pascallanger/DIY-Multiprotocol-TX-Module/BootLoaders/README.md

## Page Moved
Moved to [/docs/Arduino_IDE_Boards.md](/docs/Arduino_IDE_Boards.md).
