pascallanger/DIY-Multiprotocol-TX-Module/BootLoaders/StmMultiUSB/README.md

[Source for the StmMultiUSB=STM32duino-bootloader](https://github.com/rogerclarkmelbourne/STM32duino-bootloader)
If you want the latest version, you should look for the file generic_boot20_pa1.bin.
