pascallanger/DIY-Multiprotocol-TX-Module/docs/Module_BG_4-in-1.md

# 4-in-1 module
Currently the form factor of this module is designed for the JR-style module bay. Many of the popular RC transmitters use the JR-style module bay: FrSky Taranis, FlySky Th9x, Turnigy 9X/R/Pro
## What you need
A fully assembled module + case available from Banggood.com [here](http://www.banggood.com/CC2500-NRF24L01-A7105-CYRF693-4-In-1-RF-Module-With-Case-For-Futaba-JR-Frsky-Transmitter-p-1116892.html)

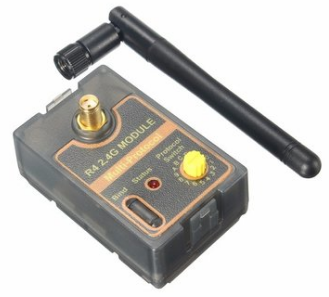
[picture p76: docs/images/4-in-1_Module_Case_BG.jpeg]
 

Or

The ready-made module available [here](http://www.banggood.com/2_4G-CC2500-A7105-Flysky-Frsky-Devo-DSM2-Multiprotocol-TX-Module-With-Antenna-p-1048377.html) or [here](http://www.gearbest.com/multi-rotor-parts/pp_554427.html)


 
Plus a module case that fits your module like the one [here](https://www.xtremepowersystems.net/proddetail.php?prod=XPS-J1CASE)  
   
  or you can 3D print your own from a selection on Thingiverse ([Example 1](http://www.thingiverse.com/thing:1852868) [Example 2](http://www.thingiverse.com/thing:1661833)).  
 [ ](http://www.thingiverse.com/thing:1852868)

For 9XR/9XR Pro, a new 3D printed module is available which makes use of the built in antenna in the handle. This means nothing is getting out of the radio back! You can find all details of this module case on [Thingiverse](http://www.thingiverse.com/thing:2050717).

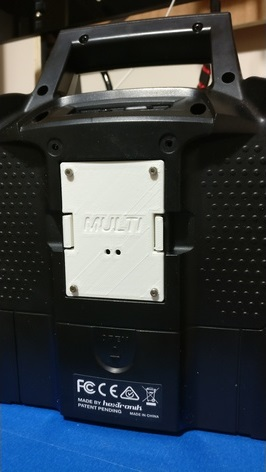
[picture p77: docs/images/9XR_module.jpg]
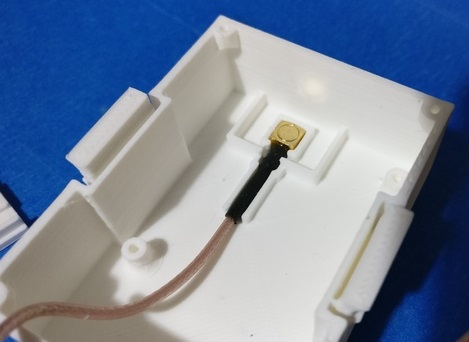
[picture p78: docs/images/9XR_module_connector.jpg]
  

## Different working modes

### PPM mode
If you are only planning on using the PPM interface with your transmitter, you need to connect it as described:



Some radios have an open collector output (Futaba, Graupner...), in this case you should add a 4.7K resistor between PPM and BATT.

The same plug is available on all versions of the module with the same signal locations.

If you wish to add an external device reading the telemetry, you need to enable serial mode as explained in the next topics otherwise you are now ready to go over to [Compiling and Programming](Compiling.md).

### Serial mode
If you have a transmitter that can support serial communication with the board then you need to wire up the board appropriately. There are three versions of the module and the steps are slightly different.

Check which module you have and based on the pictures below.  If you purchased the module after June 2016 then it is likely that you have a V1.1 type module. If you have purchased the version with case it is likely that you have a V1.2 type module.

#### **Version 1.2 (V1.2) type modules** 

Serial is already enabled and ready to be used.
 
Written on PCB back JRFM_V1.2

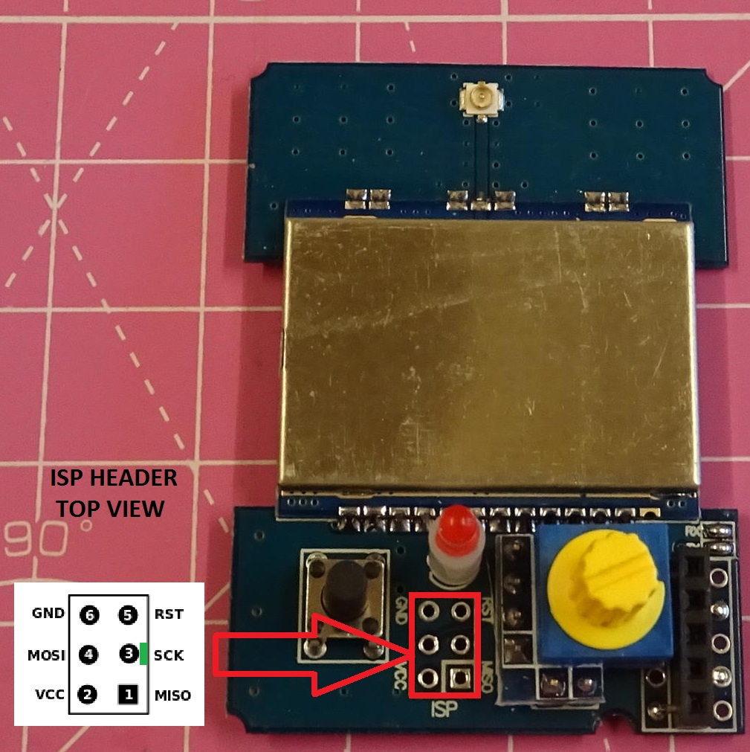
[picture p79: docs/images/v1.2_ISP.jpg]
 

You are now ready to go over to [Compiling and Programming](Compiling.md).

#### **Version 1.1 (V1.1) type modules** 

Solder two bridges over the pads shown in the pictures below. 
 
V1.1a

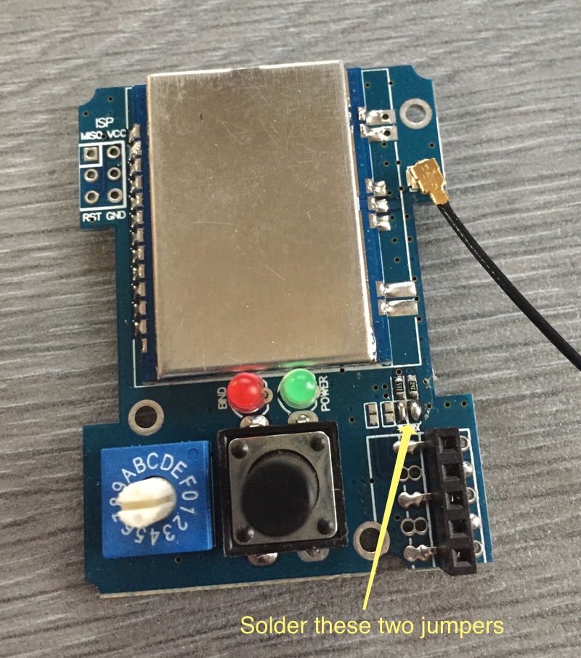
[picture p80: docs/images/V2a_Serial_Enable.jpeg]
 
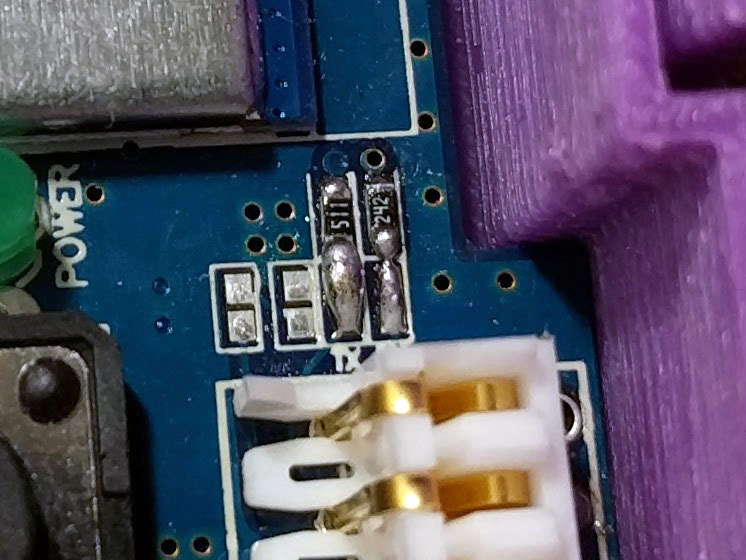
[picture p81: docs/images/V2a_zoom_Serial_Enable.jpeg]
 

V1.1b

Written on PCB back 1.2

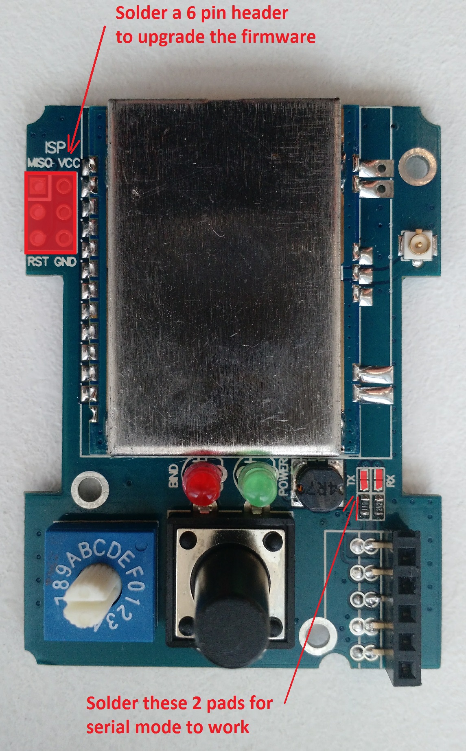
[picture p82: docs/images/V2b_Serial_Enable.jpeg]
 

V1.1c

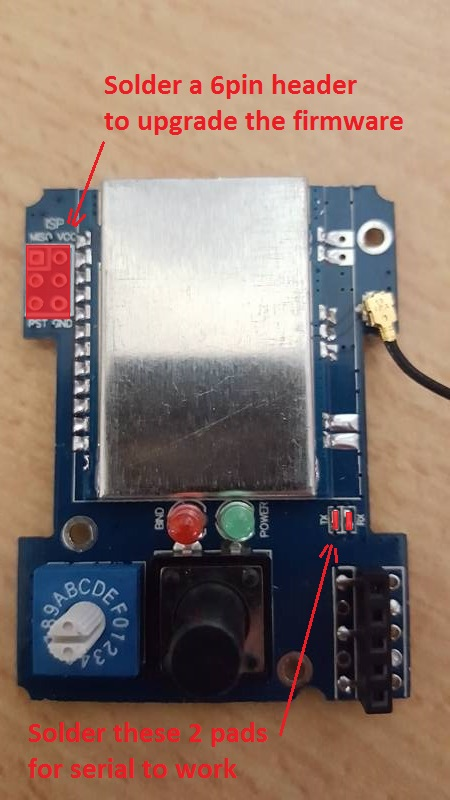
[picture p83: docs/images/V2c_Serial_Enable.jpeg]
 

You are now ready to go over to [Compiling and Programming](Compiling.md).

#### **Version 1.0 (V1.0) module**

Solder bridges and resistors as illustrated in the picture below.

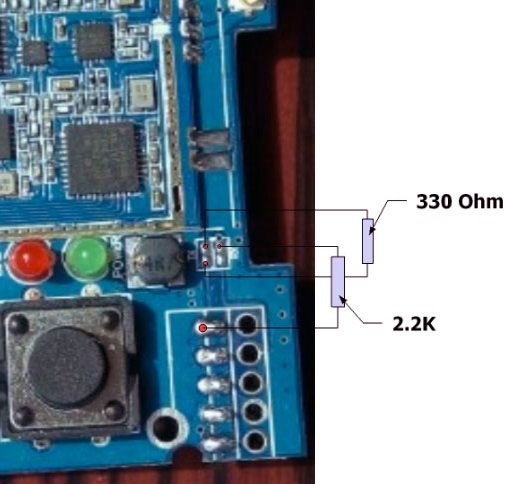
[picture p84: docs/images/V1_Serial_Enable.jpeg]
 

If your module is always/sometime binding at power up without pressing the button replace the BIND led resistor (on the board back) of 1.2K by a 4.7K. Just to be safe it is recommended to do the modification anyway.

It's known that the A7105 of this version is not able to receive telemetry. The only protocol affected so far is AFHDS2A.

You are now ready to go over to [Compiling and Programming](Compiling.md).
