pascallanger/DIY-Multiprotocol-TX-Module/Lua_scripts/README.md

# Multiprotocol TX Module OpenTX LUA scripts


If you like this project and want to support further development please consider making a [donation](../docs/Donations.md).  

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

## MultiConfig

Enables to modify on a Multi module the Global ID, Cyrf ID or format the EEPROM.

Matching the ID of 2 Multi modules enable them to control the same receivers without rebinding. Be carefull the 2 modules should not be used at the same time unless you know what you are doing.

Notes:
- Supported from Multi v1.3.2.85 or above and OpenTX 2.3.12 or above
- The Multi module to be configured must be active, if there is a second Multi module in the radio it must be off
- Located on the radio SD card under \SCRIPTS\TOOLS

MultiCconfig (https://www.youtube.com/watch?v=lGyCV2kpqHU)

## MultiChannelsUpdater

Automatically name the channels based on the loaded Multi protocol and sub protocol including the module channel order convention.

Need OpenTX 2.3.9 or above. Located on the radio SD card under \SCRIPTS\TOOLS. This script needs MultiChan.txt to be present in the same folder.

MultiChannelsUpdater (https://www.youtube.com/watch?v=L58ayXuewyA)

## MultiLOLI

Script to set the channels function (switch, servo, pwm, ppm, sbus) on a [LOLI RX](https://github.com/pascallanger/DIY-Multiprotocol-TX-Module/blob/master/Protocols_Details.md#loli---82)

MultiLOLIconfig (https://www.youtube.com/watch?v=e698pQxfv-A)

## Graupner HoTT

Enable text configuration of the HoTT RX and sensors: Vario, GPS, ESC, GAM and EAM.

Need OpenTX 2.3.9 or above. Located on the radio SD card under \SCRIPTS\TOOLS.

Notes:
- Menu/MDL/Model is used to cycle through the detected sensors.
- It's normal to lose the telemetry feed while using the text mode configuration. Telemetry will resume properly if the script is exited by doing a short press on the exit button.

Text mode video (https://www.youtube.com/watch?v=81wd8NlF3Qw)

## Graupner HoTT Model Locator

This is the Graupner HoTT adapted version of the Model Locator script using RSSI.

The OpenTX sensor "RSSI" is populated by the individual OpenTX telemetry protocol implementations and returns a value from 0..100 (percent) originating from the early FrSky implementation. It turns out that FrSky did not really provide a genuine signal strength indicator in units of dbm but a link quality indicator in 0..100%. With Graupner HoTT the link quality indicator is not a good basis for the model locator as it is very non-linear and doesn't change much with distance. Using the Graupner HoTT telemetry sensor "Rssi" which is a true signal strength indicator serves the purpose of locating a model much better as it varies much more with distance.

## DSM Tools for EdgeTX and OpenTx

Collection of EdgeTx/OpenTX Tools to use with Spektrum Receivers including forward programming. Extract the color or black&white zip version at the root of your SD card.

Frank is maintaining these awesome tools, check out his [repository](https://github.com/frankiearzu/DSMTools). Feel free to ask questions or open issues there.

## DSM PID Flight log gain parameters for Blade micros

Lua telemetry script from [feathering on RCGroups](https://www.rcgroups.com/forums/showpost.php?p=46033341&postcount=20728) to facilitate setting the Gain Parameters on the Blade 150S FBL. It doesn't use Forward Programming but instead it just reads telemetry data from the Multi-module and displays it on a telemetry display.

It is very similar to the Telemetry Based Text Generator functionality on Spektrum transmitters where one doesn't need to rely on the angle of the swashplate to determine selection/value.
