pascallanger/DIY-Multiprotocol-TX-Module/docs/Donations.md

# Donations


The Multiprotocol firmware is provided for free under the [GNU General Public License v3.0](https://github.com/pascallanger/DIY-Multiprotocol-TX-Module/blob/master/LICENSE).  The developers do not receive any payment from any of the manufacturers of Mulitprotocol Modules which use this firmware.

If you like this project and enjoy using it, please consider making a donation.  Donations are used to fund test hardware to develop and integrate more models.

Donations to the Multiprotocol project can be made via PayPal.  Just click on a value, or click 'Other' to set your own amount.

Every donation helps and is greatly appreciated, no matter the amount!

<div align=center>
<table cellspacing=0>
  <tr>
    <td align=center width=200><a href="https://www.paypal.com/cgi-bin/webscr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">Donate €5 PayPal - Donate €5</a><br><b>€5</b></td>
    <td align=center width=200><a href="https://www.paypal.com/cgi-bin/webscr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">Donate €10 PayPal - Donate €10</a><br><b>€10</b></td>
    <td align=center width=200><a href="https://www.paypal.com/cgi-bin/webscr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">Donate €10 PayPal - Donate €15</a><br><b>€15</b></td>
    <td align=center width=200><a href="https://www.paypal.com/cgi-bin/webscr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">Donate €25 PayPal - Donate €25</a><br><b>€25</b></td>
    <td align=center width=200><a href="https://www.paypal.com/cgi-bin/webscr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">Donate PayPal - Donate</a><br><b>Other</b></td>
  </tr>
</table>
</div>

### Donate in other currencies
<details>
  <summary><b>US Dollars</b></summary>
<div align=center>
<br>
<table cellspacing=0 cellpadding=0>
  <tr>
    <td align=center width=200><a href="https://www.paypal.com/cgi-bin/webscr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">Donate $5 PayPal - Donate $5</a><br><b>$5</b></td>
    <td align=center width=200><a href="https://www.paypal.com/cgi-bin/webscr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">Donate $10 PayPal - Donate $10</a><br><b>$10</b></td>
    <td align=center width=200><a href="https://www.paypal.com/cgi-bin/webscr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">Donate $15 PayPal - Donate $15</a><br><b>$15</b></td>
    <td align=center width=200><a href="https://www.paypal.com/cgi-bin/webscr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">Donate $25 PayPal - Donate $25</a><br><b>$25</b></td>
    <td align=center width=200><a href="https://www.paypal.com/cgi-bin/webscr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">Donate PayPal - Donate</a><br><b>Other</b></td>
  </tr>
</table>
</div>
</details>
<details>
  <summary><b>GB Pounds</b></summary>
<div align=center>
  <br>
<table cellspacing=0>
  <tr>
    <td align=center width=200><a href="https://www.paypal.com/cgi-bin/webscr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">Donate £5 PayPal - Donate £5</a><br><b>£5</b></td>
    <td align=center width=200><a href="https://www.paypal.com/cgi-bin/webscr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">Donate £10 PayPal - Donate £10</a><br><b>£10</b></td>
    <td align=center width=200><a href="https://www.paypal.com/cgi-bin/webscr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">Donate £10 PayPal - Donate £15</a><br><b>£15</b></td>
    <td align=center width=200><a href="https://www.paypal.com/cgi-bin/webscr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">Donate £25 PayPal - Donate £25</a><br><b>£25</b></td>
    <td align=center width=200><a href="https://www.paypal.com/cgi-bin/webscr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">Donate PayPal - Donate</a><br><b>Other</b></td>
  </tr>
</table>
</div>
</details>
<br>
Thank you for your support!
