pascallanger/DIY-Multiprotocol-TX-Module/docs/DIY Multiprotocol Module Overview.png

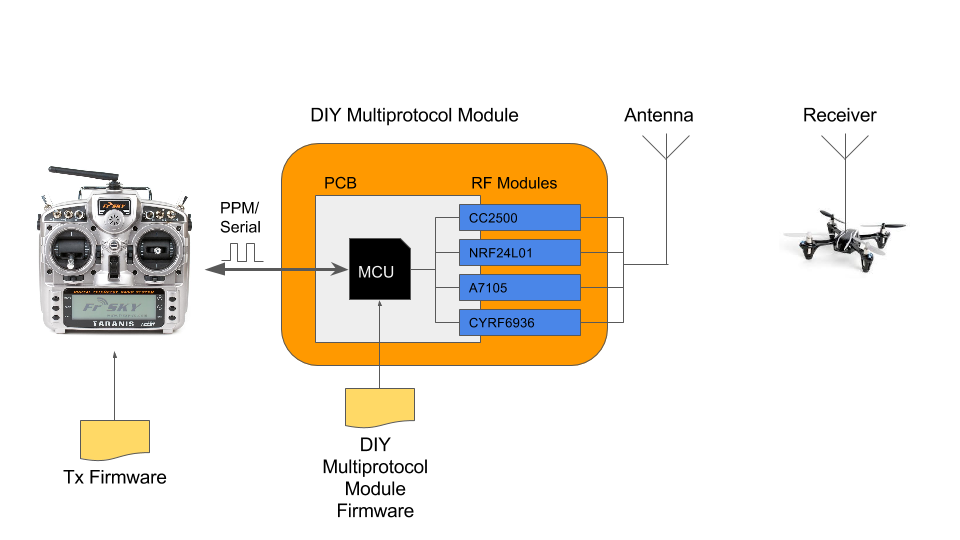
docs/DIY Multiprotocol Module Overview.png
