pascallanger/DIY-Multiprotocol-TX-Module/docs/images/4-in-1_Module_BG.png

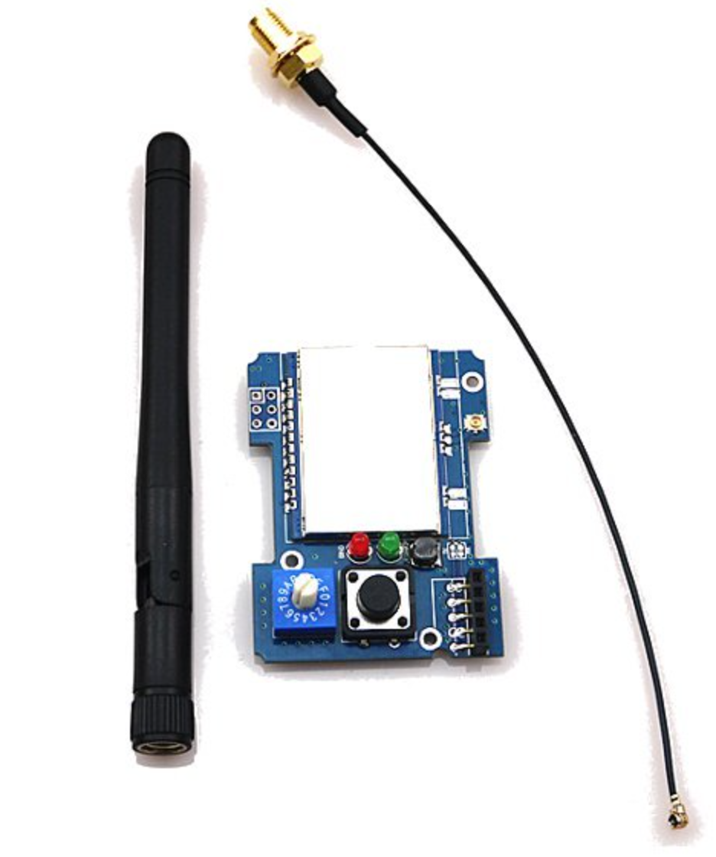
docs/images/4-in-1_Module_BG.png
