pascallanger/DIY-Multiprotocol-TX-Module/docs/images/4-in-1_Module_PPM_Controls.jpg

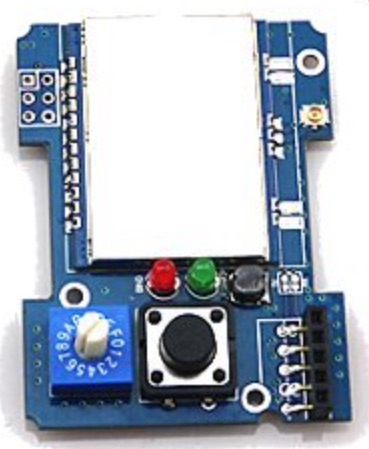
docs/images/4-in-1_Module_PPM_Controls.jpg
