pascallanger/DIY-Multiprotocol-TX-Module/docs/images/FTDI_Adapter.jpeg

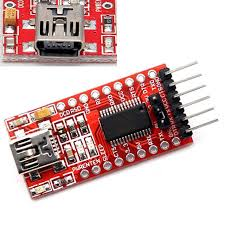
docs/images/FTDI_Adapter.jpeg
