pascallanger/DIY-Multiprotocol-TX-Module/docs/images/FTDI_Cable.jpeg

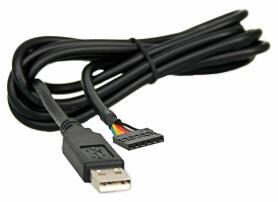
docs/images/FTDI_Cable.jpeg
