pascallanger/DIY-Multiprotocol-TX-Module/docs/images/ISP_header.png

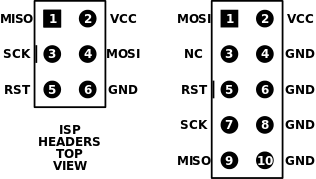
docs/images/ISP_header.png
