pascallanger/DIY-Multiprotocol-TX-Module/docs/images/maple-dfu.jpg

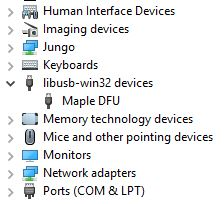
docs/images/maple-dfu.jpg
