pascallanger/DIY-Multiprotocol-TX-Module/docs/images/maple-serial-port-select.jpg

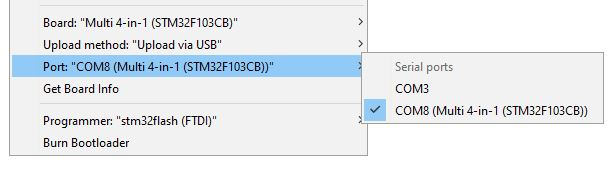
docs/images/maple-serial-port-select.jpg
