pascallanger/DIY-Multiprotocol-TX-Module/docs/images/maple-serial.jpg

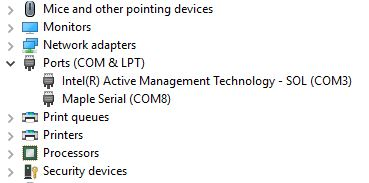
docs/images/maple-serial.jpg
