pascallanger/DIY-Multiprotocol-TX-Module/docs/images/Module_perfboard1.jpeg

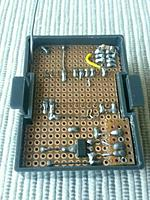
docs/images/Module_perfboard1.jpeg
