pascallanger/DIY-Multiprotocol-TX-Module/docs/images/Multi_STM32 module.JPG

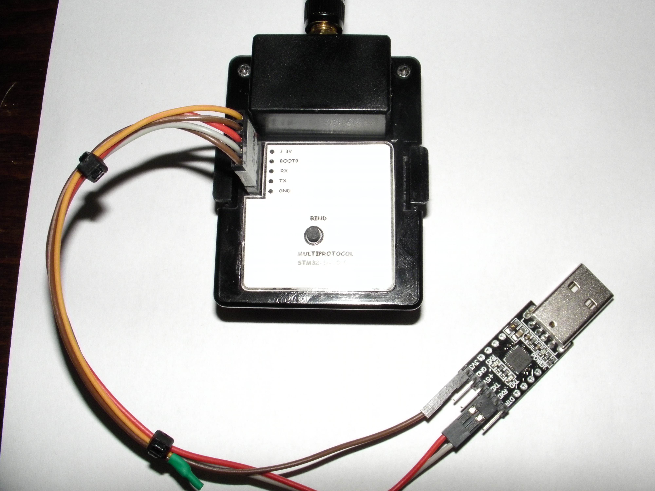
docs/images/Multi_STM32 module.JPG
