pascallanger/DIY-Multiprotocol-TX-Module/docs/images/Multi_STM32_ flashing.jpg

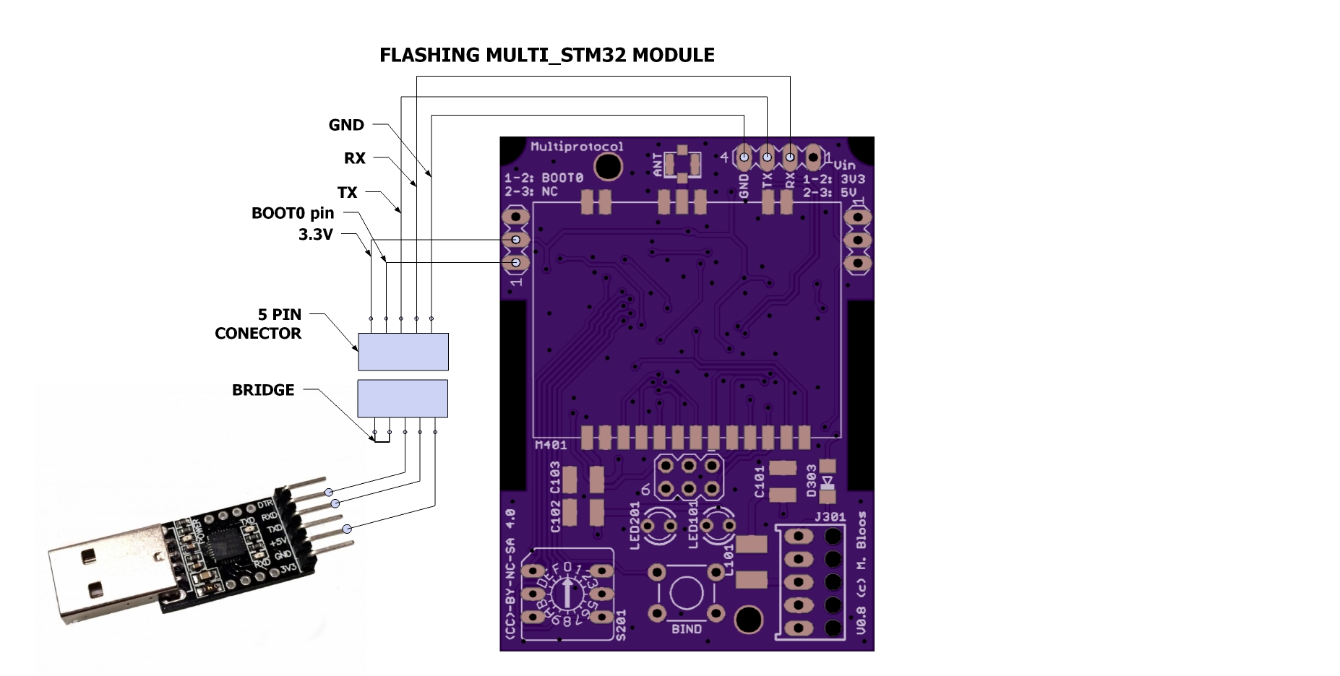
docs/images/Multi_STM32_ flashing.jpg
