pascallanger/DIY-Multiprotocol-TX-Module/docs/images/Multiprotocol_3.2.jpeg

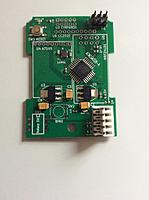
docs/images/Multiprotocol_3.2.jpeg
