pascallanger/DIY-Multiprotocol-TX-Module/docs/images/OrangeRx_Module.jpg

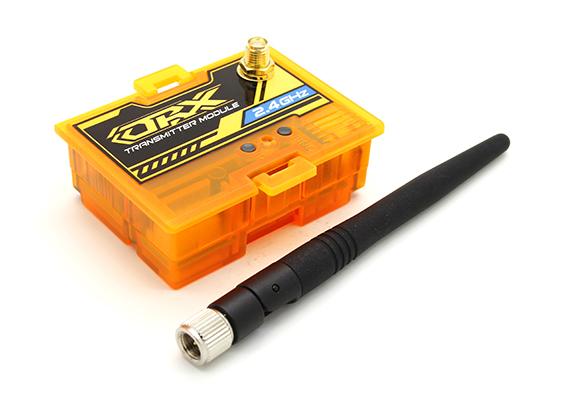
docs/images/OrangeRx_Module.jpg
