pascallanger/DIY-Multiprotocol-TX-Module/docs/images/STM32_Board_V1.0_Jumper.png

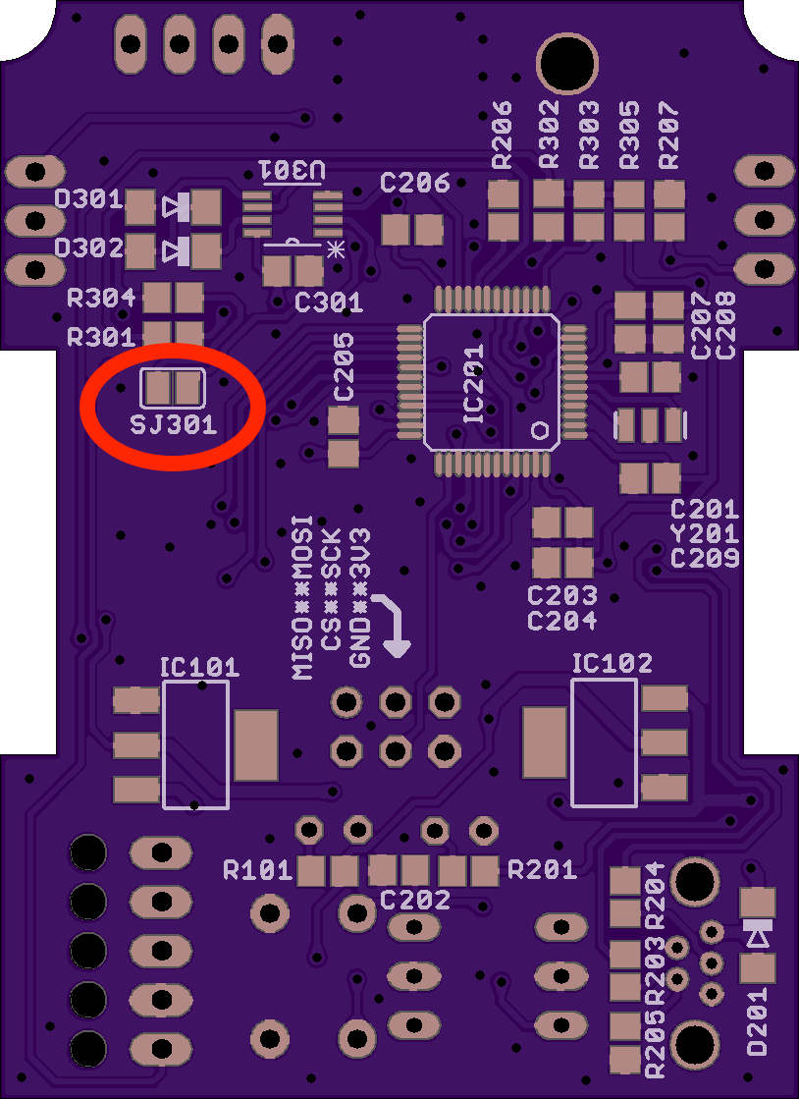
docs/images/STM32_Board_V1.0_Jumper.png
