pascallanger/DIY-Multiprotocol-TX-Module/docs/images/v1.2.jpg

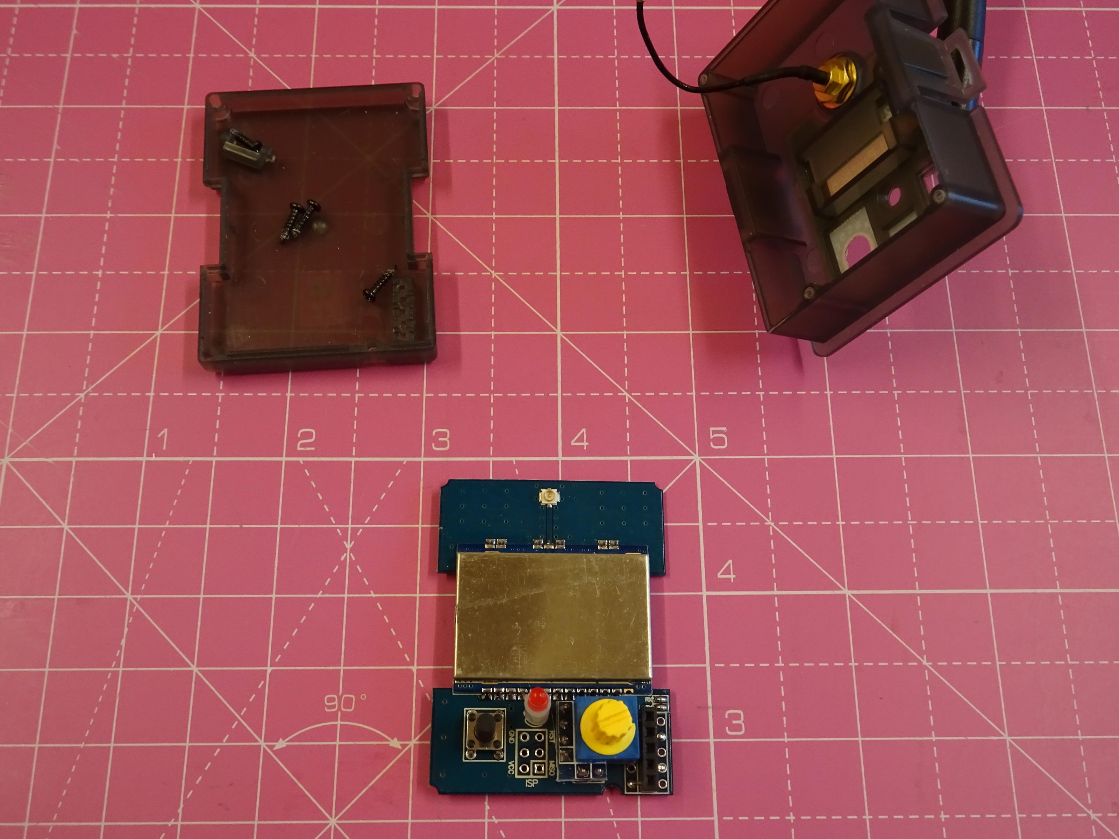
docs/images/v1.2.jpg
