pascallanger/DIY-Multiprotocol-TX-Module/docs/images/warning.png

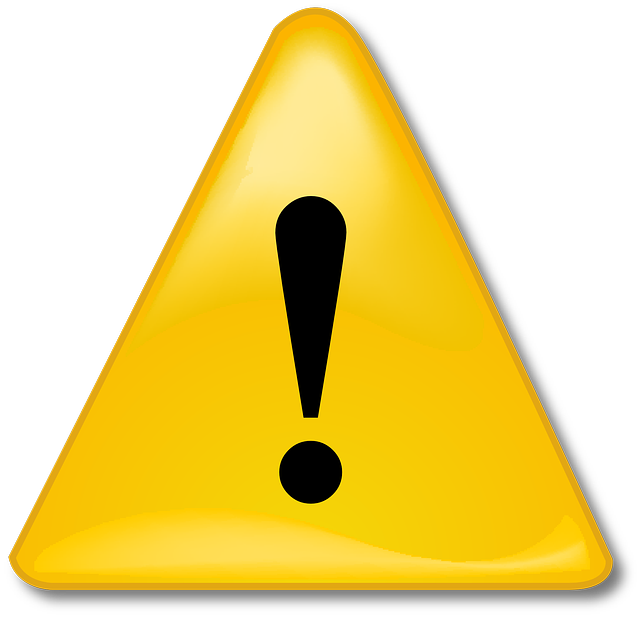
docs/images/warning.png
