pascallanger/DIY-Multiprotocol-TX-Module/docs/images/WordPad_Admin.jpg

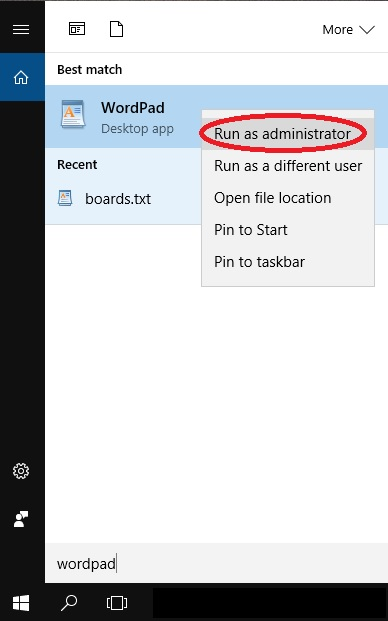
docs/images/WordPad_Admin.jpg
