pascallanger/DIY-Multiprotocol-TX-Module/PCB v2.3d/PCB_v2.3d.jpg

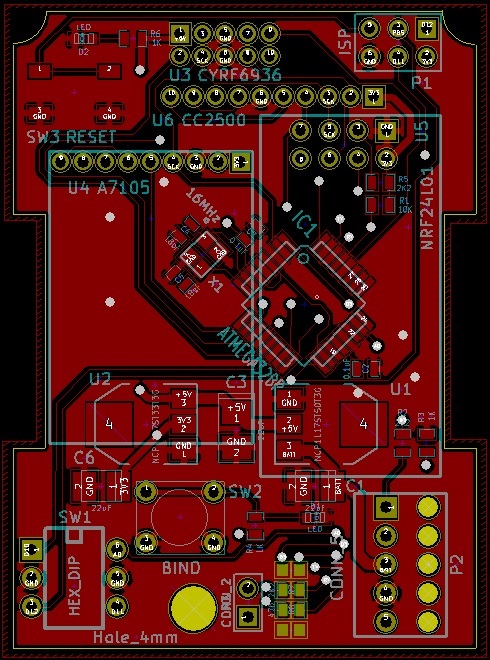
PCB v2.3d/PCB_v2.3d.jpg
