pascallanger/DIY-Multiprotocol-TX-Module/STM32 PCB/Flysky PL18/Casing/MPM-TF.stl

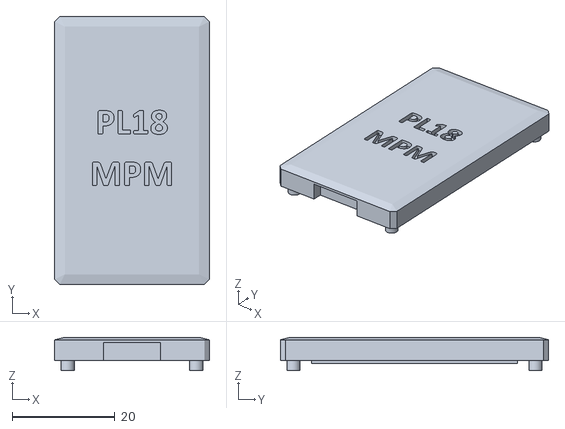
[picture p113: CAD file, 2022-11-17]
STM32 PCB/Flysky PL18/Casing/MPM-TF.stl
30.1 x 52.1 x 6.50
