pascallanger/DIY-Multiprotocol-TX-Module/STM32 PCB/Flysky PL18/Casing/MPM-BF.stl

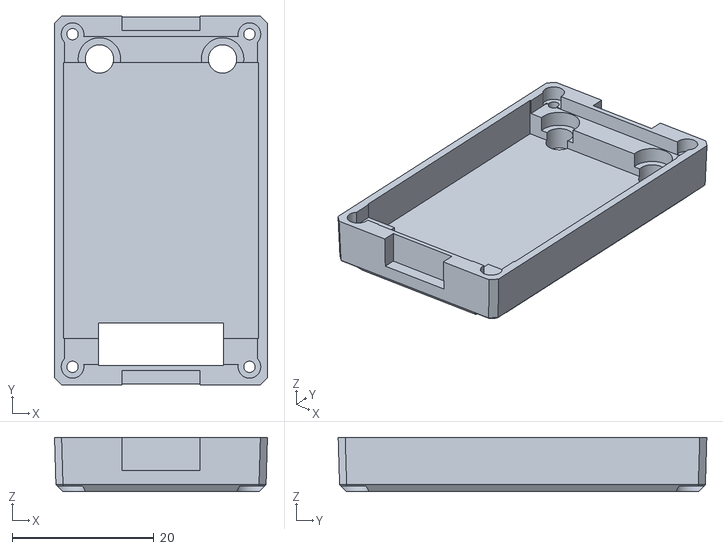
[picture p114: CAD file, 2022-11-17]
STM32 PCB/Flysky PL18/Casing/MPM-BF.stl
30.1 x 52.1 x 7.70
