pascallanger/DIY-Multiprotocol-TX-Module/(list of files, cad)

Other CAD files:
STM32 PCB/Flysky PL18/Casing/MPM.blend
