pascallanger/DIY-Multiprotocol-TX-Module/(threads)

Thread 13 (2016-08-17):

Unable to bind to Inductrix (DSM2/X) on recent versions (ppm or serial)

Gaurhoth, 2016-08-17:
Multiprotocol Version: 1.1.2 (also tried 1.1.1)
TX: Taranis + Multiprotocol Board from Banggood (frsky version). It's the newer version with resistors on board.
Tried both PPM and Serial
Taranis OpenTX Version: 2.1.8 from http://plaisthos.de/opentx/ (07/23 and 08/16 versions)

When I originally received the board, I was able to successfully bind using PPM with the original Banggood firmware. Wanting to use Serial, I soldered the rx/tx pads as directed (resistors are already on the board) and upgraded to 1.1.2. Unsuccessful in binding despite trying NUMEROUS combinations of channel ranges/PPM timing. Inductrix never bound to the transmitter. Green and RED LED solid after bootup. Attempted binding with button and in the UI. No success.

Downgraded back to the orignal banggood firmware (fortunately took a backup) and unit now binds in PPM mode again.

Willing to work with someone to help troubleshoot.

pascallanger, 2016-08-17:
Hi Gaurhoth,
Couple of things:
 - Don't loose your time trying every possible options. The only thing that should matter in serial mode is the number of channels/frame rate.
 - In serial when you press the bind button on the GUI, you should see the module blinking for a few seconds and then return to solid, do you confirm?
 - Binding order should be:
    1. power tx and select the correct model with MULTI/DSM2 and the number of channels (6@11ms is usually a good spot)
    2. power inductrix in bind mode
    3. Press bind from the gui
    4. if it does not work, what's the LED status on the quad? any blinking change?
 - Can you build, test (changing number of channels/frame) with the latest github sources and report result (including LED pattern(s))?
 - Can you build, test (changing number of channels/frame) with the latest github sources with TELEMETRY disabled (commented) in _Config.h and report result (including LED pattern(s))?
Thanks, Pascal

Gaurhoth, 2016-08-22:
I resoldered the tx/rx pads and its working now. Apparently I had a bad solder connection.

Closed 2016-08-22.

Thread 28 (2016-12-05):

Module_BG_4-in-1.md , my module is different?

buzztiaan, 2016-12-05:
http://i.imgur.com/y83AfJm.jpg from a review in banggood suggests the 'V1.2' model thats currently sold by banggood will only need shorting ..

i'm gonna try this, but thought you might like this image to be included in documentation

will report back if it works ;)

buzztiaan, 2016-12-05:
yep, this works :) you might want to add it to the documentation

Dutchy-79, 2016-12-05:
Did you read the guide? It's already in there. Also on rcgroups.com it's in the YouTube video.

buzztiaan, 2016-12-05:
the specific hardware isn't represented by a picture in Module_BG_4-in-1.md ;)

this was why i opened the issue :)

Dutchy-79, 2016-12-05:
https://github.com/pascallanger/DIY-Multiprotocol-TX-Module/blob/master/docs/Hardware.md

First option, it's the exact same thing :)

buzztiaan, 2016-12-05:
its, not, look closely ;) details matter

buzztiaan, 2016-12-05:
most specifically , the -exact- place where you need to add solderbridges (or in some versions, resistors) is quite different

JurikRistjouw, 2016-12-05:
I have also the version 1.2 and just shorted the bridges which looked similar. I did need an USBASP flash programmer as an "Arduino as ISP" did not work. I did not flash a bootloader but just compiled the firmware with the modules i wanted (not commented the hardware protocols as that is also ambigious in the howto's. After that an OpenTX version on the Taranis which supported the serial protocol. Only thing is, the settings of the module are not remembered when saving settings on CompanionX. Otherwise it works like a charm.

buzztiaan, 2016-12-05:
my steps to get the 1.2 working was ;

1) add a 6pin header on the ISP part
2) set protocol rotation knob to 0 (zero)
3) set fuses with : sudo avrdude -B 20 -c usbtiny -e -u -p m328p -v -U lock:w:0x3f:m -U efuse:w:0x05:m -U hfuse:w:0xD3:m -U lfuse:w:0xFF:m
4) flash firmware with : sudo avrdude -b 19200 -c usbtiny -p m328p -v -Uflash:w:Multiprotocol_V1.1.5_CC2500-NRF24L01.hex:i
5) bridge the TX and RX solderpads with a blob of solder
6) done :D

Dutchy-79, 2016-12-05:
https://www.rcgroups.com/forums/showthread.php?2709034-Banggood-Multiprotocol-module-(Flysky-Frsky-Devo-DSM2)

Check the video on post 3

And I have the same 1.2 board and also didn't doubt if I soldered the right pads.

buzztiaan, 2016-12-05:
are you suggesting the video should be embedded with the documentation? my issue was about the documentation -here-

also, that video is -not- the 1.2 version, note the different text on silkscreen

JurikRistjouw, 2016-12-05:
Can somebody tell me why I should burn the fuses? I did not do that and it worked... I did burn the bootloader (same thing?)

buzztiaan, 2016-12-05:
the fuses determine the options and working speed and -if- a bootloader is used to the atmega chip

its quite possible they were already right for how you use it now

(also the name fuses is weird , they are not fuses, just flashable memory)

JurikRistjouw, 2016-12-05:
Thanx! So in order to install a bootloader (for instance, to update through serial) you need to flash the proper "fuse" in order to make that possible? otherwise, you're stuck with the options on the "fuse" that was shipped?

buzztiaan, 2016-12-05:
yeah and possibly your module already had fuses set to use a bootloader, you wont get stuck (UNLESS you set fuses to disable the ISP (called SPI for fuses) flashing, which would be bad)

pascallanger, 2016-12-05:
Can I have a better picture with no arrows, good light and outdise of the box?
Pascal

buzztiaan, 2016-12-05:
sadly i dont have my camera here :( i'll make you one asap

buzztiaan, 2016-12-05:
some are here;

http://img.banggood.com/customers_images/large/2016112704320712-1048377.jpg
http://img.banggood.com/customers_images/large/2016112306162814-1048377.jpg
http://img.banggood.com/customers_images/large/2016111204035898-1048377.jpg
http://img.banggood.com/customers_images/large/2016102107035467-1048377.jpg
http://img.banggood.com/customers_images/large/2016102107035984-1048377.jpg
http://img.banggood.com/customers_images/large/2016102703094227-1048377.jpg
http://img.banggood.com/customers_images/large/2016102703093771-1048377.jpg

pascallanger, 2016-12-05:
Ok thanks. I'm closing this subjet and add the image.
Please use the forum to talk/exchange/chat...
Pascal

buzztiaan, 2016-12-05:
thanks <3

buzztiaan, 2016-12-05:
i didnt use the forum because 438 pages of information is not in any way usable as reference ;)

JurikRistjouw, 2016-12-05:
thanx

gerrievanzyl, 2016-12-05:
Hi all. I am traveling and my data access is sketchy. I will add the image
in the next few days.
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

buzztiaan, 2016-12-05:
its already added ;)

Closed 2016-12-05.

Thread 31 (2016-12-10):

Serial Packet Timeout

soligen2010, 2016-12-10:
I have been struggling with the serial link to the module.  I finally tracked down the issue - even with the correct baud rate, it is  taking longer than the 3250 uS timer for the packet to arrive.  I am pretty sure it is because I am using software serial in my TX (I need the one UART to talk to the computer).

My request is to increase this to 3750.  The snippet below shows the changes. Change the 6500 to 7500

					#if defined STM32_BOARD
						uint16_t OCR1B;
						//OCR1B =TCNT1+(6500L);
						OCR1B =TCNT1+(7500L);
						timer.setCompare(TIMER_CH2,OCR1B);
						timer.attachCompare2Interrupt(ISR_COMPB);
					#else
            //OCR1B = TCNT1+(6500L) ; // Full message should be received within timer of 3250us
            OCR1B = TCNT1+(7500L) ; // Full message should be received within timer of 3750us
						TIFR1 = OCF1B_bm ;		// clear OCR1B match flag
						SET_TIMSK1_OCIE1B ;		// enable interrupt on compare B match
					#endif

Another question I have is the power settings for NRF24L02.  The high power setting doesn't select the highest setting.   I would prefer the highest setting for best range.  Is there a reason to not do this? If not, then I request the high level be changed to:

     #define NRF_HIGH_POWER		NRF_POWER_3

I also I have a question about the bind and autobind flags in the serial protocol.  These are 2 seperate bits, but appear to not be differentiated anyplace in the code as they both turn on autobind.  I was going to use these for different bind behaviors.  Any plans to separate these flags apart?

Thanks

Dennis

pascallanger, 2016-12-10:
1. Serial timing
Short answer: no
Long answer: the current TX (Taranis, 9XR Pro, 9XR...) are using software serial to send the data over the ppm pin in a little less than 3000µs. So 3250µs is already providing a good margin... They are transmitting a packet every 7000µs. To prevent the tail to catch the head I therefore need a timing which is less than half of it. So the maximum value is 3499. I could increase to 3400 but I won't go further...
2. NRF24L01 power setting
Short answer: no
Long answer: have you done some field tests like we did? What I can tell you from my experience is that none of the cheap NRF modules sold out there are working properly at a rf power of 3. They send garbage more than anything else at this power level. From the field tests, it appears that there is no range gain between 2 and 3 but going further there is far more packet loss with power 3 than power 2. This is obvious on some models that just do not run at rf power 3 due to the heavy packet loss.
3. Bind flags
They have different behaviors even if you haven't seen them.
If autobind is set in the serial stream, the module will always start the protocol in bind mode. If autobind is not present but there is a bind request then the protocol will be restarted in bind mode for this time only.
Pascal

soligen2010, 2016-12-10:
Thanks for including the long answers :)

1) I will go through my code and see if something is slowing it down.  Could be my timer interrupt, but the interval is long enough I would have thought I would get a few fast packets through.  8N1 works, it is adding the parity bit that pushes it over the limit.  Also as an not a big deal but FYI, the code comment says 8E2, but the flags configuring the serial look like 8E1 to me.

		//Set frame format to 8 data bits, even parity, 2 stop bits
		UCSR0C = _BV(UPM01)|_BV(USBS0)|_BV(UCSZ01)|_BV(UCSZ00);

Found this bit if doco:
         bit 3	USBS0	USART Stop Bit Select. Set to select 1 stop bit. Unset to select 2 stop bits.

Just FYI.  I am not asking for a change - configuring to 2 stop bits would likely make my timing issue harder to overcome.

2) No I haven't tested this but I will.  I started with max setting and have been very pleased with the performance to date - I have yet to have a brownout flying. Thanks for the info.

3) Ahh - I see it now.  The bind bit re-starts the protocol.  If bind bit stays set the protocol will re-start continuously, restarting the autobind sequence, hence it will stay in bind mode until the bit is turned off and the autobind countdown ends.

soligen2010, 2016-12-10:
I might be wrong on the stop bit thing.  I have found examples both ways :( and the term set/unset is ambiguous.  I would assume set = 1 and unset  = 0, but maybe not.

My understanding is that sending 2 stop bits to a listener for 1 stop bit doesn't really make a difference other than speed.

soligen2010, 2016-12-10:
I optimized the Serial code path and made sure my interrupts don't fire during the send, and I have the serial communication timing looking good.  3040 uS for 8E1 but 3300 for 8E2.  8E2 still works, but I cant tell if it is dropping some packets.  8E2 timing is marginal at best.  but since 8E1 seems to work, i'll stick with that.

pascallanger, 2016-12-10:
Question 1:
UCSR0C = _BV(UPM01)|_BV(USBS0)|_BV(UCSZ01)|_BV(UCSZ00);
This is correct, I don't know where you are looking but the atmega328 datasheet does not leave any place for confusion:
Bit 3 – USBSn: Stop Bit Select . This bit selects the number of stop bits to be inserted by the Transmitter. 0->1 Stop, 1->2 Stop
Question 2:
Multi does care to see 2 stop bits during the transmission as well as the parity being even. If this is found to be wrong anywhere the full frame is discarded.
Question 3:
A stop bit is in fact a pause in the transmission. So if you have a pause between the bytes being sent (computation of the next one for example) this will "emulate" a stop bit.
Like I've said a TX like 9XR Pro is sending a full packet with a true 8e2 format @100K in a little less than 3ms with no packet loss.
Pascal

soligen2010, 2016-12-10:
Thanks Pascal

I just don't have as much processor as the 9XR pro.  They have an ARM and I have a ATMEGA328.  I cant see how I can make it any faster, but my code that captures the timing may add a little, so I'll test some more by playing  with the multi timing and seeing how close it really is.

I have not noticed any issues with 8E1, but I would rather be in spec.  For 8E2 3400 uS is what I would need based on the timing captured from the TX.  The reason I think it actually works may be because there is a little time passes to execute code to start the timer, and capturing the time may increase it slightly.

I know I can always change the code just for myself to get a bit more headroom, it just that when I am done I would rather not have my own one-off changes because it makes getting new versions running more difficult.

pascallanger, 2016-12-11:
Hummm, Multi is also using an atmega 328 and the software serial is working perfectly fine in 8E2 @100K for the telemetry back to the TX. May be you should take it...
Pascal

soligen2010, 2016-12-12:
The issue isn't with the individual bytes, it is the total packet time.  More time between bytes doesn't hurt anything other than total time.  I think if the packet is shorter, or the TX has a more generous timeout, then there would be no issue.  What I did to get the time down was pre-calculate the parity bits for the entire packet before starting to send.  The fact that 8E1 works I figure means that my stop bit timing is likely still a little long as it cycles to the next byte, even though I made this as fast as a could with reasonably structured code.  There is still a function call for each byte - oddly making the function inline slowed things down.  I would have expected it to be faster.  Perhaps due to register optimization.

I would be interesting for you to try 8E1 back to the TX, but perhaps not worth your time to play with it - just a curiosity.

pascallanger, 2016-12-13:
Closing this none issue ;-)

Closed 2016-12-13.

Thread 61 (2017-03-25):

Sanwa SD-10G and FRSky xsr 2016 binding issue

stefanofalconetti, 2017-03-25:
Hi Multiprotocol Team,

I'have been trying to bind my Sanwa SD-10G with an FRSKY XSR 2016 receiver with NON EU firmware for several days now, with luck. I have a multiprotocol board from Bangood ([http://www.banggood.com/2_4G-CC2500-A7105-Flysky-Frsky-Devo-DSM2-Multiprotocol-TX-Module-With-Antenna-p-1048377.html]) that I have updated with the latest firmware via the Arduino IDE, few days ago. This RX supports the D16 protocol and the multiprotocol board is connected to my tx via PPM trainer port (slave mode, so internal RF module is turned off). This tx port is declared to be PPM8 capable. I'm getting that it has 8 channels on that PPM signal. I have set the dial to #2 on the board, as 2 is FRSKYX protocol and tried all possible bind procedure. I'm attaching my _Config.h file. Changes I made are commented with "//Sanwa SD-10G"
I have also changed channels order to EATR (#define EATR). I have also reduced max channels to 8 max (My TX has 10). What I see when I try to bind is this:

1. I power the Tx on
2. I power on the multiprotocol module while pressing the bind button (I added a switch to power it off). Green led is solid on
3. I keep the rx bind button pressed while powering the rx
4. I release the bind button on the multiprotocol board
5. Multiprotocol board red led blinks fast
7. After some seconds red led on multiprotocol board turns solid red
8. Green led on rx goes green, red one turns off

As I spent some time sorting this out I wanted just to share with you.

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

Changes I made in _Config.h to make the bind part are below:

```
const PPM_Parameters PPM_prot[15]=	{
//	Dial	Protocol 		Sub protocol	RX_Num	Power		Auto Bind		Option
**/*	1	*/	{MODE_SFHSS,	0		,	0	,	P_HIGH	,	NO_AUTOBIND	,	0		},
/*	2	*/	{MODE_FRSKYX,	CH_8		,	0	,	P_HIGH	,	NO_AUTOBIND	,	-40		},**
/*	3	*/	{MODE_FRSKYD,	0			,	0	,	P_HIGH	,	NO_AUTOBIND	,	40		},	// option=fine freq tuning
/*	4	*/	{MODE_HISKY	,	Hisky		,	0	,	P_HIGH	,	NO_AUTOBIND	,	0		},
/*	5	*/	{MODE_V2X2	,	0			,	0	,	P_HIGH	,	NO_AUTOBIND	,	0		},
/*	6	*/	{MODE_DSM	,	DSM2_22		,	0	,	P_HIGH	,	NO_AUTOBIND	,	6		},	// option=number of channels
/*	7	*/	{MODE_DEVO	,	0			,	0	,	P_HIGH	,	NO_AUTOBIND	,	0		},
/*	8	*/	{MODE_YD717	,	YD717		,	0	,	P_HIGH	,	NO_AUTOBIND	,	0		},
/*	9	*/	{MODE_KN	,	WLTOYS		,	0	,	P_HIGH	,	NO_AUTOBIND	,	0		},
/*	10	*/	{MODE_SYMAX	,	SYMAX		,	0	,	P_HIGH	,	NO_AUTOBIND	,	0		},
/*	11	*/	{MODE_SLT	,	0			,	0	,	P_HIGH	,	NO_AUTOBIND	,	0		},
/*	12	*/	{MODE_CX10	,	CX10_BLUE	,	0	,	P_HIGH	,	NO_AUTOBIND	,	0		},
/*	13	*/	{MODE_CG023	,	CG023		,	0	,	P_HIGH	,	NO_AUTOBIND	,	0		},
/*	14	*/	{MODE_BAYANG,	BAYANG		,	0	,	P_HIGH	,	NO_AUTOBIND	,	0		},
/*	15	*/	{MODE_SYMAX	,	SYMAX5C		,	0	,	P_HIGH	,	NO_AUTOBIND	,	0		}
};
```

According to what is mentioned here (search for D16 non EU):

[Protocol details page](https://github.com/pascallanger/DIY-Multiprotocol-TX-Module/blob/master/Protocols_Details.md)

See first two lines (I'm actually looking for using Futaba and RFSky)

I'd like to know how to share this so that others will not spend the same time in getting here. Is an issue the right place to do this ?

Thanks,

Stefano Falconetti

[_Config.h.txt](https://github.com/pascallanger/DIY-Multiprotocol-TX-Module/files/870453/_Config.h.txt)

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

pascallanger, 2017-03-28:
Hi, It looks like it's working for you right? (so it's not an issue)
I think the best place if you want to keep this knowledge somwhere is to submit a pull request in the section "[How to for popular models](https://github.com/pascallanger/DIY-Multiprotocol-TX-Module/blob/master/docs/Models.md)".
Pascal

stefanofalconetti, 2017-03-29:
That's correct,

if you can explain to me how I cab properly document it, I can copy-paste
in a more suitable place.

Thanks,

Stefano Falconetti.

2017-03-28 9:30 GMT+02:00 pascallanger <notifications@github.com>:

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

Closed 2017-03-28.

Thread 87 (2017-05-30):

Not Binding to AFHDS2A

krocebow, 2017-05-30:
Multiprotocol code version : Can you please tell me where to find it?
TX type : Taranis Q X7
Using serial
Module is blinking when entering binding mode, RX stays in binding mode with a blinking led.

I have a FS-IA6B receiver that don't bind to my transmitter I did the following procedures and none of them  worked :

1. Turn on transmitter, Set RF mode Multi FS 2A, submode PPM/IBUS, AutoBind checked. I activate the bind mode, and then I turn on the RX.
2. I do all the above steps, but this time I turn off the TX, turn on the RX then I turn on the TX so maybe the autobind will work, but it doesn't.

I tried to enter the bind mode first and it didn't work, I also tried to turn on the RX first and it didn't work either.

I already binded two different receivers with my transmitter and they did work : Redcon CM703 7CH PPM using the DMX protocol and the FS-R9B 8CH using ther FlySky STD protocol.

Any help will be appreciated. Thanks!

schwabe, 2017-05-30:
Don't turn on autobind for that protocol

krocebow, 2017-05-30:
I unchecked autobind, I entered the bind mode on my TX and still same result both Leds are blinking and it didn't bind.

krocebow, 2017-06-01:
I managed to get it to work, but I have another issue, the RX & TX are binded, but the RF signal keeps giving the rf signal critical alarm, whether they are close or not the same result, when I go to the sensors page I see this :
TRSS: ~250
A1 : 5.01V
RQLY : 1
RSSI : -60 dB
RNse : -101 dB
RSNR : 41 dB

Is it something related to the RX or the multiprotocol module?

carlosveloso, 2017-08-31:
@krocebow did you manage to fix that signal issue? I have the same problem with the FS-IA6B

TheTomCutler, 2017-09-08:
Same issue with FS-X6B and lemon satellite

krocebow, 2017-09-09:
@carlosveloso No I still didn't manage to fix it sorry :)

juliogdiana, 2017-10-02:
@krocebow any update on low signal alarm?
I have same problem here.

KnuckleUpFPV, 2017-10-27:
Same issue

KnuckleUpFPV, 2017-10-28:
Fixed. Switch it from pwm/ibus to ppm/ibus. No more issues.

juliogdiana, 2017-10-29:
But I need pwm.
I do use it on planes with servos

KnuckleUpFPV, 2017-10-29:
Should still be able to talk to your receiver and it should still do pwm. I tried it on my 3d printed fixed wing and its still doing pwm just fine. And no annoying lost recovered alarm.

CNCSeb, 2018-03-05:
Hej,
I am sorry to open up that issue again, but the switch to ppm/ibus did not solve that problem for me. Is there something else I can try to get rid of the warnings?
Kind regards,
Sebastian

TheTomCutler, 2018-03-05:
I'll second this, I still have a wailing radio. I've worked round it by making one of my rotary switches the volume control but this isn't ideal. There's no loss in transmission range so I can only assume it's the telemetry signal coming back that's causing the issue.

pascallanger, 2018-03-05:
This is a known issue with OpenTX, nothing to do with Multi.
Here is the link to it: https://github.com/opentx/opentx/issues/5748

pascallanger, 2018-03-05:
As a workaround until this is resolved you can:
 - set the threshold for RSSI like someone is mentionning in the link above but don't ask me how
 - disable specifically the AFHDS2A telemetry

TheTomCutler, 2018-03-05:
I'll look into disabling the telemetry, I wasn't sure where to start. Many thanks for that.

KnuckleUpFPV, 2018-03-05:
This telemetry warning wasnt an issue until they released a version with failsafe. Once I updated the warnings started.

pascallanger, 2018-03-05:
Commenting this line in_config.h should be enough: #define AFHDS2A_FW_TELEMETRY
But you can always comment this one as well: #define AFHDS2A_HUB_TELEMETRY

TheTomCutler, 2018-03-05:
Top work pascallanger, thanks again!

pascallanger, 2018-03-05:
"until they released a version with failsafe. Once I updated the warnings started"
The failsafe coffee that I've released is completly unrelated to the warning you are seeing...

KnuckleUpFPV, 2018-03-05:
I dont think it was your version Im running Pascal. Someone had the code up on rcgroups. I just added it in. Unless you used that sane code. I'm using the firmware from github with the edited code from the rcgroup post. Telemetry was fine no warnings prior. But had no failsafe. Added the failsafe code and now telemetry warnings. Not all the time though. Depends on receiver I'm using. Pwm ibus in tx setting still has no warnings on two of my ia6b. Yet my others alarm like crazy and didn't before hand. Maybe I screwed up adding the code. Not sure. If i find some time I will try the newest version from github. I'm on the version that I cannot use multi telemetry

pascallanger, 2018-03-06:
It means that you are using a quite old code... You should upgrade.
Also failsafe can be disabled from the config file. So it would be good to do a test. I'm still thinking they are unrelated but it does not harm to test it.

pascallanger, 2019-05-08:
This is expected, you need to change the detection threshold on your radio. Ask on rcgroups, people will tell you what they use depending on your TX.
Pascal

michalelektryk, 2019-05-08:
Well i’m using multiprotocol tx

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

pascallanger, 2019-05-08:
Well I don't know what a multiprotocol TX is. I'm taking about your radio and firmware running on it ersky9x,opentx,...

michalelektryk, 2019-05-08:
DIY Multiprotocol TX and taranix x9d+ with 2.2.3 firmware

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

pascallanger, 2019-05-08:
As said earlier please post on rcgroups to get the correct settings for warning and critical: https://www.rcgroups.com/forums/showthread.php?2165676-DIY-Multiprotocol-TX-Module/page925 .

AndreBL, 2019-05-09:
Suggested RSSI alarm threshold settings for AFHDS 2A in OpenTx (Telemetry tab):
Low: 15
Critical: 12

If you find trouble setting these values as Companion does not allow them, try setting them to 20 which is the lowest value allowed by Companion.

Heri201, 2019-07-06:
Hi..

Can ppm flysky AFHDS 2A use multiprotocol this? thank you..

pascallanger, 2019-07-06:
yes

Heri201, 2019-07-10:
Now I'm happy. I can bind to flysky, frsky and other protocols. thank you @pascallanger for this amazing technique.

Closed 2017-12-07.

Thread 96 (2017-08-07):

Make place on PCB for 9XR internal antenna connector

steelman, 2017-08-07:
Redesign PCBs so it is possible to connect module to 9XR's internal antenna. I can see two possible options.

* Leave a hole for a connector on U.FL pigtail
* Reroute RF and mount the connector on a PCB

Might be the latter prepared so, that on one side there is U.FL for SMA connector and SMB(?) for the internal antenna?

KC5CQW, 2017-08-19:
Replace the U.FL with an MCX (or MMCX not sure which) to match the internal antenna jack. Jumpers are relatively easy to find online and offer much better tolerance to abuse over the U.FL's. The internal jack is outside of the PCB footprint and wouldn't necessarily fit other TX's. Pigtails offer the most flexibility (pun intended).

pascallanger, 2017-11-20:
You should use the 3D model designed for it. It works without an issue.

steelman, 2017-11-20:
What 3D model? Of a cover? This requires an external antenna. 9XR has a built in one in the handle with a connector available in the module bay.

pascallanger, 2017-11-20:
I'm using the 9XR Pro antena in the handle with both the STM32 and Atmega versions.
I'm reffereing to this 3D model/print (scroll a little on the page):https://github.com/pascallanger/DIY-Multiprotocol-TX-Module/blob/master/docs/Module_BG_4-in-1.md#what-you-need which is available on thingiverse: http://www.thingiverse.com/thing:2050717 . It works very well.
- Pascal

steelman, 2017-11-20:
I wouldn't have bothered you, if these links were include included above :-) Thank you very much.

pascallanger, 2017-11-20:
Sorry but this in the documentation...

Closed 2017-11-20.

Thread 109 (2017-11-11):

Going to autobind when receiver isn't switched on

DonKracho, 2017-11-11:
Hi,

I'm using the banggood STM32 4-IN-1 module (flashed to 1.1.6.21 INV) in a Traranis X9D+ (OpenTX 2.2) I have got a lot of ASSAN receivers, so I'm quite happy that the protocol is supported. I can bind receivers and the link is stable.

No the issue: Usualy you have to spwitch on the radio first an then the model. The Autobind radio button in the model page ist switched off, but the Taranis does not care and goes to bind mode. An already bound receiver will not establish the link then. I have to go to the model settings, select another protocol and going back to ASSAN again to stop the bind procedure and the the receiver immediately goes green, saying the link is fine.

How do I prevent the autobind procedure? I have the same issue with DSMX and Devo. When set to a fixed ID the transmitter should not go to bind mode again.

B.T.W is there any way to get rid of this really loud bind beeping?

schwabe, 2017-11-12:
The loud beeping is OpenTX "I am binding" sound. Please open a seperate issue on that. For some protocols (especially toy protocols) the protocols need to bind at start to work, so on these protocols autobind is unconditionally enabled. However for DSMX, Devo and Assan this is not the case. Are you using serial?

DonKracho, 2017-11-12:
Yes, I'm using serial. I compiled the source with Arduino/ST32 toolchain because I wanted TAER channel order. I also tried to use autobind in conjunction with auto bind channel 16 feature but even with no low-high transition on chanel 16 the bind procedure starts. It happens not all the time but in about 80% of the power cyples of the Tarranis radio. So it looks like a timing issue or race condition. May be it is ralated to the Taranis firmware.

Settings of _config.h
#define TAER
#define ENABLE_BIND_CH
#define BIND_CH	16
#define WAIT_FOR_BIND

pascallanger, 2017-11-20:
What's the Autobind setting for this protocol for the specific model?
What's the LED status of the module when you startup the TX?

DonKracho, 2017-11-28:
Looking for the module LEDs has been a great idea! The problem is solved! It has been a mechanical issue. Removing the cover of the module tray did stop the unwanted 'auto bind' feature  immediately.  The cover did press the bind button slightly. Sometimes it did make a contact, sometimes not. My fault. This issue can be closed. Thank you. This module is a fun and really great work analyzing and implementing all the protocols!

pascallanger, 2017-11-28:
Feel free to donate if you are enjoying the multi module to support it's future development.

Closed 2017-11-28.

Thread 135 (2017-12-29):

Additional protocols in PPM mode?

pinkywafer, 2017-12-29:
The iRange IRX4 PLUS firmware as supplied includes the functionality for 30 protocols and serial to be selected using the protocol knob.
The protocols are split into 2 sets - Set 1 (green light off) which has serial mode in position 0, and set 2 (green light on)
The protocol set is switched by long pressing the bind button at module power on.
Is it possible to add this functionality?  or if it is already included, how do I configure the second set of protocols? - only 15 are definable in _Config.h

Thanks

pascallanger, 2018-01-02:
As iRange have added it on their own, it would have been great that they at least share their improvements... This is unacceptable in my eyes... They are making money of our work, do not contact us to propose anything not even a sample, modify the source files and do not share them back which is breaking the open source licence!!!

This feature does not currently exist and I'm not really keen at this moment to add it...

Pascal

pinkywafer, 2018-01-02:
I understand entirely your feelings,  and agree with you.

pascallanger, 2018-01-02:
Where is this green LED connected on the STM32? It's not on the original design...

pinkywafer, 2018-01-02:
I am not sure as I am waiting for delivery of the module. I expect that I will have to reflash anyway in order to be able to have the configuration I want, so I'll have a look when I've got it open for soldering header pins

mlmflip, 2018-01-05:
On the iRange IRX4 PLUS module, can you at least reconfigure protocol assignments for the first 15 switch positions in _Config.h and then compile/upload updated firmware?  Or does a firmware re-compilation wipe out or corrupt the useability of the the second set of protocols when the green light is on (equivalent to switch positions 16-31)?

Bottom line issue for me:  I have the iRange IRX4 PLUS module and am using PPM.  I need to use the H20 protocol, but it isn't available by default on one of the 30 dial positions out of the box.  I want to reconfigure the dial assignments to allow use of H20.  Is this possible?

pascallanger, 2018-01-05:
You have to ask iRange to make the modification for you...
If you update the firmware then you will loose 16-31.

schwabe, 2018-01-05:
@mlmflip You should demand the modified Firmware from IrangeX, the GPL states they MUST provide it to you.

mlmflip, 2018-01-05:
Understood.  Thank you for your comments, gentlemen.

pinkywafer, 2018-01-05:
I have twice asked for both the compiled firmware and the source code by sending a message using the form on iRangeX's website. I have received no reply to either message

mlmflip, 2018-01-05:
Thanks, Pascal.  As use of this module becomes more widespread, hopefully iRangeX will eventually provide the compiled firmware to allow modification will full use of positions 1-31.  I actually thought this module version with the additional dial options would be an upgrade from the Banggood 4-in-1, but at this point it's actually a downgrade in terms of flexibility for the end user.

pascallanger, 2018-01-05:
@mlmflip : do you have one of these iRangeX modules?
If yes, on which STM32 pin is connected the green LED?

mlmflip, 2018-01-05:
Yes, I recently received the iRangeX module.  I have successfully installed it in my Jeti transmitter and it is working well (see attached pics).  I am at work now, but will check the pin assignment for the green LED later today and advise.

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

tipouic, 2018-01-11:
Hi Pascal,
I just received an STM32 module with USB and selector.
The green LED is an addition on the circuit (pin n°12, PA-2), it is marked STAUS.

They use the following procedure to switch from 0-15 to 16-31 (witch the green led is off).
Turn off your transmitter, point the protocol switch to "0", hold and press the bind of RF module then turn on your transmitter, after 3 seconds, relase the button.

pinkywafer, 2018-01-11:
From looking at the board, I am unable to tell where the LED is connected. Tracing from the LED goes to a smt resistor, then the trace goes towards the STM32, then it goes through to the other side of the board. The circuit hole is right in the corner of the STM32 by pin 1.  I cannot follow on the other side as it is hidden beneath the RF and I have not got test equipment available to trace.
For reference, don't know if it's any help, the board is printed with the code YRFM_ARM_V1.2

pascallanger, 2018-01-27:
The LED2 has been added to the latest build (on at startup so nothing fancy).
I'm looking at implementing a bank switch but not the way they've done it as I want it be compatible with all modules (which do not have a second LED anyway).

pascallanger, 2018-01-29:
I've implemented the bank switch system when using PPM. Up to 4 banks of 14 protocols can be configured in _config.h which gives a total of 56 entries (more than enough I think). The number of banks can be set from 1 to 4 in _config.h.

Does someone have an idea of which protocols I should set by default in the banks?

Is someone willing to test the firmware on Atmega? I don't have a module around...
I'll test tomorrow the STM32 version but if someone is willing to test as well...

It works like this:
1. turn the dial to 15
2. power up the module
3. the module displays the current bank by flashing the LED x number of times, x being between 1 and up to 4
4. a short press on the bind button turns the LED on for 1 sec indicating that the system has changed the bank
5. repeat operation 3 and 4 until you have reached the bank you want
6. power off
7. change the dial to the desired position
8. power on
9. enjoy

Pascal

pascallanger, 2018-01-30:
No one is willing to test so closing this issue.

pinkywafer, 2018-01-30:
Only just seen the update to this. I'll be happy to test on stm32, but do not have an atmega.

Closed 2018-01-30.

Thread 136 (2017-12-31):

Betaflight commands not working

thjubeck, 2017-12-31:
Hey, is there anything besides the SPORT_POLLING and invert telemetry that needs to be enabled to get betaflight lua scripts to work?

schwabe, 2017-12-31:
Depends on your remote. For OpenTX you currently need a nightly. For INVERTED telemetry you might run into the problem that the code currently does not switch off the inverter when sending leading to suboptimal voltage level.

(rest is copy & pasted from my [post on rcgroups](https://www.rcgroups.com/forums/showthread.php?2165676-DIY-Multiprotocol-TX-Module/page717#post38816707) to have the information here in Github)

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
I tested with a Banggood with USB Board and SPORT Polling enabled:

There is another much bigger problem at the moment on my Taranis. The telemetry output of the Taranis does not drive the sport line high enough. The 0,75V peak for the output is not really much. Even the input voltage from the multi module with 2V is not really great but good enough for the inverter on the Taranis to register. I attached a screenshot from my Salae.

Update: The IrangeX Board (which uses a normal 2port inverter) has the same problem just with 1,9V and 0,95V.

With the internal XJT module both input and output are 3,25V. Something on the multi board is pulling the voltage levels down but only if the multi module is also powered.

Inverter circuits inside the X9D+ have a total of 10k pull down that is always active. The multi module has only a 4k7 pull that also needs to go through a diode. Ignoring the diode we get 2,2V, the diode could be another 0,2V. So that fits the voltage levels I see.

When the Taranis drives the sport line, uart output of multi module is high level so, with TX_INV enabled the inverter pulls down sport and that inverter is capable of at least 24mA current. Without the diode's forward voltage drop the Sport line would probably just stay at 0V.

Just toggeling TX_INV in rx_pause/rx_resume does not work. USART is still sending when the inverter is toggled. Probably need to toggle on USART TX finish interrupt

kimman1, 2018-07-21:
Does it work ? . I try STM32 module with 2-transistor inverter but it isn't work

schwabe, 2018-07-21:
@kimman1 the 2 transistor inverter is also not bidrectional, so it cannot work.

kimman1, 2018-07-22:
@schwabe so what i need to get it work ?.
I think i need a new inverter diagram ? Or we force to use inverter chip in atm diagram.

schwabe, 2018-07-22:
@kimman1 the broken inversion I am talking about in my post is already with the STM32 board and the inverter chip. But I have no working bidrectional inverter diagram at hand.

kimman1, 2018-07-23:
Yep, i have oder inverter chip at TI. Hope it working.
I don't know why because midelic told me that he use STM32 DIY module with 2 transistor invert with his 9xpro TX and betaflight command from his TX work perfect

pascallanger, 2018-08-06:
Please test v1.2.0.26 which should fix sport polling and report.

kimman1, 2018-08-07:
I've tested it with my X9D+ with OpenTX. It's not work

pascallanger, 2018-08-07:
Are you running the latest ersky9x version R222b6 available here http://openrcforums.com/forum/viewtopic.php?f=7&t=4676 ?

pascallanger, 2018-08-07:
@schwabe Will you implement on OpenTX the same fix that Mike applied on ersky9x to get sport working with multi?

schwabe, 2018-08-07:
@pascallanger To my understanding that would be implementing software serial do overcome the signal level problem that is present with the inverter being active.

It might be worth looking into if it is possible to disable TX_INV while the multimodule is listening for S.Port input. That should fix the problem with the low signal level. As you can see from my image in https://github.com/pascallanger/DIY-Multiprotocol-TX-Module/issues/136#issuecomment-354606718 OpenTX already answers with Multi telemetry enabled but the signal is pulled down by the inverter and the diode to the forward voltage of the diode (~0.7V).

MikeBland, 2018-08-07:
@schwabe "if it is possible to disable TX_INV" This is what is now done in the module, for 3mS after starting to send the SPort poll. ersky9x is working on the Taranis using the hardware serial with this in.
The downside is you might get a line break detected you need to make sure you ignore.
In ersky9x, I use the same code as for the XJT module. It detects the SPort poll (very likely after half of the first stop bit) and immediately enables the Tx output (line marking so a low voltage with the inverted signal).
To make sure any line break is cleared and the serial data is sent correctly, I turn the TE bit off, then on in the USART control register. This causes the USART to send a whole character (12 bits) of line marking before the start of the first byte, so clearly terminating any line break.

@kimman1 What script are you using with ersky9x?
I don't have any Betaflight hardware, but I tested configuring a S8R receiver using both a MPM module and the internal XJT.

kimman1, 2018-08-07:
@pascallanger Yep. I use ErskyR222b6 for testing

schwabe, 2018-08-07:
@MikeBland I did not see the fix to Multi code. Yes that is exactly what I had in mind. I need to double check what now happens with OpenTX and why it is not working. But that might take a while (life gets in the way)

pascallanger, 2018-08-07:
@kimman1 What receiver are you using, and, with ersky9x, are you seeing a RSSI value?

filippov-shurik, 2019-03-11:
Good day, I started with the same problem on the jumper t12 equipment with a 4 in 1 multimodule telemetry works without problems, but the scripts do not work, how much do I understand the problem in the module and its levels ??? and is there a solution to the problems.

multimodule version 1.2.1.28
I use the r-xsr transmitter connected in fport and sbus/sport
fc omnibus F4.
betafligh or inav.

pascallanger, 2019-03-11:
It should work using ersky9x. The OpenTX fix has never been implemented.
Personnaly I don't have the hardware to troubleshoot...

delta575, 2019-09-16:
I'm experiencing a similar issue, lua script for betaflight wont work "script syntax error telemetry protocol not supported"

My setup:
Taranis x9d+ (opentx-x9d+-multimodule-noheli-lua-luac-en-2.2.4)
Jumper jp4in1 (multi-stm-opentx-inv-v1.2.1.76)
FuriousFPV LR1000 Diversity Mini Receiver for Frsky
BETAFLIGHTF3 board

pascallanger, 2019-10-03:
Multi and OpenTX dev versions in action: https://youtu.be/eCnxs3d4VKg
It's not released yet (couple of weeks).

MikeBland, 2019-10-09:
Hi
Pascal,

I've received a communication suggesting the PPM bank selection may not
be working on the current Github sources.
I'll try to test this later today, I'll need to check I have the latest
sources and build/flash the firmware to test, but you may have a module
ready to test.

Also see: https://www.modelflying.co.uk/forums/postings.asp?th=145276&p=1#PostTop

Mike

pascallanger, 2019-10-09:
Hi Mike,
This is strange. I wanted to post on the site but you need to create an account.
I'm wondering if the guy has ut more than one bank in the _config.h file since the default is #define NBR_BANKS 1
Pascal

pascallanger, 2019-10-16:
Fixed in Multi v1.3.0.xx and OpenTX 2.3.2 .

Closed 2019-10-16.

Thread 147 (2018-02-11):

PPM documentation is currently misleading at different links

xtremet1, 2018-02-11:
Pascal, you had changed considerably, the "nominal" originally bought module behavior
with "Position" 15, counting the blips of the red led, changing the behavior of the green led

At different pages of documentation, one can understand different things & this is missleading
e.g. https://github.com/pascallanger/DIY-Multiprotocol-TX-Module/blob/master/docs/PPM_Setup.md

vs https://github.com/pascallanger/DIY-Multiprotocol-TX-Module/blob/master/Protocols_Details.md

or your description at the forums of :
It works like this:
1. turn the dial to 15
2. power up the module
3. the module displays the current bank by flashing the LED x number of times, x being between 1 and up to 4
4. a short press on the bind button turns the LED on for 1 sec indicating that the system has changed the bank
5. repeat operation 3 and 4 until you have reached the bank you want
6. power off
7. change the dial to the desired position
8. power on
9. enjoy

Pascal  - https://www.rcgroups.com/forums/showthread.php?2165676-DIY-Multiprotocol-TX-Module/page756#post39094169

Further, one must have the ability & understanding to read the "Config" file, and understand that OLD directions of for example BANGGOOD product  description should be totally ignored.

It's not just turning the dial anymore, and "No Zero" Position for "Greed LED" to go off, whole logic had changed some what like described in : https://github.com/pascallanger/DIY-Multiprotocol-TX-Module/blob/master/Protocols_Details.md

However - I think that correction need to be done in all pages as currently it's missleading
IF I can help you with that please tell me

pascallanger, 2018-02-11:
Could you rewrite the doc as you think will be easier?
Same for _Config.h if you think it's not simple enough...

> Further, one must have the ability & understanding to read the "Config" file, and understand that OLD directions of for example BANGGOOD product description should be totally ignored. It's not just turning the dial anymore, and "No Zero" Position for "Green LED" to go off, whole logic had changed some what like described in : https://github.com/pascallanger/DIY-Multiprotocol-TX-Module/blob/master/Protocols_Details.md
Only the iRange RX4**+** has this bank switch feature with the green led. All others do not have a second LED and no bank switch...

> Further, Binding behaves differently (Much shorter times... e.g. sync of FrSky ..v911 heli
The code has not changed this behavior at all. I think you are mistaken here...

Pascal

pascallanger, 2018-02-11:
I've updated the different documentations and _config.h .
Let me know if that's enough or propose your changes otherwise.

Pascal

xtremet1, 2018-02-11:
Pascal, I think I have at least 3 comments, however I would not like to
comment when I'm tired as I was debugging
what had happened to the Multi-Module till 2AM last night

My 4 Comments in general are :
1) Indicate about the "Green Led Behavior" (as you had changed that vs
Stock)
2) At Protocols page top - I think a link should be made explaining the a
5x14 Table is created at the Confing File - which this one controls
actually all the detailed below protocols  (later below I would also detail
about DSM2/DSMX 1024/2048 etc... as where those relate to... & give example
like AR6100... or other common receivers as to where they belong to & how
that's connected to the Config)  - I may not explain my self well here (as
I'm very tired :-) )) if I cut from your site put in WORD & make changes in
Track Changes - would that be O.K ?
3) I would note (on many pages) - e.g. HW page and others that when you
"Burn In" your firmware - that's it's !   you need to use "new tables" all
OLD tables are gone & never return  (of if I didn't get it right... maybe
you can indicate the "Base" BANGGOOD is programmed with
4) BINDING - I have small correction + If you can indicate the "Time" you
have when the "BIND Button" is presses & later when it's released (from the
TX / Modules - Prespective

What I had seen ... the v911 was "Easy" "Very Fast" to bind on the Banggood
Original FW, while I had about 15 tries with the New FW "doing just about
the same" & failed so many times ... I though it's Game Over... So I tied
it with "DSM" where I think I have a problem with "Channels" but I saw it
was alive and continued to try on the v911

I'll try it when I'm fresh & maybe try to film it

I'm sorry - but I was not in the Hobby for 5-6years now & so much had
changed :-)

You & your other Guys did a GREAT work here - I really admire (& I had
built a few "nice things" my self in my life )

I hope I'll get better new equipment so I'll be able to enjoy it further :-)

Tal.

<https://www.avast.com/sig-email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>
Virus-free.
www.avast.com
<https://www.avast.com/sig-email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>
<#DAB4FAD8-2DD7-40BB-A1B8-4E2AA1F9FDF2>

On Sun, Feb 11, 2018 at 4:00 PM, pascallanger <notifications@github.com>
wrote:

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

Thread 148 (2018-02-12):

Note for installation of Arduino Due board

kreidler, 2018-02-12:
The new documentation is nearly perfect. Thanks.

I have had a fresh install for the STM32 and need flashing via serial.
Flashing was not possible until I added the Arduino SAM Boards to the Boards Manager.
Please add small note to Arduino_IDE_Boards.md

benlye, 2018-02-12:
The STM32 board package _should_ install the tools and dependencies it needs, not requiring the Due board package to be installed.  It has done this correctly many times for me.

What was the error you got?  Was it a fresh install of the Arduino IDE?  Which version of the IDE?  Could you try again to see if the same thing happens?

kreidler, 2018-02-12:
Windows 10 Pro / Arduino 1.8.5 / Arduino 1.0.6 was running before with some libs installed
Followed instruction given Arduino_IDE_Boards.md. Restarted machine also.

Error message "Failed to init device." like nothing connected
Tried several times with changed wires, with different serial settings until I installed Due board package.

The 4in1 boards downloaded app. 85MB on first instance. The Due board afterwards were additional app. 16MB (as far as I remember).

benlye, 2018-02-12:
'Failed to init device' is an error from stm32flash, so I take it you're trying to flash the module using an FTDI adapter?

'Failed to init device' generally does mean that the upload tool couldn't open the serial port, or couldn't detect the device on the port. I can't imagine why installing the Due board would affect that - the Due board doesn't install anything to do with flashing an STM32F1 using stmflash.exe.

Are you sure you had the board set up correctly, with the serial flashing BOOT0 jumper installed, for your initial attempts?

kreidler, 2018-02-12:
Sorry, forgot to mention that I partly followed: https://www.youtube.com/watch?v=Cygc9trueSc as the guy was flashing an older version on the same board I have and he had to install following the older instruction the Due Board.
I have had no further idea, so I installed the Due Board and only the IDE restarted it worked. BOOT0 was always jumpered. I also changed the Tx and Rx wires.

I will test tomorrow on a second machine and try to confirm.

benlye, 2018-02-13:
That video is out of date.  The current documentation is valid for all known versions of the STM32 board.

Before we created the Arduino IDE board definition specifically for the Multi-module boards it was necessary to install several components separately.  The Due board was needed because it installed the GNU Arm Toolchain - the gcc compiler for the board.  The Multi-module STM32 board package now installs that itself.

The Due board adds nothing that would influence flashing the STM32 Multi-module via an FTDI adapter, and I can only think that you must have changed something else at the same time.

kreidler, 2018-02-19:
Sorry was ill during last days.
Rechecked with another machine. Restart after installation of the 4in1 STM32-Board performed.
Flashing worked on frist attempt. I will try to figure out what what happened on the origin machine.

issue also closed from my side. Thanks

Closed 2018-02-19.

Thread 161 (2018-05-02):

Hitec Red AFHSS Support

z3r0c00l2005, 2018-05-02:
Hi Guys, it woudl be great to see support for the Hitec Red protocol as used for the Ares range of indoor/park flyers (I believe this is the same as the Minima protocol)

pascallanger, 2018-05-04:
I need a Hitec transmitter and a RX to reverse the protocol...

z3r0c00l2005, 2018-05-04:
Only kit I've got is embedded in RTF Ares models.  Can hook up a logic analyser to the tx if that'll help

pascallanger, 2018-05-04:
You can always see if you have access to the spi bus between the controller and the RF component if not all integrated in one chip.
Let me know.

z3r0c00l2005, 2018-05-06:
[pwr on to bound.zip](https://github.com/pascallanger/DIY-Multiprotocol-TX-Module/files/1977499/pwr.on.to.bound.zip)

I've attached a LA to the 3 non-power pins between the main controller board (Processor seems to be a ATMEGA48V-10U) and the RF module (FLDSTX1) and captured the power-on trace.

The Reciever was powered up, and the TX turned on and left to negotiate the link.

D0 is connected to FLDSTX1 pin 8
D1 to pin 6
D2 to pin 7

Other than the power pins, none of the others are soldered up so i've assumed they're unused

Attached trace is from Pulseview.

z3r0c00l2005, 2018-05-08:
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

Had the chance to dig further - the RF module is based upon the CC2510.

pascallanger, 2018-05-09:
The CC2510 is an all in one micro controller + RF. I'll have a look at what's going in between the main board and the rf module but little hope to find anything usefull...
We need a TX with a separated RF component. Or attack over the air which requires a lot more work...

z3r0c00l2005, 2018-05-09:
I was wandering that, especially since I didn't spot a clock signal for SPI. I was trying to assess from some of the FCC photos of there was a "budget" Hitec system that would be easier to sniff... Not sure I could see anything helpful on there. What would we need for OTA analysis?

z3r0c00l2005, 2018-05-15:
OK, I've taken the plunge and started looking Over The Air at this using a Hack RF One.

Does anyone have a GNU Radio Flow Graph for capturing FHSS systems?

looking at https://apps.fcc.gov/eas/GetApplicationAttachment.html?id=2808483 the frequency hopping tables are known (and confirmed with a spectrum sweep) using GFSK modulation should be plausible to decode the signals.

pascallanger, 2018-05-15:
I can't access the web page link since it's asking for a username/password.
You could try to capture only one channel for now to see if some of the serial data can be located in the frame.

z3r0c00l2005, 2018-05-15:
Odd, although the link points to the "Test Report" for FCC ID 2AEIGFLDSTX1, pages 5 & 6 seem to be the most interesting ones.  I'll try to capture a bind packet from a couple of channels later.

brandond, 2018-05-16:
FWIW, I think you have to go through the application search to get at the documents:
https://apps.fcc.gov/oetcf/eas/reports/ViewExhibitReport.cfm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

FXDUTRUCROSSET, 2018-07-07:
Pascal i live in the south of paris and can lend you a telemetry 9 ch receiver and tx module or full radio gear for a few if needed

pascallanger, 2018-07-07:
That would be cool. I work in Meudon so we should be able to meet somewhere. Please contact by PM.
FYI, Franck contacted me a while back to get the Assan protocol on multi. He didn't sent me the hardware but one of his friend did.

FXDUTRUCROSSET, 2018-07-07:
i'm on paris on friday sat sun i don't see the link for PM on git, pls contact me on modelisme.com fxdr MP

z3r0c00l2005, 2018-07-13:
I've now got access to a Spectra module, which seems to have qty 2 6-pin connectors between the main and RF boards - when i get chance i'll hook up the LA and post some traces.

pascallanger, 2018-07-20:
Any news?

FXDUTRUCROSSET, 2018-07-21:
i need to wait till u come back from hollidays in normandy?

Le ven. 20 juil. 2018 à 14:54, pascallanger <notifications@github.com> a
écrit :

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

pascallanger, 2018-07-31:
FYI, FX sent me an Hitec TX and RX (optima). I'm planning to work on this protocol in the next few days.
The TX has 2 modes to work with optima RXs or minima/micro RXs.
I don't have a minima/micro RX. If you have one available and don't mind to send it my way that would be appreciated. Otherwise if at least someone could participate in the debug seesion.

pascallanger, 2018-07-31:
I've already connected the wires on the spi bus and done my first dump. Everything looks good since I can see the cc2500 init and packets. Now the fun part starts.

z3r0c00l2005, 2018-07-31:
I've got an irange+ module and 3 models that bind with a minima protocol (although they're not genuine HiTec recievers). More than happy to help out :)

pascallanger, 2018-08-01:
Optima and Minima protocols and bind are pretty much reversed at this stage.
The telemetry for Optima is somewhat not fully there yet. I think it's because I'm missing either a sensor on the RX side so it has more data to send or on the TX side nothing is polling on the i2c bus the data.
But telemetry is for later, I need now to put it in Multi and get what is on paper working ;-)

pascallanger, 2018-08-03:
I've got Minima "potentially" working. I was planning to push it on github today for you to test. I can share the dumps, maybe temporarely on this github for ease of access.
Optima does not work yet since I'm missing a small part of the bind negociation which I won't be able to work on until monday...

z3r0c00l2005, 2018-08-03:
Sounds good to me, I'll have the environment ready this afternoon to be able to recompile and check minima over the weekend - also well timed as i'll be able to test in a flying environment on monday as well :)

pascallanger, 2018-08-03:
I hope it will work for Minima, there is a number of unknown bytes and no RX to try out so... But since there is no negociation/talk between the TX and RX it should be ok.
I've put 2 dumps here: https://we.tl/UQFwCungJv

z3r0c00l2005, 2018-08-03:
Cool, thanks :) look forward to testing it out :)

I assume it's not going to be selectable via the OpenTX menu just yet and will use the usual AETR order on the model config

pascallanger, 2018-08-03:
On OpenTX, it will be custom protocol=39, sub-protocol=1 (for minima) and option=freq adjustment (like all frsky, corona,...)

schwabe, 2018-08-03:
@z3r0c00l2005 you can always use custom on OpenTX and use the protocol numbers.

schwabe, 2018-08-03:
@pascallanger I am adding Hitec (39) with Optima (0) and Minima (1) and cc2500 freq adj to OpenTX, right?

pascallanger, 2018-08-03:
@schwabe Yes please ;-)

pascallanger, 2018-08-03:
Ok, I can get an Optima receiver to move a servo.
Issues that I still observe:
 - if I use a random hopping table the link is not good, I'm seeing delays on the servo. This means to me that some channels are not usable, now I need to figure out which ones... The channels do not seem to be linked the ID, but there is still 3 unknown bytes which are exchanged during bind which I have no idea what to do with so still some investigations are needed.
 - telemetry packets are not received after some time. Relaunching the protocol restarts the telemetry stream but it will faill again. On the telemetry, I can get the RX voltage, TX LSSI and TX LQI. RX RSSI is not available...
Slowly but surely...

pascallanger, 2018-08-03:
@schwabe I'll do the same than AFHDS2A for the telemetry: FrSky Hub and forward to TX.
For now I'm using FrSky Hub but anyway I haven't figured out to get all the telemetry since the receiver is only sending the 1st frame on 4 (same on the original radio). It could be bacause there is no sensor attached, or the TX not having a device pulling telemetry.
So this is more a head's up that this is coming. Telemetry has GPS, temp sensors, voltage, rpm,...

pascallanger, 2018-08-03:
Ok, Optima RX is working:
 - Random ID and hopping frequency table
 - Telemetry is looks stable now, I have the RX voltage, TX RSSI and TX LQI through the FrSky Hub telemetry protocol.

TODO:
 - test on Minima -> there is a big chance that it works out of the box if I haven't done a mistake
 - Optima telemetry: how to request the next telemetry frame? Is it the RX deciding to send the frames or the TX? no idea for now...

z3r0c00l2005, 2018-08-03:
Awesome. I can take a look at the minima if you like. Is there a dev branch available?

pascallanger, 2018-08-03:
I've just made a push on the main repo.
Please test and report!

z3r0c00l2005, 2018-08-04:
Minima -
Bound straight away

Seems to be a delay or a step on the channels, if i move the sticks to full deflection the servos respond in steps rather than a smooth motion

pascallanger, 2018-08-04:
Could you edit the hitec_cc2500.ino file and uncomment the line #define HITEC_FORCE_ID ?
It will use the ID and freq hopping of the TX I've dumped. Let me know if it improves or not.

z3r0c00l2005, 2018-08-04:
That seems to make it much worse

pascallanger, 2018-08-04:
Ok I'll see what I can do later this evening.

pascallanger, 2018-08-04:
I've been thinking about on the road... Have you tuned the frequency using option? What you describe could also be due by a bad freq tuning...

z3r0c00l2005, 2018-08-04:
Now I will admit I've not tried that since it all bound easily! What sort of values would you suggest trying?

pascallanger, 2018-08-04:
Follow the frsky/corona/sfhss freq tuning page: https://github.com/pascallanger/DIY-Multiprotocol-TX-Module/blob/master/docs/Frequency_Tuning.md

pascallanger, 2018-08-04:
The freq tuning is module dependant so I can't give you numbers...

z3r0c00l2005, 2018-08-05:
Even tuned it doesn't appear to be smooth, although it's certainly closer to being flyable :)

pascallanger, 2018-08-05:
Have you retried once tuned  with force ID?

z3r0c00l2005, 2018-08-05:
with the forced ID ther's around a 2second delay between stick input and control deflection

z3r0c00l2005, 2018-08-05:
I can do, would I just upload a new build over serial and leave the TX connected to the PC to see that? (Usually I use a USB upload)

pascallanger, 2018-08-05:
Upload using USB, leave the module connected to USB and open the serial monitor from Arduino. You should see the module starting and giving you some information like protocol selected...

pascallanger, 2018-08-05:
You can do the same using serial just to be able to move forward... Exact same process but ftdi instead of USB.

z3r0c00l2005, 2018-08-05:
The only message dumped is for the selected protocol, nothing else in either bind or normal mode

pascallanger, 2018-08-05:
I've just published v1.2.0.25 adding the F5s in the packets.
Could you test Minima again with this version?

pascallanger, 2018-08-05:
Are you able to do a range test? Like do a sweep test on a servo and walk away with the receiver?
I really have no idea what the 2 bytes do. I've reproduced the real TX but since they vary... On my side I've used a fix value.

pascallanger, 2018-08-05:
I'll do some tests tomorrow and see if I can get a correlation with something.

pascallanger, 2018-08-05:
Yes the range option limits the module power output of any loaded protocol.
I need to check more carefully on the dumps if I can find out a correlation.

pascallanger, 2018-08-06:
Please check the latest version 1.2.0.26 which has some improvements:
 - 3 bytes TX ID
 - F5 frames same as the original TX
Still missing:
 - full telemetry

z3r0c00l2005, 2018-08-06:
Ok, on 1.2.0.25.....

Fokker binds and works well with Rx id 21....very juddery on id 01 or 11

Sopwith and spas jerky on any id, slightly better after tuning but not flyable

pascallanger, 2018-08-06:
I thought you said it was working?
What do you mean by rx id?

z3r0c00l2005, 2018-08-06:
On the bench the Fokker was ok, I'd just not tried the others yet

The Reciever number parameter in open TX

z3r0c00l2005, 2018-08-06:
I've a couple of flights in on the Fokker bound with ID 21 and it's great. I can only guess that the 3 recievers are slightly different in resilience, although they all work ok with the HiTec module.

For testing I've been using the same model setup on the transmitter, just rebinding with the different models

pascallanger, 2018-08-06:
RX_num is between 0 and 15. That's why it sounded strange.
Have you tired 1.2.0.26 yet?

z3r0c00l2005, 2018-08-06:
I'll reflash hopefully in the next couple of days. Didn't have chance before coming flying :)

pascallanger, 2018-08-07:
Please use v1.2.027 for further testings of Minima/Micro receivers. I think I've nailed down the bug which was an overlook during implementation...

z3r0c00l2005, 2018-08-07:
Will do, just flashed 1.2.0.27 although need to head back to work now (why is there never enough free time!))  will hopefully get to try binding the models tonight and feedback when i get chance.

z3r0c00l2005, 2018-08-07:
I think we (well I say "we" but I really mean you!) are just about there :)

Flashed 1.2.0.27 and bound all 3 separate models using rx nums 1, 2 and 3, no Optional offset needed and all 3 receivers are responding smoothly on throttle, aileron and rudder channels.

Great work Pascal, much appreciated :)

pascallanger, 2018-08-07:
Cool! Minima/micro are OK.
Full telemetry is done as well. I still need to document and push the new code to GitHub but basically it's done.

pascallanger, 2018-08-09:
Closing the thread since both Optima + telemetry and Minima are working.

Pascal

Closed 2018-08-09.

Thread 162 (2018-05-07):

AFHDS 2A not binding V1.20

derdoktor667, 2018-05-07:
....due to some changes to the AFHDS 2A protocol using the A7105 / A7106 chipset I´m not able to bind to my receiver as IBUS-PPM or IBUS-PWM. Didn´t try the SBUS option or direct PPM. The Receiver is a IA6B clone ...just a quick note ...now I will see what´s different with it since last version

.....by the way, I´m making some progress in binding my Hubsan H122D using the Hubsan H107 Option ...by "default" the quad will start "beeping" for a bind to a TX ....with some adaptions it will not start beeping but it never completes a bind

....best regards

derdoktor667

snaewe, 2018-05-30:
Any more news on the AFHDS 2A problem? I'm trying to bind to a Turnigy ia10 receiver with no luck.

pascallanger, 2018-06-01:
Is it only an issue with the latest version? Have you tested to roll back a couple of commits to see if it works?

snaewe, 2018-06-01:
I did a quick test by checking out version 1.2.0 (git tag). That used once...but then again it didn't.
I'll try that again and will try other/newer versions.

FWIW: I use the IRangeX IRX4+ in a Taranis X9d+ (latest OpenTX)

pascallanger, 2018-06-01:
A lot of people have been using this protocol succesfully. So if you can't get it to work with any version then you have an issue on your side.
The only thing I'm wondering is if I've broken it during the last merge (or 2), I can't remember really when but afhsd2a has been touched in the last few updates.

thjubeck, 2018-06-02:
Having the same issue with the new version. I reverted to an older known working version and everything bound correctly so there is something up in the new version.

snaewe, 2018-06-02:
News!
After checking some commits between v1.2.0 (f3838ae ("Prepare for release of a stable version", 2017-12-20)) and master (07adeaf ("Adding CFlie protocol (#159)", 2018-05-04)) I would say that commit 8906c85 ("Few modifications", 2018-05-04) is the culprit.
If I checkout master and do 'git revert 8906c85' (+ compile and upload) I can bind to my Turnigy ia10 receiver.
Unfortunately I'm not capable of fixing (or even understanding...) the problem that the mentioned commit introduces. Maybe someone else can.

komar007, 2018-06-05:
I am experiencing a similar issue.
I was trying to bind my Taranis Q X7 with OpenTX 2.21 (cca71808) to the Eachine AIOF3_BRUSHED FC (FlySky version) using iRangeX IRX4 Plus (from Banggood) with firmware version v1.2.0-82-g07adeaf.

The receiver stopped blinking fast and started blinking slowly when I entered bind mode on the Taranis, as expected. But then after radio restart, it continued blinking instead of going into continuous which would signify signal reception. The settings on the TX were:
Mode: MULT FS 2A
Subtype: PPM,IBUS.

I confirm that reverting 8906c85 fixes the issue for me. After reflashing, the RX LED is continuously on and the model works correctly.

thjubeck, 2018-07-05:
Any updates on this issue? I would like to go the new version but currently it is not possible because of the issue.

jchris001, 2018-07-07:
Hi, I confirm too, revert  8906c85 fixes the issue.

But i dont know why...

pascallanger, 2018-07-07:
I'll work on it next week

hayataro, 2018-07-08:
I have similar issue. I have 1.2.0.18 on HORUS X12S and works great, but 1.2.0.20 on MPM Lite and XLite cannot bind to FS-iA6B AFHDS 2A.
Aant to try patched version but how to compile?

fabioeh, 2018-07-20:
I got a similar issue. Have 1.2.0.20 on MPM Lite and XLite cannot bind to FS-iA6B AFHDS 2A.
Bind mode continuously beeps. Have to turn off the transmitter to recover.

pascallanger, 2018-07-20:
Fixed in last commit.

jchris001, 2018-07-20:
Thanks a lot

derdoktor667, 2018-07-21:
...sorry, but for me it is still not fixed in 1.22 ....I have to say, I´m using a DIY module with some harvested TX chips, an Arduino Nano (Clone CH340) on a redisigned PCB ...and I can´t figure out why the AFHDS 2A not binding by inspecting the code

....and since the "Nano" changed the bootloader (328P/OldBootloader) I can´t be sure there are no issues caused by my redesign or foo

...and thank you for your hard work ...I never understood, why there´s no "one to rule them all" ;)

...best regards

derdoktor667

pascallanger, 2018-07-21:
What I can tell you is that I'be tested the latest version and it works fine.
So I would assume this is your module.

derdoktor667, 2018-07-21:
...so, one or two questions left: ...what AVR based module are you using for development at the moment??? ...and what module to buy if I want to use a "supported" version?

Closed 2018-07-20.

Thread 165 (2018-05-27):

Atmea328p - USBAsp upload not working

peppekerstens, 2018-05-27:
**Devices/software tested**
4-in-1-multiprotocol module ATMea328p based
OS: Windows 10 version 1803 / build 17134.48 (physical)
Programmer: [USBAsp](https://nl.aliexpress.com/item/Free-Shipping-USBasp-USB-ISP-3-3V-5V-AVR-Programmer-USB-ATMEGA8-ATMEGA128-New-10PIN-Wire/32711085670.html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)
Arduino version: 1.8.5 (clean install)

Followed instructions: https://github.com/pascallanger/DIY-Multiprotocol-TX-Module/blob/master/docs/Compiling.md

**Problem**
[Step 4](https://github.com/pascallanger/DIY-Multiprotocol-TX-Module/blob/master/docs/Compiling.md): avrdude throws following when uploading:

Arduino: 1.8.5 (Windows 10), Board: Multi 4-in-1 (Atmega328p, 3.3V, 16MHz), No bootloader

Sketch uses 24616 bytes (75%) of program storage space. Maximum is 32768 bytes.
Global variables use 811 bytes (39%) of dynamic memory, leaving 1237 bytes for local variables. Maximum is 2048 bytes.

C:\Users\peppe\AppData\Local\Arduino15\packages\arduino\tools\avrdude\6.3.0-arduino9/bin/avrdude -CC:\Users\peppe\AppData\Local\Arduino15\packages\arduino\tools\avrdude\6.3.0-arduino9/etc/avrdude.conf -v -patmega328p -carduino -PCOM1 -b57600 -D -Uflash:w:C:\Users\peppe\AppData\Local\Temp\arduino_build_291840/Multiprotocol.ino.hex:i

avrdude: Version 6.3, compiled on Jan 17 2017 at 12:00:53
         Copyright (c) 2000-2005 Brian Dean, http://www.bdmicro.com/
         Copyright (c) 2007-2014 Joerg Wunsch

         System wide configuration file is "C:\Users\peppe\AppData\Local\Arduino15\packages\arduino\tools\avrdude\6.3.0-arduino9/etc/avrdude.conf"

         Using Port                    : COM1
         Using Programmer              : Arduino
         Overriding Baud Rate          : 57600
avrdude: ser_open(): can't open device "\\.\COM1": The system cannot find the file specified.

peppekerstens, 2018-05-27:
**Workaround**
Based on [this](http://www.elecrom.com/avrdude-tutorial-burning-hex-files-using-usbasp-and-avrdude/):

1. Start a command prompt
2. Pick the above code-line and replace "-carduino -PCOM1 -b57600" with "-cusbasp"
3. Run...

result:
C:\Users\peppe>C:\Users\peppe\AppData\Local\Arduino15\packages\arduino\tools\avrdude\6.3.0-arduino9/bin/avrdude -CC:\Users\peppe\AppData\Local\Arduino15\packages\arduino\tools\avrdude\6.3.0-arduino9/etc/avrdude.conf -v -patmega328p -cusbasp -D -Uflash:w:C:\Users\peppe\AppData\Local\Temp\arduino_build_291840/Multiprotocol.ino.hex:i

avrdude: Version 6.3, compiled on Jan 17 2017 at 12:00:53
         Copyright (c) 2000-2005 Brian Dean, http://www.bdmicro.com/
         Copyright (c) 2007-2014 Joerg Wunsch

         System wide configuration file is "C:\Users\peppe\AppData\Local\Arduino15\packages\arduino\tools\avrdude\6.3.0-arduino9/etc/avrdude.conf"

         Using Port                    : usb
         Using Programmer              : usbasp
         AVR Part                      : ATmega328P
         Chip Erase delay              : 9000 us
         PAGEL                         : PD7
         BS2                           : PC2
         RESET disposition             : dedicated
         RETRY pulse                   : SCK
         serial program mode           : yes
         parallel program mode         : yes
         Timeout                       : 200
         StabDelay                     : 100
         CmdexeDelay                   : 25
         SyncLoops                     : 32
         ByteDelay                     : 0
         PollIndex                     : 3
         PollValue                     : 0x53
         Memory Detail                 :

                                  Block Poll               Page                       Polled
           Memory Type Mode Delay Size  Indx Paged  Size   Size #Pages MinW  MaxW   ReadBack
           ----------- ---- ----- ----- ---- ------ ------ ---- ------ ----- ----- ---------
           eeprom        65    20     4    0 no       1024    4      0  3600  3600 0xff 0xff
           flash         65     6   128    0 yes     32768  128    256  4500  4500 0xff 0xff
           lfuse          0     0     0    0 no          1    0      0  4500  4500 0x00 0x00
           hfuse          0     0     0    0 no          1    0      0  4500  4500 0x00 0x00
           efuse          0     0     0    0 no          1    0      0  4500  4500 0x00 0x00
           lock           0     0     0    0 no          1    0      0  4500  4500 0x00 0x00
           calibration    0     0     0    0 no          1    0      0     0     0 0x00 0x00
           signature      0     0     0    0 no          3    0      0     0     0 0x00 0x00

         Programmer Type : usbasp
         Description     : USBasp, http://www.fischl.de/usbasp/

avrdude: auto set sck period (because given equals null)
avrdude: warning: cannot set sck period. please check for usbasp firmware update.
avrdude: AVR device initialized and ready to accept instructions

Reading | ################################################## | 100% 0.04s

avrdude: Device signature = 0x1e950f (probably m328p)
avrdude: safemode: hfuse reads as D7
avrdude: safemode: efuse reads as FD
avrdude: reading input file "C:\Users\peppe\AppData\Local\Temp\arduino_build_291840/Multiprotocol.ino.hex"
avrdude: writing flash (24616 bytes):

Writing | ################################################## | 100% 11.14s

avrdude: 24616 bytes of flash written
avrdude: verifying flash memory against C:\Users\peppe\AppData\Local\Temp\arduino_build_291840/Multiprotocol.ino.hex:
avrdude: load data flash data from input file C:\Users\peppe\AppData\Local\Temp\arduino_build_291840/Multiprotocol.ino.hex:
avrdude: input file C:\Users\peppe\AppData\Local\Temp\arduino_build_291840/Multiprotocol.ino.hex contains 24616 bytes
avrdude: reading on-chip flash data:

Reading | ################################################## | 100% 7.50s

avrdude: verifying ...
avrdude: 24616 bytes of flash verified

avrdude: safemode: hfuse reads as D7
avrdude: safemode: efuse reads as FD
avrdude: safemode: Fuses OK (E:FD, H:D7, L:FF)

avrdude done.  Thank you.

, pick the code-line above and adjust the

When choosing the 'Multi 4-in-1 (Atmega328p, 3.3V, 16MHz)' option, the 'port' option is greyed

peppekerstens, 2018-05-27:
Probable cause
USBAsp is a 'true' USB device. Either:
- Let avrdude pick the right target by changing the programmer type to 'usbasp'
- enable the 'port' option so the right port can be chosen.

I assume this is a problem in the 'Multi 4-in-1 (Atmega328p, 3.3V, 16MHz)' board definition. I tried to reproduce the problem with a 'Arduino Nano/USBAsp' board definition combination, and this 'seems' to work (I have no actual hardware for this combination, but I could choose the 'port; to which the USBAsp programmer was attached to and the error is different (finding the programmer/port, buit failing on further communication):

Arduino: 1.8.5 (Windows 10), Board: "Arduino Nano, ATmega328P"

avrdude: stk500_recv(): programmer is not responding
avrdude: stk500_getsync() attempt 3 of 10: not in sync: resp=0xf7
Sketch uses 24984 bytes (81%) of program storage space. Maximum is 30720 bytes.
Global variables use 811 bytes (39%) of dynamic memory, leaving 1237 bytes for local variables. Maximum is 2048 bytes.
C:\Users\peppe\AppData\Local\Arduino15\packages\arduino\tools\avrdude\6.3.0-arduino9/bin/avrdude -CC:\Users\peppe\AppData\Local\Arduino15\packages\arduino\tools\avrdude\6.3.0-arduino9/etc/avrdude.conf -v -patmega328p -carduino -PCOM3 -b115200 -D -Uflash:w:C:\Users\peppe\AppData\Local\Temp\arduino_build_291840/Multiprotocol.ino.hex:i
Problem uploading to board.  See http://www.arduino.cc/en/Guide/Troubleshooting#upload for suggestions.

avrdude: Version 6.3, compiled on Jan 17 2017 at 12:00:53
         Copyright (c) 2000-2005 Brian Dean, http://www.bdmicro.com/
         Copyright (c) 2007-2014 Joerg Wunsch

         System wide configuration file is "C:\Users\peppe\AppData\Local\Arduino15\packages\arduino\tools\avrdude\6.3.0-arduino9/etc/avrdude.conf"

         Using Port                    : COM3
         Using Programmer              : arduino
         Overriding Baud Rate          : 115200

benlye, 2018-05-27:
The Multi-4-in-1 board definition works fine.

Step 2.4 of the instructions has you select USBasp as the programmer.  In step 4 you should choose 'Upload using programmer' rather than 'upload'.

If you choose 'upload' the Arduino IDE will incorrectly attempt to use the COM port, if you choose 'upload using programmer' it will correctly use the USBasp device.  This is just the way the IDE works.

peppekerstens, 2018-05-28:
@benlye ....confirmed... guess i should have read it a little better :|

Closed 2018-05-28.

Thread 171 (2018-06-21):

Documentation on current Banggood modules

andrejpodzimek, 2018-06-21:
With my [Banggood 4-in-1](https://www.banggood.com/CC2500-NRF24L01-A7105-CYRF6936-4-In-1-RF-Module-For-Walkera-D7E-D10-Transmitter-p-1096707.html) module I’ve recently had a [telemetry issue](https://github.com/betaflight/betaflight/issues/6145) when using the latest FrSky RX firmware (for R-XSR on F.Port). I got a recommendation to update the TX module firmware. However, the howtos in this repository describe modules that look quite different. I assume, based on the pinout mentioned in the product description, that what I have might be the SPI variant with ATmega328p and it has 6 undocumented solder pads on it that look like a place to attach the 6-pin header. But is it actually compatible with this firmware? Or is it a completely different device? If it’s compatible, would it please be possible to list / document it somewhere?

tipouic, 2018-06-21:
Hi,
This is not a multiprotocol module but it is a module that groups the 4 transmitters in the same box, so for your code problem, it is necessary to refer to that of your radio.

andrejpodzimek, 2018-06-21:
I see. Thanks for the clarification. So in that case I’ll file a bug with Deviation, the radio firmware. At least now I understand why it has 4 chip select wires. There’s no MCU, so the TX uses chip select to make (only) one of the chips work at a time and talks to it directly.

andrejpodzimek, 2018-06-21:
[Filed.](https://github.com/DeviationTX/deviation/issues/415)

Closed 2018-06-21.

Thread 175 (2018-07-28):

Serial mode on Turnigy 9xr Pro

QUERB, 2018-07-28:
Greetings,

I have fitted my transmitter turnigy 9xr pro with a banggood module 4 in 1 Atmega328p.
I use PPM mode without any issue for many months.
However, I would like to use now the serial mode between the transmitter and the module.
So, I have upgraded the firmware of the transmitter with success (version 8r222 of june 2018).
In addition, I have solded the Tx and the Rx pads of the module.
Now, if I select the 0 position for serial mode on the module and select multiprotocole (type AFHDS2A for example) on protocole menu of the transmitter for the RC model, the red led of the module flash regurlarly with a frequency equal to the "Slow blink (on=0.5s, off=0.5s)". So the issue is that no valid signal is being seen on the Rx pin as described on the module troubleshooting manual.
At the present time, I don't know what I have to do to solve this issue.
May you help me to solve this issue ?
Thank you very much !

pascallanger, 2018-07-28:
I'm thinking you haven't soledered correctly the pads or done a shortcut between the two.
If you look carefully at the picture: https://github.com/pascallanger/DIY-Multiprotocol-TX-Module/blob/master/docs/images/V2b_ISP.jpeg you'll see that the 4 pads are not connected together but vertically (red line) they must not touch each others.

Pascal

QUERB, 2018-07-28:
Thank you for the picture.
I have effectively soldered the 2 pads of Tx and the two pads of Rx separately.
Then, I have checked the soldering : there is no contact between Tx and Rx (no electric continuity).
Perhaps, the quality of the soldering is not correct ?
Please, look at this picture
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
Is it correct ?

Bruno

pascallanger, 2018-07-29:
You might have a really old version of the avr module...
On the old ones you had to do this [modification](https://camo.githubusercontent.com/ba9d480a539e25ce895b3357c46eaf4ec3e4d9eb/687474703a2f2f7374617469632e726367726f7570732e6e65742f666f72756d732f6174746163686d656e747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).

pascallanger, 2018-07-29:
You should check the connectivity between the RX pin of the atmega and the PPM pin of the connector. This is all what is needed to get serial working.

Pascal

QUERB, 2018-07-29:
I have bought the module just one year ago.
Ok, thank you for the details of the improvement. As soon as I have done the modification, I contact you back.

Bruno

QUERB, 2018-08-02:
I have done the modification on the module as described. The connectivity between the RX pin and the PPM pin is correct. Unfortunately, it doesn't work : the red led flashes as Slow blink. Which other improvement is possible ?
Thank you.

pascallanger, 2018-08-02:
There is no othe improvements... Like I said before you need to test the continuity from the socket PPM pin to the atmega328p RX pin.

QUERB, 2018-08-02:
There is effectively a resistor value of 2.3 kOhms.

pascallanger, 2018-08-09:
Are you sure you are configuring correctly the radio?
Is it ersky9x right?
The 9XR Pro has the capability to have 2 modules one internal and one external, you have selected and configured the external right and internal off?
You said in your first post that on position 0 the LED blinks to indicate no serial signal, what if you switch to 1 (restart the radio), is the module LED flash indicating no PPM signal as well?

QUERB, 2018-08-09:
I'm actually on holidays ; I will test it the next week and contact you back. Thank you.

pascallanger, 2018-08-21:
No comment since 12 days, I'm condidering it's working.

Closed 2018-08-21.

Thread 182 (2018-08-12):

No binding to esky F150 v2

labomat, 2018-08-12:
Trying to bind a Esky 150 micro heli v2 ("Airwolf") without success to a Taranis with iRangeX module.

Module is in serial mode (both red and green leds are solid).

Model settings:
External RF: Multi - Esky150
Version: v1.2.0.17
Tried the bind option on the tx.

On heli there is a blue led binking and after a few seconds a green led flashing.

On the deviation forum there is a discussion thread about different versions of the protocoll. Is the latest version used here?
https://www.deviationtx.com/forum/6-general-discussions/6446-esky-150x-which-protocol?start=80

pascallanger, 2018-08-12:
The protocol worksand is up to date. It's just that this little heli is not so easy to bind.
You need to bind at the right time. I can't remember exactly when but try at different time.
Also you have to do a specific stick movement to start the heli. It's in the doc of the heli.

pascallanger, 2018-08-21:
No comment since 9 days, I'm condidering it's working.

labomat, 2018-08-29:
No, unfortunately it's not. I tried every possible moment with no luck.
I also wrote to rcgroups where a guy could reproduce the problem: https://www.rcgroups.com/forums/showthread.php?3050896-Esky-f150-v2-can-bind-to-taranis-transmitter

pete9999, 2020-04-13:
Hi,
I also have this issue and cannot get the esky 150 v2 to bind...
I have a t16 pro v2 with internal multi module. tx is running 1.3.0.52 RETA for multi module
setup a new model in opentx
inputs to
ch1 Rud
ch2 Ele
ch3 Thr
ch4 Ail

mixer to same

tried using 4 ch, or 7 ch in multi setup to no avail.
tried adding in ch5,6,7 normally and then setting to zero as some have suggested.

Nothing will allow me to bind, Just get the flashing blue and green lights on heli..

Once the green and blue lights are flashing you can bind with the original transmitter so that appear to be the right time to bind, but the multi module wont.

Is this a problem with this protocol? or Can anyone suggest any other things to try or share a opentx model that works?

Thanks in advance

pascallanger, 2020-04-13:
It's a long time ago (couple of years) but I remember that the esky150 airwolf is a pain to bind. The bind with the original TX works each time because the heli already knows it...
You need to do the bind at the right time. If I remember correctly you have to power it on, wait for the LED pattern to change then only bind but if you wait too long it gives up, so it's all about timing. You also need to do something with the sticks to activate it which is indicated in the documentation if I remember.
I have a friend which has one (the one I used to reverse the protocol) but with the confinment I don't know when I'll be able to borrow it.
Pascal

pascallanger, 2020-04-13:
Just realized, could it be another version? The one I've worked on was esky150x airwolf.
If yes I need someone to send me the TX and heli so I can see what has changed and reverse the protocol if possible.
Pascal

labomat, 2020-04-14:
I think they made a new version some time ago -> v2

There are two major upgrades from ESKY F150X and it seems they changed something at the rc part:

1. Transmitter Upgrade
- Redesign the Tx appearance
- More reliable 2.4GHz Tech, not easy to interrupt
- Transmitter support up to 18 channel for future use
(F150 V2 just used 5 channel)
2. Structure Upgrade
- Tail Vertical Fin LED Light design
- Rotor Head upgraded that let the flight be more smooth
- Pushrod upgraded that let the control be more accurate
- CC3D Flight control upgraded that let the helicopter be more stable

pascallanger, 2020-04-14:
Without the remote and heli there is nothing I can do... If someone is willing to ship it to me I will have a look.

labomat, 2020-04-14:
I have the heli - is there something I can do from here? Taking some measurements?

pascallanger, 2020-04-14:
Do you a logic analyzer that you can connect on the SPI bus?
Can you open the TX to see what RF chip is being used (picture of the rf board)?

labomat, 2020-04-14:
The main chip is labeled (as far as I can read it):
N5 1822
QFAAH1
16 (or "0") 21CX

And yes, I have one of theses cheap usb logic analyzers - but not used it yet ... So I would giv it a try this evening if you can tell me what to measure.

pascallanger, 2020-04-14:
Can you do some pictures? Is the RF going out direct from this main chip?

labomat, 2020-04-14:
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

pascallanger, 2020-04-14:
Oh that's an arm + 2.4GHz in a single chip... So nothing to connect to for analyzing.
SDR is the only chance at this stage...
Can you see the receiver side components?

labomat, 2020-04-14:
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

labomat, 2020-04-14:
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

schwabe, 2020-04-14:
That is just a STM32 and a [flash](https://www.micron.com/-/media/client/global/documents/products/data-sheet/nor-flash/serial-nor/m25p/m25p16.pdf)

The rf chip is not in the picture. I might be on another board or the backside of that board.

labomat, 2020-04-14:
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

labomat, 2020-04-14:
Looks like the same as on the tx ...

pascallanger, 2020-04-14:
SDR is the only way at this stage...

pascallanger, 2020-04-14:
> That is just a STM32 and a [flash](https://www.micron.com/-/media/client/global/documents/products/data-sheet/nor-flash/serial-nor/m25p/m25p16.pdf)
>
> The rf chip is not in the picture. I might be on another board or the backside of that board.

Welcome back! Long time not seeing you around.

labomat, 2020-04-14:
So I guess it is not possible to get some information by analyzing the signaling between rf module and the rest of the system. I do not have any experience with sdr and do not have any equipment.
I ve seen some cheap sdr usb sticks on amazon - are they suitable for recording the communication between tx and rx?

schwabe, 2020-04-14:
@pascallanger I am still lurking and reading the mail from github but almost no time to really work on OpenTX/Multi :( The curiosity what RF would be on that board was strong enough to peek into this issue

labomat, 2020-04-14:
I asked the manufactorer about the protokoll - this is what he told me:

> Halo my friend, thank you for your support our product, for the old version protocol, we are using the fixed 2.4 frequency, so we heard many user can use their own receiver, but our F150V2 are using non-fixed frequency to avoid the lose control problem, the frequency will change every seconds, we are sorry to let you know we cannot provide you.
Does this mean it is generally impossible to use the 4in1 module for this heli?

pascallanger, 2020-04-15:
All protocols do frequency hopping... Their old protocol was using only 2 channels. FrSky is using 47 channels. So what they are saying is more that they don't want to give you the protocol they are using. I've never seen a company doing so anyway.
I'm using this SDR: https://www.analog.com/en/design-center/evaluation-hardware-and-software/evaluation-boards-kits/adalm-pluto.html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

labomat, 2020-04-15:
is it possible to send private messages here - in order to exchange adress data?

pascallanger, 2020-04-15:
Contact me by MP on RCGroups (hpnuts): https://www.rcgroups.com/forums/showthread.php?t=2165676&goto=newpost

pascallanger, 2020-04-16:
If you can't contact me on RCG, look at my GitHub's profile, my email is there. Or press the donate button, my email address is there as well.

labomat, 2020-04-28:
Another one unsuccessfully trying to bind the 150 v2 (different model but the same internal parts): https://www.youtube.com/watch?v=XmUIdMsBnZI&feature=youtu.be

pascallanger, 2020-04-28:
I'm not sure what you are looking me to do...
I've proposed you to ship me the heli+TX or I purchase the heli with a participation from your side. I haven't received an answer since a week or two.
There is nothing I can do on this protocol remotely which we know will be hard to reverse anyway.
Pascal

labomat, 2020-04-28:
Just stumbled upon this video - messaged you on rc groups.

pascallanger, 2020-05-05:
I've just received the heli. I haven't tried it yet but instead powered on the TX. I can see using SDR that the TX is transmitting on a large number of channels which we don't care at this stage. But the trouble I have is that I can't find any GFSK information in the signal. The 51822 MCU on the picture supports the 3 NRF24L modes (RF chip which the multi module has) and 2 bluetooth low energy modes. The bad news is that the signal I'm seeing does not match at all what a NRF sends where basically the phase is linear instead of jumping based on bit values.
I'm quite puzzled at this stage... I need to power on the heli to see if the TX is behaving differently but I'm not putting a lot of hope in it...

pascallanger, 2020-05-06:
Good news!!! I've finally figuerd it out!!!
They are running in NRF24L01 compatibility mode at 250Kb/s.
Here is just a preliminary analysis:
 - TX address: FA 87 5B 2C 5D
 - 3 unknown bytes: 41 08 00
 - 5 channels coded on 2 bytes: THR, RUD, ?, ?, ?. Range from 200=0x0C8 to 1000=0x3E8 and centered on 600=0x258
 - 26 bytes set at 0x00 -> could be 13 additional channels (18 in total)
 - CRC 2 bytes: I haven't checked but I assume it's the standard CRC
There does not seem to have any extra checks in the payload.

Left to do:
 - channel assignment: trivial
 - hopping frequencies: not so easy since it hops a lot but doable
 - catch a bind packet and analyse the bind sequence -> the TX does not stay long in bind mode which is going to make the task a bit difficult
Pascal

pascallanger, 2020-05-06:
The bind is out of norm... It is sent on channel 0 at 250Kbps but with 142 bytes payload... This is something a NRF can't do.
The bind contains:
 - Bind address: 73 73 74 63
 - 142 bytes payload!
    - repeat of bind address: 73 73 74 63
    - TX address: 87 5B 2C 5D
    - 3 unknown bytes: 41 88 41
    - 4 * 0xAA
    - 110 unknown values -> hop table??
    - 25 * 0x00
  - CRC 2 bytes

The CC2500 should be able to send all this data... But wow that's a lot of data in a single packet to decrypt...

Pascal

pascallanger, 2020-05-07:
Ok I can fly the heli using the multi module configured to use the original TX ID and hopping frequencies which the heli is already bound to.
Now the problem is to send the bind frame...

pascallanger, 2020-05-08:
Protocol fully reversed. It is available if you compile from master. I will do a release a bit later.

pascallanger, 2020-05-08:
Release: https://github.com/pascallanger/DIY-Multiprotocol-TX-Module/releases/tag/v1.3.0.95
Please test and report.
Pascal

labomat, 2020-05-09:
@pascallanger Binding and flying seem to work flawless! Superb work!

yakacm, 2024-08-11:
I've got this heli, but mine is the V3 version, I have tried the Esky V2 protocol on my TX16S MkII, Max, with built in 4-in-1, but it doesn't map the functions correctly, I can't get the throttle  to work whatever I try. Any ideas I could try?

pitts-mo, 2024-08-11:
I am not sure about your specific instance. However, throttle is often
restrained by channel position, calibration, or an Arming switch position.

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

yakacm, 2024-08-11:
Hey thanks for getting back to me, I thought about the arming switch, and I don't see anything, and moving all the switches has no effect. "throttle is oftenrestrained by channel position, calibration" could you elaborate on that, not too sure what you mean by, channel position or calibration.Thanks Andy.On 11 Aug 2024, at 17:24, pitts-mo ***@***.***> wrote:
I am not sure about your specific instance. However, throttle is often

restrained by channel position, calibration, or an Arming switch position.

On Sun, Aug 11, 2024, 10:45 yakacm ***@***.***> wrote:

> I've got this heli, but mine is the V3 version, I have tried the Esky V2

> protocol on my TX16S MkII, Max, with built in 4-in-1, but it doesn't map

> the functions correctly, I can't get the throttle to work whatever I try.

> Any ideas I could try?

>

> —

> Reply to this email directly, view it on GitHub

> <https://github.com/pascallanger/DIY-Multiprotocol-TX-Module/issues/182#issuecomment-2282784620>,

> or unsubscribe

> <https://github.com/notifications/unsubscribe-auth/AFNT6YB3NPNTCKCVAIM2D5TZQ52HNAVCNFSM6AAAAABMK2AUCCVHI2DSMVQWIX3LMV43OSLTON2WKQ3PNVWWK3TUHMZDEOBSG44DINRSGA>

> .

> You are receiving this because you are subscribed to this thread.Message

> ID: ***@***.***

> .com>

>

—Reply to this email directly, view it on GitHub, or unsubscribe.You are receiving this because you commented.Message ID: ***@***.***>

pitts-mo, 2024-08-11:
https://www.esky-rc.com/Uploads/202108/ESKY150V3_Manual.pdf

Suggest investigate throttle cut and the troubleshooting sections of the
manual.

Maybe see if you can find a youtube video that covers configuration of the
F150 (even older versions) in opentx/edgetx.

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

pascallanger, 2024-08-12:
150v3 flies perfectly fine. A friend as one and i've been able to configure it. The channels are not as described in my GitHub since for whatever reason they changed the order. I recommend removing the blades while playing with the config since his heli took off unexpectedly while I was figuring out the details.
I think I still have the model on my radio. If that's the case I'll post the quick config I did at the time.

yakacm, 2024-08-13:
Right oh guys, my E150 is now flying. I started again and created a new model, looking at protocol details up here on Github, where it mentions that Ch5 is rate, so I set a switch for channel 5, and then just took a guess at Ch6 being throttle cut, and that did it. I was only able to fly for about 20 seconds, before the batter needed charging, just because I'd spent so long trying to trouble shoot. Just charging the battery now, I'll need to buys some more. Anyway thanks Pascal and pitts-mo for your help, I didn't think I'd ever get this thing flying.

Closed 2020-05-08.

Thread 196 (2018-10-06):

Problems with s-fhss

michalelektryk, 2018-10-06:
I bought cheap Chinese airplane xk a700. It comes with its own controller, but not the great quality one.
So I thought I could use multiprotocol tx plugged into my turingy 9x to control it.
On the transmitter it says that it's s-fhss, so I rotated switch into 6's position, but I could not bind to aircraft, however I certain that my module works because I'm capable of steering my original tgy recovers without problem (they use flysky)

pascallanger, 2018-10-07:
The XK models perfectly work with Multi SFHSS. I have a XK600 and XK110.
Are you sure that you are really selecting the correct protocol?
Have you followed the right binding procedure on the plane (usually just press the bind button on the main board)?
Have you done the frequency tuning?

pascallanger, 2018-10-07:
"Plane going to autobind after powerup": this is most likely not the case with sfhss due to how the protocol is made... I would like to see close pictures from the main board.
Freq tuning: https://github.com/pascallanger/DIY-Multiprotocol-TX-Module/blob/master/docs/Frequency_Tuning.md

pascallanger, 2018-10-07:
Do you have this board: https://www.motionrc.com/products/xk-a700-receiver
If yes then it's not using a SFHSS protocol since what I see on the picture is an A7105. SFHSS is based on the CC2500. Both have a different pinout and even if I don't see the ref on the RF chip it matches the A7105 pinout and not the CC2500.

michalelektryk, 2018-10-07:
Yes, this one.
I took apart transmitter and it uses a7105, but on the box it says s-fhss so I thought I is emulated somehow

pascallanger, 2018-10-07:
Nope...
This board looks so similar to the F9x9 wltoys boards which are using flysky.
Have you tried to bind it using flysky?
Power up the board then power on multi in bind mode (dial should be set to flysky before booting...).

pascallanger, 2018-10-07:
All I can say is that it's not the FUTABA SFHSS protocol. Someone needs to dump the TX SPI bus to reverse the protocol.

michalelektryk, 2018-10-07:
Thanks for your help. Just last question. Could you give me any hints what's the fastest way to reverse enginner the protocol?

pascallanger, 2018-10-08:
You can check this link which shows you how to dump the SPI bus: https://www.deviationtx.com/forum/protocol-development/4595-spi-capture-guide
Once you have some dumps I can look at it.

michalelektryk, 2018-10-09:
For every one else with this problem. It's obviously an flysky, but after pairing use have to send special sequence on ch1-4, not sure what's exactly the sequence looks like, but for me putting all stricks in 1 extreme, a after that into the other worked

Closed 2018-10-07.

Thread 224 (2019-05-05):

Found correct protocol for DHD D4

marcfon, 2019-05-05:
I found that the [DHD D4](https://www.banggood.com/DHD-D4-Mini-Pocket-Drone-WIFI-FPV-With-720P-Camera-Altitude-Mode-RC-Drone-Quadcopter-p-1210848.html?ID=22342482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) binds with the Bayang STD protocol.

There's just a weird issue with the throttle. When you throttle up or down there is a lag of a few seconds. This doesn't seem to be the case with the other input controls.

pascallanger, 2019-05-06:
Humm a new version of the bayang protocol? We should be able to figure out what's going on if you still have the original TX but this will take me a couple of days before coming back to you...

marcfon, 2019-05-07:
I do have the original TX. And there's no rush from my side.

Would be glad to help out in any way I can so just let me know what you need from me.

By the way it's actually a really fun quad to fly! :)

pascallanger, 2019-05-08:
With the new Multi version v1.2.1.40, we can now look at your DHD D4 payload and see what's going on.

How to do it:
- create a new model on your radio with a custom protocol number 63, sub_protocol 1 (for 1Mb), RX_num=0 (scrambled) and option=-1 (scan RF channels)
- download the latest code, edit the file multiprotocol.ino and uncomment the line (remove the //) at the begining of the file: #define DEBUG_SERIAL
- connect the USB cable to your module and upload as usual the firmware but don't disconnect the USB cable
- open in the arduino ide the serial monitor: Tools -> Serial Monitor
- you will see a new window with a lot of information displayed and the module will start scanning (option=-1)
- power on your original TX and quad, wait for the bind to finish
- now look at the new window, you should find some valid frames being displayed for some channels
- choose one of the channel and set the value of option with the value
- you'll now start to see on the serial monitor window a lot of packets being displayed on this specific channel only
- play with throttle for a couple of seconds
- send me a copy and paste of the content of the full window (ctrl+a to select everything and then ctrl+c to copy)

To use you module normally, you must edit the file multiprotocol.ino and comment the line at the begining of the file (add //): #define DEBUG_SERIAL .

Waiting for you to try it out, Pascal

marcfon, 2019-05-09:
I've managed to get the debug output! It's quite a lot so I uploaded them here.

Method 1 (one key take off / landing)
https://pastebin.com/mpV3WZrZ

Method 2 (throttle to arm (props start spinning / throttle up to take off)
https://pastebin.com/5K7FiaLP

Not sure if it's relevant but I seems that there were 4 channels active during the scan.
Channel=72,0x48
Channel=74,0x4A
Channel=75,0x4B
Channel=80,0x50

pascallanger, 2019-05-09:
The Bayang protocol is using 4 channels so yes the 4 that you've found are the ones being used by your original TX.

I can see in your dumps:
 - packet period seems to be around 7770µs on channel 74, can you confirm that this is the same on other channels (it should be the same but just checking)? => Bayang has a period of 8000µs to come back on the same channel, that could explain the lag if the RX is strict but I doubt but why not...
 - packet[1] = 0xF4 -> Multi is sending 0xFA but your original TX must have different rates (low/medium/high or easy/expert or...) Can you switch to the highest rate to see which value you are getting on this byte?
 - packet[3] switches between 0x00 and 0x20 when you press the one key take off/landing which is accessible through a switch on CH12. Have you tested it?
 - packet[12] and [13] have a fixed value of 0x37 and 0xED which is not what Multi is currently sending (0xxx and 0x0A)

Can you dump the bind phase at the original TX power up on channel 0? It would be good to get this info as well.

The next phase when you'll have completed the couple of actions would be to add a new subprotocol to implement the differences and test if it does improve.
Pascal

marcfon, 2019-05-09:
Okay here's some additional info!

Let me add to this again that the lag only occurs with the throttle. The other controls respond as expected. I can make a video to show what happens if that helps.

Channel scan results.
https://pastebin.com/Tp2UxUtu

Bind phase. (Channel 0  = RXNum 0??)
https://pastebin.com/TBp5G7nC

There is rate setting on this drone (as far as I know). There are buttons fo video recording, photo taking, an emergency stop, headless mode and flips.

pascallanger, 2019-05-09:
Channel 0 is option=0. Your dump of bind phase has been done on channel 74 so it has only normal packets... Can you redo it?

> There is rate setting on this drone (as far as I know).

Can you press the button (multiple times if needed) on the TX to make it go to highest rate and then dump a normal packet (option=74)?

marcfon, 2019-05-09:
> Channel 0 is option=0. Your dump of bind phase has been done on channel 74 so it has only normal packets... Can you redo it?

Got ya! Here it is.
https://pastebin.com/g95pkhcF

> Can you press the button (multiple times if needed) on the TX to make it go to highest rate and then dump a normal packet (option=74)?

I meant to write there isn't a rate option.
Here is a [photo of the TX](http://www.hobbywow.com/desc/HR/rc3358/HR3358_24.jpg) with all the options.

pascallanger, 2019-05-09:
What does the accelerate and decelerate buttons do? isn't it rates? I see on BG this in the description: "It has 3-level flight speed to switch that can make more fun with the flying." which looks like a description of rates...

pascallanger, 2019-05-09:
Please try v1.2.1.41 using a custom protocol=14, sub_protocol=4, option=0.
Let's see if it fixes your throttle issue...

marcfon, 2019-05-09:
> Please try v1.2.1.41 using a custom protocol=14, sub_protocol=4, option=0.
> Let's see if it fixes your throttle issue...

Yes it does! The strange thing though is the STD Bayang subprotocol now also seems to do what it's supposed to do.

I've tested both 14/0 and 14/4 and there's no any noticeable difference. Was this a user error on my side?

You're totally right about the rates! I didn't know that. Do you still want me to have the dump for that?

And a question related to this... would it be possible to use a 3 position switch to simulate the +/- buttons on the original TX? I know that this is rather an OpenTX question but maybe you have some experience with this.

marcfon, 2019-05-09:
And to add to this I think it's good to share how that regular take off procedure works for this drone (so not the one key take off).

You have to throttle all the way up to arm. Then move the throttle back to the **middle**, now the props will start spinning. From here you throttle back up again to take off.

pascallanger, 2019-05-09:
> Yes it does! The strange thing though is the STD Bayang subprotocol now also seems to do what it's supposed to do.
> I've tested both 14/0 and 14/4 and there's no any noticeable difference. Was this a user error on my side?

This doesn't make any sense. Everything I've implemented for your D4 is conditionned on choosing 14/4. 14/0 is basically the same as before...

> You're totally right about the rates! I didn't know that. Do you still want me to have the dump for that?
Yes like this we know the values.

> And a question related to this... would it be possible to use a 3 position switch to simulate the +/- buttons on the original TX? I know that this is rather an OpenTX question but maybe you have some experience with this.

We usually always set high rates since on the radio you can apply some expo and dual/rate if you think it's too fast.

marcfon, 2019-05-09:
> This doesn't make any sense. Everything I've implemented for your D4 is conditionned on choosing 14/4. 14/0 is basically the same as before...

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

pascallanger, 2019-05-09:
???

marcfon, 2019-05-09:
> ???

Accidentally closed it. And now reopend again :-/

marcfon, 2019-05-10:
> Can you press the button (multiple times if needed) on the TX to make it go to highest rate and then dump a normal packet (option=74)?

Here is the dump file for the different rates. I switched from low to high during flight.
https://pastebin.com/ibjyJ1Sf

Is this the info you were looking for?

pascallanger, 2019-05-10:
Can you try Multi v1.2.1.46?
The quad should be in high rate.

marcfon, 2019-05-11:
> Low rate is 0xF4, Mid is 0xF7, High is 0xFA.
> Can you try Multi v1.2.1.46?
> The quad should be in high rate. If it works I won't touch it anymore.

I can confirm that the quad is in fast mode on v1.2.1.46.

Now I'll google how to set different rates using OpenTX :)

Thanks a lot for the help Pascal! Much appreciated.

Closed 2019-05-11.

Thread 226 (2019-05-23):

Missing Support/Documentation for "iRangeX IRX4 Lite"

boennhoff, 2019-05-23:
Aloha,
I bought an _iRangeX IRX4 Lite_ (from BG for the FrSky X-Lite Transmitter) and would love to flash it to the latest _Multiprotocol_ version, but I don't get it to work. It is working as of now, and I need it for my Whoops so I am very careful to not brick the thing.  :-)

My actual questions are:

### Flashing from TX?
Where do I find the Bootloader that needs to be installed on the X-Lite transmitter to eventually be able to do the famous _Flash from TX_? I found the *.app that needs to be run, but I can't load it with the default OpenTX Bootloader.

### Flashing over USB?
Connected over USB the board is recognized as a Maple Device (Dev Id similar to `1eaf:1003`) without flashing anything yet. So i assume there is a USB Bootloader (wrong?). But the method _Flash over USB_ is not working.
The Arduino IDE finds a Maple Device during _Upload_, utilizes the `dfu-util` that eventually fails (after a timeout)... The IDE strangely still acknowledges a successful flashing. The process was tested on Linux and Windows (USB pass-through to VM)).

### Flashing over Serial?
When trying to do the _Flash over Serial (FTDI) with Bootloader_, I also have no success. The LEDs flash differently than when trying the USB connection (only red LED blinking, instead of constant green and red blinking with USB). I also made sure that I really, really, really only use 3.3V when using this method. But the board actually asks vor 5V (see picture)... So should i try it out with 5V even if the Wiki is against that? Actually that is the only thing that I can think of, that I haven't tried yet...

What could I do? Any ideas? Is more information needed?
Sorry to bothering you guys and thank you for such an awesome product!

### Pictures of the HW
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

pascallanger, 2019-05-23:
> Flashing from TX?
> Where do I find the Bootloader that needs to be installed on the X-Lite transmitter to eventually be able to do the famous Flash from TX? I found the *.app that needs to be run, but I can't load it with the default OpenTX Bootloader.

Please check this part of the documentation: https://github.com/pascallanger/DIY-Multiprotocol-TX-Module/blob/master/docs/Flash_from_Tx.md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

> Flashing over USB?
> Connected over USB the board is recognized as a Maple Device (Dev Id similar to 1eaf:1003) without flashing anything yet. So i assume there is a USB Bootloader (wrong?). But the method Flash over USB is not working.

Can you elaborate on Dev ID similar? What's the exact Dev ID of your module?
It looks like the module has a bootloader but the firmware has not been compiled with USB serial...

> Flashing over Serial?
> When trying to do the Flash over Serial (FTDI) with Bootloader, I also have no success.

Unless Boot0 is grounded, you won't be able to update the firmware that way. When I look at your pictures, I don't see a trace going out from the boot0 pin but it could go under the stm32 so it's hard to say where boot0 is accessible (if accessible)...

Pascal

benlye, 2019-05-23:
Pascal beat me to it!

What he said, plus it would also be good to see the verbose output from the IDE when you attempt to upload.

boennhoff, 2019-05-23:
Thanks for the fast feedback. Somehow I have overseen that part of the [HOWTO](https://github.com/pascallanger/DIY-Multiprotocol-TX-Module/blob/master/docs/Flash_from_Tx.md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), thanks for pointing me to it. The alternative Xlite Bootloader works (V3.0) now, and I can run the `FlashMulti_xlite.app`.

But if I try to flash `Multi-STM_TXFLASH_INV_OPENTX-v1.2.1.39.bin` (I shortened the name to be able), it returns with the following result:

    Flashing Complete
    FAILED
    0000 0000

The version of the module stays at 1.2.0.22.

A kernel log excerpt after connecting over USB:

    kernel: usb 1-3.4.3: New USB device found, idVendor=1eaf, idProduct=0004, bcdDevice= 2.00
    kernel: usb 1-3.4.3: New USB device strings: Mfr=1, Product=2, SerialNumber=0
    kernel: usb 1-3.4.3: Product: Maple
    kernel: usb 1-3.4.3: Manufacturer: LeafLabs
    kernel: cdc_acm 1-3.4.3:1.0: ttyACM0: USB ACM device

Of course I also tried the Flash over USB method again, here the log output of the Arduino IDE (i used a screenshot to make clear how much the IDE let it look like a successful upload)
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

The kernel log suggest that the Device ID is `1eaf:0004`, but in the Arduino IDE it refers to `1eaf:0003`... I checked that twice, I selected the right port. I am pretty confused now, well at least I made some progress and the thing did not yet release any magic smoke :-) Heads up!

Is this piece of HW new to you guys?

boennhoff, 2019-05-23:
Tested again in the IDE, and with the Transmitter turned off, the Serial Device was different and the result also:
```
Maple device found. Attempting USB upload.
/home/chris/.arduino15/packages/multi4in1/hardware/STM32F1/1.1.1/tools/linux/maple_upload ttyS0 2 1eaf:0003 /tmp/arduino_build_347318/Multiprotocol.ino.bin
dfu-util 0.8

dfu-util: Invalid DFU suffix signature
Copyright 2005-2009 Weston Schmidt, Harald Welte and OpenMoko Inc.
dfu-util: A valid DFU suffix will be required in a future dfu-util release!!!
Copyright 2010-2014 Tormod Volden and Stefan Schmidt
This program is Free Software and has ABSOLUTELY NO WARRANTY
Please report bugs to dfu-util@lists.gnumonks.org

Opening DFU capable USB device...
dfu-util: Cannot set alternate interface
ID 1eaf:0003
Run-time device DFU version 0110
Claiming USB DFU Interface...
Setting Alternate Setting #2 ...
Waiting for /dev/ttyS0 serial...Done
```

Doesn't solve my confusion... Any idea on what's going on?

benlye, 2019-05-24:
Current thinking is that your module is running firmware without the USB code. To get it upgraded you may have to do some soldering so that you can connect an FTDI adapter, and somehow put the BOOT0 pin to ground (that will be the hard part).

I'll play around and see if I can reproduce your experience on a test board so we can be sure of what's going on.

The manufacturers don't give us hardware to work on so we haven't seen this one before.

Also, no one has asked about flashing this kind of module before, which makes me wonder if there's something strange going on with yours.

boennhoff, 2019-05-24:
> Current thinking is that your module is running firmware without the USB code. To get it upgraded you may have to do some soldering so that you can connect an FTDI adapter, and somehow put the BOOT0 pin to ground (that will be the hard part).

Where do you see the BOOT0 pin? I was looking for something like that, but couldn't determine it. I am open to tinkering and soldering, motivated but not a pro, so the complexity of the mod should not be overwhelming :smile:

> I'll play around and see if I can reproduce your experience on a test board so we can be sure of what's going on.

Awesome, thanks! If you need more input just tell me.

> Also, no one has asked about flashing this kind of module before, which makes me wonder if there's something strange going on with yours.

That's interesting since I found comparisons between this one and the Vantac MPM module, which is more expensive but not shielded. I would have assumed it's a better hacking target.

pascallanger, 2019-05-24:
Ben, there are some talks around 1eaf:0004 and resolutions if you look on Google. But may be you already checked?

benlye, 2019-05-24:
The different USB IDs mean different things `1eaf:0003` means that the board is in DFU mode, `1eaf:1004` means that it is in USB / tty mode.  The flash routine is trying to get the device into DFU mode before flashing it.

benlye, 2019-05-24:
Essentially what happens is the script looks for any Maple device, `1eaf:0003` or `1eaf:0004`.  If either is present it runs the `maple_upload` script which first tries to reset the device to DFU mode by sending a magic sequence to the serial port (`upload_reset` is called).  I think this is where it's gong wrong and for some reason the board isn't resetting to DFU mode.

So, we expect to see `1eaf:1004` when the board is plugged in, and `1eaf:1003` momentarily when it's being flashed or if there is no firmware on it.

When I get a chance (may be tonight / tomorrow)  I'll write out a full set of command line steps that we can use to try to see exactly what's going on.

@boennhoff you could always try running `upload-reset` to see what happens.  Do `lsusb` before and after to see if you get different USB device IDs.  You can get the binary [here](https://github.com/pascallanger/DIY-Multiprotocol-TX-Module-Boards/raw/master/source/stm32/tools/linux/upload-reset).  The syntax is like `./upload-reset /dev/ttyACM0 750`

boennhoff, 2019-05-24:
Okay, that enlightens the situation a little bit. I will definitely try that and report back.

I am also interested in the way the components play together, I can't get my head around it alone. How is the STM connected to the Radiochips? Where is the Bootloader located, are there different ones? Which component is taking over which part, booting, flashing, running applications. Why is there a Micro-USB port if the designer did not support any USB connection? What's the role of BOOT0?
Are there some explaining/teaching resources on that matter?

boennhoff, 2019-05-24:
Okay, the following happens (module is always in transmitter):

**Transmitter turned off, USB connected**
- Green LED steady, red LED blinking
- `lsusb` reports `1eaf:0003`
- `upload-reset` does not work because of missing /dev/tty*

**Transmitter turned on, USB connected**
- Green LED steady, red LED steady
- `lsusb` reports `1eaf:0004`
- `upload-reset /dev/ttyACM0 750` turns off green LED, red LED flashes, ~2s later the module seems to reboot, `lsusb` still reports `1eaf:0004`, a second try leads to an error because of missing serial device. reconnecting USB allows to repeat that step.

Hmmm, that result doesn't look like the expected one, does it?

benlye, 2019-05-24:
> How is the STM connected to the Radiochips?

Pascal needs to answer that one :)

> Where is the Bootloader located, are there different ones?

The bootloader is stored in the first section of flash memory in the STM32 chip.  We only use one, which is customized to support the USB connection and also flashing from the TX.

> Which component is taking over which part, booting, flashing, running applications.

The bootloader does most of that - it boots then hands over to the application.  When the bootloader is running the chip is in DFU mode, which is the state it has to be in to flash it.  The LED blinks rapidly when the bootloader is running.

> Why is there a Micro-USB port if the designer did not support any USB connection?

To make the USB port work two things are required - the USB-enabled bootloader, and application code which includes support for USB.  That your board is reporting as a `1eaf:0004` when plugged in actually suggests that you have both.  If you did not have the USB code the board would stay as `1eaf:0003`.  Most of the Multi board manufacturers do not ship their modules with the bootloader installed.

> What's the role of BOOT0?

Connecting BOOT0 to ground puts the board in a state where firmware can be written to it over the serial connection.  If BOOT0 is not grounded it is simply not possible to flash over the serial port.  Think of it as a failsafe - if we completely trash the bootloader and firmware we can use BOOT0 mode to recover the device via an embedded flashing method.

> Are there some explaining/teaching resources on that matter?

Probably the [STM32 datasheet](https://www.st.com/resource/en/datasheet/stm32f103c8.pdf).

benlye, 2019-05-24:
OK, those results are interesting.  It seems that powering the module from the TX is doing something interesting to it, and when we try to reset it to DFU mode it just switches back to application mode.  Powering it only via USB seems like the way to go.

Can you try:
* Power the module from USB only
* Run dfu-util to list the DFU devices: `dfu-util -l`

You'll find dfu-util in `/home/chris/.arduino15/packages/multi4in1/hardware/STM32F1/1.1.1/tools/linux/`

If you get output like `dfu-util: Cannot open DFU device 1eaf:0003` try prefixing the command with `sudo`.

benlye, 2019-05-24:
I think I may know what the problem is - permissions on the device.  If the list command works with `sudo` and fails without, it's a simple fix.

benlye, 2019-05-24:
Assuming my theory about permissions is right, run this command:
`sudo cp /home/chris/.arduino15/packages/multi4in1/hardware/STM32F1/1.1.1/tools/linux/45-maple.rules /etc/udev/rules.d/`

Then unplug / plug the module (keeping the TX off).

That udev rules file tells the system to set more permissive permissions on the Maple device when it is connected, both in DFU and USB mode.

On my system, where dfu-util wouldn't work without `sudo` the rules fixed the problem and I was able to flash using the `maple_upload` script.

boennhoff, 2019-05-24:
Doing the commands by hand is a good idea, I already stumbled about permissions in the first place, so maaaaaybe running them as sudo resolves my issue. But the `45-maple.rules` file won't help, it resides in the right place after my first attempts already -- the suggestion is somewhere in the wiki already :smiley:

Your suggestion without TX power puzzled me, because then I don't have a serial device (/dev/tty*), isn't that needed to upload at all? Isn't that needed by `dfu-util`?

benlye, 2019-05-24:
I still think it might be permissions related, the sudo test will tell us for sure.

dfu-util doesn't use the tty device, it finds the DFU device by USB ID.  does `sudo dfu-util -l` give you any output when powering the module just with the USB cable?

benlye, 2019-05-24:
A quick way to see if the udev rules are actually working is `ls -al /dev/maple` with the device plugged in.  The rules create a symlink at that path which will only be present if things are working correctly.

boennhoff, 2019-05-24:
**Wohooooo, success!** I stumbled over several more strange behaviours (contradicting my last tests somehow), but now it (more or less) reliably let itself flash. Only method that worked so far was: module sticking on TX, TX off, USB powered, if the Dev ID is `1eaf:0004` and there actually is a device like `/dev/ttyACM0` after connecting.
What did i change/test:
- I rebooted (USB errors when doing more tests, suspended inbetween, suspect some USB problems here)
- I tested the module without being in the TX at all
- I used the failing command from the Arduino IDE prefixed with `sudo` whcih finally showed me the upload progress bar!

Just a second ago, it also worked throught Arduino IDE w/o special permissions, the first time. I am happy and sad at the same time, I just don't understand what went/is wrong. The permission problem was a reason for me to test it within Windows... I am really stuck right now.

I also tested _Flash from TX_, but it still fails. I guess that stays like that until I am able to flash the module bootloader, right?

What version do you guys normally flash? The latest tip of master?

How do you want to continue? I am actually happy now, but I am willing to help to analyze more and eventually update the Wiki for others to not have the same problems.

boennhoff, 2019-05-24:
> A quick way to see if the udev rules are actually working is `ls -al /dev/maple` with the device plugged in. The rules create a symlink at that path which will only be present if things are working correctly.

That is true, `/dev/maple` exists.

Another test without the module being in the TX succeeded also this time. Does the actual application influence the flashing mechanism? I don't get why it is so easy now...

boennhoff, 2019-05-24:
> dfu-util doesn't use the tty device, it finds the DFU device by USB ID. does `sudo dfu-util -l` give you any output when powering the module just with the USB cable?

Nope. It does return no output. Just recognized i have dfu-util v0.8 with the IDE and dfu-util v0.9 within my Arch system. Both give same result.

benlye, 2019-05-24:
> I also tested Flash from TX, but it still fails. I guess that stays like that until I am able to flash the module bootloader, right?

I'm not sure why that's not working.  The module has a bootloader (otherwise you wouldn't see the Maple USB devices), and the installed firmware has the right code for sure now that you've flashed it.  It might be something you can ask about on the ersky forums.

> What version do you guys normally flash? The latest tip of master?

Yes.

> How do you want to continue? I am actually happy now, but I am willing to help to analyze more and eventually update the Wiki for others to not have the same problems.

If you have a method that works then it's worth adding it to the documentation.  It might be worth just mentioning that you had more success with the module outside the TX.

> Another test without the module being in the TX succeeded also this time. Does the actual application influence the flashing mechanism? I don't get why it is so easy now...

It's possible that now that you've flashed it with the main branch firmware the behavior has changed because the old firmware was doing something weird (who knows what iRangeX may have done to it!).

> Nope. It does return no output. Just recognized i have dfu-util v0.8 with the IDE and dfu-util v0.9 within my Arch system. Both give same result.

I'm guess that it's running in USB mode now (`lsusb` shows the `1eaf:1004` device) so I'd expect that.  You'd need to get it into DFU mode with `upload-reset` to see it as a DFU device again.

I suspect that there was a permissions problem accessing the device under Linux, and also that with it's original firmware your module behaved unusually when powered from the TX.  If you had tried to flash from Windows with the module only connected to USB (TX powered off) it might have worked right away - it's not clear if that's a test you tried?  The Linux reboot may have kicked udev into processing the rules file properly.

Anyway, glad you got there in the end!  Feel free to close the issue.

lad1337, 2020-08-06:
i know this is old but if someone ever finds this and want to flash the irangex irx4 lite with a UART / TTY
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

The STM32 BOOT0 is exposed, i soldered the orange breadboard cable to it.
And connected to to VDD (3,3v)

i then flashed it with https://github.com/benlye/flash-multi (on mac via cli)

pascallanger, 2020-08-06:
It's already in the doc: https://github.com/pascallanger/DIY-Multiprotocol-TX-Module/blob/master/docs/Compiling_STM32.md

pascallanger, 2020-08-06:
And I'm not sure why you would want to flash it using serial anymore since we have a bootloader update tool using USB using Flash Multi.

lad1337, 2020-08-06:
> And I'm not sure why you would want to flash it using serial anymore since we have a bootloader update tool using USB using Flash Multi.

I had version 1.2.0.22 and did not appear as any device on my computer.

Now I see it in the docs https://github.com/pascallanger/DIY-Multiprotocol-TX-Module/blob/master/docs/Compiling_STM32.md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
Additionally that my method might have fried the RF if I had used 5,5v.

Thanks for all the work you do!

Thread 235 (2019-06-07):

FS-IA6B (AFHDS 2A) unknown telemetry

AndreBL, 2019-06-07:
Hello.

I got a brand new FS-IA6B receiver from banggood.com and it is showing some unknown sensors in the telemetry screen of OpenTX 2.2.3. The new unrecognized sensor IDs and data as show in OpenTX screen are below:
00FD 70
00DE 65535

I noticed that this value "70" is the PWM frequency setting (I changed mine from default). Changing the PWM frequency to 65Hz made the value for ID 00FD change to 65 accordingly. As for the second ID, I have no clue about. Since 65535=0xffff, it might mean something that is empty.

Other facts:
1) The above IDs are not updated as often as known sensors. The asterisks near those values flash only once every few seconds.
2) When the asterisks for these unknown sensors flash, the value for the RX voltage sensor gets corrupted with a negative number. It is hard to notice on the screen because it happens very briefly, but if you have a logical switch taking care of alarming low RX voltage, it catches the glitch.

pascallanger, 2019-06-07:
OpenTX code is not ready to receive extended afhds2a telemetry. I'll see if I can make the extended telemetry frames becoming invalid if not I will turn it off...

schwabe, 2019-06-07:
I did not know about them at the time when I implemented the code. Is there a documentation how the extended frames look like?

pascallanger, 2019-06-07:
Hey Arne, that's been a long time!
I've sent you an email some time ago (May 12th) about the extended telemetry and also posted on the OpenTX issue but I haven't heard back on any so I was planning to work on it this WE (been really busy lately).
I think the way I've currently hacked it won't work since it's not future proof. But I don't know how to best implement it since I don't know how OpenTX exactly works in the backend to handle telemetry so why I sent you the email earlier and why I was going to look myself which is probably good anyway ;-)

There are 2 type of sensors. The one that currently OpenTX knows about are structured always the same way 4 bytes : sensor ID, sensor number, 2 bytes value. But there are other type of sensors which are sending sensor ID, sensor number, length and payload.

From a communication standpoint with the RX I know which format is currently being sent so I can pass it to OpenTX, what I don't know from an implementation perspective is if I should:
 - add a new telemetry type 0x07 (current telemetry is 0x06)?
 - add an extra signaling byte at the end of the current telementry 0x06 frame I'm sending only if it's extended telemetry.
What I'm looking for is a way to integrate without breaking current install base. Option 1 and 2 should not do anything bad since both should be ignored right?
Option1: I'm not sure what the implivations are to receive telemetry type 6, 7, 6, 7, 6, 7....

One sensor is for example the altimeter sensor:
T= 41 01 04 08 86 49 13 FF FF FF FF FF FF FF FF FF FF FF FF FF FF FF FF FF FF FF FF FF
41 01 04 08 49 13 => Sensor ID: 41 -> presure sensor, Sensor #: 01, length in bytes 04, data: 08 86 49 13
Temperature= ( ((0x13498608)>>19) -400)/10 = 21.7°C

schwabe, 2019-06-07:
Hm, I did not get your email, did you send it to my normal email address? And I completely missed also the issue. Sorry about that. Don't have so much time for RC in last year unfortunately.

For the current stuff, I think using a different telemetry type is the best option.

I wonder if we should for future protocols switch to let Multi do the parsing which avoid having duplicating the code/waiting on new OpenTX releases. Kind of like we did in the past with mapping to Frsky S.port telemetry but without needing to match an existing Frsky sensor and all the uglyness that comes with that. That would also have the benefit of avoiding Frsky patent claim they currently make on the S.port protocol.

Instead we could be adding a new telemetry type like MultiTelemetry or OpenTX telemetry that allows Multi basically to directly push its values to OpenTX.

So OpenTX internally treats all sensor as having some id, some unit and some value. It matches very closely the Frsky protocol. So all the sensor parsing code maps from the raw telemetry to this tuple.

Function is

setTelemetryValue(TelemetryProtocol protocol, uint16_t id, uint8_t subId, uint8_t instance, int32_t value, uint32_t unit, uint32_t prec)

And there is another function to set the name which is 4 byte

So basically
- 32 bit id (split into id, subId, instance)
- 32 bit value
- What unit the telemetry value has (e.g. volt/mah/etc...)
- precision (like * 1/100, or 1/10), basically the number of precision digits
- 4 String name.

What do you think of that approach?

AndreBL, 2019-06-07:
I already had a bunch of crude workarounds for sensor values because I didn't want to start messing with OpenTX and Companion codes. Just added another one and my telemetry screen is now clean with the new receiver.

```
#ifdef AFHDS2A_FW_TELEMETRY
if (option & 0x80) {
    //Workarounds start here

    // 0xAA Normal telemetry, 0xAC Extended telemetry not decoded here too
    if (packet[0] != 0xAA)
        return; //This line doesn't appear to stop the unknown sensors from the new ia6b

    for (uint8_t sensor = 0; sensor < 7; sensor++) {
        uint8_t index = 9 + (4 * sensor);
        switch (packet[index]) {
        //RSNR: offset workaround for Companion allowed RSSI range
        case AFHDS2A_SENSOR_RX_SNR:
            if (packet[index + 2] > 0)
                packet[index + 2] += 20;
            break;

        //RQly: quality instead of error rate workaround
        case AFHDS2A_SENSOR_RX_ERR_RATE:
            packet[index + 2] = 100 - packet[index + 2];
            break;

        //Unknown packet from new ia6b workaround
        case 0xFD:
            return; //discard
            break;
        }
    }
    //Workarounds end here

    // forward 0xAA and 0xAC telemetry to TX, skip rx and tx id to save space
    pkt[0] = TX_RSSI;
    debug("T=");
...............
```

pascallanger, 2019-06-07:
I'm cautious of the flash size. I'm afraid that it will eat up a lot of space to decode the sensors for every protocols... It's becoming really tight on the STM32 especially when I enable debug.
Just too many protocols and I have 3 others in progress.
On the other hand, people won't have to upgrade their radios. I'm not certain what's the right thing to do here.

AndreBL, 2019-06-07:
I may be biased giving my opinion, but I'm happier with a module which has near full support for a few mainstream RC protocols with a variety of compatible receivers rather than a module with one thousand model-specific protocols for toy-grade drones, each one with special buttons and other obstacles taking the space. :)

pascallanger, 2019-06-07:
That doesn't really count here unless I'm mistaken.
If the module decodes the telemetry or the radio in the end you don't really care...
What you care is to have the information displayed on the radio. Therefore the only factor might be for you: will it be faster to get it implemented by the OpenTX team or me?

"near full support for a few mainstream RC protocols": most of the time I don't have the hardware to work and therefore wasting tons of time. For afhds2a I only have a receiver to work with and no sensors. I can't just buy every stuff to reverse it which makes it hard to add full support...

geileraupe, 2019-06-10:
HI Pascal
Here i have a voltage sensor.. If this helps i can send it to you.. I must look after a vario sensor ... if i can get some ..

pascallanger, 2019-09-19:
Issue is fixed in Multi 1.2.1.78
Full Flysky AFHDS2A telemetry will be soon in OpenTX 2.3 (hopefully 2.3.1).
Pascal

Closed 2019-09-19.

Thread 237 (2019-06-11):

Xlite Pro and Vantac MPM lite

Talha909, 2019-06-11:
I have purchased the Xlite pro and Vantac MPM. I update the both devices.  I am facing one issue. My multi module did not come online when I turn on the TX. I have to switch between the models. I do this three of four time after that I saw green lite on my MPM. I need to switch an other model then I also have to switch between the models to come online.

fabioeh, 2019-06-11:
Having same Issue.

MPM Vantech module Fails to go online. Status light turns Red. Will not Bind.

Setting External RF to off and reselecting MULTI brings the MPM module online and the Status light turns green. Turning radio off and on will not bring MPM online.

Using DSM x22 protocol.

MPM ver 1.2.1.51, Opentx N21, FRSKY PMU Firmware 190605

schwabe, 2019-06-11:
Yes, basically Frsky managed to break their own module: https://github.com/opentx/opentx/issues/6481

pascallanger, 2019-06-11:
From what I understand, the module is powered but does not boot each time, correct?
If it's true then I think the issue is the bootloader of the Vantc MPM. Do you know which version it is running?
Are you able to flash the module using serial while strapping boot0? By doing so, you could try to remove the bootloader using the upload method "Upload via Serial (FTDI)" or upgrade the bootloader to the latest version using "Upload via Serial incl Bootloader (FTDI)".

Talha909, 2019-06-11:
I have yesterday flash the new version of Multi Module Multiprotocol v1.2.1.59. I flash the Module through the Usb method. The bootloader is already installed.  Please suggest me what should i do now.

Talha909, 2019-06-11:
And how i check the bootloader version.

pascallanger, 2019-06-11:
You need to use a ftdi like I've said before. Try to flash the firmware without the bootloader to see if it solves your issue.

Talha909, 2019-06-11:
Thanks .  One thing more.  I have FTDI of 3.3 volt.  can i gave power to my MPM with the ftdi. I dont wana use xliter pro. Because when I opened the MPM then its difficult to put back in xpro lite.

fabioeh, 2019-06-11:
The MPM boot loader that is part of the .59 release?

Has it been modified for the x light pro?

Is it used to power on the module.?

If so who is going to fix the boot loader ?

OpenTX said it was the MPU in the pro.

fabioeh, 2019-06-11:
With 3 companies pointing fingers how are we going to get this working.

OpenTX has no production X-light-pro to try this on. They only have prototypes that work and do not have the MPU.

fabioeh, 2019-06-11:
Looks like only customers have the production pro but not the software developers.

pascallanger, 2019-06-12:
> Thanks . One thing more. I have FTDI of 3.3 volt. can i gave power to my MPM with the ftdi. I dont wana use xliter pro. Because when I opened the MPM then its difficult to put back in xpro lite.
If you are sure that your FTDI is outputing 3.3V (check it with a voltmeter) then yes go ahead. Also make sure that you only power it while the boot0 jumper is in place otherwise I fear that your FTDI won't be able to support the current request of the module.
Use the method "Upload via Serial (FTDI)" which will get rid of the bootloader. If it works then we will move to the next step.

Talha909, 2019-06-12:
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

One stupid question. How can i check that its work or not.  I will flash it with v1.2.1.59.

pascallanger, 2019-06-12:
Latest version is 1.2.1.61, try to upload this one with the method "Upload via Serial (FTDI)". If you see the new version then you know you flashed it correctly and if the correct method has been used the bootloader is gone which means that USB won't work anymore when you plug it to the PC which will appear as an unknown device.
Yes you'll be able to install the bootloader again, we are troubleshooting here.

Talha909, 2019-06-12:
I did not see the latest firmware. I only see the v1.2.1.59. How can i download the latest firmware.

pascallanger, 2019-06-12:
> The MPM boot loader that is part of the .59 release?

When you flash v1.2.1.xx you only flash the firmware not the bootloader. The bootloader is only flashable by using a FTDI.

> Has it been modified for the x light pro?

No, I'm trying to troubleshoot the issue. I've never seen a x-lite pro, no idea what they've done to the power on this remote, no idea what bootloader firmware they are shipping with the Vantac multimodule since I don't even have one and so on...

> Is it used to power on the module.?

The bootloader is the first thing executed, it could wrongly see commands at power up on the serial pin putting it in programmation mode instead of booting.

> If so who is going to fix the boot loader ?

Anyone who wants to particpate, the bootloader is open source: https://github.com/MikeBland/StmMultiBoot

> OpenTX said it was the MPU in the pro.

Yes and is that helping you?

> With 3 companies pointing fingers how are we going to get this working.

I'm not sure which companies you are talking about... There is only one company here FrSky producing and selling the transmitter and module hardware. For the multimodule, I'm the really the main dev doing this on spare time and not sponsored in any form. This is why you can see on my github page a donnation button: https://github.com/pascallanger/DIY-Multiprotocol-TX-Module/blob/master/docs/Donations.md . FrSky, iRangeX and Jumper are all selling the hardware with our software on it without giving in return.

> OpenTX has no production X-light-pro to try this on. They only have prototypes that work and do not have the MPU.

I have no link with FrSky in any form so not receiving any product to test from them. And guess who needs to take care of their customers?

> Looks like only customers have the production pro but not the software developers.

We have to purchase the hardware like you and guess what I just can't afford it!!!
Same goes with all the models, a lot of people are asking for new protocols but how to add a protocol without having the hardware and when you ask for something you don't even get an answer...

Pascal

pascallanger, 2019-06-12:
> I did not see the latest firmware. I only see the v1.2.1.59. How can i download the latest firmware.

Follow the standard process:
https://github.com/pascallanger/DIY-Multiprotocol-TX-Module/blob/master/docs/Compiling_STM32.md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

Talha909, 2019-06-12:
XLITE PRO ON OPEN TX N20 FIRMWARE
MPM Lite on v1.2.1.60

Today I fond one interesting ting.  I have installed two models. One is D8 and other one is D16.  When switch on D16 mode then MPM comes online .  But when I switch to D8 mode. The green light and red light start continues. I switch between models 5 times from D16 to D8 . After 5th try its comes online on D8 Mode. But from D8 to D16 its comes online on first time. I repeat the same process 5 times and result was same. From D16 TO D8 its takes 5 or 6 time switching and from D8 to D16 Its comes on first try or in 2nd try.

pascallanger, 2019-06-12:
Have you tried without the bootloader?

Talha909, 2019-06-12:
Not yet. I will go to market in evening and solder the pins from the person.  then i will update it .  I am not good in soldering.

Talha909, 2019-06-12:
I have try the update the MPM withe ftdi and its works fine. Now please tell me how can i update the bootloader

Talha909, 2019-06-12:
thanks man. Its works now.

pascallanger, 2019-06-12:
To write back the bootloader and firmware just use the option serial including bootloader.

Talha909, 2019-06-12:
thanks man.

pascallanger, 2019-06-12:
You can always donate a little something if you are happy 😉

CDM040971, 2019-08-31:
Hi Folks,
The solution above is not clear to me. I have the issue described in this article.
Running MPM Lite Module
Tried with both firmware versions:
-> Multi-STM_TXFLASH_INV_OPENTX-v1.2.1.71.bin
-> Multi-STM_TXFLASH_INV-v1.2.1.71.bin
Still on radio boot up with module selected with Internal RF Disabled and External RF MPM Lite Enabled - Red Light - No Telemetry - startup always fails.

To activate MPM Lite RF I do this:
Select a Model with Internal RF Enabled - done - then go back and switch to a Model with External RF Enabled and the MPM Lite activates - green light!

I have Taranis x9-Lite Radio with OpenTX 2.3 Night ver N73

Please let me know how to fix the issue so that at boot up, the External RF - MPM Lite module activates.

pascallanger, 2019-08-31:
You need to update the bootloader to the standard one. I don't know which bootloader FrSky is shipping but it does not work correctly.
To do this you need to open the module and use a 3.3V FTDI to flash the module.

Talha909, 2019-08-31:
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

Its very easy. I have the same issue but issue was resolved with the help of pass. do you have facebook Id. I can help you for the flash of the new firmware.

CDM040971, 2019-08-31:
Hi Talha909, My FB ID is at https://www.facebook.com/chrisdmeyer or email via ChrisDMeyer@gmail.com.

Thank you kindly.
Chris

CDM040971, 2019-09-01:
Hi Talha,

I have found I need to switch models exactly 5 times before the green light shows. So frustrating. I also don’t have the 3.3v flash unit. So hopefully your solution works via direct USB connection. Cheers. Txs. Chris.

pascallanger, 2019-09-01:
USB connection can't flash the bootloader. You need a 3.3V FTDI. it's only a couple of $....
Pascal

CDM040971, 2019-09-01:
Hi Pascal.

Will this product work for what I need to do.
https://buzzfpv.com.au/ftdi-5v-micro-usb-turn-to-ttl-mwc-cp2104-debugger-programming-unit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

pascallanger, 2019-09-01:
No you need a FTDI which would work in 3.3V, this one $1.68 is what you are looking for: https://www.banggood.com/FT232RL-FTDI-USB-To-TTL-Serial-Converter-Adapter-Module-For-Arduino-p-917226.html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

Talha909, 2019-09-01:
i have added you in facebook. but you r not on line

CDM040971, 2019-09-01:
Thank you Pascal.

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
--
________________________
Chris Meyer LinkedIn <https://www.linkedin.com/in/christomeyer1/>
+61 44 888 7480

CDM040971, 2019-09-01:
Hi Talha. I live in Perth Australia. Your message came through at midnight 😀 I can be available at the time of this message tomorrow? Which is 6am here. As Pascal has mentioned I’ll be ordering the TDFI board from Banggood which takes 25 days for delivery.

pascallanger, 2019-09-02:
It was only an example, you can use other sources which might be faster but you need to make sure that it can do 3.3V

CDM040971, 2019-09-02:
Thanks Pascal. As soon as I get it I’ll reach out. 👍😎

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
--
________________________
Chris Meyer LinkedIn <https://www.linkedin.com/in/christomeyer1/>
+61 44 888 7480

CDM040971, 2019-09-09:
Hi Pascal,

I received this module.... can this work? Its a ST Link V2 STM8/STM32 programming unit.

https://core-electronics.com.au/st-link-stm8-stm32-v2-programmer-emulator.html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

Thank you
Chris

pascallanger, 2019-09-10:
No it won't work... You need a standard USB to serial adapter (FTDI).Pascal

CDM040971, 2019-09-10:
Hi Pascal, Talha,
Your guidance has helped me be successful and now my MPM Lite module works every time.
I have captured some working notes and shared them here to help anyone else.
With your approval Pascal, if not approved. Please delete my post.

Thank you kindly.
[Avantac MPM Lite Red LED Issue.docx](https://github.com/pascallanger/DIY-Multiprotocol-TX-Module/files/3594841/Avantac.MPM.Lite.Red.LED.Issue.docx)

Closed 2019-06-12.

Thread 244 (2019-07-22):

Bank ID not stored in EEPROM in STM32 PPM mode

OpenUAS, 2019-07-22:
Using module iRangex 4in1 Plus, setting the bank with bind button via module yellow knob on pos 15, one sees the LED blinking 1, twice till 5 if bind is pressed. After rebood always first bank.

Using Arduino IDE 1.8.5 and 1.8.9, code update of boar to 1.1.4 make all no difference. using GCC 4.8.x (2014) official under Ubuntu GNU/Linux 16.04 64bit

Having the Serial debug cable connected to module to investigate gives in terminal:

```
Multiprotocol version: 1.2.1.67
Protocol selection switch reads as 6
Using bank 0
Generated ID from STM32 UUID
...
```
etc.etc.

Added some extra debugging code, the read bank result was always 0xFF en the code then resets the bank to 0 again.

Not the only one with this issue looking at forums and some youtube comments read somewhere.

Still investigation to see where it goes wrong, running through full source. E.g. maybe EE_ADDR uint16 on STM32 and not uint8_t and then sdome bitshifting is messed up maybe...

Have all TX modules in existence to debug more, JTAG debug, logic analyzer, the work but rather not go that way ATM...sigh... just wanted to revive two MX22 TX with PPM and add some protocol. If debug needs, have dozens of various TX's to test on, old PPM till new Taranis X9D etc.
It just came bit as a nasty surprise, to use it and basic DSMX binding even not to work. Well... will see to find some time to debug more, in the mean time a hint welcomed.

For now the personal dirty workaround is to set the protocols needed on bank 1 via specific crafted `_MyConfig.h`

pascallanger, 2019-07-22:
Hummm, I'm on vacation right now so I can't test but the output above shows that even the ID is being regenerated where it should be done only once for all.
Have you tried to look at the "boot" output without reflashing the module? The goal is to see if it does generate a new ID again just when you powercycle it.
The thing I'm wondering is that if when you flash the module the full flash is erades then the eeprom content is lost.
Pascal

benlye, 2019-07-22:
I just checked the 64-bit Linux upload scripts.  For some reason they don't match the 32-bit scripts, and don't include changes I made some time ago to preserve the EEPROM during a flash. Either I never made the changes there, or they got overwritten at some point.  I'll get that fixed.

@OpenUAS, can you try copying `serial_upload` and `serial_upload_inc_bootloader` from `~/.arduino15/packages/multi4in1/hardware/STM32F1/1.1.4/tools/linux` to `~/.arduino15/packages/multi4in1/hardware/STM32F1/1.1.4/tools/linux64` ?

(The path may be different depending on your installation).

The scripts from the `linux` folder will preserve the last 2KB of flash space when flashing, thus preserving the EEPROM.  This may not solve the original problem, but will help to debug as your EEPROM won't get erased every time you flash the module.

OpenUAS, 2019-07-23:
@pascallanger enjoy the Holiday, mighty fast response though, thx. And yes at boot the ID get regenerated. So likely also no storage there.
@benlye thanks for the hint will try and add results here...

pascallanger, 2019-07-23:
I'm really puzzled... If that was the case I would have thousands of reports since some models must have some data stored in the eeprom or they won't work at all.
Can you dump your eeprom after flashing the module and after a power cycle? https://github.com/pascallanger/DIY-Multiprotocol-TX-Module/blob/master/docs/Advanced_Topics.md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
Pascal

OpenUAS, 2019-07-23:
No luck. copied upload scripts to linux64,..
Compiled, flashed via FTDI ....powerdown TX, switch set to 15 to set bank, for example set to bank 2..., Powerdown, Switch to 6, just a random protocol one... Restarted once more to see if ID get regenerated and is regenerated AFAIK since the output is like:

```
Multiprotocol version: 1.2.1.67
Protocol selection switch reads as 15
Using bank 0
Using bank 1
Using bank 2
Multiprotocol version: 1.2.1.67
Protocol selection switch reads as 6
Using bank 0
Generated ID from STM32 UUID
Module Id: 6862ee3f
Protocol selected: 28, sub proto 0, rxnum 2, option 0
Init complete
Multiprotocol version: 1.2.1.67
Protocol selection switch reads as 6
Using bank 0
Generated ID from STM32 UUID
Module Id: 6862ee3f
Protocol selected: 28, sub proto 0, rxnum 2, option 0
Init complete
```

Will debug more in a few days, but need testflying with the specific "dirtyfix", only the needed protocols in first bank. Also setup with a fixed TX ID since 2x the same for UAS EVLOS (Extended Visual Line of Sight) handover flightstest.

OpenUAS, 2019-07-23:
@pascallanger previous post was still being typed..., before I've read the post before 3 minute difference ;) Will see to dump the eeprom

benlye, 2019-07-23:
I double-checked in my 64-bit Linux VM and it looks like the scripts get called from the /linux/ folder, but the binaries get called in /linux64/, so the scripts being out of sync wasn't the problem - the EEPROM will be getting preserved through flash cycles.

I also checked my development board and I do **not** see the module ID getting regenerated every boot.  I did a full erase (including EEPROM) then flashed via serial with SERIAL_DEBUG.  I got the UID generated on the first boot, then it gets read from EEPROM after that.

@OpenUAS, I wonder if your EEPROM data may be corrupt.  You could try erasing the entire board with stm32flash (which is in the linux64 tools folder):
`stm32flash -o /dev/[your serial port]`

Then re-upload the firmware using the IDE.

OpenUAS, 2019-07-23:
@benlye Ran EEPROM test app, that worked, just to be on safe side erased with -o...
Bank select works now :tada: .
So somehow EEPROM got corrupted and would be the likely cause.

@pascallanger @benlye Thanks to your hints can now get onto some overdue pressing task now.. :fireworks:

pascallanger, 2019-07-23:
Too bad... It would have been great to see the content of the eeprom section which could have helped to understand what's going on and may be implemented a work around.
BTW what's the eeprom test app you are mentioning?
Pascal

Closed 2019-07-23.

Thread 246 (2019-07-26):

Frsky x-lite remote control uses AFHDS2A protocol, telemetry voltage problem

Rayenchen2353, 2019-07-26:
After I installed the MPM lite High frequency head on the frsky x-lite remote control（opentx2.2.3）, after using the AFHDS2A Binding receiver as shown in the attached figure, the sensor found three data, TRSS, A1 and RQly. I found that A1 is Indicates the receiver battery voltage. My receiver is a 1S battery directly connected to the receiver. It always shows the voltage of 5.11V, and it will not change. I originally thought that the voltage is the operating voltage after voltage regulation, but I am in the flysky i6X remote control. The return voltage received by the receiver on the frequency is the normal 1S battery voltage.

Attached pictures are stored in the google cloud disk：
https://drive.google.com/open?id=1lOqqR0hN8fGwfmONiSyGIthzgi5D3kml
https://drive.google.com/open?id=1OQikxO12sKafPlLzov5OMAO-Pu5b4dJX
https://drive.google.com/open?id=1sivGaDpjZ2oMzBMEvcvuI4HQ7XBO25I7

Why does the voltage of the telemetry return does not change?

pascallanger, 2019-07-26:
Your module version is quite old, could you update it to the latest version: https://github.com/pascallanger/DIY-Multiprotocol-TX-Module/blob/master/docs/Compiling_STM32.md
You are confirming that you are not just looking at the voltage value but you tried to charge the lipo to see if the value is decreasing? I'm saying this since the voltage value needs to be calibrated on OpenTX to display it correctly.

Rayenchen2353, 2019-07-26:
Because the voltage value has not changed
Even when pushing the throttle and the motor load is 100%, the voltage value has not changed. I think even if there is no calibration, the voltage will not change.
And using a voltmeter to check the battery voltage before and after using it for a period of time is definitely a change

I will try to upgrade the version and still exist when viewing the problem.

Rayenchen2353, 2019-07-27:
After upgrading to v1.2.1.67, the telemetry voltage value A1 still does not match the actual voltage.

pascallanger, 2019-09-20:
Can you flash Multi v1.2.1.79 in debug mode and paste here the telemetry packets the module is receiving? [How to debug](https://github.com/pascallanger/DIY-Multiprotocol-TX-Module/blob/master/docs/Advanced_Debug.md)
Pascal

qba667, 2019-09-24:
@Rayenchen2353 What receiver are you using? Just cross verified with latest multi-protocol module firmware and OpenTx 2.3 all good with combination with IA6B.

Rayenchen2353, 2019-09-25:
The receiver used is [this,](https://www.banggood.com/Mini-Flysky-AFHDA-Compatible-8CH-Receiver-PPM-Output-With-1mm-JST-Socket-For-DIY-Micro-Quadcopter-p-1097424.html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) flysky's second generation remote control protocol AFHDS 2A.
I will update the latest multi-protocol module firmware tonight, and then observe if the acquired sensor information is correct.

pascallanger, 2019-09-25:
@Rayenchen2353 You need to go in debug mode. We need to see what the telemetry frames are like I've requested previously following this procedure: [How to debug](https://github.com/pascallanger/DIY-Multiprotocol-TX-Module/blob/master/docs/Advanced_Debug.md) . It's really simple and we will see what the RX says.

Thanks for the link I was not aware this small receiver did exist ;-) It looks exactly the same as [this one](https://www.banggood.com/2_4G-4CH-Micro-Low-Voltage-DSM2-DSMX-Compatible-Receiver-Built-in-Brushed-ESC-p-1072251.html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) which is in DSM2. The problem of the DSM2 one is that the PWM is starting quite high so you cannot do really slow flyers with it or you can but you are laways at the limit between motor off and on... Have they corrected that on this RX?

Rayenchen2353, 2019-09-25:
I can't update the debug feature. Follow the image options and click Upload. The error message is displayed. [图片1](https://drive.google.com/open?id=1up-NcsOTc2VHh54_TMSWnq8pTCWa6YqZ)
  However, if the Debug Option selects Native USB Debugging, the upload is successful, the TX and RX are paired, and the Serial Monitor window is opened to refresh the same content, as shown in the figure.[图片2](https://drive.google.com/open?id=13XjF9bTJGXvReIzTXq3YAe5CVnV_QUyr)
Telemetry sensor status [图片3](https://drive.google.com/open?id=1dLNO13Hvdxq3M1S_eXD9j_caKDivxCgC)
Multi-protocol version 1.2.1.81
Opentx version 2.2.4

Rayenchen2353, 2019-09-25:
> Thanks for the link I was not aware this small receiver did exist ;-) It looks exactly the same as [this one](https://www.banggood.com/2_4G-4CH-Micro-Low-Voltage-DSM2-DSMX-Compatible-Receiver-Built-in-Brushed-ESC-p-1072251.html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) which is in DSM2. The problem of the DSM2 one is that the PWM is starting quite high so you cannot do really slow flyers with it or you can but you are laways at the limit between motor off and on... Have they corrected that on this RX?

No correction，this small receiver still exists

Rayenchen2353, 2019-09-25:
I tried to use another receiver with telemetry, DSMX protocol, and found that Serial Monitor has no other output. Of course, the telemetry voltage of this receiver is correct.
[AR3201G](https://drive.google.com/open?id=1zsH0Qvr9LXs2Z44P3_zH4h_dH63sQIu6)

qba667, 2019-09-25:
@Rayenchen2353 telemetry log clearly shows that you are getting value 0x01 0xff that is exactly 511 in decimal system for the sensor 0 (Internal voltage A1). I would say it is receiver bug.

pascallanger, 2019-09-25:
@Rayenchen2353
Your sensor display on OpenTX looks really weird. Can you delete all sensors and launch a new discovery?
The telemetry frames on the screenshot indicate that the RX is sending voltage and error rate. The voltage reported is 0x01FF => 5.11V so OpenTX is displaying the right value... Can you confirm that this 5.11V value is not moving at all even if you change the lipo or put it under load?
Instead of a screenshot of the debug output, can you leave the debug running for a long time and select the full text to past it in a file?
Do you see something else appearing time to time or always the same lines "00 00 FF 01 FE 00 00 00 FF FF ...."? You need to have "Autoscroll" at the bottom left checked to see it scrolling.
If you don't see anything else, we will need to remove the filters on the incoming telemetry frames to  see what's going on...
Pascal

pascallanger, 2019-09-25:
@qba667 The weird thing is that his Flysky i6X is showing the correct lipo battery voltage (see his first post).

qba667, 2019-09-25:
@pascallanger  this can not be because there is also temperature sensor there - this RX is not supporting external sensors so simply display on I6X is not with this RX.

Rayenchen2353, 2019-09-26:
> @Rayenchen2353
> Your sensor display on OpenTX looks really weird. Can you delete all sensors and launch a new discovery?

 Remove all sensors and start a new discovery, the sensor values are still the same as before

> The telemetry frames on the screenshot indicate that the RX is sending voltage and error rate. The voltage reported is 0x01FF => 5.11V so OpenTX is displaying the right value... Can you confirm that this 5.11V value is not moving at all even if you change the lipo or put it under load?

  Yes, the voltage value of 5.11 does not change even under load.

> Instead of a screenshot of the debug output, can you leave the debug running for a long time and select the full text to past it in a file?
> Do you see something else appearing time to time or always the same lines "00 00 FF 01 FE 00 00 00 FF FF ...."? You need to have "Autoscroll" at the bottom left checked to see it scrolling.

  I observed that all the output has not changed, it takes about 5 minutes.

> If you don't see anything else, we will need to remove the filters on the incoming telemetry frames to see what's going on...

Thanks Pascal and  qba667

  it seems that the problem with the receiver is relatively large, and I may have to return it to the factory for repair. The remote control in the first post is the test chart given by the store.

Closed 2019-09-26.

Thread 271 (2019-09-30):

Intermittent issue using the URUAV TMX5 Lite using FrSky protocol

CurryKitten, 2019-09-30:
I've got the (relatively new) URUAV TMX5 Lite module which runs all 4 of the supported chips using an STM32.  I didn't see it in the docs, so don't know if it's "officially" supported.

Support for this module was provided for the newer FrSky radios such as the X9-Lite pro in OpenTX 2.3, or which a stable version is now out, although it's supported on older 2.2 versions of OpenTX through radios like the X-lite.

The problem I'm seeing is that when sometimes attempting to use the FrSky protocol, regardless of subtype, more than half of the time, OpenTX receives what it deems to be an invalid status message and so lists the status as "No Telemetry" when it does initialise properly, this is replaced by the version of the modules firmware that's running.  The module shipped with V1.2.0.20.  I saw this was quite old and so flashed it with v1.2.1.84.  The same issues still occur though.

I tried using the debug option in the compilation to see if I could capture the issue and see where things were going adrift, using the serial USB connection, but in every case, the module behaves absolutely perfectly when plugged in via USB, and so we just see the regular debug info -

```
Multiprotocol version: 1.2.1.84
Protocol selection switch reads as 0
Using bank 0
Read ID from EEPROM
Module Id: 7d408c69
Init complete
Protocol selected: 3, sub proto 0, rxnum 1, option 0
```

The fact it works like this makes me think it's a timing/initialization issue.  When we are stuck in this "no telemetry state" I am able to go to the Hubsan protocol and get a status from the module there, albeit using a different RF chip.

When the problem is seen, both led's are solid, and attempting to bind does nothing.  When it works, I can just see a single green led, and red will flash correctly if you attempt to bind

pascallanger, 2019-09-30:
I've never seen this module before and I wasn't aware it existed... If you could do some good pictures of the internals I would be interested.
It's strange that when the USB is plugged it works correctly. Have you tried to not put the module in debug but just plug it to a USB charger for example? Plugging it to USB will provide power to the module all the time, which might give us some indications if it doesn't hang that way.
Also is it happening when you change the protocol or when you boot the radio with Frsky already selected?
Pascal

CurryKitten, 2019-09-30:
I'm attaching some images of the internals (open module case and the reverse side of the main board)  Hopefully they are of decent enough quality.

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

So if I recompile the code without debug active and then power the module just by a USB power bank, it appears to boot and then stop.  So rapid red flashing light, followed by a steady 1 second red led blink for approx 11 seconds after which point it shuts down.

Presumably, at this point it's waiting for comms from the host radio.  So I wouldn't necessarily call it a hang as such.  Certainly it seems to stop responding for the given protocol, but if I went from the non-responsive FrSky protocol, to Hubasn for example, it would react properly and flash the correct leds.

Whether I power up with FrSky chosen or move to a model using that after boot doesn't seem to make a difference.  Most of the time it shows "no telemetry" and sometimes it works and shows the version number.  I've noticed at if I'm willing to move back and forth between a the FrSky model and another model it will eventually seem initialize correctly and be usable.

It certainly seems curious that simply having serial debug running would cause the module to work everytime.  Obviously it's booting from USB power alone, but (if I'm reading the code correctly) it doesn't initialise the FrSky protocol until the protocol is selected - at which point the module would generally be in the same situation whether it was powered up from USB or the radio... unless there's some subtle timing change because of the serial writes ?

pascallanger, 2019-09-30:
I don't think the debug is what's making the module to work. This is why I was more thinking of a power issue. You 've tried to power it on from USB but it looks like you haven't powered on the radio?
What happens to the LEDs when you switch from one protocol to another?

CurryKitten, 2019-09-30:
I've been using the radio, but when running with debug, it did take the power from the USB.  Ok, so interesting about swapping protocols.  If I power up in FrSky and it doesn't work (status is "no telemetry" and both leds are on. If I cycle through the protocols within the model, there's no change the led's stay lit, and the status lines (when reported) carry on saying "no telemetry"  It's only when I swap to a different model on OpenTX that something will happen.  I don't know it OpenTX reboots the module?  Anyway, if I boot up on a working protocol, then changing the protocol within that model will also work everytime, FrSky included, and the leds seem to respond correctly, so you see a red flash with the autobinding protocols and just a solid green for others

pascallanger, 2019-09-30:
I wish I could reproduce it. Which version of OpenTX are you running?

pascallanger, 2019-09-30:
There is a known bug on this module which is the same as the Vantac module but I'm not it is linked. The problem is in the bootloader they are using. I don't know which version they are using but it's a bad one. Would you be able to upgrade it?
Someone made a doc: https://github.com/pascallanger/DIY-Multiprotocol-TX-Module/files/3594850/Vantac.MPM.Lite.Red.LED.Issue.docx

CurryKitten, 2019-09-30:
I'll find my FTDI interface, locate a windows machine and give it a go.  looks a bit involved, but yes I'll do that and report back.  The module certainly looks like a clone.  WIth any luck though, I might be able to feedback the issue to URUAV and tell them the fix  - they know they have a problem

kilrah, 2019-09-30:
What radio are you using?

CurryKitten, 2019-09-30:
@kilrah I'm mostly using a FrSky X9-Lite Pro which I've had for about 2 months, and an X-Lite (which is a year and a bit old)

kilrah, 2019-09-30:
OK, the X9 Lite could have the PMU "issue" which shuts the module off after a few seconds, but the x-lite should be ok.

CurryKitten, 2019-09-30:
The X-lite I have seemed ok, I had the module on for about 5 minutes and flew a couple of things around - but I'll retest all once I get the bootloader flashed

CurryKitten, 2019-10-01:
@pascallanger I flashed the firmware via ST-flash (happily there was a command line OSX version which saved me searching around for a windows machine) and yes, the new bootloader absolutely fixed the problem.  I've power cycled 20 times and the module always comes up perfectly.

Looking at the instruction from the Vantec module, the board is identical.  I'll feedback to URUAV that there's a problem here (they actually did know something was up as they suggested a workaround) but I'm guessing all these companies buy in the boards and slap there own cases on them, so I don't know if they'll fix it at source... I'd hope they would, else it's a bit useless

pascallanger, 2019-10-01:
Great that it's fixed.
Do you mind to share your email contact for URUAV?

CurryKitten, 2019-10-01:
I don't have one directly, I've having to go through Banggood as a weird sort or intermediary.  Let me see what I can do though - it seems crazy they don't include you in the loop when they are bringing out a module like this.

pascallanger, 2019-10-01:
Ok thanks. I'm closing this issue for now at it is solved but you still can reply to it if you obtain some informations.

gretel, 2019-11-09:
@pascallanger one more questions: the bootloader is contained in the `.bin` files i use to flash via `usb` so the difference is flashing via serial instead of usb? thanks a lot

pascallanger, 2019-11-09:
The firmware bin file does not contain the bootloader. The bootloader is automatically installed when a serial flash is detected.

gretel, 2019-11-09:
@pascallanger thank you!

gretel, 2019-11-10:
the guide was very helpful cause took me some time to connect usb, too ;)
did powercycle couple of times.. seems reliable now. thanks again!

Closed 2019-10-01.

Thread 293 (2019-11-20):

Short range issue with spektrum dsmx full telemetry receivers

faraz-hub, 2019-11-20:
Facing serious problem when using spektrum dsmx receiver with jumper t16 it binds smoothly but having a low RF signal issue and all signal lost under 15 meters.

pascallanger, 2019-11-20:
If you are sure your that your antenna is well connected (antenna screwed all the way and the tail securily attached on the module in the radio) and that you haven't checked the low power setting under the UI then you have a defective module, contact your reseller.

faraz-hub, 2019-11-25:
Yesterday I use my jumper t16 with dsmx 6ch receiver without telemetry and it worked fine with complete controls and good range check. What I guess it is having only a problem with telemetry receiver.

pascallanger, 2019-11-25:
Ah, I thought you were saying that you were losing connection but it's only telemetry!
Most DSM RX and all in one models have only fly by telemetry unless it's really written on the RX "long range telemetry". You should ignore any telemetry loss signal and even disable the alarms.

faraz-hub, 2019-11-25:
Thanks for your guidance, I have a full range telemetry receiver which
works absolutely fine with spektrum's original transmitter. But with jumper
t16 it disconnects the receiver(receiver switched off) as I walk away and
reconnect when come closer and says telemetry data loss and telemetry
recovered respectively.

On Mon, Nov 25, 2019 at 2:00 PM pascallanger <notifications@github.com>
wrote:

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

benlye, 2019-11-25:
There have been a few reports in RCGroups of people getting significantly reduced DSM range after updating their internal modules from the stock 1.2.1.51 FW to 1.2.1.85.

This, for example, describes the same issue - short range on telemetry-nebled receives only:
https://www.rcgroups.com/forums/showpost.php?p=43185319&postcount=1341

pascallanger, 2019-11-25:
Hummm...
@faraz-hub Would you be able to ship your RX with low range RX so I can troubleshoot?

ChipRey, 2019-11-25:
Ben, I'm totally confused. I installed the internal module and the only protocol choices are D8,D16 and LR12. Is this a module firmware issue? If so, do I need to do the bootloader install mod? Thanks

benlye, 2019-11-25:
> Ben, I'm totally confused. I installed the internal module and the only protocol choices are D8,D16 and LR12. Is this a module firmware issue? If so, do I need to do the bootloader install mod? Thanks

@ChipRey let's take that conversation back to FB and not get this issue (which is about DSM/Spektrum confused.

Rickster250, 2019-11-25:
I am having the same issue, bad RF range with spektrum/telemetry RX's,  all non telemetry dsmx works fine. RF siglnal low and rf signal lost at a fraction of normal range.

pascallanger, 2019-11-26:
Ok so it points out a change between 1.2.1.51 and 1.2.1.85. As far as I recall I've changed the timing for DSM due to the fact that some people were not getting telemetry on some RXs. Let me have a deeper look.
By the way have you tried the latest 1.3.0.44?

pascallanger, 2019-11-26:
This is the part that has changed in DSM_cyrf6936.ino :
```
	#ifdef STM32_BOARD
		#define DSM_WRITE_DELAY		1500		// Time after write to verify write complete
	#else
		#define DSM_WRITE_DELAY		1950		// Time after write to verify write complete
	#endif
```
https://github.com/pascallanger/DIY-Multiprotocol-TX-Module/blob/e70bdd4152187ae75c8d24ac0a433f639318d791/Multiprotocol/DSM_cyrf6936.ino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
Can you change the value 1500 and try different values up to 1950? steps of 100 should be fine.
The doc to compile yourself the code is here https://github.com/pascallanger/DIY-Multiprotocol-TX-Module/blob/master/docs/Compiling_STM32.md . Let me know if you need help.
Pascal

Rickster250, 2019-11-27:
YES
I had to to use the Opentx daylies.which i am using     On Tuesday, November 26, 2019, 05:42:43 PM EST, pascallanger <notifications@github.com> wrote:

Ok so it points out a change between 1.2.1.51 and 1.2.1.85. As far as I recall I've changed the timing for DSM due to the fact that some people were not getting telemetry on some RXs. Let me have a deeper look.
By the way have you tried the latest 1.3.0.44?

—
You are receiving this because you commented.
Reply to this email directly, view it on GitHub, or unsubscribe.

pascallanger, 2019-11-27:
And? Are you still having short range with that version?

pascallanger, 2019-11-27:
I've published a new version of Multi v1.3.0.45 with a different timing: https://github.com/pascallanger/DIY-Multiprotocol-TX-Module/releases/tag/1.3.0.45
Please test and report.
Pascal

pascallanger, 2019-11-28:
Anyone testing?

Rickster250, 2019-11-29:
@pascallanger  I should be able to get some flying in tomorrow. to try it,

faraz-hub, 2019-11-29:
I will be testing it on Sunday

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

Rickster250, 2019-12-01:
I flew today with good results, i had no range issues today with a spektrum telemetry sat.
I was going to try going back on the firmware to 44 as a test.
But i clipped a tree branch about 100yards away and it was too late by the time i found my quad. lol
I might be able to fly some more tomorrow.

pascallanger, 2019-12-04:
Not hearing complains anymore so I consider that this is fixed.

faraz-hub, 2019-12-07:
please guide me how to get my transmitter (Jumper t16) ready as I have not
run any kind of update yet so this will be the first one.

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

pascallanger, 2019-12-07:
@faraz-hub
check here, they've explained it more than 100 times and there are videos: https://www.rcgroups.com/forums/showthread.php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

joshuatreemcd, 2020-02-18:
The short range issue has not be resolved as of yet. I'm using the spektrum 4649T and max range is roughly 30 meters before failsafe occurs. Is there a fix coming?

pascallanger, 2020-02-19:
Do you have another DSM RX where you get full range with your module?
Anyway, unless someone sends me one of the RX with low range, there won't be any fix.

joshuatreemcd, 2020-02-19:
Physically mail you the receiver in question? I can do that.

Rickster250, 2020-02-25:
HI, I wanted to let you know that after the last radio firmware update and module update  V1.3.0.5
I'm getting RF SIGNAL LOW again at a short range, with Spektrum 4649T  Telemetry Satellites.They dont send the the RSSI level to the FC, so I don't have it in a log.I retested with my DX9 TX and i have no issues.
Rick D

    On Wednesday, November 27, 2019, 07:54:50 AM EST, pascallanger <notifications@github.com> wrote:

I've published a new version of Multi v1.3.0.45 with a different timing: https://github.com/pascallanger/DIY-Multiprotocol-TX-Module/releases/tag/1.3.0.45
Please test and report.
Pascal

—
You are receiving this because you commented.
Reply to this email directly, view it on GitHub, or unsubscribe.

Rickster250, 2020-02-25:
V1.3.0.53  i meant

pascallanger, 2020-02-25:
The RF low signal with DSM does not mean anything. The dx9 doesn't complain because it doesn't even display it use this info. Just do the same with OpenTX and disable rssi warnings.
The only thing which matters with DSM is if you get failsafe which is most likely not the case. Even at long distance.
I'm annoyed by people reporting or have just because they get a rssi warning. I'm going to remove it all together.

Rickster250, 2020-02-26:
Hi,  to be honest, im tired of smashing my drone into the ground., When it says RF signal low, i turn it it around and land it.
Disable Telemetry Alarms is TURNED ON
the Warning is not "RSSI LOST"  or low RSSI
Whatever it is, it was fixed until the last radio fw and module fw.
I still have my DX9, 
If i have to use it to fly certain quads, then I will live with it.
Thank you for your work.
    On Tuesday, February 25, 2020, 01:37:49 AM EST, pascallanger <notifications@github.com> wrote:

The RF low signal with DSM does not mean anything. The dx9 doesn't complain because it doesn't even display it use this info. Just do the same with OpenTX and disable rssi warnings.
The only thing which matters with DSM is if you get failsafe which is most likely not the case. Even at long distance.
I'm annoyed by people reporting or have just because they get a rssi warning. I'm going to remove it all together.

—
You are receiving this because you commented.
Reply to this email directly, view it on GitHub, or unsubscribe.

pascallanger, 2020-02-26:
Where is this RF signal low coming frrom then?
I have no way to reproduce the issue and therefore solve it.

joshuatreemcd, 2020-02-26:
Rickster250 - Which firmware (radio and module) did it work with?

pasallanger - Can I send you a 4946T receiver to test with?

pascallanger, 2020-02-26:
If you fully explain the reproduction steps of the issue and send the associated hardware that I can just plug and work on, I'm more than interested to get it.
Pascal

Rickster250, 2020-02-27:
I Believe it is coming from the TRSS signal level in the Telemetry screen on the T16.
the spm4649T sends alot of info back to the radio but RSSI is not in the list, for some reason,on the telemetry screen. only TRSS, It has a full scale of 30I do not have the cable to flash my 4649t's to see the RSSI on the FC OSD
RSSI from the 4649T does show on the spektrum DX9 radio, but not on the T16
The Frsky XM+ RX shows TRSS and RSSI
The Frsky R9 mini just has RSSI
If you need anything from me let me know.

    On Wednesday, February 26, 2020, 02:57:54 AM EST, pascallanger <notifications@github.com> wrote:

Where is this RF signal low coming frrom then?
I have no way to reproduce the issue and therefore solve it.

—
You are receiving this because you commented.
Reply to this email directly, view it on GitHub, or unsubscribe.

pascallanger, 2020-02-28:
So you are saying that you've disabled the RSSI alert but you are turning back when you get an alert. It doesn't make sense to me.
Also I need to make sure that you have tested another type of DSM receiver and you are getting good range with it. Unless you confirm that there is a real difference, I would say that your module is faulty.

Rickster250, 2020-02-29:
Yes That is what I'm saying.I have been flying Spektrum for a long time, most of my RX's and SAT's are spektrum.I have all dsmx receivers in about 15 airplanes, I havent even tried my airplanes with the T16 yet.
I have 8 Quads.2 x spm4649T dsmx telemetry3 x spm4648 dsmx  non-telemtry1 x lemonrx dsmx diversity1 x frsky R-SXM1 x frsky XM+
I fly them all when i go flying.the spm sats all work normal with my Spektrum DX9 radio
I think its pretty obvious what the issue might be.The T16 is not receiving or displaying the RSSI signal,from the spm4649T  all it is tracking is the telemetry signal.
    On Friday, February 28, 2020, 12:27:19 PM EST, pascallanger <notifications@github.com> wrote:

So you are saying that you've disabled the RSSI alert but you are turning back when you get an alert. It doesn't make sense to me.
Also I need to make sure that you have tested another type of DSM receiver and you are getting good range with it. Unless you confirm that there is a real difference, I would say that your module is faulty.

—
You are receiving this because you commented.
Reply to this email directly, view it on GitHub, or unsubscribe.

Rickster250, 2020-03-01:
OK so i picked up a cable and flashed my spm4649T RX's.And on the first test, i got no warnings at all, even to fail-safe.It was a ground test, with a gopro pointed at my quad so i could see the RX led later.Still only TRSS on the radio.I will try to do some real flight/range test tomorrow.
RickD
Rickster250

    On Saturday, February 29, 2020, 08:57:56 AM EST, RICHARD DOBERSTEIN <rdobers@bellsouth.net> wrote:

  Yes That is what I'm saying.I have been flying Spektrum for a long time, most of my RX's and SAT's are spektrum.I have all dsmx receivers in about 15 airplanes, I havent even tried my airplanes with the T16 yet.
I have 8 Quads.2 x spm4649T dsmx telemetry3 x spm4648 dsmx  non-telemtry1 x lemonrx dsmx diversity1 x frsky R-SXM1 x frsky XM+
I fly them all when i go flying.the spm sats all work normal with my Spektrum DX9 radio
I think its pretty obvious what the issue might be.The T16 is not receiving or displaying the RSSI signal,from the spm4649T  all it is tracking is the telemetry signal.
    On Friday, February 28, 2020, 12:27:19 PM EST, pascallanger <notifications@github.com> wrote:

So you are saying that you've disabled the RSSI alert but you are turning back when you get an alert. It doesn't make sense to me.
Also I need to make sure that you have tested another type of DSM receiver and you are getting good range with it. Unless you confirm that there is a real difference, I would say that your module is faulty.

—
You are receiving this because you commented.
Reply to this email directly, view it on GitHub, or unsubscribe.

pascallanger, 2020-03-02:
You know that you need to discover the sensors when the RX is connected? The fact that you have TRSS displayed shows that there is some telemetry frames being received therefore the radio should show something more than just TRSS... OpenTX only uses TRSS and no other sensors, this is why you need to disable RSSI warnings and set the warnings on whatever sensor you are interrested in.

You still haven't answered my initial question... Have you at least tried to do a range test on one of your receiver like the lemon rx and look at how far you can go without losing the servos? And I say the servos not any warning or anything else coming from the radio. Again the radio can't report any connectivity issue.

Rickster250, 2020-03-02:
All of my drones get flown a lot, and range tested quite often.I get pretty much the same range form the spm4648's and the lemon diversity Sat's
I flew yesterday with the new firmware updated on the SPM4649TAnd i think that the FIRMWARE was the problem. no audible warnings , and RSSI working in the OSD
Everything seems to be normal now, I feel like it should have better range, but i did fly it about 100 yards away.

RickD    On Monday, March 2, 2020, 05:14:28 AM EST, pascallanger <notifications@github.com> wrote:

You know that you need to discover the sensors when the RX is connected? The fact that you have TRSS displayed shows that there is some telemetry frames being received therefore the radio should show something more than just TRSS... OpenTX only uses TRSS and no other sensors, this is why you need to disable RSSI warnings and set the warnings on whatever sensor you are interrested in.

You still haven't answered my initial question... Have you at least tried to do a range test on one of your receiver like the lemon rx and look at how far you can go without losing the servos? And I say the servos not any warning or anything else coming from the radio. Again the radio can't report any connectivity issue.

—
You are receiving this because you commented.
Reply to this email directly, view it on GitHub, or unsubscribe.

pascallanger, 2020-03-21:
Closing this issue since it seems to be in fact due to a RX software upgrade.

Rickster250, 2020-04-15:
Hello Sir, I hope you are doing well in this time of Crisis. 
I am having trouble trying to bind  XM+ receivers with the new firmware on the frsky site, to my T16 and it isn't working.multi-stm-opentx-aetr-noinv-v1.3.0.76.bin

XM+_ACCST_2.1.0_RSSI16_FCC.frk         will not bind

XM+FCC170313-RSSI16.frk   will bind

Am i overlooking something or using the wrong firmware?
Appreciate your time.
Rick D

    On Wednesday, December 4, 2019, 09:19:53 AM EST, pascallanger <notifications@github.com> wrote:

Not hearing complains anymore so I consider that this is fixed.

—
You are receiving this because you commented.
Reply to this email directly, view it on GitHub, or unsubscribe.

pascallanger, 2020-04-15:
Why are you posting on this DSM issue for something related to Frsky?

Rickster250, 2020-04-16:
sorry,   i used the thread to email you, i thought it could be related to the TX module.But I forgot Frsky broke it with the ASCCT 2.X  firmware updates.
Have a good daystay safeI hope we can get back to normal soon
    On Wednesday, April 15, 2020, 12:23:43 PM EDT, pascallanger <notifications@github.com> wrote:

Why are you posting on this DSM issue for something related to Frsky?

—
You are receiving this because you commented.
Reply to this email directly, view it on GitHub, or unsubscribe.

Rickster250, 2020-05-05:
I wanted to let you know that im having problems again after upgrading to v1.3.0.91  from  v1.3.0.76
I just got back from flying, I had just started to trust the T16 with my 2 spektrum quads with the SPM4649T receivers,
 I bought a spektrum cable so i could upgrade the firmware, The upgrade solved the range problems I was having, until today.
With the latest jumper module firmware v1.3.0.91, im actually getting fail safes on one of them, and low rssi readings on the other one.
I'm flying in the same places I always fly when I'm trying new stuff. Pretty much open fields.
I re bound my SPM DX9 to my Skyliner with the SPM4649T and my RSSi levels are normal with no fail safe.I get low RSSI levels and fail safes with v1.3.0.91.bin and SPM4649T receiver.
I am also getting reduced RSSI levels with v1.3.0.91.bin used with Frsky XM+  _ACCST_2.1.0_RSSI16_FCC.frk
I just got back form flying with v1.3.0.76.bin and XM+FCC170313-RSSI16.frk, and the RSSI OSD levels are back to normal. I have DVR footage flying the same field with both setups.I also have 1, R-XSR in a quad, but i dont have RSSI in the OSD and ididnt think to turn  audio RSSI on . So I don't know if the R-SXR is affected, Ill have to fly it again.
I don't know what version the problem shows up in. between .76 and. 91.  I will try to see if i can figure it out.
Thanks for all you do.

    On Wednesday, April 15, 2020, 12:23:43 PM EDT, pascallanger <notifications@github.com> wrote:

Why are you posting on this DSM issue for something related to Frsky?

—
You are receiving this because you commented.
Reply to this email directly, view it on GitHub, or unsubscribe.

Closed 2020-03-21.

Thread 324 (2020-01-28):

Telemetry Support for Devo protocol

richardclli, 2020-01-28:
Did the current Devo protocol supports telemetry?  I tried to bind a MiniCP and seems there is no way to get the battery voltage.

pascallanger, 2020-01-28:
Devo telemetry is not supported.

richardclli, 2020-01-29:
I see, is it possible to support telemetry?  I can try to work this out. ^.^

richardclli, 2020-01-29:
I will check Deviation source code for reference to see how can I make this work.  It will be good if you can point out any details that can speed me up.  Thanks.

pascallanger, 2020-01-29:
Deviation has all the code for telemetry. I don't have sensors to connect on a Devo RX to develop and test so I've never done anything in this area.
I could have a look but I'm running after time currently...

richardclli, 2020-01-30:
No problem, I can see if I can work this out.  I have contributed Deviation in the past as well, I think I can make this work.

richardclli, 2020-02-01:
I have checked the source code of deviation and multi protocol module, seems the Telemetry framework are quite different.  Can you help to point out how the multi protocol module send back received data back to OpenTX?  Thanks.

richardclli, 2020-02-17:
I have work out some code and finally figured out that a single piece of code in deviation splitted into 2 parts: telemetry packet sent out by multi-module and decoded by OpenTX, which means to make it works, I need to modify both multi-module and OpenTX sources.

For a fall back test, I will first try to convert the DEVO telemetry data into DSM format and see if it works first.

richardclli, 2020-02-17:
Please give me some comments on this direction if possible, thanks.

pascallanger, 2020-02-17:
If you want to try to send data to OpenTX and get it displayed quickly using frsky hub. It's the easiest. Look at the bayang protocol as an example.

richardclli, 2020-03-11:
I tried to worked out some coding from Deviation Devo source code.  I can manage to port and compile the callback function for Devo telemetry, and I can manage to push out some output to Frsky Hub by setting the v_lipo1, v_lipo2, RX_RSSI, etc.  See if you may have some ideas on the following problems:

1.  RX_RSSI = CYRF_ReadRegister(CYRF_13_RSSI)&0x1F;  This line can never get non-zero RSSI, I got this from DSM coding, is there are initialization required?

2.  After reading using CYRF_ReadDataPacketLen(packet, CYRF_ReadRegister(CYRF_09_RX_COUNT)); and unscrambling, I can never found valid telemetry packets packet[0] & 0xf0 == 0x30.  It is quite strange.

I have attached my source for reference, see if you may found any hints.

[Devo_cyrf6936.txt](https://github.com/pascallanger/DIY-Multiprotocol-TX-Module/files/4316737/Devo_cyrf6936.txt)

richardclli, 2020-04-07:
I finally make it works, but the problem is related to some shared code with DSM, so could you give me some advice why you add RX abort operations when calling doing CYRF_FindBestChannels?  I check the code in deviation, in which the deviation version do not have these 2 lines:

//	CYRF_WriteRegister(CYRF_29_RX_ABORT, 0x20);		// Abort RX operation
	CYRF_SetTxRxMode(TX_EN);
//	CYRF_WriteRegister(CYRF_29_RX_ABORT, 0x20);		// Clear abort RX

The telemetry works after I remarked these 2 lines.

richardclli, 2020-04-07:
I realized what is the problem, this is obviously a bug that the Clear abort RX line is wrong, should put 0x00 instead of 0x20.

richardclli, 2020-04-07:
I have created a pull request, please review.  I have tested it with my Walkera MiniCP.

richardclli, 2020-04-27:
@pascallanger any comments on my pull request?

pascallanger, 2020-05-09:
I've done many comments but they haven't been addressed.
I'll see if I have time to merge the code and improve it this WE.

pascallanger, 2020-05-09:
Since none of review have been addressed, I've imported the change and done the recommended modifications from my branch.
Devo basic telemetry is available in 1.3.0.96.

Please test and report since none of the 2 Devo RX I have sends telemetry back...

Closed 2020-05-09.

Thread 328 (2020-02-08):

SLT Protocol problems with Jumper T16 Internal or External

MRC3742, 2020-02-08:
As others have discussed a problem exists when trying to bind a Genuine TR624 RX (one antenna) to the Jumper Modules using Protocol SLT and Sub Protocol V1_ch6.

The RX will bind but then the solid Red LED will intermittently flash causing loss of control to servo outputs when LED is out. Switching to Low power mode will turn the RX LED on Solid and servos work correctly now with limited range. The iRangeX External MPM seems to be less prone to this problem? It has been the theory that the Jumper Modules' RF hardware is less accurate and is possibly working on the edge of the frequency with no option to fine tune the NRF24L01+ chip via software.

Please review the attached captures of a Genuine Tactic TTX610 Transmitter (6 channel)
and compare them to the current code for any problems, additions or errors?
[Captures Tactic TTX610 Transmitter.zip](https://github.com/pascallanger/DIY-Multiprotocol-TX-Module/files/4232323/Captures.Tactic.TTX610.Transmitter.zip)

Thanks - Rich

pascallanger, 2020-02-08:
I've started to look at the dumps and noticed that the SLT protocol is running at 250Kbps (which I've totally forgotten). This is why it works on iRangeX and not on Jumper. 250Kbps need a more accurate crystal/caps and this is the problem with all the Jumper modules and explaining why some do work a little better than others.
I need to modify the protocol to use the CC2500 instead of the NRF24L01 for this type of bitrate, it should give better results.
I need to find out how the CRC is calculated on the NRF24L01 as this would be the 1st protocol.

MRC3742, 2020-02-08:
I knew that was a problem emulating other RF chips at 250Kbps but didn't realize it to be a problem with the same chips.......... but makes sense now.

I can also help with any testing needed - Rich

pascallanger, 2020-02-17:
@MRC3742 Please test the SLT protocol in v1.3.0.69
I would like to see if it's still working even if the LED is not solid just to see if I haven't broken anything.
If it does work then change the RF Freq tune value from 0=NRF24L01 to 1=CC2500. I'm not expecting it to work fist try since I haven't tested anything but with some luck ;-).
Pascal

pascallanger, 2020-02-17:
@MRC3742 Try v1.3.0.70. CC2500 emulation should work in this one...

gretel, 2020-02-17:
@pascallanger not sure if i miss something.. latest release is at `v1.3.0.53`?

pascallanger, 2020-02-17:
> @pascallanger not sure if i miss something.. latest release is at `v1.3.0.53`?

You need to build from the source if you want the latest version 1.3.0.71. I'm releasing only when people confirm it's working...

MRC3742, 2020-02-17:
@pascallanger I just downloaded and compiled 1.3.0.71 and testing on SLT Protocol does not work at all. RF Tune at "0" are any other value it does not attempt to bind.

I have tried using all subprotocols and tested with RF Tune set to -120, -80, -40, 0, 40, 80, and 120. Unfortunately will not bind to TR624 RX or any of the previously working Ominus models.
Rich

pascallanger, 2020-02-18:
@MRC3742 Can you test the version .72? It should work again for the NRF. I'm not sure why the CC2500 version was not working, I've tried a change so let's see as well.

MRC3742, 2020-02-18:
Using 1.3.0.72 now "0" works with NRF same as 1.3.0.69 with intermittent LED flashing.
Changing to any other value of RF Tune caused LED to go out completely.

Should I need to reset Bind on RX when switch to CC2500?
I have tried both, with and without bind but still no response.

pascallanger, 2020-02-18:
Ok it's already a good step. I'll check what the cc2500 is sending later.

pascallanger, 2020-02-20:
@MRC3742 Can you test .73?
Stupid mistake which made me lose a day, it should have worked since the begining with the CC2500...

MRC3742, 2020-02-20:
@pascallanger .73 is a success and works with RF tune offset values other than "0"
It works OK but seems to need more frequency offset for each change in step value.
I tested it on two MPM listed below.

Jumper T16 with Internal module (Jumper)
Value of  "0" causes bind LED to flash intermittently.
Values of +40 and -120 cause bind LED to flicker. (Set to -40 seems to be solid)

Jumper T16 with External IRX4 Plus
Value of  "0" causes bind LED to stay on steady (As noted this MPM seems more accurate)
Value of -128 causes slight flicker and +127 still solid LED

Both tested MPM Modules, using Genuine TR624 RX, bind LED never flashes or goes out at values of -128 or +127. Is there a way to increase the frequency offset per step? ( I think double the current amount would work ) Is there a simple way to change a value in the code i could test?

pascallanger, 2020-02-20:
This is a single byte register. You have already full access to it...
I'm confused since it seems to work fine from what you've written, isn't it?

MRC3742, 2020-02-20:
Yes it works but is difficult to find center as you need to change RF Tune by value of 10 and then watch for a slight flicker to try and get the proper offsets. I am familiar with RF Tune on the other CC2500 Protocols and you can turn the bind LED completely out at a much narrower band of + or -

If it can't be done then it works fine as is. I just thought there might be an easy way to increase the frequency offset per step.

Thanks for all your time on this - Rich

pascallanger, 2020-02-20:
Nothing I can do. This will stay as it is.

Closed 2020-02-20.

Thread 332 (2020-02-18):

SFHSS protocol binding/connection issue with Jumper 4in1 internal MPM

n2o2rox, 2020-02-18:
TX used: Jumper T16 with OpenTX version 2.3.5
Module used: Jumper 4in1 internal multiprotocol module with firmware version 1.3.0.53

I've recently updated to an internal module for my Jumper T16 transmitter. For some reason I cannot get  a solid bind or connection to my Futaba R2006GS receiver. When I try to bind it, it just blinks green. (It should be solid green light; with a solid green light I can make my servos move) It seems bound but could not get a solid green light. No servo response.  I tried the frequency tuning and that didn't work. I went down to 14 and below that the RX LED light blinks red indicating a lost connection. I also went up to 54 and beyond that it will also blink red. Nowhere in between it had a solid green light. Got the median of those values and had it fixed in the frequency tuning but still didn't work. Tried changing to low power mode but that dint help either. With the previous external module I had, it works flawlessly with v1.3.0.53.
I tested further the internal module by binding several receivers of different makes and protocols to see if the RF chip concerned is at fault. I tried several Hitec Optima' receivers and Frsky D8/X8R's. All of them worked flawlessly. Binding was instantaneous. So, the RF chip concerned works.
I also built/compiled from source (1.3.0.69) for the internal module but had the same problem.
I'm at a loss here.

pascallanger, 2020-02-19:
Strange, the fact that you can tune means that the receiver sees the packets. The sfhss protocol has not been touched for a while. Do you still have the external module and it works with 1.3.0.53?
The firmware is the same for internal and external, no difference....

n2o2rox, 2020-02-19:
It is really strange. Yes, I still have the external module that works for
shfss with 1.3.0.53. Planning on something?

I'll try to do some more testing with it. Probably try to use other models
of Futaba sfhss receivers and compatibles. Worst case is to get me another
internal module. But that route would take a couple of weeks to a month
since i'll be getting it from China. And some things are not working well
with China. Shipments of products are somewhat slow.

On Wed, Feb 19, 2020 at 3:47 PM pascallanger <notifications@github.com>
wrote:

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

pascallanger, 2020-02-19:
Since you can compile your own version, could you try to modify the file SFHSS_cc2500.ino line 236:
#define SFHSS_DATA2_TIMING	1625
You can change the value 1625 between 1600 or 1650, upload and try to see if you have some improvements.
Pascal

T16-Pilot, 2020-02-20:
I got the exact same problem on my Jumper T16 Pro Hall bought from TBS. It came with the internal module.
The internal module is flashed with V 1.3.0.53, it works just fine with DSM2, DSMX, ASSAN and Hitec. But with S-FHSS the green light is flashing and the servos are stuttering. I also got a brand new Jumper 4 in 1 external module in my Horus X10 that is running 1.3.0.53 and it works just fine with my S-FHSS receivers. I tried the external modul in the T16 and the S-FHSS receivers is working great on the external module in my T16. I tried to roll back to 1.3.0.47 on the internal module. Still same problem...

T16-Pilot, 2020-02-20:
PS I also got the same flashing green LED on a XM+ D16 receiver, and it is having problems arming my quad....

MRC3742, 2020-02-20:
@T16-Pilot have you tried to tune the RF frequency on either of those Protocols on the Internal MPM?

[https://github.com/pascallanger/DIY-Multiprotocol-TX-Module/blob/master/docs/Frequency_Tuning.md](url)

Rich

T16-Pilot, 2020-02-20:
@MRC3742 Yes, done that. Did not fix the problem... The funny thing is that the external module with the same version of the firmware is working just fine in my T16 and Horus X10.

n2o2rox, 2020-02-21:
So, I'm not alone here. Does not work for my Futaba R2006GS receiver. Now, an XM+ D16.

However, I got hold of a FrSky Delta 8 to test their sfhss protocol. With this receiver, it binds well and servos respond well. If I get some flying time this weekend, I will do some field range/flight test. I'll see if I can borrow some different makes of Futaba SFHSS receivers and other compatibles and see what works and what doesn't.

Also, I will do what Pascal had suggested about doing the compile mods. (That is if I still have time for this weekend :) )

pascallanger, 2020-02-21:
The test I've asked for is the most important one since this is the only thing that can be adjusted in this protocol. So try this first and see if you can have a solid bind.
I don't see what kind of information you will get by finding which RX works or not...

T16-Pilot, 2020-02-21:
@pascallanger I am not a programmer, so the code thing i do not know how to do. I am sorry.
What i did last night was re-flashing the internal module twice with 1.3.0.53 and then re-flashing OpenTX 2.3.5. After that i tried tuning (+20) the internal module and now my S-FHSS is working. My XM+ is also working now, but still flashing green light, not solid... i have not flight testet yet. Tuning the XM+ did nothing for me. The green LED was still flashing no matter what i did with the tuning.
First time i tried the S-FHSS was on OpenTX 2.3.3 and it work flawless out off the gate. Since then i upgraded OpenTX to 2.3.5 and the module from 1.3.0.47 to 1.3.0.53. The problems started after that upgrade. I am starting to think that it might be the way OpenTX is talking to the internal modul, because the external modul i running just fine with the same firmware version and OpenTX 2.3.5...?
@n2o2rox The FrSky Delta 8 is a multi protocol receiver. I got a lot of them. They bind to S-FHSS, FrSky D8 and Hitec Minima. Have you tried all off the protocols?

n2o2rox, 2020-02-25:
https://github.com/pascallanger I tried to modify the file SFHSS_cc2500.ino line 236:
#define SFHSS_DATA2_TIMING 1625 and changing the values between 1600  to 1650, (increments of 5) It didn't make any improvements.

https://github.com/T16-Pilot  Frsky  and Hitec protocols on  the Deltas worked.

pascallanger, 2020-02-28:
Frankly unless I have access to the RX which causes issue there is little luck that we will get to the bottom of the issue...
Pascal

richardclli, 2020-03-11:
I do not have any problems on S-FHSS receiver, however I just used some compatible receivers.  For S-FHSS protocol, you need to fine tune the frequency in the receiver.  You need to change the value until it can be binded and try to find the max and min of the tuning value that it will not lost connection and try to set something between min and max for best stability.

I am not sure if you have tried these steps.

n2o2rox, 2020-03-11:
@richardclli for now, my Futaba R2006GS receiver doesnt work with the sfhss protocol with my internal  module.  my other receiver,  the frsky delta 8, works fine. My problem is isolated on the Futaba R2006GS. Tuning and some program tweaks didnt help.

pascallanger, 2020-06-03:
@n2o2rox Unless I can get access to the this Futaba R2006GS receiver I'm not sure what I can do.

ceptimus, 2020-09-08:
I've seen exactly the same issue with a Futaba R2008SB receiver.  Tried 3 different transmitter modules, and the Futaba receiver won't successfully bind to any of them.  I did the fine tuning adjustment using flashing green / red LED, tried low power, etc...
The same transmitter modules will all bind to an X-BOSS AC900 V2 receiver in S-FHSS mode.

My guess is that the Futaba receivers will only bind to some limited range of transmitter IDs... and if we knew what that range was, we could modify the S-FHSS protocol to only use IDs in that range.

Or perhaps the protocol doesn't 100% emulate the output of a genuine Futaba transmitter...  The Futaba receivers are unhappy and won't bind, but the X-BOSS receivers are more tolerant?

I have to give back the Futaba receiver I borrowed today.  If I can borrow it again, I can do some experiments recompiling the source code with different fixed S-FHSS IDs, and see if my theory about only certain IDs being accepted is correct.

ceptimus, 2020-09-09:
My apologies. I now find I was using the wrong binding method for the Futaba R2008SB, and once I swapped to the correct method, the receiver linked properly and worked without any problems.  Please ignore my previous post, and sorry for bumping this old thread.
For anyone else who is as confused as I was, the way you bind a Futaba R2008SB to a multiprotocol module in S-FHSS mode is.
1. Have the transmitter switched on and transmitting normally - you never need to use the 'bind' function on the transmitter.
2. Switch on the receiver.
3. Press the little button in the slot **on the receiver** for two seconds within the first twenty seconds after powering up the receiver.
4.  Wait a few seconds during which time the receiver LEDs will flash different patterns.
5.  Bind process is now complete and the receiver should display a solid green LED, and from then on work normally with the MPM.
6.  There's no need to rebind at each switch on.

n2o2rox, 2020-09-10:
Finally, I got it to work for version 1.3.1.24. Been busy lately so testing was put to the side. Will test later for newer versions.

diego0815, 2020-12-17:
> Finally, I got it to work for version 1.3.1.24. Been busy lately so testing was put to the side. Will test later for newer versions.

Sorry for bumping this thread...

How was it solved? Finger troubles as well?

pascallanger, 2020-12-17:
2 comments above.

diego0815, 2020-12-17:
> 2 comments above.

Also for @n2o2rox in that case, so time to close this issue?

Closed 2020-12-17.

Thread 340 (2020-03-21):

PPM from SpektrumDX6i/DX5e not recognised

jonathanorsinger, 2020-03-21:
Hi,
I bought a jp4in1 module on AliExpress with a STM32. I want to use it with a Spektrum DX6i or DX5e, getting ppm signal from the training port. With both transmitters, I checked the output PPM signal and they look okay with the 6 channels and a frame length of 22ms.
However the signal seems not to be recognised by the module, as the blinking led at 0.5Hz says. I checked the connection on the PCB and everything is ok.
I tried with the precompiled binary for PPM and channel order TAER.
Is there a special jumper have to solder on the PCB? Or a config that must be changed in the code? My board is marked v1.2 (c) M. Blood.
Thanks for your help

pascallanger, 2020-03-21:
Hi,
Like mentionned in troubleshooting section: the https://github.com/pascallanger/DIY-Multiprotocol-TX-Module/blob/master/docs/Troubleshooting.md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 , you most likely need to insert a 4.7k resistor between the PPM pin and +5V (or +batt).
Pascal

jonathanorsinger, 2020-03-22:
Thanks for your answer,
That didn't solve the problem but I found the solution: on my board there was a diode in series on the ppm signal path pointing outwards (cathode directly connected to the ppm pin in the 5-pin socket) and short-circuiting it was the way to go. I may be wrong but it sounds like the board was designed for a transmitter with pulled-up ppm outpout, whereas Spektrum transmitters may have it pulled-down... or maybe the module was expected to be used in serial mode....
But well doesn't matter since it works now
Still thanks for your quick answer Pascal.
Cheers, Jonathan

Closed 2020-03-22.

Thread 350 (2020-05-07):

Support for the FeiYue Eagle FY-RX02 receiver (red board)

gbraad, 2020-05-07:
I got hold of a feiyue 4channel receiver (fy-rx02),  which is supposed to be used with the feiyue brushless eagle 3 kit. I do not have a transmitter ATM, but seems to work with the one for FY-06 and FY-07.

I am unable to use it with MPM, but it seems to use bk2451 rfu+mcu

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

gbraad, 2020-05-07:
It should should work with the FY-TX01 transmitter from the FY03 Eagle3

pascallanger, 2020-05-07:
Without a TX and RX in my hands there is nothing I can do...
Pascal

gbraad, 2020-05-08:
A TX is on it's way. What can I do to sniff the signals? I have access to a logic analyzer, but since this is a RF+MCU I think the 'magic' happens inside the 8051 core. Would it be possible to listen in on the signals using a nRF24L01 for instance?

pascallanger, 2020-05-08:
You can use try to follow this article: http://travisgoodspeed.blogspot.com/2011/02/promiscuity-is-nrf24l01s-duty.html

gbraad, 2020-05-13:
Transmitter arrived yesterday and works like a treat, and got some additional receivers just in case I fry one (at is seems some can't handle a BEC with 6V as Tamiya ESC do). Anyway, will try to see what i can find over the weekend. Any code that I can run from an Arduino or STM32 would be appreciate as I haven't used the nRF24's low-level that much yet (only did a makecode extension to support them and send some packets back-and-forth).

pascallanger, 2020-05-13:
You can always start from the XN297Dump protocol.

pascallanger, 2020-06-03:
Any progress? Should I keep this issue open?

gbraad, 2020-06-03:
haven't found the time to look into this yet. all the equipment and
tools I have, and assistance from Goebish, ... just some distractions
aren't easy to control.

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

--

   Gerard Braad | http://gbraad.nl

   STEM is the source, but BUILD is how you develop!
   [ Better Understanding Involves Learning and Doing ]

pascallanger, 2021-01-19:
No progress closing this issue...

knoopx, 2021-01-19:
Hey @pascallanger I'm actually revisiting this, I've got the v1 board and I'm trying to sniff packets using an nrf24. So far I'm struggling with the setup. Anyway if i make some progress I'll let you know.

gbraad, 2021-01-20:
@knoopx due to the situation I still got the radio here, so if you can share what you have tried it might be possible help can be offered.

knoopx, 2021-01-20:
@gbraad I've got a logitech unifying dongle and flashed https://github.com/marcnewlin/presentation-clickers firmware. So far I have not been able to identify the TX packets as I did not figure out the rate/channels yet.

benlye, 2021-01-20:
> @gbraad I've got a logitech unifying dongle and flashed https://github.com/marcnewlin/presentation-clickers firmware. So far I have not been able to identify the TX packets as I did not figure out the rate/channels yet.

Following.  I have a few Logitech unifying receivers laying around and never knew this was something that could be done with them.

pascallanger, 2021-01-20:
> @gbraad I've got a logitech unifying dongle and flashed https://github.com/marcnewlin/presentation-clickers firmware. So far I have not been able to identify the TX packets as I did not figure out the rate/channels yet.

To find at least one channel, use the multi scanner. You should see a couple of spikes. Take the value of one of them.

pascallanger, 2021-02-08:
Any progress? may be condiser sending me the hardware...

gbraad, 2021-02-09:
> Any progress? may be condiser sending me the hardware...

That was the idea. Wanted to give Goebish, but the pandemic prevented
me from traveling to Europe.

knoopx, 2021-03-19:
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

pascallanger, 2021-03-20:
Have you decoded one packet yet?

knoopx, 2021-03-20:
Not yet, im still learning how this whole thing works. So far I'm using universal radio hacker with a known protocol. I've been able to capture and demodulate but i have no idea how to make sense of the bitstream. I need to learn about how to decode the bit stream in order to match actual packet bytes. I guess each transceiver has its own way of encoding and modulating data and needs to be figured out? What are your tools of trade?

pascallanger, 2021-04-09:
> What are your tools of trade?

I'm using MATLAB to receive and decode the signal at a really low level by looking at the phase. Changes in the phase indicates the change from 1<->0, time between two changes gives the bitrate, then using these phase changes I decode the bit stream and rebuild in a table what could be the message. The table contains all variations MSB first, LSB first, inverted and not inverted as well as 7 bit shifts. From all these variations you need to find out which one contains most probably the message. Some stuff guide you through that and usually with 2/3 captures you have a pretty good idea.

If you do a capture on one of the RF freq using GNU radio I can easily look at it and give you the end table.

Closed 2021-09-25.

Thread 379 (2020-07-04):

Guide on how to add new protocol?

zendes, 2020-07-04:
Hi,

I've seen several people asking for new protocol support, and I'm no different. I'm looking to add support for a Mini-Z (1/27th scale race/drift car from Kyosho). I've also seen you reply with asking for an SPI dump of the transmitter, but I haven't seen a guide on exactly what and how to capture, so I can provide you all the necessary data at once (or if we get very lucky a code sample).

I do have the transmitter, it's A7106 based and the SPI pins are clearly visible (the RF chip is on a small daughter board) so capturing data shouldn't be too hard. I have a scope and a Salaea Logic 8 clone to do packet captures. What I don't have is the procedure on what & how to capture the data. I also have access to the car itself and a transmitter with a 4in1 module, so I can try any code to test it.

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

Do you have any reading material or a set of steps I can follow to get this started?

PS: this transmitter appears to be a GT2EB clone from FlySky, but [specifically made for Kyosho](https://fccid.io/WIZKT531P/Label/Label-3613497). For another FlySky transmitter (NB4) there is a firmware update that specifically adds Mini-Z as a 3rd protocol. This probably means it's based on a FlySky protocol, but slightly changed so you have to buy their brand transmitter: Kyosho does sell a programmable upgrade from the RTF one (Syncro touch KT-432PT), and [added support for this protocol to the firmware](http://kyosho.com/mini-z-info/support/settings-and-firmwaresoftware/).

pascallanger, 2020-07-04:
Hey,
Adding support for this protocol should be quite simple.
Here are the steps:
 - solder your logic analyzer to SCS, SCK, SDIO and GND
 - do a dump of the SPI bus while powering up (start recording when it is off, turn on, wait and stop recording)
 - do a separate dump where you move channels (1 dump where you move only steering, 1 dump where you move only throttle and so on for all extra channels or features)
 - do a dump of the TX in bind, you want to capture the full bind so depending how bind works you want to start recording before launching a bind
It is important to save the captures with specific names.
For adding the protocol, since you are saying it might be a derivate from flysky we will add a sub protocol instead. If it's different we will have to add a new protocol. These are 2 different things so let's first get the dumps.
Pascal

zendes, 2020-07-05:
Awesome. I'll get to work (probably in the next few days, cause 4th of July/USA) and I'll report back with the requested files.

stanislavdavid, 2020-07-07:
Is it possible to add new Frsky ACCESS protocol in future? in #239 was some documentation but nobody mentioned it from that issue.

pascallanger, 2020-07-07:
ACCESS is not on my to do list.

zendes, 2020-07-09:
Here are the requested captures. The logic analyzer channel map is:
* 0: SDIO
* 1: SCK
* 2: SCS

The transmitter doesn't have a ch3 knob, so I was only able to dump throttle, steering and ch4/lights: [spi captures kyosho kt-531p flysky mini-z.zip](https://github.com/pascallanger/DIY-Multiprotocol-TX-Module/files/4894545/spi.captures.kyosho.kt-531p.flysky.mini-z.zip)

The transmitter also doesn't have a bind button. The binding process for these cars is:
1. push & hold a button on the car, then turn it on
2. power on transmitter as normal
3. profit

I've attached a capture of the transmitter as I went through this process, but it might just be the same as the normal powerup.

pascallanger, 2020-07-09:
Something is wrong with your captures. The sample rate is too low and therefore not capturing all the bits. You need at least to quadruple it.

zendes, 2020-07-09:
Made some new captures at a much higher sampling rate. Let me know if you want me to capture at different settings or if there's anything else I can help with.

[spi captures kyosho kt-531p flysky mini-z 10MHz.zip](https://github.com/pascallanger/DIY-Multiprotocol-TX-Module/files/4899646/spi.captures.kyosho.kt-531p.flysky.mini-z.10MHz.zip)

pascallanger, 2020-07-09:
Looks much better!

pascallanger, 2020-07-09:
First quick look this is not a flysky protocol... They are sending 37 bytes where flysky sends 21 bytes.
There are 14 channels being sent! for a simple 4 channel radio...
During the first few seconds, the radio sends bind packets then normal packets.
Bind packets consist of ID followed by the RF channels table to be used in normal mode
Normal packets contains the ID and channels.
There are a number of unknown bytes but I don't think they are relevant. I've only checked the startup file so let's see with the others.

zendes, 2020-07-09:
Interesting. Maybe Kyosho commissioned it from FlySky, but wanted it to be different as to be the only source for upgraded transmitters from the RTR one? Or could there be a technical reason why they did this?

As far as I know there are no 14ch transmitters for this protocol. It's all surface/car based, and besides throttle, steering, leds & possibly gyro there isn't anything more to control on their cars. The KT-432PT (the upgrade transmitter from the RTR kit) is also listed as a 4ch transmitter.

What do you think? Should we add all 14 channels (I don't have a way to test those), or just add the first 4 and wait for someone to ask for the others? If that ever happens, the person asking should have a receiver to test the extra channels with.

pascallanger, 2020-07-10:
Please test the new protocol Kyosho in the latest version of Multi v1.3.1.39.

zendes, 2020-07-10:
Will do. I should have an answer for you in the next day or two. This went way faster than expected, so thanks!

I also found the donation button. Can't literally buy you a drink, so this will have to do... :-)

zendes, 2020-07-13:
First tests look promising. Car binds immediately and both steering and throttle work as expected. I've ordered a gyro and lights, and they should arrive in about a week. I'll report back once I confirm those work as expected too, but I don't expect any problems there. I'll keep testing (playing with the car), but I believe we can call this one done. Thanks!

pascallanger, 2020-07-13:
Can you do a 1 line description for this protocol so that I can update the protocol page?
TX models, RX models, surface protocol...

zendes, 2020-07-13:
Sure.

This is a surface protocol called FHSS. Kyosho has [4 protocols](http://kyosho.com/mini-z-info/support/radio-compatibility-information/):
* FHSS (this one), their current protocol, introduced in about 2017
* FHS: old, but still on the market in older stock (2014-2017)
* ASF/MHS: old/discontinued in about 2014

The list of available transmitters (that I know of): [KT-531P](https://rc.kyosho.com/en/82005.html) (this is the RTR one included in each box), [KT-431PT](https://rc.kyosho.com/en/82136.html) (this is the upgrade one Kyosho sells) and the Flysky [Noble NB4](https://www.flysky-cn.com/nb4) added support for this protocol in firmware 2.0.67.

Since these are 1/27th cars, they use an [integrated RX/Servo/ESC module](https://rc.kyosho.com/en/md211.html).

pascallanger, 2020-07-15:
Protocol completed, closing issue.

ekaszubski, 2021-01-13:
@pascallanger @zendes I found this page while looking to control a [1/27 "MINI-Z Buggy Sports" item code 32083KA](https://rc.kyosho.com/en/32083ka.html) which comes bundled with the [Perfex KT-19 transmitter](https://www.kyoshoamerica.com/DIS--KT-19-Transmitter-for-MINI-Z_p_23895.html).

Per [Kyosho's MINI-Z Info page](http://kyosho.com/mini-z-info/support/radio-compatibility-information), this car uses their FHS (not FHSS) protocol. I pulled apart the transmitter and found that it uses the A7106. I snooped the SPI to the RF board with a Digital Discovery and captured the binding process, startup/config process, and individual channels. [mini-z-fhs.zip](https://github.com/pascallanger/DIY-Multiprotocol-TX-Module/files/5806718/mini-z-fhs.zip)

I compared the initial config of the A7106 for FHS to other existing protocol configs in A7105_SPI and it looks identical to [FLYSKY_A7105_regs values](https://github.com/pascallanger/DIY-Multiprotocol-TX-Module/blob/master/Multiprotocol/A7105_SPI.ino#L290-L297). The binding and normal-op packets look exactly like the standard FlySky [protocol](https://github.com/pascallanger/DIY-Multiprotocol-TX-Module/blob/master/Multiprotocol/FlySky_a7105.ino#L132) with no extensions as far as I can tell. I tried binding my RadioMaster TX16S to the car in FlySky/Std mode and it worked right away, just like the KT-19.

The channel order in the packet appears to be:
1. steering
2. throttle
3. lights
4. steering travel
5. Others: not sure

The steering trim knob seems to just add an offset to the steering value while the steering travel is actually transmitted as a separate channel.

Would it be possible to add Kyosho/FHS as an alias for FlySky/Std or would it make more sense to just add a note in the documentation somewhere?

Thanks for the awesome work on this project!

Other info:

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

[a7106_datasheet_v0.1preliminary.pdf](https://github.com/pascallanger/DIY-Multiprotocol-TX-Module/files/5806721/a7106_datasheet_v0.1preliminary.pdf)

pascallanger, 2021-01-14:
@ekaszubski
I would just add it to the documentation... Plese check: https://github.com/pascallanger/DIY-Multiprotocol-TX-Module/blob/master/Protocols_Details.md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

AndreasAusD, 2021-12-28:
> MHS/ASF protocol is not discontinued. The new Mini-z Evo has a receiver of those protocols and many people, included me is using these protocols grin Would be nice to include those protocols too

I would love to see the ASF protocol. I do have some older Mini-Z and a [KT-18](https://rc.kyosho.com/en/82001ebk.html) and would like to switch to the multiprotocol module.
Took a look inside the KT-18 :
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
so it's a CYRF6936

jafc76, 2021-12-28:
Nice Pictures! Yes, the ASF and MHS protocol is using a CYRF6936.
Would be nice to integrate these two protocols 😁 I have Kyosho Dnanos that are ASF and all my Mini-z are MHS, included the new EVO cars

AndreasAusD, 2022-01-09:
i will try to figure out a way to get the small transmitter board to work when it is not mounted to the main board.
@pascallanger what signals would need to be captured on the CYRF6936 ?
MOSI / SCK / SS ?

pascallanger, 2022-01-10:
SS / SCK / MOSI / MISO and don't forget to connect the GNDs together.

AndreasAusD, 2022-01-10:
i think it is not just a transmitter board, the microcontroller is also on this board. CYRF6936 connects to the PIC16F690 on the right. Only chance on connectiong the logic analyzer will be with some probe pins on the solder pads of the PIC, everything else is way to small for soldering any wires to it.
and for that to work i need to connect the board with some adapter as the components are facing towards the main board.

steff-wink, 2022-01-28:
Hello there, I have a KT-17 controller with an ATMEGA88 chip running all the pins to an NRF24L01 transmitter chip, all pins nicely accessible. This controller is for a Kyosho Minium Edge 540 airplane. Is this running with ASF, MHS or FHS protocols? Any ideas? Does it make sense to provide some dumps?
I gotta build myself a logic analyzer, maybe I can get some dumps out in the next days. Can't remember what year I bought that plane. Should this (and the discussion about the KT-18) be a new issue?

pascallanger, 2022-01-29:
It should be a new issue since both radios are completly different. A 8 channels logic analyzer costs $5-10 on ebay...

steff-wink, 2022-01-29:
already ordered a logic anaylizer yesterday, new issue with dumps is coming on tuesday, thx for your efforts!! Maybe I can even put together a PR, but that will take some time.

Closed 2020-07-15.

Thread 380 (2020-07-05):

iRX4 Lite: Can't update via USB or via OpenTX

dgrat, 2020-07-05:
I ordered a new mutli module.
When I try to update the firmware via USB according to the docu, I get a no DFU capable device error.
When I try to update the firmware via OpenTX in the transmitter menu, I get a NoSync error.
What could be the issue?

kilrah, 2020-07-05:
Update the bootloader. https://github.com/benlye/MultiBootReloader

dgrat, 2020-07-05:
This does absolutely not work. I had partial success by using a FTDI programmer, soldering, bridging boot pins and flashing a recent version of the firmware. This enabled me to flash the firmware also via my transmitter too. However, using MULTI-BootReloader-0.1.0 does not work. Via USB I get the message below, via FTDI programmer it does not recognize the device.

	Checking for MULTI-Module ...

	MULTI-Module USB Serial device found.

	The MULTI-Module firmware will be replaced by an application which will upgrade the module's bootloader.
	Once begun, DO NOT interrupt the process, otherwise the bootloader will be corrupted and the module will not function.
	If this happens a USB-to-serial (FTDI) adapter can be used to re-program the module.

	The upgrade takes 4-5 seconds and will be complete once the LED goes off and remains off for at least 5 seconds.

	Drücken Sie eine beliebige Taste . . .

	Resetting MULTI-Module to DFU mode ...
	maple-reset 0.5
	This program is Free Sofware and has NO WARRANTY

	https://github.com/benlye/maple-reset

	Reset sequence sent to COM5
	Waiting for DFU device ............ got it.

	Device reset successful in 410ms.

	Writing MULTI-Module Bootloader upgrade app to flash ...

	dfu-util-multi 0.7

	Copyright 2005-2008 Weston Schmidt, Harald Welte and OpenMoko Inc.
	Copyright 2010-2012 Tormod Volden and Stefan Schmidt
	Copyright 2020 Ben Lye
	This program is Free Software and has ABSOLUTELY NO WARRANTY

	This version of dfu-util has been modified for flashing an STM32 MULTI-Module. It is intended for use with Flash Multi.
	Please report bugs to https://github.com/benlye/dfu-util-multi

	Filter on vendor = 0x1eaf product = 0x0003
	Opening DFU capable USB device... ID 1eaf:0003
	Run-time device DFU version 0110
	Found DFU: [1eaf:0003] devnum=0, cfg=1, intf=0, alt=2, name="UNDEFINED"
	Claiming USB DFU Interface...
	Cannot claim interface

dgrat, 2020-07-05:
I checked. Changing the bootloader via flash-multi does also not work. So I checked every combination: USB/FTDI with and without boot pins bridged. There is no way to reflash the bootloader. This means, the USB port is essentially useless.

pascallanger, 2020-07-05:
The message above shows that you have the wrong driver. You must upgrade your driver to libusk: https://github.com/benlye/flash-multi/blob/master/doc/Troubleshooting.md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
Pascal

Closed 2020-07-05.

Thread 384 (2020-07-07):

Graupner HOTT... Losing Telemetry

Andrea76it, 2020-07-07:
Hi, I have a problem with the LUA "Graupner Hott" script to configure telemetry ... the message "No Hott Telemetry" always appears
- I use an iRX4 Lite module on my FrSky XLite Pro radio
- I have updated the Module to version 1.3.1.36 (but the problem also occurs with 1.3.1.24)
- I have connected a GR-12 + 3xG Receiver
- I do corrrectly the "RF Tune"
- The Radio correctly display the telemetry sensors
- The connection is stable
- When I open the "Graupner Hott" LUA script to configure the telemetry, the message "No Hott Telemetry" always appears and the radio loses the connection with the receiver.
Why does it happen?

Andrew

pascallanger, 2020-07-07:
Which version of OpenTX?
Have you updated the firmware on your RXs?

Andrea76it, 2020-07-07:
the version of Open TX is 2.3.9
the version of GR-12 3xG is 2.02
I tried the LUA Script that came with openTx: it displays strange characters and then crashes.
I tried your LUA script and it says "No Hott Telemetry"

Thank you

pascallanger, 2020-07-07:
The LUA script with OpenTX is not different from the one posted on this github... So I'm not sure about the difference you are seeing...
I know the standard GR-12 is working since I've used to rverse the protocol and I know a few people using it. I'm not sure what's different with this 3xG... Can you try different versions on it?
After I would need a dump from the module to see the telemetry packets without this there is nothing I can do.

pascallanger, 2020-07-07:
Do you have other receivers or just this one?

Andrea76it, 2020-07-07:
#I have several receivers:
Gr-24 3xG + 3A + 3M + Vario (9DOF + Vario)
Gr-18 3xG + 3A + Vario (6DOF + Vario)
Gr-12 3xG (3DOF)
Gr-12L (Satellite Version, only SUMD and Telemetry connection)
But they are mounted on model aircraft. Tomorrow evening I try to take one off and test it with a different model.
All receivers are updated to the latest firmware version.
The abbreviation 3xG indicates the presence of a Gyro on board the receiver. They are the newest versions.

I'm not sure that the two LUA scripts are identical, because they have different sizes in kb.

How can I do a dump from the module?

Thanks Andrea

robustini, 2020-07-08:
@Andrea76it maybe you're doing something wrong.
I use a GR18 regularly without any problem, the firmware is not even the latest, I still have 2.00 and 2.04 is available.

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

Andrea76it, 2020-07-08:
Hi pascallanger,
Hello Marco,
I did some tests with different receivers and I got this result:

Gr-12 3xG: does not work, the message "No Hott Telemetry ..." appears even though the sensors are correctly recognized in the Telemetry menu of FrSky. (Photos 1 and 2)

Gr-18 3xG + 3A + Vario: the receiver is correctly recognized, I manage the RX menu correctly, but I don't see the "GAM-4S Lipo" sensor, I only see the Vario sensor on board the receiver. (Photos 3)

Gr-12L (Satellite Version): the receiver is recognized correctly, I manage the RX menu correctly, but I don't see the "GAM-4S Lipo" sensor

Some idea?
I am attaching the photos

Regards, Andrea
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

pascallanger, 2020-07-08:
Are you sure you can't see the gam? You need to cycle through the connected sensors. Have you done it?

Andrea76it, 2020-07-08:
Hi, I solved the problem with the GAM sensor on the GR-18 receiver. It depended on the fact that the receiver was powered at 7.4v. I tried to power the 5v receiver and now the sensor is recognized correctly. This particular sensor (Lipo Cells) is powered by the receiver. Very strange, because the receiver can be powered up to 8.4v.
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

Instead, I have not solved the "No Hott telemetry ..." problem on the GR-12 3xG. I also tried another receiver of the same model (Art. No. 33576) and it behaves in the same way. I also tried to overwrite the firmware in case it wasn't the latest version, but nothing has changed. I am using the latest firmware version 2.02. Damn!
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

I'm trying another solution, that of building a Hott to SmartPort telemetry converter (Using a Teensy 3.2 with 2 serial ports), in order to use Hott Sensors attached directly to the FrSky receiver ... but it is very complex.

pascallanger, 2020-07-08:
As said previously, you need to dump the telemetry stream so I can see what this RX is sending...

Andrea76it, 2020-07-08:
can you tell me how can i do it?

robustini, 2020-07-08:
>
>
> can you tell me how can i do it?

https://github.com/pascallanger/DIY-Multiprotocol-TX-Module/blob/master/docs/Advanced_Debug.md

Andrea76it, 2020-07-08:
Thanks ... now I try!

robustini, 2020-07-09:
>
>
> Thanks ... now I try!

Capture 100/200 lines and copy them here.

Andrea76it, 2020-07-10:
Multiprotocol version: 1.3.1.37
Protocol selection switch reads as 0
Using bank 0
Read ID from EEPROM
Module Id: 6552e140
Init complete
RXID:  00 00 02 82 A0
Protocol selected: 57, sub proto 0, rxnum 4, option 30
Proto=HoTT, nbr_sub=2, Sub=Sync  , Opt=2
T1= 00 00 62 31 3F 62 00 31 00 00 00 62
T0= 00 01 00 00 00 00 00 00 00 00 00 00
Sensor:0D
T1= 00 00 64 31 3E 64 00 31 00 00 00 64
T0= 00 01 00 00 00 00 00 00 00 00 00 00
Sensor:0E
T1= 00 00 69 31 3F 69 00 31 00 00 00 69
T0= 00 01 00 00 00 00 00 00 00 00 00 00
Sensor:09
T1= 00 00 63 31 3E 63 00 31 00 00 00 63
T0= 00 01 00 00 00 00 00 00 00 00 00 00
Sensor:0A
T1= 00 00 5B 31 3F 5B 00 31 00 00 00 5B
T0= 00 01 00 00 00 00 00 00 00 00 00 00
Sensor:0B
T1= 00 00 61 31 3E 61 00 31 00 00 00 61
T0= 00 01 00 00 00 00 00 00 00 00 00 00
Sensor:0C
T1= 00 00 64 30 3F 64 00 30 00 00 00 64
T0= 00 01 00 00 00 00 00 00 00 00 00 00
Sensor:0D
T1= 00 00 69 30 3F 69 00 30 00 00 00 69
T0= 00 01 00 00 00 00 00 00 00 00 00 00
Sensor:0E
T1= 00 00 63 31 3F 63 00 30 00 00 00 63
T0= 00 01 00 00 00 00 00 00 00 00 00 00
Sensor:09
T1= 00 00 5A 31 3F 5A 00 30 00 00 00 5A
T0= 00 01 00 00 00 00 00 00 00 00 00 00
Sensor:0A
T1= 00 00 62 31 3E 62 00 30 00 00 00 62
T0= 00 01 00 00 00 00 00 00 00 00 00 00
Sensor:0B
T1= 00 00 66 31 3F 66 00 30 00 00 00 66
T0= 00 01 00 00 00 00 00 00 00 00 00 00
Sensor:0C
T1= 00 00 6A 31 3F 6A 00 30 00 00 00 6A
T0= 00 01 00 00 00 00 00 00 00 00 00 00
Sensor:0D
T1= 00 00 64 31 3F 64 00 30 00 00 00 64
T0= 00 01 00 00 00 00 00 00 00 00 00 00
Sensor:0E
T1= 00 00 5C 31 3F 5C 00 30 00 00 00 5C
T0= 00 01 00 00 00 00 00 00 00 00 00 00
Sensor:09
T1= 00 00 64 31 3F 64 00 30 00 00 00 64
T0= 00 01 00 00 00 00 00 00 00 00 00 00
Sensor:0A
T1= 00 00 5C 31 3F 5C 00 30 00 00 00 5C
T0= 00 01 00 00 00 00 00 00 00 00 00 00
Sensor:0B
T1= 00 00 66 31 3F 66 00 30 00 00 00 66
T0= 00 01 00 00 00 00 00 00 00 00 00 00
Sensor:0C
T1= 00 00 5D 30 3E 5D 00 30 00 00 00 5D
T0= 00 01 00 00 00 00 00 00 00 00 00 00
Sensor:0D
T1= 00 00 67 31 3F 67 00 30 00 00 00 67
T0= 00 01 00 00 00 00 00 00 00 00 00 00
Sensor:0E
T1= 00 00 5E 31 3E 5E 00 30 00 00 00 5E
T0= 00 01 00 00 00 00 00 00 00 00 00 00
Sensor:09
T1= 00 00 67 30 3F 67 00 30 00 00 00 67
T0= 00 01 00 00 00 00 00 00 00 00 00 00
Sensor:0A
T1= 00 00 5E 31 3F 5E 00 30 00 00 00 5E
T0= 00 01 00 00 00 00 00 00 00 00 00 00
Sensor:0B
T1= 00 00 68 31 3F 68 47 30 00 00 00 68
T0= 00 01 00 00 00 00 00 00 00 00 00 00
Sensor:0C
T1= 00 00 67 31 3F 67 47 30 00 00 00 67
T0= 00 01 00 00 00 00 00 00 00 00 00 00
Sensor:0D
T1= 00 00 61 31 3E 61 47 30 00 00 00 61
T0= 00 01 00 00 00 00 00 00 00 00 00 00
Sensor:0E
T1= 00 00 68 31 3F 68 47 30 00 00 00 68
T0= 00 01 00 00 00 00 00 00 00 00 00 00
Sensor:09
T1= 00 00 60 31 3E 60 47 30 00 00 00 60
T0= 00 01 00 00 00 00 00 00 00 00 00 00
Sensor:0A
T1= 00 00 68 31 3E 68 47 30 00 00 00 68
T0= 00 01 00 00 00 00 00 00 00 00 00 00
Sensor:0B
T1= 00 00 69 31 3F 69 47 30 00 00 00 69
T0= 00 01 00 00 00 00 00 00 00 00 00 00
Sensor:0C
T1= 00 00 64 31 3F 64 64 30 00 00 00 64
T0= 00 01 00 00 00 00 00 00 00 00 00 00
Sensor:0D
T1= 00 00 5E 31 3F 5E 64 30 00 00 00 5E
T0= 00 01 00 00 00 00 00 00 00 00 00 00
Sensor:0E
T1= 00 00 62 31 3F 62 64 30 00 00 00 62
T0= 00 01 00 00 00 00 00 00 00 00 00 00
Sensor:09
T1= 00 00 64 31 3E 64 64 30 00 00 00 64
T0= 00 01 00 00 00 00 00 00 00 00 00 00
Sensor:0A
T1= 00 00 67 30 3E 67 64 30 00 00 00 67
T0= 00 01 00 00 00 00 00 00 00 00 00 00
Sensor:0B
T1= 00 00 64 31 3F 64 64 30 00 00 00 64
T0= 00 01 00 00 00 00 00 00 00 00 00 00
Sensor:0C
T1= 00 00 60 31 3F 60 64 30 00 00 00 60
T0= 00 01 00 00 00 00 00 00 00 00 00 00
Sensor:0D
T1= 00 00 64 31 3E 64 64 30 00 00 00 64
Busy 25
Busy 52
Failsafe received
Busy 33
Busy 52
Busy 21
Busy 26
Busy 28
Busy 26
Busy 68
Failsafe received
Busy 58
Busy 27
Busy 29
Busy 74
Failsafe received
Busy 18
Busy 25
Failsafe received
Busy 52
Busy 28
Busy 28
Busy 50
Busy 32
Busy 26
Failsafe received
Busy 50
Busy 22
Busy 27
Busy 22
Busy 29
Failsafe received
Busy 26
Busy 18
Busy 45
Busy 48
Busy 46
Busy 21
Failsafe received
Busy 25
Busy 52

Andrea76it, 2020-07-10:
At line 122 I pressed on "Graupner Hott" LUA script.

Andrea

pascallanger, 2020-07-11:
The RX is not replying to the config text mode request...
Have you tried to use this RX with the NO_SYNC subprotocol? what happens if in this mode you launch a text config?

Note that you have failsafe activated which is going to introduce jitter on your servos/channels: https://github.com/pascallanger/DIY-Multiprotocol-TX-Module/blob/master/Protocols_Details.md#HoTT---57

Andrea76it, 2020-07-11:
It works!!!!
I have activated the No_Sync option and now it works correctly.
What is the difference between Sync and No_Sync? the polling of the sensors?
Andrea

pascallanger, 2020-07-11:
Humm, strange behavior compared to all other RXs.
No_sync is for no telemetry sync transmission. I recommend flying in sync mode for best telemetry performance.
I need more details to get an idea of what's happening.
With the power turned on on the RX at all time, what happens if you use first use sync, then switch the sub protocol to no_sync? First does the telemetry still get to the TX after the switch? Second can you access text config mode?

pascallanger, 2020-07-14:
@Andrea76it Have you tested?

Andrea76it, 2020-07-16:
Hi Pascal, sorry if I didn't answer you before, but I was busy at work and I was unable to take the tests you asked for. During the weekend I will perform all the tests and send you a detailed feedback.
Greetings, Andrea

Andrea76it, 2020-07-21:
Hi Pascal, these days I have done several tests.
If I change from Sync Mode No_Sync Mode I lose the connection with the receiver and I have to restart both the RX and the TX.

This is my configuration.
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

I can only access Text Mode if I'm in No_Sync mode.

I did another test: if I send many commands at the same time, sometimes it loses the connection and the signal goes to zero.
I lose both telemetry and the main radio signal that controls the servos.
I am attaching two sample videos, both of the telemetry and of the main screen.

https://youtu.be/3WhiqBn_x18

https://youtu.be/a7KtWzqC5zA

I don't think it's appropriate to fly with this receiver.

HazzaHFPV, 2020-07-21:
Failsafe in the radio has to be set to "receiver", otherwise it will interfere with the link. If I translate correctly it is set to "hold" in your case.

To set Failsafe correctly with the Hott protocol you have to set your Failsafe configuration once. These settings are then send to the receiver and the receiver saves them. Once this has happened you have to set Failsafe to "receiver", otherwise the Failsafe settings are send to the receiver in a regular time interval and disrupts the reaction shortly as the receiver saves the settings each time. It then looks like regular small failsafes as in your video. I hope O could explain it well as I made the same mistake in the beginning. It is written in the documentation:

https://github.com/pascallanger/DIY-Multiprotocol-TX-Module/blob/master/Protocols_Details.md#hott---57

"Failsafe MUST be configured once with the desired channel values (hold or position) while the RX is up (wait 10+sec for the RX to learn the config) and then failsafe MUST be set to RX/Receiver otherwise the servos will jitter!!!"

Closed 2020-08-25.

Thread 385 (2020-07-12):

GRAUPNER HOTT RX Mode - & Binding Time More an Request then an issue

Xillius178, 2020-07-12:
Hello,
would it be possible to install a "GRAUPNER HOTT RX" mode like that of FRSKY RX, FLYSKY RX, or DSM RX?

My ulterior motive:
Could friends who have a Graupner radio control fly with me as student,
since I also have an external module for the transmission?

Second:
What I noticed
the binding time has been reduced considerably.
As soon as I pressed the bind button (to bind an FRSky receiver), it only lasts about 10 seconds,
it would be nice if it lasted a little longer, maybe 20 or 30 seconds.

Background, since I have arthritis, I can no longer react so quickly with my hands.
So that's a big obstacle for me and maybe for other too.

Would be Super Pascal if you could incorporate that ...
Thank you for the rapid development of the code.
A lot has developed in a year.

Greetings Xillius

kilrah, 2020-07-12:
Bind time doesn't affect anything since you can put the receiver in bind mode before initiating bind on the radio.

Xillius178, 2020-07-12:
Tell me colleague what problem do you have?
Do you have to add your mustard to every message I write?
And no helpful criticism, or even expected help.

You don't seem to get it?

With some receivers I have to hold the bind button when switching on.
So and then I should press the OK button on the transmitter with the third hand, and that with my illness.

Better you show me that first, and then we'll talk about it again.

Unbelievable how you can simply ignore another person's disability.

kilrah, 2020-07-12:
What protocol requries you to hold the bind button while starting bind on the radio? Don't know of one.

pascallanger, 2020-07-12:
1. A RX for the HoTT protocol is not possible since the hopping table also has not been reversed completely.
2. Which protocol do you need me time to bind? For almost all protocols you can put the RX in bind then launch a bind on the TX.

HazzaHFPV, 2020-07-12:
I think there might be a misunderstanding. As you mentioned FrSky earlier:
To put FrSky receivers into bind you have to hold the bind/Failsafe button on the receiver, then power up the receiver. Then you can release the button, you don't have to keep it pressed.

Then you have all the time in the world to press bind on your transmitter.

The trainer function with Graupner works fine with  simple trainer cable (3.5mm audio jack), assuming your friends have a DSC-port on their Graupner Radio. It is not wireless, but it works. I have tested it between Graupner MZ-24 and Jumper T16.

On a final word: I don't think @kilrah was being disrespectful, he just simply pointed out that most receivers don't need the button to be pressed for the whole binding process. Kilrah is a driving and helpful force in development in our hobby and was simply being objective in his reply, it was not personal. Your reaction, however, was personal and impolite.

So, thank you @pascallanger and @kilrah for doing what you do and being so patient and understanding along the way.

pascallanger, 2020-07-14:
@Xillius178 Is there something to do or should I close this issue?

pascallanger, 2020-07-15:
No answer, closing

Closed 2020-07-15.

Thread 387 (2020-07-13):

Devo telemetry not working with RX705

kristjanbjarni, 2020-07-13:
I have been testing the new Devo telemetry with my Walkera QR X350 Pro which is using the Devo RX705 receiver. The problem is that I get just fixed values. A1, A2 shows 0.0V and the RSSI shows 93, but this doesn't change at any time. When I turn off the quadcopter I get "Telemetry lost" on the remote so something is obviously being sent. On the original remote Devo F12E, I can get the battery voltage and the GPS coordinates which I am very interested in getting. Is there any way I can help in debugging this?

pascallanger, 2020-07-15:
I'll check what's happening with the voltage. Adding GPS will be a major change...

pascallanger, 2020-07-16:
@kristjanbjarni
Which radio do you have?
On your Devo F12E where do you see the battery voltage appearing? volt1, volt2 or volt3? only volt1 and volt2 are displayed so I'm wondering if your value is in volt3...
93 is the max rssi value, it goes from 93 down to 0 in steps of 3. Are you sure when you get the quad away from the remote (or a couple of walls apart) that this value doesn't change?

kristjanbjarni, 2020-07-16:
I have the Jumper T16 Pro V2

But sorry it seems I was mistaken. I was checking with a battery on storage voltage 3.8v and it showed as 0.0, but when I tested with a battery that was at 3.9v, then A2 showed as 0.4v. After I changed the ratio to 1470 then it matched the actual voltage under load. I also tested the RSSI and you are correct after I moved away and a couple of walls it went down to about 60 before loosing telemetry. However there seems to be a problem with the voltage, I tried running the quadcopter under load for a few minutes and after some minutes the voltage dropped to 0.0 but when stopping the motors it went back up to correct voltage. Not sure if it's just a problem with the voltage monitor on my end or how the telemetry is configured.

richardclli, 2020-07-27:
Current Devo telemetry only works with Micro helis like MiniCP, V120D02S.  Full telemetry is not supported yet.  The current implementation of OpenTX and Multi-protocol splits telemetry capturing (in multi-module source code) and telemetry decoding (in OpenTX code), adding Devo full telemetry need to change both multi-protocol code and OpenTX code.

And the key is that I do not have the Walkera telemetry hardware to test the telemetry implementation.  If you can help, I can see if I can work this out.

kristjanbjarni, 2020-08-03:
I didn't know that the V120D02S had telemetry (I own one myself) or is that some added hardware?

Anyway I actually have a spare RX705 receiver that I could gift and mail to you or possibly sponsor a RX705 receiver bought locally? if you want. Although not sure if having only the receiver is enough for testing. But I think it's possible to hook up any standard NMEA (or Ublox?) GPS to the telemetry input on the RX705 to get live GPS coordinates.

richardclli, 2020-08-04:
Yes, MiniCP has telemetry, V120D02S has telemetry but need to upgrade firmware to activate if your firmware is old, not sure if it is still available now.

Anyway, I will try to port and build the original Devo telemetry support from Deviation and see if this works for you.  Please help me to test it out once it is ready.  The full telemetry support is already there in Deviation source code, it includes temperatures, voltages, and GPS information.  But the porting need to modify both the multiprotocol source code and opentx source code, so it means more works and need to flash both the radio and the RF module to activate.

richardclli, 2021-03-01:
@pascallanger Hey, saw that you have committed DEVO telemetry changes.  I will test it out this weekend. ^.^

pascallanger, 2021-03-01:
@richardclli That would be perfect. Do you have sensors (temperature, RPM, voltage) and GPS?
I've done quite some modifications which I have no idea if they work (I hope so) and if I've broken something (I hope not)...

pascallanger, 2021-03-02:
I've tested like I could almost everything and I think I have something working, please report.

pascallanger, 2021-04-18:
Completed

khmewes, 2023-07-16:
I know this is closed, but can I get some insight from you on the telemetry port of the RX705 receiver. What sensor would work with it (Voltage, GPS etc.) I am using the RX705 as receiver with a Fly Wing H1 controller connected via the sbus data port (in a modded Walkera V450D01) and it works fine with the devo protocol on the RM TX16S.  I get RSSI but no voltages. What sensors/interface would be needed to get voltage and perhaps GPS to work?

pascallanger, 2023-07-17:
All the supported sensors are in the doc : https://github.com/pascallanger/DIY-Multiprotocol-TX-Module/blob/master/Protocols_Details.md#devo---7

khmewes, 2023-07-18:
Thanks Pascal.

I was more looking for info about the interface type of the RX705 telemetry port, i.e. sbus, ibus or general serial port. Whatever Walkera designed there. I wanted to connect a voltage sensor like the FlySky FS-CVT01 ibus based one, but it wasn’t recognized at first then I inverted the signal and the led stayed on. But no communication with the transmitter (TX16S). The CVT01 connected to the FS-i6AB receiver sensor port shows up as A3 in the telemetry list with the FlySky protocol. So is this even possible with the RX705 and Devo or does this only work in combination with the Walkera QRX350 flight controller. If so I will just give up on the whole thing and use the FS-i6A receiver instead. But that’s no fun for us tinkerers.

Cheers,

Klaus

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

pascallanger, 2023-07-19:
I have no idea. This is the wrong place to search for this information. You should try on some Devo forums.

Closed 2021-04-18.

Thread 405 (2020-07-29):

Radiomaster TS16X & FrSky G-RX6 receiver

JCOFlyer, 2020-07-29:
I am fairly new at this Open TX stuff but I can follow along and have used some youtube videos to help. I cant get the Radiomaster to bind with Frsky G-RX6. So i tried updating the receiver to the latest only to find that may have "broken" it. Frsky says to go under "downloads to get the old firmaware. So i did but it still doesnt work. Im running Open TX 2.3.9. Multiprotocol firmware was updated to 1.3.1.36 AETR no inv. stable and flashed to internal. Receiver was updated using external port (from botom up; signal, power, ground) ACCST D16 2.1.2 dated 07-14-2020 (NOT ACCESS) but later reverted (I think) to whatever 181025 is under their "history firmware download".

kilrah, 2020-07-29:
From the bottom the module slot pinout is signal, ground, power. Needs a cable with swapped leads. If you put a straight cable you reversed polarity to the receiver.

JCOFlyer, 2020-07-30:
I spoke from memory. But yes you are correct. I had to swap the pens around and it is signal ground and power. Also the lights start flashing the reciever. It seems to be writing firmware to it. It finishes up in about a minute and a half or so. Either way it doesn’t seem to work with either firmware.

Sent from my iPhone

On Jul 29, 2020, at 1:58 PM, Andre Bernet <notifications@github.com<mailto:notifications@github.com>> wrote:

From the bottom the module slot pinout is signal, ground, power. Needs a cable with swapped leads. If you put a straight cable you reversed polarity to the receiver.

—
You are receiving this because you authored the thread.
Reply to this email directly, view it on GitHub<https://github.com/pascallanger/DIY-Multiprotocol-TX-Module/issues/405#issuecomment-665923759>, or unsubscribe<https://github.com/notifications/unsubscribe-auth/AQN3NH26AIBN4TM5V2MSE73R6CEQFANCNFSM4PL6JRXA>.

zendes, 2020-07-30:
Can you post the exact file name you downloaded from FrSky (.zip) and the
file you're flashing (.frk)? That should help identify which version &
flavor of ACCST you have on the receiver.

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

JCOFlyer, 2020-07-30:
The first one is G-RX6_ACCST_2.1.2_FCC.frk. The one I tried reverting it to is G-RX6_FCC_181025.frk. I finally found a friend who has a QX7. We were able to bind to it. I will add that although we did bind it I did not have any movements in the servos.  I'll give the RadioMaster another chance when I get home if I can.

zendes, 2020-07-30:
ok, so these are both FCC flavors, but different versions of ACCST. For G-RX6_FCC_181025.frk you need to bind with FrskyX, sub CH_16 or CH_8 and for G-RX6_ACCST_2.1.2_FCC.frk you need FrskyX2, same sub protocols

JCOFlyer, 2020-08-01:
All right so I tried the 1.8X but I noticed that there was no FrSkyX only FrSky and FrskyX2. I tried them out either way. I updated the firmware to 2.1.2 for the FrSkyX2 D16 telemetry on 1-8 still was unable to bind. I was really hopeful that this was it. Please help. Not sure what else to do.

Sent from my iPhone

On Jul 30, 2020, at 1:00 PM, Dennis Marinus <notifications@github.com<mailto:notifications@github.com>> wrote:

ok, so these are both FCC flavors, but different versions of ACCST. For G-RX6_FCC_181025.frk you need to bind with FrskyX, sub CH_16 or CH_8 and for G-RX6_ACCST_2.1.2_FCC.frk you need FrskyX2, same sub protocols

—
You are receiving this because you authored the thread.
Reply to this email directly, view it on GitHub<https://github.com/pascallanger/DIY-Multiprotocol-TX-Module/issues/405#issuecomment-666649466>, or unsubscribe<https://github.com/notifications/unsubscribe-auth/AQN3NH6PVJPLGVD36DHQX33R6HGMZANCNFSM4PL6JRXA>.

pascallanger, 2020-08-01:
Binding a RX is really easy. I'm wondering what you are doing wrong...
Here are the steps:
1. Power on the RX while pushing the bind button, wait 1-2 sec then release the button -> the RX's LED should act differently while in bind mode
2. Power on the TX
3. Create a new model
4. Select Multi FrSkyX2 D16
5. Press the bind button on the same page
6. Wait for the RX LED pattern to change
7. Power off the RX
8. Power on the RX
9. Done

JCOFlyer, 2020-08-01:
YES!!!!!!! Thank you. So the telemetry light going off really threw me off. Feel stupid now. Spektrum to Frsky transition has been weird. Although I wouldn’t have guessed the protocols anyways. Very much appreciate all you guys and your help. I’ll be donating to the project for sure!!

Sent from my iPhone

On Aug 1, 2020, at 1:15 AM, pascallanger <notifications@github.com<mailto:notifications@github.com>> wrote:

Binding a RX is really easy. I'm wondering what you are doing wrong...
Here are the steps:

  1.  Power on the RX while pushing the bind button, wait 1-2 sec then release the button -> the RX's LED should act differently while in bind mode
  2.  Power on the TX
  3.  Create a new model
  4.  Select Multi FrSkyX2 D16
  5.  Press the bind button on the same page
  6.  Wait for the RX LED pattern to change
  7.  Power off the RX
  8.  Power on the RX
  9.  Done

—
You are receiving this because you authored the thread.
Reply to this email directly, view it on GitHub<https://github.com/pascallanger/DIY-Multiprotocol-TX-Module/issues/405#issuecomment-667493457>, or unsubscribe<https://github.com/notifications/unsubscribe-auth/AQN3NHYL4HLFZPO5F32JAQDR6PFJFANCNFSM4PL6JRXA>.

pascallanger, 2020-08-02:
With multi the bind process is the same whatever protocol you use.

Closed 2020-08-02.

Thread 415 (2020-08-15):

XK K110 servo stuttering

PKhair, 2020-08-15:
Using IRX4+ module on release 1.3.1.49. Radio is Graupner MX22 with module running in PPM mode.  I'm getting a periodic and quite important cyclic servos stuttering every second or so, which makes the flight impossible. Binding is very consistent and fast, range looks good.

I tried everything suggested on the forum and docs, I performed frequency tuning, and tried tweaking SFHSS_DATA2_TIMING with no luck. Also tried getting back to 1.3.1.24 release or using pre-compiled binaries from https://downloads.multi-module.org/ and getting the exact same behavior. In order to rule out possible transmitter issue I tried HOTT & DSMX receivers with servos and everything just works perfectly. Looks like a specific issue with K110 receiver or SFHSS protocol. Any suggestion or help would be much appreciated.

pascallanger, 2020-08-16:
Not sure what your issue is. The k110 works perfectly fine. This is my favorite heli and flying it a lot along with the k123 and e160. Loads of people are flying helis with this  protocol with no issues.
Do you have the original k110 radio to test?
I killed once a k110 main board in a bad crash. It was still working but time to time the servos will just stop responding or go to failsafe for a split second. But it became worse with time to a point where the main motor kept spinning even with the radio off... I was able to reproduce the behavior by slightly bending the board. Vibrations were able to do this in flight.

PKhair, 2020-08-16:
Hello Pascal, it works and flies perfectly fine with the original K110 radio. I made a few checks for cracks bending an gently tapping on the PCB, but everything works reliably. I captured two short videos enclosed demonstrating the issue. One with the original X6 radio delivered with K110 (X6_radio.mp4), and one with IRX4 module (IRX4_module.mp4). Note they are zipped as github does not like video attachment.
[X6_radio.zip](https://github.com/pascallanger/DIY-Multiprotocol-TX-Module/files/5080643/X6_radio.zip)
[IRX4_module.zip](https://github.com/pascallanger/DIY-Multiprotocol-TX-Module/files/5080649/IRX4_module.zip)

pascallanger, 2020-08-16:
Hummm it's worse than what I thought you were describing earlier... It's there all the time. I've never seen this!
I'm wondering what's causing it. It's really specific to your setup.
What's the supply voltage of the module?
How is the module connected to the graupner?
What's the LEDs at the back of the module do?

PKhair, 2020-08-16:
Yeah, it's pretty bad indeed :-(

Module is inserted in the slot behind the radio in place of the legacy FM transceiver. Old Graupner/JR radios were manufactured by JR and are equiped with a standard JR slot. Supply is thru the radio, powered with 8 cell Nimh battery, voltage measured is 11.4V. The 2 leds when module operates are solid green & solid red.

One thing which might matter,  the radio can output either PPM18 or PPM24 frames. I tried both, and behavior is the same with each configuration (looking at the PPM ISR routine it should not matter as input is clamped to 16 channels anyway).  I doubt the radio is faulty as it works fine with the same module using HOTT & DSMX receivers (smooth servo output, no stuttering).

pascallanger, 2020-08-17:
I don't have an idea of what's going on.
Things you can try:
- disable failsafe in _config.h by commenting this line: https://github.com/pascallanger/DIY-Multiprotocol-TX-Module/blob/e8037c857ff4191f232ca438baa6acf5c4beb614/Multiprotocol/_Config.h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
- increase the signal loss delay from 70 to 1000: https://github.com/pascallanger/DIY-Multiprotocol-TX-Module/blob/e8037c857ff4191f232ca438baa6acf5c4beb614/Multiprotocol/Multiprotocol.ino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

PKhair, 2020-08-18:
I did not have a chance to recompile the code with the various tweaks you suggested yet.  In the meantime, I had a chance to try the exact same module running in serial mode in a Horus X10 radio, and... everything worked perfectly with my K110 !

I also tried with the Horus to run the module in PPM mode, tyring 8 channels and 16 channels output. Again everything works as a charm, no stutteing, smooth servos responce. I guess there is something funky going on with my Graupner MX22 radio, might be worth probing PPM signal with a scope to see what's going on there. I believe we can close the issue.

Many thanks for your support and suggestions!

Closed 2020-08-18.

Thread 417 (2020-08-18):

Sketch too big (SMT32) & a hardware problem

Strat00s, 2020-08-18:
Hey guys. I wanted to update my (probably) jumper clone module (JMT jp4in1) using the arduino method, as using the flash multi tool shows me an error (either error reading or error erasing the module). So I went with the arduino method. Got Arduino IDE 1.8.9, downloaded the repo -> multiprotocol.ino -> verify (just to make sure, that everything works). And here comes the problem. It says, that the sketch is too big.
`Sketch uses 122840 bytes (101%) of program storage space. Maximum is 120808 bytes.
Global variables use 5128 bytes (25%) of dynamic memory, leaving 15352 bytes for local variables. Maximum is 20480 bytes.
Sketch too big; see http://www.arduino.cc/en/Guide/Troubleshooting#size for tips on reducing it.
Error compiling for board Multi 4-in-1 (STM32F103CB).`
So, what am I doing wrong? (also, any idea why the multi flash is giving me the errors?)
<details>
  <summary>Images</summary>

  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

</details>

kilrah, 2020-08-18:
Comment out some protocols you'll have no use for.

Strat00s, 2020-08-18:
> Comment out some protocols you'll have no use for.

Ok, no problem. But does that mean, that the SMT32's memory is no longer enough?

Strat00s, 2020-08-18:
Now it compiles, but it seems like the problem is with my module :(
The arduino says pretty much the same stuff as the multi flash. Except that it specifices, what the problem is (Module in BOOT0 mode not found on COM13).
Gotta search somewhere else then :/

pascallanger, 2020-08-18:
Open the module and do pictures of the internal to see what this new module looks like.
If it's like the other you must only plug the USB cable and not power it from the radio to be able to flash it. What are the LEDs doing when you do this?

Strat00s, 2020-08-18:
> Open the module and do pictures of the internal (close pictures of both sides) to see what this new module looks like.
> If it's like the others you must only plug the USB cable and not power it from the radio to be able to flash it. What are the LEDs doing when you do this?

Looks just like jumper 4in1, except it's a newer board revision (I guess). And I am powering it from the USB only. Only the green LED lights up that way.
<details>
  <summary>Spoiler!</summary>

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

</details>

pascallanger, 2020-08-18:
It should work with the LEDs as you describe...
One thing I've noticed is that the module is on port COM12 in the first picture, but the message is pointing to
"Module in BOOT0 mode not found on COM13"

Strat00s, 2020-08-18:
> It should work with the LEDs as you describe...
> One thing I've noticed is that the module is on port COM12 in the first picture, but the message is pointing to
> "Module in BOOT0 mode not found on COM13"

Yea that. Copied that when trying to use seperate serial to usb converter. It is always the same com port however

pascallanger, 2020-08-18:
I mean there is no mystery. Plugging the USB cable is setting boot0 which forces the STM32 to go in bootloader and the USB to serial adapter is interfacing with it.
The thing you can try is to connect on the PCB 3.3v and boot0 before plugging the USB cable.

Strat00s, 2020-08-18:
> I mean there is no mystery. Plugging the USB cable is setting boot0 which forces the STM32 to go in bootloader and the USB to serial adapter is interfacing with it.
> The thing you can try is to connect on the PCB 3.3v and boot0 before plugging the USB cable.

Tired that. Same outcome. :(

pascallanger, 2020-08-18:
You must be doing something wrong. Is it really the right com port? Do you have the right driver?

Strat00s, 2020-08-18:
> You must be doing something wrong. Is it really the right com port? Do you have the right driver?

I am pretty sure that it is the correct com port. When I connect the module via USB, device manager shows new device on COM12 with the CP210X adapter (which is the one on the board).
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

benlye, 2020-08-18:
Not sure I can think of much else to try.  Seems like there must be a hardware fault with the module.  Maybe try re-flowing the solder on the USB port pins?

If the green LED is on and the red LED is off when USB is plugged in it has power and seems to be in BOOT0 mode. If you've tried wiring the BOOT0 pin directly to 3.3V before plugging the USB cable in then it really must be in BOOT0 mode.

I'd look closely at the USB port D+ and D- pins, the CP2102, and the traces to the RX and TX pins on the STM32.

Strat00s, 2020-08-18:
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

I tried searching for the STM32's pins, but couldn't find anything useful. Do you know, which ones are RX and TX?

benlye, 2020-08-18:
This image is accurate.  You want USART1 (PA9 and PA10) when in BOOT0 mode.
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

https://i.stack.imgur.com/uEky4.jpg

Strat00s, 2020-08-18:
Then it should work. Checked the usb with CP2102 and CP2102 via multimeter with continuity and everything checks out :/

benlye, 2020-08-18:
Have you tried different USB cables?  Different USB ports?  Do you have a powered hub you could plug the module in via?

Strat00s, 2020-08-18:
> Have you tried different USB cables? Different USB ports? Do you have a powered hub you could plug the module in via?

Tried different cables and USB ports. I doubt that it's gonna be power. How much does it eat, that USB3.0 isn't enough? But I can surely try it.

benlye, 2020-08-18:
Yeah, I'm just running through the list of things I can think to try.  I think you have a faulty module because 99% of the time all that's needed is plugging in the USB cable.

Can you flash it from your radio?  No idea if it has the necessary bootloader installed, but it's worth trying.

Strat00s, 2020-08-18:
> Yeah, I'm just running through the list of things I can think to try. I think you have a faulty module because 99% of the time all that's needed is plugging in the USB cable.
>
> Can you flash it from your radio? No idea if it has the necessary bootloader installed, but it's worth trying.

External power didn't change anything. And I currently don't have a radio (waiting for a new one, which should arrive in a few days). So once I have it, I can try it, I might also try "tiny soldering" and wire external converter to test that, as there are no headers for rx and tx.

Strat00s, 2020-08-18:
Update (kinda not tho)
Tiny soldering did, once again, nothing. When I power it from the external adapter without the jumper, the red LED starts flashing rapidly and then blinks slowly. Powering it with the jumper on (boot0 - 3.3v), only green LED lights up (as it should), but arduino gives me still the exact same error.

Strat00s, 2020-08-18:
Wow, just wow. Tried it on a different PC (because why not at this point). And it works like a charm there. What the heck? What's wrong with my PC then? 😠 Everything else I have does work no problem (AVR, SAMD, ESP) but this just won't...
I guess I can close this issue now for sure (but still gonna wait for someone's response, just to make sure)

Tygrys-1, 2020-08-19:
Maybe the USB drivers for STM32?

pascallanger, 2020-08-19:
There is no USB driver for STM32. The only driver in question here is the CP2102 which must but in trouble on the laptop.

Strat00s, 2020-08-19:
> There is no USB driver for STM32. The only driver in question here is the CP2102 which must but in trouble on the laptop.

Device manager recognizes the CP2102 and I have an external programmer with the CP which does work (for arduino tho). It is quite strange.

pascallanger, 2020-08-19:
It doesn't cost anything to reinstall the latest driver as suggested already multiple times: https://www.silabs.com/products/development-tools/software/usb-to-uart-bridge-vcp-drivers

Strat00s, 2020-08-19:
> It doesn't cost anything to reinstall the latest driver as suggested already multiple times: https://www.silabs.com/products/development-tools/software/usb-to-uart-bridge-vcp-drivers

I did reinstall them multiple times. Still nothing.

Closed 2020-08-23.

Thread 419 (2020-08-24):

Hardware info on designing 4 in 1 RF Module

Rpi112, 2020-08-24:
Hi,

If I want to build the 4 in 1 RF module from scratch, is there any circuit diagram for it?

I can see that I can buy all four chips individually. Can the common inputs like SCLK, SI & SO be simply connected to each chip pins or do I need to divide them using some additional circuitry. Similarly can I simply merge the output RF signals of 4 chips or not? Do I need to have any additional components for this module (other than the 4 chips) like crystal oscillators?

I am unable to buy the 4 in 1 RF module in Banggood for some reason and want to build it by myself..

pascallanger, 2020-08-24:
Hi,
Your questions are answered on the different schematics of that page: https://github.com/pascallanger/DIY-Multiprotocol-TX-Module/blob/master/docs/Module_Build_yourself_PCB.md

Rpi112, 2020-08-24:
Hi,

In that file It says I need to buy the 4 in 1 module from Banggood... Even the STM32 board BOM says i need to buy the module from Banggood only..

I want to build this module by buying the 4 chips individually..

pascallanger, 2020-08-24:
Look at the Atmega schematic which is the same with the 4 RF modules.

Rpi112, 2020-08-24:
Got it.. Thanks..

Rpi112, 2020-08-24:
Does this mean the PE1 & PE2 outputs from STM32 board are equivalent to antenna switch control inputs (A1 & A2 on ATMEGA board) ?

pascallanger, 2020-08-24:
Yes, you can always also refer to the pins definition: https://github.com/pascallanger/DIY-Multiprotocol-TX-Module/blob/master/Multiprotocol/Pins.h

Rpi112, 2021-01-14:
Hi,

Just a follow on, in the image (https://github.com/pascallanger/DIY-Multiprotocol-TX-Module/blob/master/docs/images/DIY_Mulitprotocol_Module_Schematic.jpeg), for A7105 module - GIO1 & GIO2 pins are connected to TXEN and RXEN.. But in the application note of A7105 schematic (photo attached), there are no TXEN and RXEN pins. Can I leave GIO1 & GIO2 pins without connecting to anything?
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

Same is the case with GDO0 & GDO2 pins in CC2500...

pascallanger, 2021-01-14:
We use GIO1 & GOI2 and GDO0 & GDO2 pins of the RF components to drive the amp TX/RX pins.

Rpi112, 2021-01-14:
HI,

I am sorry but could you expand on "amp TX/RX pins" ? I am new to this and don't know what amp is...

pascallanger, 2021-01-14:
amp=RF power amplifier. The RF chips don't have a lot of power on their output. You need a power amplifier to increase the range.
Something like https://www.skyworksinc.com/Products/Front-end-Modules/RFX2401C which has a TX/RX pins to enable transmitting and receiving at long range.
The module you have purchased might have a RF power amp. You need to know how to drive it.

Rpi112, 2021-01-14:
Got it.. Thanks for the support..

Rpi112, 2021-01-16:
Hi, I am designing 3 in 1 RF module and using the following schematic to drive the external PA & LNA (placed after RF switch PE42641).

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

From the code I could gather that CC2500 and A7105 registers for GPIO pins are getting changed by SetTxRxMode function. And since NRF24L01 doesn't have any such pins, I am using CE and VDD_PA (with logic lever shifter from 1.8 V to 3.3 V) instead.

Do you see any problems with the above schematic ? My only worry is, if one RF chip is working and others are in sleep/shutdown mode, can I depend on GPIO pins of these chips to be active low?
Also, hope the combination of pins I am using for driving TXEN and RXEN are correct and not swapped...

Rpi112, 2021-01-26:
Hi,
Can you comment on the above design ?

Closed 2020-08-24.

Thread 420 (2020-08-25):

Multiplex FHSS M-LINK Protocol

Josep65, 2020-08-25:
Hi There,
Is it possible to add the Multiplex FHSS M-LINK Protocol or do they use different hardware? I have various receivers and would like to use them with my new Jumper. I have looked around the forum and I have not been able to see if it has already been asked before. Thank you.

pascallanger, 2020-08-25:
I've already looked at this protocol but failed to reverse engineer it in the given time and I needed to send back all the hardware (TX+RX). The issue was mainly around the use of a pseudo random generator for the hopping frequencies...
rwijnhov is supposed to send me a TX+RX so I can try again but I haven't received anything. Without the hardware there is no chance to get it done.

Josep65, 2020-08-25:
Thank you very much for your quick reply. I can send you a receiver, but
not a transmitter, because it's broken. That is the reason why I have
multiple receivers.
If you need a receiver, do not hesitate to ask me and I will send it to
you.
Thanks again.
Josep

Missatge de pascallanger <notifications@github.com> del dia dt., 25 d’ag.
2020 a les 18:39:

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

weixelgeist, 2020-10-04:
Hello Pascal
I can send you a radio and a transmitter

pascallanger, 2020-11-02:
I've made some progress on reversing this protocol. I think I should be able to replicate the TX I currently have on my desk but only this specific TX. More ground work is needed to understand how to create more IDs if possible but definitively getting there.

pascallanger, 2020-11-02:
Basically they've added a 8 bits CRC at the end of the payload with a poly of 0x31 reflected in and out with no xorout.
The problem is now to determine the CRC init value which is a combination of the hopping table index and something else depending on ???.
More to come when I'll have time.

pascallanger, 2021-02-01:
M-Link is kind of working:
 - Bind works most of the time but not 100%
 - On 2 RXs, one works fine including telemetry, the second works for a couple of seconds and stops...

Josep65, 2021-02-01:
Good job Pascal,
I think there will be a lot of users hopeful with your progress.
If you need any other receiver I can send it to you.
Thank you very much for the work you are doing.

pascallanger, 2021-02-05:
The M-Link protocol is part of the test build available here: https://downloads.multi-module.org/latest-test/
Details:
- 16 channels
- Extended limits supported
- No failsafe for now but working on it
- Telemetry is "strange". I have 2 RXs RX-5 and RX-9-DR both sends completly different telemetry packets so I'm not sure how to decode it. I also don't have a TX capable of displaying telemetry neither sensors or even an understanding on how telemetry works for M-Link...
- Full ID support
- Bind works. One of the RX binds within a meter but the other needs to be 10cm or less away so put your RX really close (even nearly touching the antennas if bind doesn't work).

Please report.

pascallanger, 2021-02-05:
This protocol took Ben and me a long time to figure out. The implementation has been a real pain which has been going on for several months because some RXs where working and not others... I hope all this has been addressed now and that we will get positive reports.

If you know how the telemetry works, have sensors, an original radio that display it and an external multi module contact me!

pascallanger, 2021-02-06:
Failsafe has now been added.
**Warning**: Failsafe MUST be configured once with the desired channel values (position) while the RX is up (wait 10+sec for the RX to learn the config) and then failsafe MUST be set to RX/Receiver otherwise the servos will jitter!!!

Josep65, 2021-02-06:
Thanks Pascal. I will tray and report.

hgo-be, 2021-02-07:
Hi Pascal,  great job, I like to test the protocol on my T18 but unfortunately MLINK is excluded for the T18. No problem I downloaded the sources and changed the configuration. Unfortunately I must change validate.h, which make it more complicated to adapt new versions. I'm not familiar with the project how to implement a elegant solution ( #define T18_EXCL_MLINK ? )
Coming week I will test MLINK for a friend.

Josep65, 2021-02-07:
Hi Pascal. I have tried several receivers with success. Two RX-7, one RX-7-DR and one RX-5 Light. All of them have easily bind to 30 cm. I have also configured Failsafe as you have explained without jitter.
In all of them I received a telemetry signal (except RX-5 light, don’t has this function).
I try to connect a Vario/altimeter sensor without results, I’m not sure if its due to no signal or my poor hability getting results.
I’m really satisfied with your job. Thanks.

pascallanger, 2021-02-07:
@Josep65 if you use the latest test version v1.3.2.31, you'll be able to plug some sensors. I haven't added the vario but I've added current, tempetature, voltage and rpm.

pascallanger, 2021-02-07:
> Hi Pascal, great job, I like to test the protocol on my T18 but unfortunately MLINK is excluded for the T18. No problem I downloaded the sources and changed the configuration. Unfortunately I must change validate.h, which make it more complicated to adapt new versions. I'm not familiar with the project how to implement a elegant solution ( #define T18_EXCL_MLINK ? )
> Coming week I will test MLINK for a friend.

I'm not sure how to deal with flash saturation. Since I've added M-Link, there is no more flash space for the normal and T18 build... So something has to give up, I'm just unsure what to do. If you have an idea...
I'll remove the validate.h back that I've just put there to enable me to do the release. I'll modify the automatic builds instead.

hgo-be, 2021-02-08:
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
I like the idea to modify the automatic builds

Srelliks, 2021-02-08:
Have you seen the MPX Sensor bus configuration [here](https://www.multiplex-rc.de/service/downloads/multiplex/schnittstellenbeschreibungen.html) or is this only useful for developing sensors.

pascallanger, 2021-02-08:
> Have you seen the MPX Sensor bus configuration [here](https://www.multiplex-rc.de/service/downloads/multiplex/schnittstellenbeschreibungen.html) or is this only useful for developing sensors.

This is exactly the document I'm using to decode the telemetry: beschreibung-sensor-bus-v2.pdf

Josep65, 2021-02-08:
> @Josep65 if you use the latest test version v1.3.2.31, you'll be able to plug some sensors. I haven't added the vario but I've added current, tempetature, voltage and rpm. Let me know if it works as I have no way to test since I don't have sensors. If it works I'll add more if them.

Unfortunately I only have vario sensor. I'm trying to get some of the ones you implemented to test, but I'm not sure I can get them. I'll keep you informed.

Srelliks, 2021-02-08:
Pascal, I am in the UK so probably not practical to send you any of my sensors. You note that the telemetry is strange, one thing that occurred to me is the ability to set up a priority telemetry address on the Multiplex receivers so that the sensor value on that address is transmitted to the transmitter on a more regular basis and it maybe that this affects the way the telemetry is sent. You can check this on the Multiplex receivers through the Multiplex launcher program.

pascallanger, 2021-02-09:
Just to be straight, all I need at this very moment is someone to confirm that if one or more of current, tempetature, voltage or rpm sensors are plugged then the values are displayed somewhat correctly.
I'm only asking for a test to confirm that what I've done works so I can add everything else.

Josep65, 2021-02-09:
Sorry Pascal, I don't have these kinds of sensors. I'm trying to get some but so far I have not succeeded ... let's see if in two days I can get one.

pascallanger, 2021-02-09:
I'll add your vario tomorrow so you can test.

hgo-be, 2021-02-09:
Next week I can test a roxxy speed controller which returns voltage, current, charge, temp and rpm values

Josep65, 2021-02-09:
> I'll add your vario tomorrow so you can test.

Perfect! I Will do.

pascallanger, 2021-02-10:
[v1.3.2.35](https://downloads.multi-module.org/latest-test/) should have vario telemetry.

Josep65, 2021-02-10:
Great Pascal.  It works!! Now i can see vario sensor. Thanks.

pascallanger, 2021-02-10:
Future versions of Multi will not work unless you compile your own version with MLINK_HUB_TELEMETRY enabled. Working with @3djc to add the telem directly in OpenTX.

Josep65, 2021-02-10:
Hi Pascal, it would have been wonderful if all the options worked, but I understand that it may not always be possible. From my point of view I am satisfied since my initial request has been fulfilled and now I will be able to use my receivers. I can only congratulate you and thank you, once again, for the work you are doing.

hgo-be, 2021-02-11:
Results speed controller
Sniffer
id:0 1 78 0 Voltage:6.00               ok with ratio 12.7 ( pitty to stick on frsky ratio )
id:1 1A C8 0 LQY:100                   ok
id:2 21 F4 0 Voltage:12.20            ok with ratio 12.7
id:3 32 8 0 Current:0.40                ok
id:5 55 1C FB Rpm:6260                wrong display value -1020600rmp : if value < 0 then value = abs(value) * 10 else value = value * 100
id:6 6B C4 FF Charge:-30               sensor mAh is not discovered

pascallanger, 2021-02-11:
@hgo-be
The telemetry implementation is currently being implemented directly in OpenTX. All sensors will be decoded there (with the right decimal place and right calculations). What I've done so far was just a test to see if the sensors sent over RF were working the way I thought before touching OpenTX.
Thanks for the tests but you might want to hold for the upcoming OpenTX pull request.

3djc, 2021-02-11:
@hgo-be on what radio can you test ?

pascallanger, 2021-02-11:
He is on a T18 if I'm not mistaken.
@hgo-be you need to run the latest dev firmware if you want to test the current dev on OTX. The T18 multi test firmware now includes M-Link: https://downloads.multi-module.org/latest-test/

hgo-be, 2021-02-11:
@3djc indeed T18
@pascallanger thank you very much, I was not aware about multi raw data. I will install latest test firmware.

3djc, 2021-02-11:
You can try with this
[firmware.zip](https://github.com/pascallanger/DIY-Multiprotocol-TX-Module/files/5965031/firmware.zip)

It also requires multi 1.3.2.36

hgo-be, 2021-02-11:
Great job,
Tmp1 OK
RPM   Wrong  rpm sensor value is negative , display value 3218100 , should be 5870 (see my first test )
Capa   Wrong  charge sensor value is negative for discharge, display 32675 should signed value -93
RxBt  OK
RSSI  OK
VFAS OK
Curr  0.4A

3djc, 2021-02-11:
The formula looks got in the code, but we have a conversion issue, could you try this ?
[firmware.zip](https://github.com/pascallanger/DIY-Multiprotocol-TX-Module/files/5966495/firmware.zip)

hgo-be, 2021-02-11:
Almost ready, 3 minors
RPM    OK
Capa    OK
I programmed a arduino for  the other sensor values
VSpd OK
Hdg   OK
Alt      OK
Fuel    OK
GRVI    OK      class 12 is Fluid, GRVI ?
Dist      BAD    class 13   factor 10 too high,  sensor value 1 should be displayed as 100 m  but shows 1000 m
0004    class 4  Speed has no name, precision should be 0.0

3djc, 2021-02-11:
What can we use for fluid using 4 letters ?

[firmware.zip](https://github.com/pascallanger/DIY-Multiprotocol-TX-Module/files/5967027/firmware.zip)

hgo-be, 2021-02-11:
Super, all values are correctly visualized.
Fluid : Cons (umption)  ? No idea

3djc, 2021-02-11:
Fuel :)

[firmware.zip](https://github.com/pascallanger/DIY-Multiprotocol-TX-Module/files/5967294/firmware.zip)

hgo-be, 2021-02-11:
There is already a value Fuel (level) ?
firmware file is the same as the previous ?

Srelliks, 2021-02-11:
Use Tank for fuel level and Fuel for fuel flow?

3djc, 2021-02-12:
I went for Flow

[firmware.zip](https://github.com/pascallanger/DIY-Multiprotocol-TX-Module/files/5969962/firmware.zip)

Can anyone confirm that when using GPS, you don't get GPS coordinates on the radio ?

Srelliks, 2021-02-14:
On Multiplex radios it's not possible to display the GPS co-ordinates. However the SM Modelbau GPS logger does send them as alternate values as described in the manual "In M-Link after 2 minutes without moving, Latitude and Longitude are displayed on the GPS-Logger 2 on addresses Vario and Speed every 5 seconds. The display changes between the decimal point value with the unit "mAh" and the decimal value with the unit "ml". More meaningful units – such as degrees and minutes – are unfortunately not allowed in M-Link." I don't have a Multiplex GPS sensorbut I am pretty sure the Multiplex GPS sensors do not send the GPS co-ordinates.

jmdfs, 2021-02-28:
bonjour

Je viens de parcourir les informations sur le module 4in1 de chez Banggood en STM32 et le Mlink Multiplex, c'est génial. J'ai le module et un ancienne radio multiplex que je souhaite passer en Mlink via le module avec une entrée en PPM.

Il y a un point que je ne comprends pas. Sur la liste des protocoles disponibles, Mlink est en numéro 78 et si j'ai bien compris il n'y a que 14x5 soit 70 protocole possible, comment avoir un protocole supérieur à 70 (78 pour moi) ?

D'avance merci et désolé si la question semble évidente mais je débute.
Bonne journée

pascallanger, 2021-02-28:
@jmdfs Ce n'est pas du tout comme ça que ça fonctionne... Pour le mode PPM il faut compiler soit même le code car il faut configurer le module par l'intermédiaire du fichier _config.h. Dans ce fichier config, on indique quel protocole on associe à quel position du dial: https://github.com/pascallanger/DIY-Multiprotocol-TX-Module/blob/f19bb05c7ab971d0677187abe93110b2a7855fb4/Multiprotocol/_Config.h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

jmdfs, 2021-02-28:
Bonsoir Pascal

Merci pour les informations, j'ai avancé un peu et je commence à comprendre le mécanisme => ide Arduino sur mon ordi + téléchargement du DIY-Multiprotocol-TX-Module-master + adaptation du Config.h (Là il faut bien comprendre et prendre son temps)  La suite un peu plus tard (Compilation et injection dans le module) pour ensuite essayer.

Deux autres questions:
1) Les fichiers Bin téléchargeables sur la page "downloads.multi-module" ne sont donc utilisables que pour le mode série ?
2) Le liens sur la rubrique "Download the Multiprotocol source and open the project"
vers le fichier source. zip est toujours à la bonne version, la dernière version stable ou autre ?

D'avance un grand merci pour les explications et surtout le travail fourni
Jean Michel

pascallanger, 2021-02-28:
1. Exact. Les versions PPM sont juste pour test.
2. Pour une version stable il faut télécharger le source depuis les releases.

Closed 2021-03-02.

Thread 429 (2020-09-21):

ATmega328p powering and frequency

DEMONmachine, 2020-09-21:
I'am building TX module from scratch using arduino.
And I'am a bit confused about selected parts and wiring diagram. There is used Arduino Pro Mini 16MHz. But it is powered by 3.3v regulator. If I understanding it right 328P is not guaranted to run 16MHz at 3.3v. Isn't it a mistake? And which one should I use? Pro Mini 3.3v/8MHz or 5v/16MHz?
If I don't have Pro Mini 5v...
- Can I use regular Pro Mini 3.3v/8MHz?
- Can I use Arduino Nano (328P/5v/16MHz) instead?
- Or I have to use Pro Mini 3.3v with replacing resonator from 8MHz to 16MHz?

Thank you in advance.

schwabe, 2020-09-21:
No, the chip is run out of spec. But it is recommended to build modules around the STM32 nowadays anyway. The AVR chip is a bit too small.

stanekTM, 2020-09-21:
Use 328P / 5V. The 3.3V is out of specification but works well. I built several Multimodules by the original author "Midelic". Due to the size of the flash, select only the protocols you need. Use the Arduino IDE to compile. There is a lot of information at the beginning of the Multiprotocol thread
[https://www.rcgroups.com/forums/showthread.php?2165676-DIY-Multiprotocol-TX-Module](url)

pascallanger, 2020-10-01:
I think questions have been answered, closing the thread.

Closed 2020-10-01.

Thread 431 (2020-09-23):

Sensor Lost with Crossover / Oversky XR602T-F2 (Frsky D16) receiver

TedAus, 2020-09-23:
I bought a Crossover (a.k.a. Oversky) XR602T-F2 receiver which uses Frsky D16 protocol to try. It promises the benefits of easier binding (no need to hold down the bind button when powering up), no failsafe when close to the transmitter, and uninverted FPort.

All the features above work, but I'm getting frequent sensor lost (multiple times per battery pack) and when the values return, the battery voltage, for example, sometimes goes to negative 15,000!

I'm using multi-protocol version v1.3.1.59 with OpenTX 2.3.9 on a Jumper T16 Pro.

Could this be due to bad receiver firmware? I've tried contacting the manufacturer, but didn't get a response (unsurprising).

Thanks for your ongoing work on this module. Much appreciated.

pascallanger, 2020-09-23:
The D16 protocol has been out for a very long time with no reported issues. I would therefore point to a problem with the RX firmware...

TedAus, 2020-09-23:
That's what I thought. Hopefully they'll come out with a new firmware soon.

Thanks Pascal!

Closed 2020-09-23.

Thread 460 (2020-10-28):

Would like to work on DF Models 9918 SkyTumbler

hexagon5un, 2020-10-28:
I've got a DF Models SkyTumbler and an iRangeX4 multi-module. Opening up the included transmitter, it's an XN297LBW-based module for the TX.  I tried running through the XN297 protocols on my iRx4, and couldn't get it to bind.

So far, I've soldered to the XN297's SPI lines: looks like CSN, CLK, and MOSI are active, and the CSN is splitting the datastream into 16-bits.  There's obvious packet structure delimited by FC 00 and FD 00, with what looks like a header and data section.  More than that, I can't tell.

What's the best way for me to contribute?  Is there a datasheet where I can start to parse the fields in the hope that I could submit a patch directly?  Or is this the kind of thing that's easiest to just post up data dumps from this thing?

Are there any particular parts of the datastream that are worth collecting?  And why does the MISO line look like it's always low?  (Did I mess up wiring?)

Coming here from https://www.rcgroups.com/forums/showpost.php?p=45739807&postcount=20265

pascallanger, 2020-10-28:
Share your dump so I can have a look.
The xn297 can work with only 3 wires mosi and miso sharing the same pin.
You'll need to do plenty of dumps to try to figure out the protocol: one file for bind, one file per axis (one file for aileron, one file for elevator...), one file per special function...

hexagon5un, 2020-10-28:
[Here is a preliminary couple dumps](https://littlehacks.org/df_drone_xn297_1.tgz) with Sigrok.  Is that an OK format? Other preferences?

pascallanger, 2020-10-28:
From a quick look at the first dump, this is the JJRC345 protocol: https://github.com/pascallanger/DIY-Multiprotocol-TX-Module/blob/master/Protocols_Details.md#JJRC345---71
Bind address is the same, bind packet structure is the same and more.
Let me know if this protocol doesn't work for you. If it's not then it might be a small variation...
Pascal

hexagon5un, 2020-10-28:
I just tried it, and it doesn't work.

pascallanger, 2020-10-28:
You are running the latest firmware version, correct?
Do you get any difference on the drone LEDs pattern when you do a bind?
I need more dumps as requested before. For the different channels, don't do separated dumps for up/down or left/right but instead in the same file for a same channel.

hexagon5un, 2020-10-28:
OpenTX 2.3.10 and Multiprotocol-1.3.1.69
It's not even binding.  (This is one of those drones that wants you to do an up-down on the throttle to bind the TX.  I wonder if it's doing that wrong?)
I'll work on the dumps for you.  It has AETR + speed, flip, LED, and headless.

hexagon5un, 2020-10-28:
https://littlehacks.org/df_drone_xn297_2.tgz

hexagon5un, 2020-10-28:
Speed toggles between three states.  I'm not sure I got one of each in the dump.
I'm also not sure whether the flip logic resides in TX or the drone.  If you need me to do that again, just let me know.

hexagon5un, 2020-10-28:
https://littlehacks.org/df_drone_binding.tgz

pascallanger, 2020-10-29:
This is really the same protocol as JJRC345, the only difference seems to be the bind channel.
On this line: https://github.com/pascallanger/DIY-Multiprotocol-TX-Module/blob/5ed61f30e12a9bf91055ad0ebfad38151538f42a/Multiprotocol/JJRC345_nrf24l01.ino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
Change 5 by 40, compile and test.

hexagon5un, 2020-10-29:
Fantastic.  Will do.

In the meantime, I've gotten my sigrok-cli-fu down, and viewing the SPI data live is fairly informative.  I definitely know which fields are whicn now.  Fun, fun.

hexagon5un, 2020-10-29:
Yup.  That did it-- it binds now.  I'll double-check all the functions I can figure out, and then it's a done deal!  Marvelous.

pascallanger, 2020-10-29:
One you've confirmed everything is ok, I'll create a sub protocol for your drone and do a release. How should I call it? SkyTumbl?

hexagon5un, 2020-10-29:
Sounds good to me!

DF Models has a number of quads -- my guess is that they're all rebadgings of common models, or at least custom variations.  So it's probably a good idea to use the model name like that.

SkyTmblr?

I'm charging one up now for testing.

hexagon5un, 2020-10-29:
I played around with the drones for a while.  The basic features seem all there, but there are still some differences with the stock JJRC code.

There is no RTH at all.  It's a cheap drone.

packet[10], which is aileron trim, has an enable/disable LED button on it, which sets/clears the 0x40 that is on by default in the current code.  This could map to channel 7, taking the place of RTH on the Module's TX?

packet[9] has two of these flags, on 0x40 and 0x80, that are set momentarily by pushbuttons on the remote. I can't tell what they do, if anything.  But the transmitter sends them.

The speed mode setting goes out as the values 0/1/2 over packet[12] as in the code, but it also limits the throws of the aileron/elevator controls as they're sent out.  I can't tell yet if this works like the "flip" button, which just changes the values that the TX sends out over normal channels, or if the 0/1/2 in packet[12] actually have some effect on the drone directly.  The current version hardcodes it as 2, which seems to work just fine.

If you think it's worth re-mapping RTH / channel 7 to the extra 0x40 in packet[10] for the LEDs, that might be fun.  The rest one can certainly live without.  I might keep playing around with it on my own, of course.  But for now, this should satisfy anyone who just wants to fly one of these drones.

Would you rather do it yourself, or should I type this up and submit a pull request?  I see that sub_protocol needs to be changed/defined/documented in a few places. Maybe it's safer if you did it.  :)

And if you'd like one, BTW, I bought a whole 10 of them on eBay for €9 plus shipping.  I'll send you one just for fun if you're not buried in el cheapo drones!  :)

pascallanger, 2020-10-30:
Can you test the latest version before I do a release?
I've added LED as a separated channel since it might also work on the JJRC345:
https://github.com/pascallanger/DIY-Multiprotocol-TX-Module/blob/master/Protocols_Details.md#JJRC345---71
You'll see that I've added your unknown flags as well just in case there is a new model outhere.

hexagon5un, 2020-10-30:
Great.  Will test tonight and let you know.

hexagon5un, 2020-10-30:
Looks great!  I can confirm that headless and LED work, and that the unknown buttons do the same thing that they do on the controller itself so far -- blink the LEDs once or twice, respectively.

Thanks a ton for your help with this!

(Oh, and BTW: I ended up writing up a bit about this experience on Hackaday.  Hope you don't mind.  It'll come out tomorrow / Saturday Oct 31.  https://hackaday.com/?p=444626)

pascallanger, 2020-10-31:
The hackaday link does not work. FYI the protocol was already reversed with checksum, hopping, emulation and all that was already available. This is why it might appear really easy to you but it's not the case when starting from a blank sheet.

hexagon5un, 2020-10-31:
Yeah, totally!  I _do_ appreciate that it was a piece of cake b/c it's just a minor variant of another protocol that was already done. Doubly so b/c you recognized exactly which protocol it was a variant of.

That was kinda the point of the writeup actually -- all that work that I didn't have to do b/c other folks have done the hard work.  https://hackaday.com/2020/10/31/scratching-that-itch should also work.

Closed 2020-11-01.

Thread 469 (2020-11-13):

Eachine E016H v2

little-Beppo, 2020-11-13:
Hello, I'm new here.
I've already dealt with the topic of multi-protocols a little and now my question.
I bought the current E016H, but I cannot bind it with the DIY-Multiprotocol V1.3.1.69. I found the chip "FC298TX GS50XFN411" in the transmitter.
Is this the wrong version or the wrong protocol?
Please help me .
Thank you

little-Beppo, 2020-11-13:
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
that is the picture from the transmitter chip.
let me know if you need more information's.

benlye, 2020-11-13:
Are you trying the correct protocol?  I have an E016H and it works fine with the E01X protocol, sub-protocol E016H.

little-Beppo, 2020-11-14:
Yes I think so.
before I wrote the treat here, I asked goebish. He mean:
"There's not much I can do.
Your best bet is asking on the multi protocol thread for some guidance on dumping xn297 packets, but this is a unknown chip, no idea if it's xn297 compatible or not."
That's what I'm trying to do here now

little-Beppo, 2020-11-14:
are there instructions for reading out the log?

pascallanger, 2020-11-14:
Load a debug firmware, get a serial connection to the module and run the XN297Dump protocol in auto mode: https://github.com/pascallanger/DIY-Multiprotocol-TX-Module/blob/master/docs/Advanced_XN297Ldump.md

benlye, 2020-11-14:
I opened mine up for comparison and, yep, it's a slightly different board with a different IC.

Here's the original, for reference...

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

little-Beppo, 2020-11-14:
Hello,

First of all I want to say thank you for your support.
The next thing is, my English is not as good as it should be, so the request again

I'm not sure if I got that right.
should I load another FW into the 4-in-1 module? In order to generate a dump file with it?
Is it possible to use the USB interface on the back of the module to load it into the module with the Arduino? I've already updated the boot loader. Or is it possible with the falsh-multitool, cause i get this DFU mode not working with the Arduino.
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

benlye, 2020-11-14:
Use Flash Multi to flash this firmware file to your module:
https://github.com/pascallanger/DIY-Multiprotocol-TX-Module/releases/download/v1.3.1.77/multi-stm-xn297dump-usbdebug-v1.3.1.77.bin

You then need to use the Serial Monitor in Flash Multi to see the debug output from the module.

After you flash the module:
# Flash the module using Flash Multi
# Unplug the module from the computer
# Turn the radio on and configure a model using the XN297 Dump protocol (protocol number 63)
# Plug the module into the computer
# Open the Serial Monitor window and look at the output

little-Beppo, 2020-11-14:
Thanks for your support, today I'm busy. I'll try it tomorrow.

little-Beppo, 2020-11-15:
Hello benlye,
i am sorry to say, i is not working correct, so i was flashing the dump FW but i can't get the tool in the Monitor Mode.
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
The red LED is flashing fast the whole time.
Whats my mistake?

pascallanger, 2020-11-15:
The module is in bootloader not in normal mode... Unplug the USB cable, power on the radio wait that the module is powered then plug the USB cable. At that stage a com port should appear and then open the monitor.

little-Beppo, 2020-11-15:
i think there is the USB-Driver missing.

pascallanger, 2020-11-15:
The fact that the module fast blinks indicate that it is in bootloader because it has been powered with USB plugged in first.

little-Beppo, 2020-11-15:
ok, now its working.
should I now turn on the drone and read out?

little-Beppo, 2020-11-15:
so here is the result.
I'm not sure what the log file should tell me?
[Dump_.log](https://github.com/pascallanger/DIY-Multiprotocol-TX-Module/files/5542159/Dump_.log)
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

pascallanger, 2020-11-15:
Power on the E016H TX, exit from bind (usually throttle up down), leave the TX untouch.
On the radio select the XN297Dump protocol, sub_proto Auto and watch the screen if there is any packets being received.

pascallanger, 2020-11-15:
> so here is the result.
> I'm not sure what the log file should tell me?

This does show that no packet has been received. Was the TX powered on out of bind mode?

little-Beppo, 2020-11-15:
no i'm so poor, i powered the copter.

little-Beppo, 2020-11-15:
now i switched on the remote control of the copter and activated it in normal mode.
Then the dump started, but it looks like no connection can be made here either.
[Dump_tx.log](https://github.com/pascallanger/DIY-Multiprotocol-TX-Module/files/5542187/Dump_tx.log)
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

little-Beppo, 2020-11-15:
is it possible that there is a problem with the 9XD that xjt is flashed as an EU version?

pascallanger, 2020-11-15:
> is it possible that there is a problem with the 9XD that xjt is flashed as an EU version?

This comment makes no sense

pascallanger, 2020-11-15:
> now i switched on the remote control of the copter and activated it in normal mode.
> Then the dump started, but it looks like no connection can be made here either.

Probably not XN297 compatible chip. Need a SDR to investigate further.
If you want you can send me the TX + quad for further investigation otherwise it's a dead end.

little-Beppo, 2020-11-15:
Send only the TX or also the copter? so i need your address.

little-Beppo, 2020-11-15:
is it possible that there is a problem with the 9XD that xjt is flashed as an EU version?

"This comment makes no sense"

    that's probably true, was just one thought

little-Beppo, 2020-11-15:
yes i can send you the TX + quad, let me know your address.

pascallanger, 2020-11-15:
> yes i can send you the TX + quad, let me know your address.

Contact me on the emain address used for the donate button or by MP on rcgroups.

pascallanger, 2020-12-15:
I've finally received an E016H.
Here is the phase of the RF signal captured using SDR for a bind packet:
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

This is not a XN297 core, neither a NRF from the packet layout.
The RF component is doing GFSK @250Kbps. The signal is not clean which is a bit of a worry or at least it's not fully what I'm used to see with GFSK...
The good news is that scramble is not enabled which gives some hope to reverse this protocol.
So, it sends a bunch of 55 or AA as a preamble followed by some data.
I've decoded the signal manually since my normal script has a hard time to figure out the bits (ref comment above):
E7 | E7 | E7 | E7 | 5C | A0 | 81 | C9 | B0 | 4C | 4C | 4C | 4C | 0 | 0 | 0 | 64 | 69
ID | ID | ID | ID | -- | -- | -- | -- | -- | -- | -- | -- | -- | -- | -- | -- | CRC | CRC
First, there is a catch since it's missing 1 bit at the end for the CRC but that could be my human mistake reading the 0s and 1s. It could also be that there is a control field which is usually the payload length, pid and ack/no ack flag which is making the payload usually shifted by a couple of bits.
Second I don't know what the convention is, so the bytes could be inverted (E7 becomes 18) and also swapped since I've used MSB first (A0 becomes 05).
The first 4 bytes are interesting since they could be the 4 bytes of the bind address E7 E7 E7 E7 (note E7 is the same if you read it with MSB or LSB).
Using these 4 bytes (or 18 18 18 18) I should be able to get the NRF to listen to the message and get live readings.
More to come...

pascallanger, 2020-12-16:
The NRF has also a hard time to receive the signal properly, there are loads of errors in the dump...
Here is one line which I think is accurate (I might be biaised by the fact that this is what I've deoded previously ;-) ):
5C A0 81 C9 B0 4C 4C 4C 4C 00 00 00 64 D2 <- the CRC is 64 D2 where I was reading 64 69 which is strange since I've verified and can't find the same result but anyway...
Like I was thinking there is a control field with a pid which counts on 2 bits 0,1,2,3,0,1... :
50,54,58,5C: xxxxyyzz where yy is the pid. Also the pid is not contained in the CRC since the CRC is constant...

Going from there I've tried to apply on the payload the standard CRC16_CCIT_ZERO which has a polynom of 0x1021 and bingo!!!
The CRC of 0xA0 0x81 0xC9 0xB0 0x4C 0x4C 0x4C 0x4C 0x00 0x00 0x00 gives 0x64D2 !!!!

More to come...

pascallanger, 2020-12-16:
A wild guess would be that the address used in normal mode is going to be: A0 81 C9 B0.
4C could be the RF channel if only one is used...
But this is a tomorrow thing as it is 1:30am currently so time to go to bed.

little-Beppo, 2020-12-16:
Thanks Pascal for the news.
Do you think that a solution with the DIY Multiprotocol is possible?

pascallanger, 2020-12-17:
Not sure yet, it will depend how well the quad is going to receive the data from the module. I'm going to use the cc2500 to emulate it so we can always try to tune the signal a little.

I also would like to see what your remote is sending. I'll post later a code on GitHub that you can launch the same way you've done the previous dump attempts.

pascallanger, 2020-12-17:
The bytes in the payload seem to have their bits reversed and shifted by 1 bit based on the stick values.
The address for bind and normal packets is the same E7 E7 E7 E7.

The bind packet is 11 bytes long sent on RF channel 5
0A | 02 | 27 | 1B | 64 | 64 | 64 | 64 | 00 | 00 | 00
--  | --  | -- |  -- |    -- | -- |   -- | -- |   -- | -- | --
ID?  | Bind?  | ID |  ID | T | R | E | A | flag1 | flag2 | flag3

The normal packet is 11 bytes long sent on RF channel 44
0A | 20 | 27 | 1B | 64 | 64 | 64 | 64 | 00 | 00 | 00
--  | --  | -- |  -- |    -- | -- |   -- | -- |   -- | -- | --
ID?  | Normal?  | ID |  ID | T | R | E | A | Flag1 | Flag2 | Flag3

T, R, E and A are 0x00..0x64..0xC8.
Flag1: 0x01=Flip, 0x02=Headless, 0x04=One Key Return
Flag2: Speed control 0x00:low, 0x01:medium, 0x02:high
Flag3: 0x01=TakeOff/Land (momentary switch), 0x04=Emergeny Stop (momentary switch)

pascallanger, 2020-12-17:
I've been able to fly the E016H with my TX16S ;-)

goebish, 2020-12-17:
Well played !

pascallanger, 2020-12-17:
Multi v1.3.1.87 has support for the E016H v2. You manually need to build from source to test it out.
It is **important** to tune the frequency since mine doesn't even bind at 0. On my module and this quad I need to set the RF freq to +80.
**Only 1 ID is available** so you can't have multiple quads flying at the same time (for now?).
The protocol details are located here: https://github.com/pascallanger/DIY-Multiprotocol-TX-Module/blob/master/Protocols_Details.md#E016H---80
Interestingly, this quad does not require a centered throttle. You can power it on with throttle at -100%. When you move throttle up the motor will arm. If you keep pushing it will lift off. To land simply lower throttle and it will auto shut off when touching the ground.

pascallanger, 2020-12-17:
@little-Beppo
Using the latest version on GitHub, can you do a dump of your remote?
Notes:
- the quad does not have to be on
- use the XN297Dump protocol as you've done some time ago but use the sub protocol NRF
- power on the radio, you should see one line appearing "P: XX XX..."
- put the radio in normal mode (throttle up/down) and use the Spectrum analyzer under System to find out which frequency the TX is using

little-Beppo, 2020-12-17:
Hello Pascal,
thank you for your great work, will test it today or tomorrow.

pascallanger, 2020-12-17:
@little-Beppo please consider the above. This is to add more than 1 ID...

little-Beppo, 2020-12-17:
Ok, i will do the dump now, is the version v 1.3.1.77 ok?

pascallanger, 2020-12-17:
> Ok, i will do the dump now, is the version v 1.3.1.77 ok?

No you need 1.3.1.87

little-Beppo, 2020-12-17:
where can i get this version?

pascallanger, 2020-12-17:
Here on Master but you need to compile it yourself...

little-Beppo, 2020-12-17:
ok i have no idea how to do that. Can you help me with that?

pascallanger, 2020-12-17:
https://github.com/pascallanger/DIY-Multiprotocol-TX-Module/blob/master/docs/Compiling_STM32.md

little-Beppo, 2020-12-17:
I want to try, but it will take a while.
I found the ino for the dump at master but can't download it, sorry haven't been around that long and don't understand the processes here so well.

little-Beppo, 2020-12-17:
an error appears when compiling, am I doing something wrong?
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

pascallanger, 2020-12-17:
@little-Beppo try again with the latest code

little-Beppo, 2020-12-17:
sorry I'm too stupid, now the file is too big and brings an error message again.
how can I reduce the size without deleting important things.
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

little-Beppo, 2020-12-17:
now i get the module flashed, but i cant make a serial dump, cause there is no XN297 Dump setting for the TX and also no COM-Port for the  serial monitor?
Do you have any idea whats my mistake?
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

pascallanger, 2020-12-17:
> now i get the module flashed, but i cant make a serial dump, cause there is no XN297 Dump setting for the TX and also no COM-Port for the serial monitor?
> Do you have any idea whats my mistake?

As you can see on your picture, you have a standard build not a debug one: "Serial Debug Enabled: False"
On Arduino, Tools-> Debug Option -> then you have to choose the debug type you need for your module. If you have a iRangeX+ then select "Native USB debugging" otherwise you most likely want to select "Serial/FTDI debugging".
Pascal

pascallanger, 2020-12-18:
@little-Beppo I think you can forget the dump since I've kind of found the rule for the ID vs Freq:
Freq=(ID1 + ID2)%32 + 42
But there are invalid values which still needs to be found. For example, freqs 72 and 73 are not allowed, ID1=0 is not allowed.
I'm going to poke around to see if I can spot other invalid values like ID2=0 or ID1=FF or ID2=FF or...

little-Beppo, 2020-12-18:
yes had tested the E016H2v protocol, did not work,
Later today I'll try another dump, maybe it will help you to identify the gaps in the ID

pascallanger, 2020-12-18:
> yes had tested the E016H2v protocol, did not work,

The protocol works. As I said you must tune the frequency to even get a bind. Try to set "RF Freq. fine tune" to +40 or -40. On my module nothing works unless I set it to +40, +80 being the middle value.

little-Beppo, 2020-12-18:
Yes, you are right. It works, i have done my first flight with the TX setting below.
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

pascallanger, 2020-12-18:
Great! You still need to tune it since 40 just gets the bind working. Mine ended to +80.

Please test the new version 1.3.1.91 which integrates support for full IDs. Please test and report.

little-Beppo, 2020-12-18:
got some problems during the compiling.

Arduino: 1.8.12 (Windows 10), Board: "Multi X-in-1 STM32F103CB (128KB), Enabled, Serial/FTDI Debugging"

c:/users/dumbo/appdata/local/arduino15/packages/arduino/tools/arm-none-eabi-gcc/4.8.3-2014q1/bin/../lib/gcc/arm-none-eabi/4.8.3/../../../../arm-none-eabi/bin/ld.exe: C:\Users\DUMBO\AppData\Local\Temp\arduino_build_798342/Multiprotocol.ino.elf section `.text' will not fit in region `rom'

c:/users/dumbo/appdata/local/arduino15/packages/arduino/tools/arm-none-eabi-gcc/4.8.3-2014q1/bin/../lib/gcc/arm-none-eabi/4.8.3/../../../../arm-none-eabi/bin/ld.exe: region `rom' overflowed by 16344 bytes

collect2.exe: error: ld returned 1 exit status

exit status 1
Fehler beim Kompilieren für das Board Multi X-in-1 STM32F103CB (128KB).

Dieser Bericht wäre detaillierter, wenn die Option
"Ausführliche Ausgabe während der Kompilierung"
in Datei -> Voreinstellungen aktiviert wäre.

do you have any idea?

kilrah, 2020-12-18:
You must not enable serial debugging for flying.

pascallanger, 2020-12-18:
Yes it means that the code does not fit... Disable debug which will free up some space.

little-Beppo, 2020-12-18:
Okay thanks

little-Beppo, 2020-12-18:
So I've now done some test work with the version 1.3.1.91:
RF Freq. fine tune:         /       Result:
       +80                          /    bind ok, bad trim in Ail and Ele, engine speed for flying ok
       +40                          /   bind ok, verybad trim in Ail and Ele, engine speed for flying ok
           0                          /    no bind possible
        -40                          /    bind ok,, engine speed to slow for flying
        -80                          /    bind ok,, engine speed to slow for flying

in my opinion version 1.3.1.89 was better at +40.
what did you change?

pascallanger, 2020-12-18:
Nothing... Are you really tuning the frequency or doing what here? You don't need to rebind, just find the middle value of the frequency range.
Trim on ail and ele or slow motors has nothing to do with bind and freq tune, it looks more like a flat lipo...

little-Beppo, 2020-12-18:
I changed the RF Freg. tuning in the TX, and between each step I unplug of the quad and switch of the TX.
I dont think its the Lipo, the test with the low speed motors was before the flight tests.
Also the the trim problem maybe the bandwidth is not big enough because of the incorrect frequency.
I'll do more tests if I find something new I'll let you know.
why do you think the frequency deviation is in steps of 40?
Thanks for your help, you did a very good job.
Happy Holidays and stay healthy!

pascallanger, 2020-12-18:
Where did I say that the steps are 40? There are no steps. There is just 2 end points with a middle which can be anything... Please read how to do properly RF tuning.
RF running can't add trim, it can add lag... These are different words.

little-Beppo, 2020-12-18:
sorry Pascal, i have one more question. Does the new protocol for the E016Hv2 support high/low speed for the Quad.
If so, on which channel?

pascallanger, 2020-12-18:
Like all the multi protocols, the rate is always set to max. If you need to lower the rate, add expo/dual rate on the OpenTX inputs.

little-Beppo, 2020-12-18:
OK, I did not know that.
According to the instructions, the problem with the trim can be solved by a defined stick position to calibrate the Quad before take-off.
Can it be that this function is not supported in the multi-protocol? This works with the currently only original remote control. However, the trim then does not match the Taranis. So that I always have a certain drift

pascallanger, 2020-12-18:
I'll look tomorrow at the calibration feature. Mine is flying straight out of the box so I haven't looked into that and truly i haven't looked at the manual at all apart from the TX buttons description.

pascallanger, 2020-12-19:
Calibration is now available on channel 8: https://github.com/pascallanger/DIY-Multiprotocol-TX-Module/blob/master/Protocols_Details.md#e016hv2---80
FYI, after calibrating my E016H was really moving sideways to me and to the left... I had to place different piles of paper under the rear and left motors during calibration to get it to fly straight in the air.

little-Beppo, 2020-12-19:
thanks for the info and the workaround. ;-))

Closed 2020-12-18.

Thread 574 (2021-05-01):

LSR-3000 Protocol(may be old DSM Protocol for car) request

doohans, 2021-05-01:
Honorable pascallanger.
I sent this article to you by direct mail via rcgroups.(to midelic)

I really love the multiprotocol you made. And I will capture and send my old dsm protocol files. This protocol is used to control the car. It is not a DSMR protocol. Please add this protocol. The spi capture file is attached as a Google link.

[TX Info]
my tx is spectrum LSR-3000.
https://www.spektrumrc.com/Products/Default.aspx?ProdID=LOSB0805

[SPI Capture Files]
1. bind
https://drive.google.com/file/d/18hL185AtT1tUiPuR4ODcMnO4StBgRhC-/view?usp=sharing, https://drive.google.com/file/d/1JI9ci6BP_kW7y4nHSvGkEtHnx7rCcb7i/view?usp=sharing, https://drive.google.com/file/d/1M_8x3YducXzKHRyCgdSQGQpF6FoypTYL/view?usp=sharing, https://drive.google.com/file/d/1yfocXUvSNCLpk9JFbRXj0gBQHmIHQUrd/view?usp=sharing
https://drive.google.com/file/d/1Z9MLCEH47gCxpm0DnnDAdyjLMJV_1l6A/view?usp=sharing
https://drive.google.com/file/d/1NMdzqxs2TqelCB8iEuqrYb_4ZtGvBwQA/view?usp=sharing

2. forward
https://drive.google.com/file/d/1z-5notauxQOsG5AIhgXCAyT12EiGZE9j/view?usp=sharing

3. backward
https://drive.google.com/file/d/19izheiR67u8bW7fxAWvJec9Wv1aWCFL1/view?usp=sharing

4. steer
https://drive.google.com/file/d/1zynDuLQC5j8KtdMgzo9EMduZxArcA4td/view?usp=sharing

Best regards,
doohans

pascallanger, 2021-05-01:
What's the RF component?
I don't have access to the files... I've made a request.

doohans, 2021-05-01:
i changed access files. please open them again.

pascallanger, 2021-05-01:
Something is not correct in the dumps. Please redo them at 12MHz or 16MHz instead of 8MHz which is too low.

pascallanger, 2021-05-01:
Also the dumps for throttle and steering are too small.
You need to move slowly and independently each input:
 - one file with steering mid to max right then max left then mid
 - one file with throttle mid to max forward then max backward then mid
Make sure there is no trim or dual rate set on the TX while doing this.

doohans, 2021-05-01:
ok. i re-dump spi capture files with 16Mhz option.

https://drive.google.com/drive/folders/16Kq-LmScoJGK6ErM9ImJxX5dkFxbmOmo?usp=sharing

i found something weird.

i tried a couple of times. and i got same error on same position.
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

and many errors occur during dumping. i think ENABLE signal is NOT stable.
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

I attached not only hex files but also .logicdata files. please check the files.

thank you.

doohans, 2021-05-02:
I didn't connect GROUND.
Finally, I've got clean ENABLE signal with GROUND connection.

Please refer to the following files.

https://drive.google.com/drive/folders/1-u6e7i3Jdhp6qhw1Ur9FAB4QOkQaEmGh?usp=sharing

Thanks.

pascallanger, 2021-05-02:
It looks far better now. They use a mode with the cyrf that I haven't seen so far so my decoder is struggling, I'll see if I modify it to fully decode what's being sent.
They always transmit on the same channel. At power up they scan starting at 0x13 every odd channel until they find one which probably has the lowest low RSSI, 0x27 in the dump. Then they try 8 different data codes to most likely see if another TX is transmitting but this is an assumption.
After that they set one last data code and transmit bind packets every 8.8ms.
Bind data code:
0xD7 | 0xA1 | 0x54 | 0xB1 | 0x5E | 0x89 | 0xAE | 0x86 | 0xC9 | 0x2C | 0x06 | 0x93 | 0x86 | 0xB9 | 0x9E | 0xD7
-- | -- | -- | -- | -- | -- | -- | -- | -- | -- | -- | -- | -- | -- | -- | --

Bind packets:
0x47 | 0x52 | 0xAE | 0xAA | 0x47 | 0x52 | 0xAE | 0xAA | 0x05 | 0x52
-- | -- | -- | -- | -- | -- | -- | -- | -- | --
ID[0]|ID[1]|ID[2]|ID[3]|ID[0]|ID[1]|ID[2]|ID[3]|??|??

In normal mode, they send 3 channels. The payload is somehow obsfucated. Most likely xored but not only since the bits seem to also not be in order.
The normal data code is:
0x5F | 0x30 | 0x3B | 0x56 | 0x96 | 0x45 | 0xF4 | 0xA1 | 0x03 | 0xBC | 0x6E | 0x8A | 0xEF | 0xBD | 0xFE | 0xF8
-- | -- | -- | -- | -- | -- | -- | -- | -- | -- | -- | -- | -- | -- | -- | --

And the data:
0x47 | 0x52 | 0xAE | 0xAA | 0x56 | 0x87 | 0x38 | 0x85 | 0x57 | 0xF6
-- | -- | -- | -- | -- | -- | -- | -- | -- | --
ID[0]|ID[1]|ID[2]|ID[3]|ST|ST|TH|TH|CH3|CH3

pascallanger, 2021-05-02:
Can you do a dump where you move extra slowly the steering wheel?
Turn the steering full left, start to record and move extremely slowly until you reach full right.

doohans, 2021-05-02:
ok. starting with Full left steering.

https://drive.google.com/file/d/1CfjmJ8VtNx1vGHFijGw69UUfWpEEdLz8/view?usp=sharing https://drive.google.com/file/d/1YLHtLzsR0qRbKNwYSUnB7yXDOGxKJpCT/view?usp=sharing

doohans, 2021-05-02:
i can't remove trim value both throttle and steering. because there is only analog knob to adjust trim without any LCD screen on my TX. so i it's very hard to make it center value. i adjust them to center position in case of only for my LOSI TRAIL TRREKER.

pascallanger, 2021-05-02:
In the example above for steering, the value sent is 0x56 0x87.
0x687 is the steering wheel position which goes from 0x000 to 0xD1E, 0x68C being the middle which is not too far from the expected middle (0xD1E-0x000)/2=0x68F.
The problem is the high nibble 5 in the example above. It seems to be a sort of check of the attached value.
Example of the check where we see that the high nibble is xored by F when the bit3 of the value is changing:
0x57 | 0xF4
-- | --
0x57 | 0xF5
0xA7 | 0xF3
0xA7 | 0xF2

I'll now check the new dump to see if it becomes more clear.

pascallanger, 2021-05-02:
So far I've reversed the check for the first 8 bits. Still 4 to go...

pascallanger, 2021-05-02:
I have the 12 bits:
b0 | b1 | b2 | b3 | b4 | b5 | b6 | b7 | b8 | b9 | b10 | b11
-- | -- | -- | -- | -- | -- | -- | -- | -- | -- | -- | --
0 | 0 | F | 1 | D | A | B | 6 | C | 8 | F | 1

If the bits are set then xor with the table value above and finish by a final xor of B.

pascallanger, 2021-05-02:
It could be written differently like b12=1^b2^b3^b4^b6^b10^b11, b13=1^b2^b5^b6^b7^b10, b14=..., b15=...
Not sure what's the most effective way to code it but I think I'll go with the table above.

doohans, 2021-05-02:
Wow you almost solved it. I am very excited and looking forward to it.

pascallanger, 2021-05-03:
Looking now at the cyrf config, they've disabled CRC. This is why they are adding these check/FEC like bits on the channel values.
Therefore I'm now wondering if the last 2 bytes of the bind packet could be a CRC. That would prevent us to change the ID if we have only your TX ID... So let's see.

pascallanger, 2021-05-03:
@doohans Please test v1.3.2.80 available here: https://downloads.multi-module.org/latest-test/
It uses your TX ID and settings for now so you don't have to bind the RX (but you can test it).
In the case it works 🤞, more tests will have to be conducted to check if we can change the ID and settings.

doohans, 2021-05-03:
GREAT!!. This works perfectly!!

pascallanger, 2021-05-03:
> GREAT!!. This works perfectly!!

Control works fine, correct?
Ok, have you tried to bind? Is the RX reacting correctly (blinking pattern)? With Multi you have to press the bind button on the UI (not at powerup like the original).
Are you able to compile the source code by yourself so I can guide you to do and test some modifications?

doohans, 2021-05-03:
It didn't work the first time I didn't bind.
However, after binding, it worked normally.
The binding appears to be working correctly.
I am using multi in PPM mode. So, I am using the source code. I can do simple coding.

pascallanger, 2021-05-03:
There are a few tests to be conducted.
First one is: in Losi_cyrf6936.ino, can you change this section: https://github.com/pascallanger/DIY-Multiprotocol-TX-Module/blob/96b8a500b4f9c1e20f3b68dd0d09ab13ce431624/Multiprotocol/Losi_cyrf6936.ino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
From:
```
	#ifdef LOSI_FORCE_ID
		rx_tx_addr[0] = 0x47;
		rx_tx_addr[1] = 0x52;
		rx_tx_addr[2] =	0xAE;
		rx_tx_addr[3] =	0xAA;
		num_ch = 8;												// It looks that you could choose what you want based on channel business
	#endif

```
To:
```
	num_ch=(random(0xfefefefe)&0x07)+1;
	#ifdef LOSI_FORCE_ID
		rx_tx_addr[0] = 0x47;
		rx_tx_addr[1] = 0x52;
		rx_tx_addr[2] =	0xAE;
		rx_tx_addr[3] =	0xAA;
		//num_ch = 8;												// It looks that you could choose what you want based on channel business
	#endif
```

doohans, 2021-05-03:
The binding seems to work fine.
However, neither steering nor throttle works. My car doesn't move at all.

pascallanger, 2021-05-03:
Ok...
Try this:
```
	#ifdef LOSI_FORCE_ID
		//rx_tx_addr[0] = 0x47;
		//rx_tx_addr[1] = 0x52;
		//rx_tx_addr[2] =	0xAE;
		//rx_tx_addr[3] =	0xAA;
		num_ch = 8;												// It looks that you could choose what you want based on channel business
	#endif
```

doohans, 2021-05-03:
can't binding.

pascallanger, 2021-05-03:
Ok so without another radio (and the RX at hand), I have no idea how to add another ID...

doohans, 2021-05-03:
I have only ONE Losi TX.. we have to wait another person who can capture this TX signal...

Thank you very much for your hard work.

pascallanger, 2021-05-03:
Can you confirm the latest push to github is still working ok?

doohans, 2021-05-03:
It's not working correctly.

Binding succeeds, but no control.
If i  try it several times, it rarely gets in control.

pascallanger, 2021-05-03:
Hummm, I'm not sure this is due to the last push...
If you do get control after powercycling a few times, my guess is that the top rf channel is too high.
Can you try to change this line:
https://github.com/pascallanger/DIY-Multiprotocol-TX-Module/blob/96b8a500b4f9c1e20f3b68dd0d09ab13ce431624/Multiprotocol/Losi_cyrf6936.ino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
to:
CYRF_FindBestChannels(hopping_frequency, 1, 0, 0x13, 0x27);

doohans, 2021-05-03:
same. binding is ok.
but i cant control both thottle and steer.
i can hear some servo noise when i turn steering wheel. but car doesnt move.

doohans, 2021-05-03:
i re-test with initial version you pushed. (i use latetest source replace only Losi_cyrf6936.ino file <96b8a500b4f9c1e20f3b68dd0d09ab13ce431624>)

same result. binding is ok. only few times i can control throttle and steering.
Even with success, if I turn the power off and on, I lose control again.

pascallanger, 2021-05-03:
Can you change CYRF_ConfigRFChannel(hopping_frequency[0] | 1); to CYRF_ConfigRFChannel(0x27);

doohans, 2021-05-03:
do i test with latetest version?  or initail version?

pascallanger, 2021-05-03:
They are basically the same in my eyes.

doohans, 2021-05-03:
it's working. binding is ok.
Even if the power is turned off, it works corretly. i can control both th and st.

~~~
void LOSI_init()
{
	LOSI_cyrf_init();
	CYRF_FindBestChannels(hopping_frequency, 1, 0, 0x13, 75);	// 75 is unknown since dump stops at 0x27, this routine resets the CRC Seed to 0
	CYRF_ConfigRFChannel(0x27);				// Only odd channels

	#ifdef LOSI_FORCE_ID
		rx_tx_addr[0] = 0x47;
		rx_tx_addr[1] = 0x52;
		rx_tx_addr[2] = 0xAE;
		rx_tx_addr[3] = 0xAA;
	#endif

	if(IS_BIND_IN_PROGRESS)
	{
		bind_counter = 300;
		CYRF_ConfigDataCode(LOSI_data_code[0], 16);				// Load bind data code
	}
	else
	{
		CYRF_ConfigDataCode(LOSI_data_code[1], 16);				// Load normal data code
		bind_counter = 0;
	}
}
~~~

doohans, 2021-05-03:
No binding with below code

~~~
	#ifdef LOSI_FORCE_ID
		//rx_tx_addr[0] = 0x47;
		//rx_tx_addr[1] = 0x52;
		//rx_tx_addr[2] = 0xAE;
		//rx_tx_addr[3] = 0xAA;
	#endif
~~~

pascallanger, 2021-05-03:
Leaving the module on and working, can you do a dump of power on of the original radio?

doohans, 2021-05-03:
is the module Multi module? so you mean that i turn on my multi module and original TX at same time?

pascallanger, 2021-05-03:
yes both on, first multi module then do a dump of the original TX boot

doohans, 2021-05-03:
ok i will test last success code.

doohans, 2021-05-03:
here dump.

[both_original_module.txt](https://github.com/pascallanger/DIY-Multiprotocol-TX-Module/files/6416090/both_original_module.txt)

pascallanger, 2021-05-03:
Can you do multiple dumps (at least 3) with multi on and the power on of the original TX?

Using the code from the first version, can you change this section: https://github.com/pascallanger/DIY-Multiprotocol-TX-Module/blob/96b8a500b4f9c1e20f3b68dd0d09ab13ce431624/Multiprotocol/Losi_cyrf6936.ino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
From:
```
	#ifdef LOSI_FORCE_ID
		rx_tx_addr[0] = 0x47;
		rx_tx_addr[1] = 0x52;
		rx_tx_addr[2] =	0xAE;
		rx_tx_addr[3] =	0xAA;
		num_ch = 8;												// It looks that you could choose what you want based on channel business
	#endif

```
To:
```
	num_ch = (random(0xfefefefe)&0x07)+1;
	#ifdef LOSI_FORCE_ID
		rx_tx_addr[0] = 0x47;
		rx_tx_addr[1] = 0x52;
		rx_tx_addr[2] =	0xAE;
		rx_tx_addr[3] =	0xAA;
		//num_ch = 8;												// It looks that you could choose what you want based on channel business
		CYRF_ConfigRFChannel(0x27);				// Only odd channels
	#endif
```
Try multiple power on/off to see if you keep control all the time.

doohans, 2021-05-03:
I did the test you requested.
basically I use source code you linked.
https://github.com/pascallanger/DIY-Multiprotocol-TX-Module/blob/96b8a500b4f9c1e20f3b68dd0d09ab13ce431624/Multiprotocol/Losi_cyrf6936.ino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

and i modified like below
~~~
void LOSI_init()
{
	LOSI_cyrf_init();
	CYRF_FindBestChannels(hopping_frequency, 1, 0, 0x13, 75);	// 75 is unknown since dump stops at 0x27, this routine resets the CRC Seed to 0
	CYRF_ConfigRFChannel(hopping_frequency[0] | 1);				// Only odd channels

	num_ch = (random(0xfefefefe)&0x07)+1;
	#ifdef LOSI_FORCE_ID
		rx_tx_addr[0] = 0x47;
		rx_tx_addr[1] = 0x52;
		rx_tx_addr[2] =	0xAE;
		rx_tx_addr[3] =	0xAA;
		//num_ch = 8;												// It looks that you could choose what you want based on channel business
		CYRF_ConfigRFChannel(0x27);
	#endif

	if(IS_BIND_IN_PROGRESS)
	{
		bind_counter = 300;
		CYRF_ConfigDataCode(LOSI_data_code[0], 16);				// Load bind data code
	}
	else
	{
		CYRF_ConfigDataCode(LOSI_data_code[num_ch], 16);		// Load normal data code
		bind_counter = 0;
	}
}
~~~

I did follow script.

1. I tried to bind with Multi Module until the binding was successful. I confirmed that I can control the car with the Multi.
2. I kept the Multi powered on.
3. I Started to record dump.
4. then. I Turned On original TX. -> failed to control the car with original TX.
5. I tested it by repeatedly toggling the power of the original TX.
6. I turned off power of original TX.
7. I stopped to record dump.

Closed 2021-09-25.

Thread 595 (2021-06-28):

Can't flash my board

Spolverino, 2021-06-28:
I have been trying to flash my board for days since it has no bootloader: no serial pins (tx/rx) and getting boot0 error using SPI interface although boot0 is tied to 3.3v

pascallanger, 2021-06-28:
?

Spolverino, 2021-06-28:
sorry this is my first time commenting on github

pascallanger, 2021-06-28:
Still, no idea what is your problem... Which module? which current version? which radio? which fw on the radio?...

Spolverino, 2021-06-28:
My module is the jp4in1. I don’t know what the firmware version is but there’s a v1.2 on the pcb.
![Uploading E91B9CDA-055B-4C2C-B6F5-B249B585C023.jpeg…]()

Spolverino, 2021-06-28:
I am using an fs i6x’s ppm output and feeding it to the module

pascallanger, 2021-06-28:
To update the module follow: https://www.multi-module.org/using-the-module/firmware-updates#update-process

Spolverino, 2021-06-28:
already tried all the methods avalable to me (all except the radio one since mine doesn't support it)
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

Spolverino, 2021-06-28:
And since my board doesn't have the rx and tx pins I can't update my bootloader as already said.

pascallanger, 2021-06-28:
Enable verbose output.
My guess (from the little the arduino window is telling) is that your antivirus as quarantined one file which is needed to flash...

pascallanger, 2021-06-28:
> And since my board doesn't have the rx and tx pins I can't update my bootloader as already said.

None sense comment on this module...

Spolverino, 2021-06-28:
Looking for Maple device ...

No MULTI-Module device found.

Probing serial port COM12 for STM32 in BOOT0 mode ...
Failed to init device.
stm32flash 0.4

http://stm32flash.googlecode.com/

Interface serial_w32: 115200 8E1

Module in BOOT0 mode not found on COM12

pascallanger, 2021-06-28:
That's not the verbose output of FlashMulti.
Also above screenshots show COM13 and this one is COM12...

Spolverino, 2021-06-28:
yes it's the verbose output from the arduino as you requested.
Enabled it on the FlashMulti now.
For the COM port: I tried using the usb connection to my module to program it. Had used different arduinos before and the result was still the same.

.\tools\stm32flash.exe -b 115200 -r "C:\Users\nicol\AppData\Local\Temp\tmp5891.tmp" COM13

stm32flash 0.4
Failed to init device.

http://stm32flash.googlecode.com/

Interface serial_w32: 115200 8E1

benlye, 2021-06-28:
Try different USB cables, different USB ports, and if you can, a different computer.

Spolverino, 2021-06-28:
Have already tried all of that sadly :/ Even went to a friend to test it on his computer

Spolverino, 2021-06-28:
is the cp2102 ic in charge of USB programming? Could it be possible to manually solder some wires to it's rx tx pins in order to flash the bootloader?

benlye, 2021-06-28:
Just looked closely at the image - you have 3V3 bridged to BOOT0.  You should remove that so that you can use the USB port.

benlye, 2021-06-28:
> is the cp2102 ic in charge of USB programming? Would it be possible to manually solder some wires to it's rx tx pins in order to flash the bootloader?

If you want to try something like that you could try to solder directly to the RX and TX pins on the STM32F1, bypassing the CP2102 entirely.

Spolverino, 2021-06-28:
Yes I removed it while programming from usb

> Just looked closely at the image - you have 3V3 bridged to BOOT0 with solder. You should remove that so that you can use the USB port.

Spolverino, 2021-06-28:
> > is the cp2102 ic in charge of USB programming? Would it be possible to manually solder some wires to it's rx tx pins in order to flash the bootloader?
>
> If you want to try something like that you could try to solder directly to the RX and TX pins on the STM32F1, bypassing the CP2102 entirely.

Yes I'll try this way. I have an stlink to flash the stm

benlye, 2021-06-28:
> Yes I'll try this way. I have an stlink to flash the stm

None of our programming tools (neither Arduino IDE or Flash Multi) support using an ST-Link, so you're on your own with that.

Spolverino, 2021-06-28:
Is there an alernative which works with Arduino or flashmulti?

benlye, 2021-06-28:
> Is there an alernative which works with Arduino or flashmulti?

Yes, an external USB-to-serial adapter connected directly to the RX and TX pins on the STM32.  I would usually recommend anything with a CP2102 on it.  Just make sure whatever you use operates at 3V3.

Closed 2021-06-28.

Thread 608 (2021-08-15):

DIY module FS2A_RX dropouts

sasodoma, 2021-08-15:
Hello,

I wanted to have wireless trainer using my TX18S as the main radioand a FlySky FS-i6X as the slave radio. My radio came with a MPM and both FlSky2A and FS2A_RX protocols work on it without a problem. To do wireless trainer I needed another MPM that would receive the signal. So I bought and Arduino Pro Mini and an A7105 module and put together a simple MPM on a perfboard. Flashed it with 1.3.2.86 selecting only the A7105. The module works and binds sucessfully in FS2A_RX protocol and I can setup the trainer settings. But when using it the radio randomly says "Trainer signal lost" and the settings report "No MULTI_TELEMETRY detected". Sometimes the MPM is detected again on its own or I can turn the slave radio off and on, reset the arduino or disconnect and reconnect the serial connection between the radio and the arduino. All of these will make the radio detect the MPM again. Also all of this is with the internal MPM turned off, so no interference.

Is there a way to debug the firmware on an Atmega?

MPM hardware: Arduino Pro Mini 5V 16 MHz + XL7105 (A7105 module)
Multiprotocol FW version: 1.3.2.86
Radio: Radioking TX18S (Fake Jumper T18) with JP4IN1 (same as JP5IN1 without SX1276)

Schematic:
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

pascallanger, 2021-08-16:
What's the power supply voltage on the J1.3 pin? The issue I could see is that your 3.3V regulator (missing the input/output capacitors by the way) is probably not able to power the arduino+module and causing the resets or hangs up you see. Which is why on the original design you can see a first stage of bringing the voltage down to 5V then a second stage to 3.3V.

sasodoma, 2021-08-16:
Thank you for the quick response. I also suspected power problem, which is why I had already added capacitors to the regulator, but it didn't help. As per your suggestion I also tried adding a 7805 regulator before the LM1117 and just for good measure I soldered capacitors across the arduino and a7105 power pins. Still got dropouts. To completely rule out the regulator I powered the whole module from the 3.3V rail of an ATX power supply and still got dropouts. I did try switching to the FlSky2A protocol and just flying my whoop around the house and that seemed to work fine. Maybe something about the RX protocol is causing problems on the Atmega but not on an STM32 (the internal module). What else could I test?

Closed 2021-09-25.

Thread 646 (2021-12-14):

ZHCHORC TOYS / ZC Z50 CESSNA (Tx: XNS1042CV, Rx: XNS1042CV)

PinkLolicorn, 2021-12-14:
This is the current data gathered on the ZHCHORC TOYS ZC-Z50 plane.

### Protocols
- Bayang Std/H8S3D/X16 AH/IRDrone/DHD D4/QX100: no bind
- BayanRX: no bind
- BugsMini Std/Bugs3H: no bind
- CG023 Std/YD829: no bind
- CX10 Green/Blue/DM007/JC3015a/JC3015b/MK33041: no bind
- DM002: no bind
- E016H: no bind
- E016H v2 (-80, -40, 0, 40, 80): no bind
- GD00x GD_V1 (-80, -40, 0, 40, 80): no bind
- GD00x GD_V2 (-80, -40, 0, 40, 80): no bind
- GW008: no bind
- H8 3D Std/H202H/H20Mini/H30Mini: no bind
- Hontai Std/JJRC X1/X5C1/FQ_951
- JJRC345 JJRC345/SkyTmblr: no bind
- JOYSWSAY: no bind
- KF606: no bind
- MJXq WLH08/X600/X800/H26D/E010/H26WH/Phoenix: no bind
- **MouldKg: not found in 1.3.3.0?**
- MT99XX MT99/H7/YZ/LS/FY805/DRAGON/F949G: no bind
- OMP: no bind
- Potensic A20: no bind
- Q303 Std/CX35/CX10D/CX10WD: no bind
- Q90C: no bind
- Redpine Fast/Slow: no bind, never tried freq tuning due to highly different spectrum
- Tiger: no bind
- V761 3ch/4ch: no bind
- V911S V911S/E119: no bind
- Xerall: no bind
- XK X450/X420: no bind
- ZSX 280JJRC: no bind

### Tx

**XNS1042CV**
2114CTa

Mentioned in the Eachine E016H issue: https://github.com/pascallanger/DIY-Multiprotocol-TX-Module/issues/469#issuecomment-727174903
Mentioned in the C17 issue: https://github.com/goebish/nrf24_multipro/issues/58

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

**Tx awaiting pairing**

- 2407 MHz

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

Note: it seems like the first spectrum analysis picked up faint reflected signal which was visible on the left, in the second picture, the signal is on the right.

**Tx paired**

- 2452 MHz
- 2455 MHz

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

### Rx

**XNS1042CV**
2114CTa

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

pascallanger, 2021-12-15:
The XNS is a XN297 compatible component. If you have an external multi module, it should be straight forward to reverse. On an internal module you need to soder 2 wires to a FTDI(USB to serial 3.3v).

pascallanger, 2021-12-15:
You want to make is something like this: https://github.com/pascallanger/DIY-Multiprotocol-TX-Module/issues/610#issuecomment-902468945
You cn read the full thread to learn but here is a summary. Connect GND and TX from the internal multi module to the GND and RX of your FTDI. Then load a debug firmware and find the XN297DUMP protocol, sub proto auto, on the PC open a terminal or flash multi serial monitor and share the output file.

PinkLolicorn, 2021-12-15:
I would also like to ask: which external module is best suited for this application?

pascallanger, 2021-12-15:
On any external multi module, you would just plug the usb cable, install the debug firmware and dump. No modification/soldering/... required.

PinkLolicorn, 2021-12-15:
Ok, so this would be a completely separate setup from my current radio that runs on the USB power as the external device - just like HackRF, is that correct?

pascallanger, 2021-12-15:
The external multi module would be plugged on the back of the radio, connected to the PC using USB and configured through the radio UI under the protocols.

PinkLolicorn, 2021-12-15:
Oh, ok. I have found "IRangeX IRX6" modules and similar version with the right connector for my radio:

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

Is this one suitable for the dumping of XN297-based devices? It lists Eachine E010, but I don't see any obvious indication where to solder the FTDI.

I noticed this one is mentioned in the https://github.com/pascallanger/DIY-Multiprotocol-TX-Module/issues/157 so my suspicion that this is NRF24L01 module is right.

It seems like using the full module for the sole purpose of dumping is a bit of a waste, so this one would be nice with permanently soldered FTDI, and is even fairly cheap.

pascallanger, 2021-12-15:
No it doesn't run my code, not upgradable, short range,...

PinkLolicorn, 2021-12-15:
Thanks for the clarification. Are there any single-chip modules worth considering?

pascallanger, 2021-12-15:
no...

PinkLolicorn, 2021-12-15:
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

Is this the correct TX and GND?

PinkLolicorn, 2021-12-15:
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

I'm not sure what is the cause of this. Standard firmware flashing works fine. Is there a chance the downloads page has an incorrect version of the firmware for the external module?

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

pascallanger, 2021-12-16:
> 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
>
> Is this the correct TX and GND?

Yes this is correct. (previous was off by one pin ;-) )

pascallanger, 2021-12-16:
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

The file is the right one... Which version of OpenTX are you running? Latest versions are supposed to not check inv noinv anymore since this is an autodetection in place instead.

PinkLolicorn, 2021-12-16:
> previous was off by one pin

Yes, I edited this post three times in one minute because the alignment of printing was so confusing that I accidentally marked the wrong ones in the screenshots two times in a row while first correctly telling their position physically (by order). 😆

> The file is the right one... Which version of OpenTX are you running? Latest versions are supposed to not check inv noinv anymore since this is an autodetection in place instead.

It would be 2.3.11-otx (4328055e). My radio had it preinstalled. I thought of upgrading when this issue came to light, but it seemed a lot more hassle than updating multi alone, and I didn't see anything related in the changelogs. I guess there is no escape from that now. Likewise, I'm going to upgrade it and try again with the ftdidump.

PinkLolicorn, 2021-12-16:
So, I got 2.3.14-otx (1e09791a) installed, and it still does not allow me to flash with ftdidebug version.

pascallanger, 2021-12-16:
Same error message?

pascallanger, 2021-12-16:
Can you try the bin from the latest version: https://downloads.multi-module.org/latest-test/

PinkLolicorn, 2021-12-16:
Yes, it looks the same, at least to me. Using 1.3.3.6 also yields the same message.

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

pascallanger, 2021-12-16:
Hummm ok, we can give it a no inv file. I'll compile you something this evening after work.

benlye, 2021-12-16:
I don't think that will help.  The reason the radio won't flash the file is that the FTDI debug files are built without support for the bootloader.  All internal modules have the bootloader installed so even if you were able to flash this FW to the module from the radio, it would not work (the FW simply won't run).

Our Arduino board definitions don't actually have a way to build an FTDI debug FW with bootloader support.  The only way to get a debug build on the internal module would be to connect an external FTDI adapter and flash it from the Arduino IDE or using Flash Multi.  This would remove the bootloader so afterwards you would need to use the IDE or Flash Multi to re-install non-debug FW and the bootloader.

PinkLolicorn, 2021-12-16:
I don't really feel like messing that much with my internal module. Seems like I will be getting iRangeX IRX4 for this job, which should arrive at the end of the year (and plus version would be an additional month, so I'm going to ignore that it exists).

benlye, 2021-12-16:
It's not as bad as it sounds - you can solder wires to the pins and have a 5-pin dupont connector on the other end ready to attach to your FTDI adapter.  When you're not using it you can tuck it under the antenna/USB port cover and only pull it out when you need it.  You do have to deal with BOOT0 as well, which requires putting a diode in the wiring harness so that you can leave it attached all the time.

But yeah, that is a lot of hassle compared to using an external module.  A JP4IN1 would work as well if you can get one of those more easily than the IRX4+.  The USB port is convenient to have on any external module.

PinkLolicorn, 2021-12-16:
I don't see JP4IN1 anywhere in stock. I'm ok with soldering the missing bits to the IRX4 later if needed. Not only that, but I don't really like the protruding rotary switch of the plus version anyway. Also, it was 40% less for the basic version, so there's that.

Lagarda, 2021-12-28:
Hi to Everyone!
what is XNS1042CV? Is there any analogue? Do you have a datasheet?

PinkLolicorn, 2022-01-12:
I got my iRangeX, but I was unable to connect it successfully with my PC. It works fine in the radio, pairs with the rx. I can flash different firmware from OpenTX etc.

I was, however, not able to do anything from the Flash Multi. It behaves the same as the module was never connected and for example displays "Failed to read the MULTI-Module".

I had no success with flashing debug firmware for ftdidebug from the OpenTX due to the same issue as before but opposite side (needs inv file) and seen no output with usbdebug. Also tried checking for output with PuTTY.

Connecting the USB yields a windows' notification with the contents of: `unknown usb device (device descriptor request failed)`. For a moment I thought this may be a bootloader issue but isn't it already available as I can flash the module from the OpenTX?

I tried installing the drivers as described here, made sure the module was connected with the PC: https://github.com/benlye/flash-multi/blob/master/doc/Troubleshooting.md#solution-1

Not sure how to proceed.

benlye, 2022-01-12:
When the module is plugged into the PC, what are the LEDs on it doing?

Also, does it have a physical bind button? If so, can you try plugging it in while holding the button down?

benlye, 2022-01-12:
Something else you can try...

It sounds like you're running recent firmware, which doesn't have support t for the USB port, but the old bootloader.

You can try flashing this FW to the module using the radio
https://github.com/pascallanger/DIY-Multiprotocol-TX-Module/releases/tag/v1.3.1.59

After that you may be able to use Flash Multi to install the newer bootloader, as described here
https://github.com/benlye/flash-multi/blob/master/doc/New_Bootloader.md

PinkLolicorn, 2022-01-12:
> When the module is plugged into the PC, what are the LEDs on it doing?

Should they light up when the module is connected to the USB, being outside the radio? Because they don't, only if in the radio. It wasn't entirely clear in the many places where the module should be and does it matter.

> Also, does it have a physical bind button? If so, can you try plugging it in while holding the button down?

Well, it does not, and I only have bigger buttons of that type, but I could probably add some jumper. Which pads need to be connected?

I added most of these connections myself and wonder if there may be something "broken" with the ftdi/usb in the nonplus version on the hardware level, but seems unlikely as LEDs work? I don't think I broke something, at least visibly, no bridges, no misplaced components, I even cleared the module with isopropyl alcohol at some point just to make sure there are no unexpected connections from residual flux etc.

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

> It sounds like you're running recent firmware, which doesn't have support t for the USB port, but the old bootloader.

Just flashed it and tried briefly with no changes. I'm still getting the same error notification and no COM port is registered. Should I try something more specific?

benlye, 2022-01-13:
When you plug the module in via USB it's important that it's not being powered by the radio - is your radio off?

When you first plug it in the red led should flash very quickly, then a little slower, then even slower.  If you watch the first 20s or so of this video you'll see what I mean - https://youtu.be/IvNgOQxHdD0

PinkLolicorn, 2022-01-20:
> If you watch the first 20s or so of this video you'll see what I mean

Well, my module does not light up when connecting just to the PC like in the video.

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

I really wonder if there is something going on with this nonplus version that I have that prevents both USB and FTDI from working. Everything seems to be there, but I'm not so familiar with the design.

I think I will try some other usb sockets or soldering directly to the breakout board to exclude something being funky about these I got currently. But FTDI is not working too, so it does not fill me with optimism. 😆

benlye, 2022-01-20:
Very odd. My module (the one in the video) is also the non plus with only the LEDs and USB port added.

I notice that you haven't put headers on the BOOT0 pins. You can connect to the FTDI pins with an external USB to serial adapter (like a CP2102), including 3V to power it, but you do need to bridge BOOT0 on order to flash firmware or the bootloader that way.

filipkotoucek, 2022-12-26:
Hello. I just received ZC-Z50 Cessna without the main motor in front (don't know if that matters). I had touble to binding to it using irangex x4plus module with FW 1.3.3.20. TX is Taranix qx7 with edgeTX 2.7.1. I tried both subprotocols for GD00X even with fine tuning over the full spectrum with 40 increments.

This led me to thought if the protocol is not somehow different. I tried to dump the communication. Here is the log:

Only TX is on:
```
Protocol selected: 63, sub proto 3, rxnum 0, option 0
XN297 dump, address length=5, bitrate=250K
Proto=XN297DP, nbr_sub=6, Sub=Auto  , Opt=8, FS=0, CHMap=0, rfSw=2
------------------------
Detecting XN297 packets.
XN297 dump, address length=5, bitrate=250K
Trying RF channel: 0,1,2,3,4,5,6,7

Packet detected: bitrate=Using NRF
250K C=7 S=Y A= E7 E7 E7 E7 E7 P(4)= AA 67 64 01
--------------------------------
Identifying all RF channels in use.
Trying RF channel: 0,1,2,3,4,5,6,7
RX on channel: 7, Time:     0us P: AA 67 64 01
RX on channel: 7, Time:  2994us P: AA 67 64 01
RX on channel: 7, Time:  2994us P: AA 67 64 01
RX on channel: 7, Time:  2997us P: AA 67 64 01
RX on channel: 7, Time:  2991us P: AA 67 64 01
RX on channel: 7, Time:  2992us P: AA 67 64 01
RX on channel: 7, Time:  3000us P: AA 67 64 01
RX on channel: 7, Time:  2986us P: AA 67 64 01
RX on channel: 7, Time:  2991us P: AA 67 64 01
RX on channel: 7, Time:  2997us P: AA 67 64 01
RX on channel: 7, Time:  2988us P: AA 67 64 01
RX on channel: 7, Time:  2997us P: AA 67 64 01
RX on channel: 7, Time:  2997us P: AA 67 64 01
RX on channel: 7, Time:  2986us P: AA 67 64 01
RX on channel: 7, Time:  2996us P: AA 67 64 01
RX on channel: 7, Time:  2993us P: AA 67 64 01
RX on channel: 7, Time:  2995us P: AA 67 64 01
RX on channel: 7, Time:  2993us P: AA 67 64 01
RX on channel: 7, Time:  2997us P: AA 67 64 01
RX on channel: 7, Time:  2987us P: AA 67 64 01
RX on channel: 7, Time:  2994us P: AA 67 64 01

1 RF channels identified: 7
--------------------------------
Identifying RF channels order.
Time between CH:7 and CH:51

Channel order:
7:     0us

--------------------------------
Identifying Sticks and features.
```

The com between model and TX happens on ch 48 and 51. On identifying sticks I moved:
1. rudder stick (first byte changed)
2. trims (second byte changed 10 -> 11 etc)
3. RATE? ( second byte chanched 10 -> D0). This is quite interesting because the change does not have any impact on plane behaviour. There are 2 buttons on the TX front side.
   a. Left button which changes the value in dump beeps once everytime I click it but does not have impact on planes behaviour.
   b. Right button does not change the values in dump. First click beep twice, second click beeps once, third click beeps twice. And there is audible plane behavior change between those two modes, so I assume this would be the RATE button.

```
Protocol selected: 63, sub proto 3, rxnum 0, option 0
XN297 dump, address length=5, bitrate=250K
Proto=XN297DP, nbr_sub=6, Sub=Auto  , Opt=8, FS=0, CHMap=0, rfSw=2
------------------------
Detecting XN297 packets.
XN297 dump, address length=5, bitrate=250K
Trying RF channel: 0,1,2,3,4,5,6,7,8,9,10,11,12,13,14,15,16,17,18,19,20,21,22,23,24,25,26,27,28,29,30,31,32,33,34,35,36,37,38,39,40,41,42,43,44,45,461

Packet detected: bitrate=Using NRF
250K C=51 S=Y A= 0a0 AA 67 64 01 P(2)= 80 10
--------------------------------
Identifying all RF channels in use.
Trying RF channel: 0,1,2,3,4,5,6,7,8,9,10,11,12,13,14,15,16,17,18,19,20,21,22,23,24,25,26,27,28,29,30,31,32,33,34,35,36,37,38,39,40,41,42,43,44,45,468
RX on channel: 48, Time:     0us P: 80 10
RX on channel: 48, Time:  5995us P: 80 10
RX on channel: 48, Time:  5983us P: 80 10
RX on channel: 48, Time:  5984us P: 80 10
RX on channel: 48, Time:  5991us P: 80 10
RX on channel: 48, Time:  5982us P: 80 10
RX on channel: 48, Time:  5983us P: 80 10
RX on channel: 48, Time:  5990us P: 80 10
RX on channel: 48, Time:  5983us P: 80 10
RX on channel: 48, Time:  5982us P: 80 10
RX on channel: 48, Time:  5986us P: 80 10
RX on channel: 48, Time:  5982us P: 80 10
RX on channel: 48, Time:  5985us P: 80 10
RX on channel: 48, Time:  5986us P: 80 10
RX on channel: 48, Time:  5989us P: 80 10
RX on channel: 48, Time:  5980us P: 80 10
RX on channel: 48, Time:  5990us P: 80 10
RX on channel: 48, Time:  5984us P: 80 10
RX on channel: 48, Time:  5984us P: 80 10
RX on channel: 48, Time:  5990us P: 80 10
RX on channel: 48, Time:  5983us P: 80 10
Trying RF channel: ,49,50,51
RX on channel: 51, Time:     0us P: 80 10
RX on channel: 51, Time:  5984us P: 80 10
RX on channel: 51, Time:  5992us P: 80 10
RX on channel: 51, Time:  5981us P: 80 10
RX on channel: 51, Time:  5993us P: 80 10
RX on channel: 51, Time:  5980us P: 80 10
RX on channel: 51, Time:  5988us P: 80 10
RX on channel: 51, Time:  5988us P: 80 10
RX on channel: 51, Time:  5981us P: 80 10
RX on channel: 51, Time:  5980us P: 80 10
RX on channel: 51, Time:  5998us P: 80 10
RX on channel: 51, Time:  5984us P: 80 10
RX on channel: 51, Time:  5980us P: 80 10
RX on channel: 51, Time:  5979us P: 80 10
RX on channel: 51, Time:  5993us P: 80 10
RX on channel: 51, Time:  5980us P: 80 10
RX on channel: 51, Time:  5983us P: 80 10
RX on channel: 51, Time:  5982us P: 80 10
RX on channel: 51, Time:  5989us P: 80 10
RX on channel: 51, Time:  5990us P: 80 10
RX on channel: 51, Time:  5986us P: 80 10
Trying RF channel: ,52,53,54,55,56,57,58,59,60,61,62,63,64,65,66,67,68,69,70,71,72,73,74,75,76,77,78,79,80,81,82,83,84,85,86,87,88,89,90,91,92,93,94,7

2 RF channels identified: 48 51
--------------------------------
Identifying RF channels order.
Time between CH:48 and CH:51
Time:  2996us
Time:  2996us
Time:  3001us
Time:  2996us
Time:  3008us
Time:  2984us
Time:  2993us
Time:  2994us
Time:  2988us
Time:  2991us
Time:  2996us
Time:  2996us

Channel order:
48:     0us
51:  2984us

--------------------------------
Identifying Sticks and features.
P: 80 10
P: 81 10
P: 86 10
P: 8B 10
P: 90 10
P: 95 10
P: 99 10
P: 9B 10
P: 9C 10
P: 9E 10
P: 9F 10
P: 9D 10
P: 97 10
P: 90 10
P: 87 10
P: 80 10
P: 7C 10
P: 77 10
P: 72 10
P: 6B 10
P: 67 10
P: 61 10
P: 5E 10
P: 5A 10
P: 57 10
P: 53 10
P: 52 10
P: 5C 10
P: 69 10
P: 76 10
P: 80 10
P: 83 10
P: 89 10
P: 90 10
P: 97 10
P: 9D 10
P: A2 10
P: A5 10
P: A7 10
P: AA 10
P: AB 10
P: AC 10
P: AD 10
P: AE 10
P: AF 10
P: AE 10
P: AD 10
P: AB 10
P: A7 10
P: 9F 10
P: 95 10
P: 89 10
P: 80 10
P: 7F 10
P: 7C 10
P: 7A 10
P: 77 10
P: 74 10
P: 73 10
P: 72 10
P: 70 10
P: 6E 10
P: 6C 10
P: 6B 10
P: 6A 10
P: 69 10
P: 6A 10
P: 6B 10
P: 6C 10
P: 71 10
P: 73 10
P: 77 10
P: 7B 10
P: 7C 10
P: 7F 10
P: 80 10
P: 7E 10
P: 7B 10
P: 77 10
P: 74 10
P: 72 10
P: 71 10
P: 70 10
P: 6F 10
P: 70 10
P: 75 10
P: 7F 10
P: 80 10
P: 81 10
P: 82 10
P: 83 10
P: 84 10
P: 85 10
P: 86 10
P: 85 10
P: 84 10
P: 83 10
P: 82 10
P: 81 10
P: 80 10
P: 80 11
P: 80 12
P: 80 13
P: 80 12
P: 80 11
P: 80 10
P: 80 0F
P: 80 0E
P: 80 0D
P: 80 0E
P: 80 0F
P: 80 10
P: 80 D0
P: 80 10
```

Sadly I don't know how to catch the bind in the logs.

Is there anybody who would know how to help me find where is the bug or what am I doing wrong?

Closed 2022-07-07.

Thread 673 (2022-03-25):

Add FX601

albatorsssx, 2022-03-25:
Hello,
Can you add the FX 601 model?
Here is a link to the product:
https://www.banggood.com/FX601-2_4Ghz-2CH-235mm-Wingspan-Delta-Wing-EPP-RC-Airplane-RTF-with-3-Axis-Gyro-System-p-1687052.html?ID=531270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
And attached is a picture of the radio.
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

I've try the FX816 protocol but it seems not to work. No binding.

Thank you in advance.

pascallanger, 2022-07-18:
You can try the new FX 620 subprotocol using the latest test version.
Please report if it works.

albatorsssx, 2022-07-19:
Hello,

Thank you very much for the implementation. I put the latest test version but I don't see the new protocol.

Is there a problem ?

Thanks,

Jean Louis

albatorsssx, 2022-07-19:
Yes I have access but it's not for my module, I have a iRangeX IRX4 (mm-stm-serial-aetr). Sorry.

pascallanger, 2022-07-21:
Test builds are now available. Please try and report.

albatorsssx, 2022-07-21:
Yes He is present. Thanks. Unfortunately no binding. Should I configure the channels in a certain way?

pascallanger, 2022-07-21:
Have you tried other protocols like kf606 and such since looking at the pictures the board seems to be similar.

albatorsssx, 2022-08-05:
Sorry for the late response. I was on vacation. I tested but it doesn't work. No bind. It doesn't matter if it doesn't work, the device is just a toy. Thank you anyway for the time spent on this.

pascallanger, 2022-08-05:
Yeah without the hardware there is nothing I can do. And frankly, FX "toys" airplanes are quite bad since they have no proportionality on ailerons just throttle.

Closed 2022-08-05.

Thread 676 (2022-04-04):

DSM Programming Spektrum Avian

chucky-whiskers, 2022-04-04:
Someone recently asked about DSM Forward Programming a Spektrum Avian ESC for "reverse throttle" functions etc... on a TX16S. This is a plausibly worthwhile update if it is not already working on the current version. I pointed this person to this lua script. It is worth looking into.

pascallanger, 2022-07-07:
Not sure what you are requesting... This someone should come here and explain the issue.

pitts-mo, 2022-08-06:
I recently stumbled onto this while attempting to add a head tracking pan/tilt system for a friend insists on the Avian feature of reversing via an additional AUX switch :-/.

An Avian ESC utilized with a Spektrum receiver allows for enhanced ESC configuration via a telemetry related extension from a Spektrum radio.

observations/understanding:
A Spektrum radio running "Avian Prog" appears to display a menu that can be navigated via stick commands. The result feels very similar to OSD control via MSP DisplayPort telemetry. It is my current belief that the Spektrum RX is generating this interface OR the Spektrum RX must be passing all the RX channels into the ESC pin in order for the AVIAN ESC to process the stick commands and generate the menu to send back over telemetry.

Spektrum Quick Hit Tech Tip - How to setup Thrust Reversing on Avian ESCs and BNF Aircraft
https://www.youtube.com/watch?v=_ZHWzBWe1e0

chucky-whiskers, 2022-08-06:
This problem is still not solved. I want a lua script capable of doing this programming on a RadioMaster TX16S (or any open-source, multi-protocol radio). Maybe this isn't the right place to suggest this, but I think it is within the realms of possible.

pitts-mo, 2022-08-07:
@pascallanger can this issue be re-opened, Should I attempt to enhance my understanding and start a new issue to build a LUA for this OR can you provide a better suggestion?
Thank you, -p

chucky-whiskers, 2022-08-07:
From what I have seen, the DSM protocol in both OpenTX and EdgeTX for the TX16S do not operate stick telemetry correctly. For instance when using stick inputs to access receiver programming functions the same way you would using a DSM transmitter, the receiver/onboard equipment does not respond. Spektrum stick "command functions" are somehow issuing a different signal than stick "inputs" used for controlling the craft, or the open-source software is sending different types of signals or something. The serial code sent to the receiver may have different priority levels per channel or something. Anyway, the TX16S will not do these setup functions on the Spektrum gear with the current programming. If that means updating the firmware for the 4-in-1 module, that could be a fix. A lua script is another possibility to address the issue. I know the problem and the function of the fixes, but I do not write code much. I'd feel more confident pushing this to someone with more experience.

chucky-whiskers, 2022-08-07:
Actually, it is a telemetry issue that probably requires a lua script either way.

pascallanger, 2022-08-08:
Without the hardware there is little I can do.
Can you ship a RX/model?

chucky-whiskers, 2022-08-08:
I cannot at this point in time.

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

pitts-mo, 2022-08-09:
I am checking with my friend and will try to talk him into sending gear.
-p

The cheapest Avian ESC and smart compatible receiver appears to be:
Avian 15 amp ESC: https://www.spektrumrc.com/Products/Default.aspx?ProdID=SPMXAE1015
AR410: https://spektrumrc.com/Products/Default.aspx?ProdId=SPMAR410#prod_section_support

pascallanger, 2022-08-09:
Ship or a donation to purchase the hardware. I think I have a receiver that should work but I'm in vacation and cannot check. I'll check how much such esc cost in France.

pitts-mo, 2022-09-04:
Hello @pascallanger,
Have you returned from your vacation? Do have time to evaluate the hardware you would need to attempt a build of lua replacement for Spektrum's "Avian Prog"?

The friend I am inquiring for has indicated he is willing to ship/pay for an ESC.

Although, I am just now realizing the Spektrum smart RX and a Spektrum TX may also be needed in order to see what their "Avian Prog" does to work through RX and configure the Avian ESC.

-p

frankiearzu, 2023-01-20:
Im starting to understand the internals of how the Telemetry based screens works (TextGen).
Have been able to do some experimentations with the Blade Heli AR636 to help on the configuration.

How TextGen works:
You enter the menu using a comvination of stick and switch movements.
Each menu line is respresented by a telemetry sensor. So if you have a menu with 5 lines, it will come from 5 sensors.
Another telemetry sensor has the # of the active menu option so that it can be highlighted.
The menu line sensor holds the the current value/option (a message ID/number). That ID/Number needs to be translated to English.

Once i get my hands on an Avian Receiver, i think i could get the code done fairly quickly.

Frankie

BuddhaSource, 2023-04-06:
@pascallanger hope you found the hardware needed to test it.
I would love to see ESC reversal capabilities.

frankiearzu, 2023-04-06:
@BuddhaSource   The AVIAN ESCs uses TextGen to configure via the TX.
The problem is that the current EdgeTx firmware was not processing this TextGen messages correctly, but i did the fix. it will be available in Edge 2.9.0.
For the ones who cannot wait, i created some firmware build who has the official EdgeTX 2.8.0 + some Spektrum telemetry fixes (TextGen, GPS sensor, ESC data) here:   https://github.com/frankiearzu/DSMTools
Has firmware for RadioMaster TX16, Zorro.   What Radio are you using.
After the firmware is installed. use the new Telemetry scripts to access TextGen. (DSM_Smart_Tel.lua)

frankiearzu, 2023-04-06:
Here is a video configuring the AVIAN ESC from a RadioMaster TX16
https://www.youtube.com/watch?v=yrAqV4b9Li4

BuddhaSource, 2023-04-06:
Excellent, thank you @frankiearzu
I have both Tx16s and Zorro both. I will try this on TX16.

frankiearzu, 2023-05-02:
UPDATE: TextGen Support included in EdgeTX 2.8.3.  No need for custom firmware any more.

BuddhaSource, 2023-06-02:
I confirmed it worked. Thank you for supporting it.

frankiearzu, 2023-10-30:
@pascallanger this can be closed.   the TextGen is part of the DSM_Smart_RX.lua

Closed 2023-10-30.

Thread 678 (2022-04-13):

Endpoints and channel order behave strange.

Kenaiwolf, 2022-04-13:
Hi,
iRangeX IRX4+ TX
Multiplex Cockpit SX
Using PPM mode
protocol Futaba/SFHSS
Fine tuning done

Bind with Eachine E180 heli. Problem is mainly throttle. TX is -100 +100 version. Moving throttle from -100 to -28 nothing moves. Once it hits -27 I get full throttle response. At least it looks like that by sound and looks. (no blades mounted, heli on the table situation)
Moving throttle from -27 up is no change at a glance.
I'm sure channels are mapped correctly (triple checked) Roll, Pitch axis, Collective pitch, Tail, Gyro, they all work properly Endpoints are probably not correct and center position may be wrong too.
I suspect endpoint seting of transmitter is to blame here. But I can't figure out what are endpoints of Cockpit SX in microseconds . Right now they are set as /Multiplex MC2020 (1250<->1950 microseconds)

24 hours later.
Did some more testing and find some strange things, at least for me.
Managed to test endpoints by experimentation and finish on strange
#if defined(TX_CUSTOM)
#define PPM_MAX_100 3000 // 100%
#define PPM_MIN_100 0 // 100%
#endif
In this setting aileron, elevator have correct range of movement and midstick is OK too. End of stick movement is in sync with end of servo movement. However throttle stopped working completely. Reversed throttle tested, no change noticed.
Even more strange is swapping channel order seems to not working.  I was treeing to set correct channel order to get throttle function, whole day. In some point i found out some channel orders hes same results as other.  Finally I swapped what was working CH1 Ai, CH2 El, CH3 rudder from 0x12345678 to 0x31245678 and i get:
EL on CH3
AI on CH2
CH1 seemed to not doing anything. (can't test rudder without throttle - tail motor heli)
So i get 0x23?45678
If I understated how it works, I should have gotten Ai on CH3, El on CH1 and rudder on CH2

I belie there must be some overlap in channels reading, because of wrong endpoints setting. 2 channels on outputs controls by 1 PMM CH on impute or something like that. The only second explanation will be channel order settings are buggy.
I'm starting to feel desperate.

pascallanger, 2022-04-13:
I don't know the E180 heli but you might have like on most helis of that size a channel for 6G/3D and may be other stuff. It looks to me that your throtle issue is linked to one of these additional channels are not set correctly.
Setting MAX to 3000 and MIN to 0 is decreasing a lot the end value which will be used. So that should explain why throttle doesn't work anymore since you can't get to -100% and init the ESC.

Do you have a Multiplex RX? If yes what you can do is to bind this RX with the Cockpit SX normally, connect servos on the outputs, make sure that the endpoints of the radio are set to normal, and draw the mid, max and min positions for Ail, Thr, Ele, Rud and also on which order they are on the RX.  Then bind the same RX, same servos to multi using the MLink protocol. Now, you need to change PPM_MAX and MIN to get the exact same ouputs (mid, max, min), also check the channel order. From there you should have the channel order of the radio, and the MIN, MAX endpoints pretty closed. Change to the SFHSS protocol, reassign the channels accordingly and give it a go.

Kenaiwolf, 2022-04-13:
Thank you for reply.
E180  expects channels:
1: Aileron
2: Elevator
3: Throttle
4: Rudder
5:  switching 3D and 6G modes
6:  Collective pitch
7: Aux 1 don't care
8: Aux 2 don't care

In mean time I manged to get throttle on stick CH4 on my TX. So i redefine endpoints using throttle and digital tachometer (RPM meter). now i am on
#if defined(TX_CUSTOM)
	#define PPM_MAX_100	2062	//	100%
	#define PPM_MIN_100	938	//	100%
#endif
 -94 start spinning rotor +100 is max RPM
As long as i know E180 should not have any throttle range internal configuration. So hopefully I'm, spot on with endpoints.

My TX is AERT so i set it like that. It have fix CH order in Heli mode. It is like this:
CH1 Aileron
CH2 Elevator
CH3 Rudder
CH4 Colective PITCH
CH5 Throttle
CH6 Gyro
CH7 AUX1
CH8 N/A it is 7 channel TX

channel order 0x**0000000** gives me CH1=Ai, CH2=El, CH3=Ru, **CH4=Throttle**  CH5=Gyro CH6=Pitch CH7=free CH8=N/A
I change channel order to 0x00054000 it worked i got CH1=Ai, CH2=El, CH3=Ru, **CH4=Gyro**  CH5=Throttle CH6=Pitch  CH7=free CH8=N/A
Finally i wanted to swap CH4 and CH6 so I set 0x00056400 and all hell break loose.
I got CH1=Ai, CH2=El, CH3=Ru, **CH4=Gyro**  **CH5=Pitch**  **CH6=Throttle**  CH7=free CH8=N/A
What am I doing wrong ?

Yes, I have Multiplex RX in my Extra 330 but it is 35Mhz RX as is my TX. It work perfectly for years now. But it can't be connected to computer or anything else  except 35Hz TX or by cable to PPM signal directly. :-( I know my equipment is little outdated, but so am I. And i hate to trow away what is not broken.

Kenaiwolf, 2022-04-13:
Ooh, I found my mistake it should be 00064500. Eureka it  is working all now.

Closed 2022-04-13.

Thread 704 (2022-07-08):

FEI XIONG FX620 Protocol

gke, 2022-07-08:
I managed to get the debug version running and these are three logs I managed to drop from my Fei Xiong SU35 FX620 . I am not having a lot of luck with matching things up with the FX816_nrf24l01.ino fields. I also get what seems to be a few different different hopping sequences. The packet payload trace shows the throttle and aileron data moving. Hints on how to proceed appreciated or even better someone with the skills to help out.

Thanks
Greg

[FX620 1.zip](https://github.com/pascallanger/DIY-Multiprotocol-TX-Module/files/9075211/FX620.1.zip)
[FX620 2.zip](https://github.com/pascallanger/DIY-Multiprotocol-TX-Module/files/9075212/FX620.2.zip)
[FX620 3.zip](https://github.com/pascallanger/DIY-Multiprotocol-TX-Module/files/9075213/FX620.3.zip)
.

pascallanger, 2022-07-08:
I need 3 more dumps before trying to understand something:
 - bind: leave the TX in bind mode and do an auto search
 - normal: move only throttle really slowly from low to high to low. Stop and save the log calling it THR.log
 - normal: move only aileron really slowly from center to left to center to right to center. Stop and save the log calling it AIL.log
Pascal

pascallanger, 2022-07-08:
**Bind**
Unknown until I have the bind dump requested above

**Normal**
Bitrate: 1M
Scrambled: Y
Address: FE F8 34 A9 32
Payload: 5 bytes
0|1|2|3|4
-|-|-|-|-
THR/AIL|00|00|AB|Check

THR/AIL: unknown until I have the 2 normal dumps requested above
Check= sum of payload[0..4]+0x9E

Different hopping sequences: relaunch the dump at different distances/orientations between the multi module and the FX620 TX. Right now you are catching ghost frequencies...
Channel 8 for example does not seem to be valid. So if you have dumps not showing it you might be at the right spot.

gke, 2022-07-09:
Thanks Pascal. I think I have stable hopping at 24,34,44,54 and binding at 18? The throttle is definitely on Ch0 and the Aileron is Ch4. Changes to Ch4 are not logged unless Ch0 is changing. The F35 is differential thrust so there is mixer coupling between Throttle and Aileron. Not sure what Ch3 is but it does not change so perhaps some sort of switching. Log files attached along with my first cut on the code.
[FX620.zip](https://github.com/pascallanger/DIY-Multiprotocol-TX-Module/files/9075809/FX620.zip)
[FX620_nrf24l01.zip](https://github.com/pascallanger/DIY-Multiprotocol-TX-Module/files/9075813/FX620_nrf24l01.zip)
?

gke, 2022-07-09:
Please ignore last mail. I will spend a little more time checking the log files to see what is happening to the Aileron values as I just re-read your post and saw that I am seeing the CRC on Ch4 changing not an Aileron value.

pascallanger, 2022-07-09:
Sorry but I don't understand what you say... What do you mean by CH0 and CH4? Are you talking about the payload bytes 0 and 4. If that's the case then B0 changes on your dumps when you move throttle and B4 is a check (calculation given above) to see if the content received is correct. What you call Ch3 is the byte 3 I suppose which I agree is constant on all your dumps = 0xAB.

What I think is that the address length is wrong. Try to redo the dumps with an address length of 4 and even 3. An address length of 3 would give a bind address of AA BB CC which looks not bad. I think then you'll see the aileron value appearing on the first or second byte.

pascallanger, 2022-07-09:
More I look at it more I think that the address length is 3.
Bind address: AA BB CC
I anticipate that the bind payload will be 34 A9 32 18 00 00 27 -> Check=B6=27 is the sum of bytes 0..5 which is usual
Normal address: 34 A9 32
I'm not going to guess the payload, but I'll say that B6=Check will be the sum of bytes 0..5 too.

pascallanger, 2022-07-09:
For the implementation, I'll add a subprotocol to the current FX(816) protocol => Protocol FX, subprotocol 0=816 and subprotocol 1=620.
I'll take care of this as soon as I have the correct dumps to work on.

pascallanger, 2022-07-09:
Please read all my posts from the beginning since I'm updating them as I go. Like this you have a full picture.

gke, 2022-07-09:
Thanks Pascal. I will get the dumps done today but some flying first.

pascallanger, 2022-07-10:
I've written the protocol with your ID for now.
Are you able to test quickly? If yes I can publish it, you do the test and report, I do some modifications and you test again. We will need like this a couple of iterations to understand if Aileron could be a proportional value or not and to hopefully have a couple of working IDs instead of just yours. As you understand we need to be online together to try and test without loosing too much time.

gke, 2022-07-10:
Good Morning Pascal.

I agree we should make B1 (Aileron) linear and B2 (Throttle) max at 63, With the Tx as delivered the bang/bang aileron control makes it strange to fly - very jerky.

It is interesting that there seems to be no protocol consistency even within one company for its different products, Just having a single protocol and only change an ID field only or just use the Tx module ID for binding the different aircraft - too logical ;). BTW John Julian JJ604 is a good friend.

gke, 2022-07-10:
Yes I can test - where do I grab the code from?

gke, 2022-07-10:
I think it is mid day for you now. Tell what time is best for you to do the testing.

gke, 2022-07-11:
I am back home.

pascallanger, 2022-07-11:
The code is available on Master.

gke, 2022-07-11:
Thanks Pascal

Binding not working yet so I used the original Tx to bind. Throttle not working initially but is now after a change. I am trying not to make changes that stop the 816 variant working  but I can borrow a P38 that uses 816 to check. I tried the ailerons with proportional bu the Rx is using bang/bang.  I will have more of a play tomorrow and get back to you. Good progress.

pascallanger, 2022-07-11:
For the bind, I don't really see what could be the issue. The only thing is the packet period of bind is 4500µs and the packet period of normal is 3250µs. But usually they don't check that, the RX receives one bind packet and it is good with it. May be it's not the case here, we can try to update the timing while binding.
What change have you made to the throttle to make it work? I'm surprised that you need something different...

gke, 2022-07-12:
Hi Pascal

I am recovering from COVID and have a little brain fog so I cannot see what the binding issue is either. The aircraft binds immediately with the original Tx. Once bound it responds fine with the MM code. It will be simple I am sure and probably is no processing of any ack from the aircraft just a simple binding packet count I saw the longer period for the binding and had extended that to 4500uS.

You will barely recognise the current code as I have a habit of rewriting to get an understanding of what is happening :(.
[FX_nrf24l01.zip](https://github.com/pascallanger/DIY-Multiprotocol-TX-Module/files/9089372/FX_nrf24l01.zip)

pascallanger, 2022-07-12:
Can you try the latest code on Master?

gke, 2022-07-12:
Still not binding. Everything else OK if I bind with original Tx. I am going to re-run the bind dump tomorrow.

pascallanger, 2022-07-12:
If it's like other small remotes when you turn it on it will send bind packets. But it can also send different bind packets when you move the throttle up and down to finish the bind process. So make sure to run a scan at each step of the process: turn on, throttle up, throttle down.

pascallanger, 2022-07-12:
"Setting it to 1mB results in no packets being logged." This is normal, when you force the bitrate you are exiting the "Auto search" feature. You therefore need to select manually the RF channel to find out what you are looking for.

Let's see what the bind dump will give. I can't find what's wrong with the bind since I'm doing exactly what is in your dumps...

gke, 2022-07-13:
I have two MP modules and have now set one up for dump monitoring and the other for testing the code. The dumps from MP look the same as those for the original Tx. It still does not bind but otherwise remains OK. I have tested a P38 which uses 816 and it binds fine. The rebinds in the MP menu trigger a rebind as well. I have not checked aileron and throttle fully yet for 816 bit it should remain OK.

I am going to take a break to get some other things done and recover fully from COVID but now I have the test it will be easier to check things out.

Cheers
Greg

pascallanger, 2022-07-13:
While the TX is in bind mode, have you scanned all the frequencies using a bitrate of 1Mb?

gke, 2022-07-13:
No I have not it seems we have just been capturing the final packets in the bind sequence.  Carefully timing when I start the bind shows a start frequency as low as 8 in one log with  x78 in the last byte of the packet but this could still be ghosting.  The other log also shows the x78 value being transmitted in the expected bind channel.

[20220714 Bind Ghosting.zip](https://github.com/pascallanger/DIY-Multiprotocol-TX-Module/files/9106558/20220714.Bind.Ghosting.zip)

gke, 2022-07-13:
OK this seems to bind happily. Still not sure how an ID is used  but is may be the LSBs of the last address byte.
[FX_nrf24l01.zip](https://github.com/pascallanger/DIY-Multiprotocol-TX-Module/files/9106608/FX_nrf24l01.zip)

gke, 2022-07-14:
I will get the full dump after flying this morning.  The bind_counter counts down so I am emitting 0x78 first then 0x00. One of the previous dumps suggests that multiple frequencies are being used but the other shows only 20. I suspect ghosting but the dump today at 1mB should show us.

gke, 2022-07-15:
OK I am using the NRF dump and forcing the address length to 3. The frequency channel is stuck on the default of 40. What do I need to do to get the dump? Does it involve me editing the dump code and if so what do I need to do to compile the debug version. Sorry for being a little slow ;).

Flying today was OK with 620 and 816.

gke, 2022-07-15:
Binds OK and controls working. I am happy for the issue to be closed.

pascallanger, 2022-07-15:
Before closing, can you try with different ex numbers to see if it works fine?

gke, 2022-07-16:
OK will do ASAP

pascallanger, 2022-07-16:
That's kind of strange. When changing the RX number the protocol is restarted with a different ID, starting with a bind then normal. The plane should loose connectivity and not recover unless you rebind it...
When you say up to 14, does it mean that after 14 it does not work anymore?

gke, 2022-07-16:
I am sure I commented the define out unless there are two defines.  I will recheck again tomorrow morning. The bind process when triggered is really quick . So if as you say "the protocol is restarted with a different ID, starting with a bind then normal" does that mean a rebind is being forced each time the RX number changes?

I ran RX number up from 0 to 14 and ran out of time at that point. Wedding Anniversary Dinner took precedence ;).

gke, 2022-07-16:
OK. Test again this morning. The define was commented out. Changing the channel number the bound light is still lit on the aircraft  (of course) but no longer acting on controls - duh. Power cycle aircraft and rebind and control is restored. I cycled up through 1..5 of the Rx numbers than tried higher numbers e.g. 32. Attached is the file as tested and this time with the define out completely.

[FX_nrf24l01.zip](https://github.com/pascallanger/DIY-Multiprotocol-TX-Module/files/9126539/FX_nrf24l01.zip)
.

pascallanger, 2022-07-17:
Ok so we are good. Closing this thread.

gke, 2022-07-17:
Thanks Pascal
Greg

Closed 2022-07-17.

Thread 718 (2022-07-30):

Hardware compatibility CC2500

atharvbadkas, 2022-07-30:
Hello
Please anyone let me know about the compatibility of this Rx with project...I couldnt find original CC2500 Module so this is my option.
Link https://www.dnatechindia.com/CC2500-RF-Transreceiver-Module.html

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

Thanks in advance

pascallanger, 2022-07-30:
Nothing to do with this project...

atharvbadkas, 2022-07-30:
Well I want to connect my Flysky Tx with Receiver: 8CH Frsky protocol SBUS output D8 Mode

I already built Multiprotocol module with NRF for Bayang protocol
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

I want to add CC2500 module for frsky protocol
I couldn't found "banggood CC2500 Module" which is recommanded but I was able to found this module.
 Please help

pascallanger, 2022-07-30:
What about this one: https://m.fr.aliexpress.com/item/32945151938.html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,scm-url:1007.40000.267768.0,pvid:a8e25a6c-f6d0-430c-b56f-84abbb9b2588,tpp_buckets:668%232846%238111%23498&pdp_npi=2%40dis%21EUR%21%217.8%21%21%21%21%21%40211b5e1e16591799742016296eadde%2166253260547%21rec

pascallanger, 2022-07-30:
It has a PA which is important for range. There are plenty on AliExpress.

atharvbadkas, 2022-07-30:
Banggood and aliexpress shipments are banned in India....so I cant order from it...
I only needed it for indoor use, so low range will not matter.
It has standard UART interface.
What do you think?

pascallanger, 2022-07-30:
Remove and use the small RF board. This is the only thing you need on your link.

atharvbadkas, 2022-07-30:
Okay..thanks
Can you share pin connection diagram with STM/Arduino ?

pascallanger, 2022-07-30:
Arduino: https://github.com/pascallanger/DIY-Multiprotocol-TX-Module/blob/master/PCB%20v2.3d/Schematic_v2.3d.jpg
STM: https://github.com/pascallanger/DIY-Multiprotocol-TX-Module/blob/master/STM32%20PCB/Schematic_Multiprotocol_STM32_MB_v1.0_t.jpg

atharvbadkas, 2022-07-31:
Thanks👍🏼

atharvbadkas, 2022-08-04:
Hi
I did remove the RF board. Replaced the NRF with CC2500 RF board...made proper connections of MISO MOSI SCK and CSN.

Previous NRF protocol circuit
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

Made changes in config.h file(selected only frskyD protocol) and pin.h file(I had to change PPM MISO MOSI CSN Pins so it can match previous circuit).Code compiled successfully so Uploaded the code in Arduino Nano.
But its not binding with the quad.(tried AUTOBIND and later Channelbind also)

FC :BEECORE FRSKY F3_EVO_Brushed ACRO Flight Control Board
RX:8CH Frsky protocol SBUS output D8 Mode

Is there anything I'm missing here?

atharvbadkas, 2022-08-04:
Pins I changed in pins.h
PPM D2
CSN A1
MISO A0
MOSI D3
SCK D4

pascallanger, 2022-08-04:
What voltage are you applying on the arduino board?
I'm asking since the NRF24L01 has its pins 5V compatible so you can plug it to a 3.3V or a 5V micro controller it will work just fine. But that's not the case of the cc2500, it only accepts 3.3V on its pins. If you have used it with 5V then I'm afraid that you've burnt it...

atharvbadkas, 2022-08-05:
Yeah I have placed 3.3v regulator for RF board.

atharvbadkas, 2022-08-05:
Is there anyway to know on serial monitor, whats going on? As troubleshooter

pascallanger, 2022-08-05:
> Yeah I have placed 3.3v regulator for RF board.

I tried to explain you that a 3.3v regulator for the RF board is not enough. All the signals reaching the CC2500 must be 3.3V

atharvbadkas, 2022-08-05:
Ohh snap...I didnt looked into datasheet and assumed it will work...will add level shifter and new RF board

schwabe, 2022-08-05:
Or run the Arduino at 3,3V

pascallanger, 2022-08-05:
As Arne said, this is what we do on the schematic I've shared with you.

atharvbadkas, 2022-08-07:
Hello,
I have ordered new RF board with logic level converter.
In the mean time can you check my Config.h if there's anything wrongly configured?

FC : BEECORE FRSKY F3_EVO_Brushed ACRO Flight Control Board
RX: 8CH Frsky protocol SBUS output D8 Mode

Which sub protocol to select from FRSKYD, DCLONE for this Rx ? or PPM_SBUS ?

config-
`
//#define USE_MY_CONFIG
//#define CHECK_FOR_BOOTLOADER
#define AETR
#define ENABLE_BIND_CH
//Set the channel number used for bind. Default is 16.
#define BIND_CH	5
#define WAIT_FOR_BIND
#define CC2500_INSTALLED
//#define CC2500_ENABLE_LOW_POWER
#define	FRSKYD_CC2500_INO
#define ENABLE_PPM
#define MIN_PPM_CHANNELS 4
#define MAX_PPM_CHANNELS 8
#define NBR_BANKS 1
const PPM_Parameters PPM_prot[14*NBR_BANKS]=	{
#if NBR_BANKS > 0
//******************************       BANK 1       ******************************
//	Switch	Protocol 		Sub protocol	RX_Num	Power		Auto Bind		Option	Chan Order
/*	1	*/	{PROTO_FLYSKY,	Flysky		,	0	,	P_HIGH	,	NO_AUTOBIND	,	0	,	0x00000000 },
/*	2	*/	{PROTO_AFHDS2A,	PWM_IBUS	,	0	,	P_HIGH	,	NO_AUTOBIND	,	0	,	0x00000000 },	// RX number 0
/*	3	*/	{PROTO_AFHDS2A,	PWM_IBUS	,	1	,	P_HIGH	,	NO_AUTOBIND	,	0	,	0x00000000 },	// RX number 1
/*	4	*/	{PROTO_AFHDS2A,	PWM_IBUS	,	2	,	P_HIGH	,	NO_AUTOBIND	,	0	,	0x00000000 },	// RX number 2
/*	5	*/	{PROTO_AFHDS2A,	PWM_IBUS	,	3	,	P_HIGH	,	NO_AUTOBIND	,	0	,	0x00000000 },	// RX number 3
/*	6	*/	{PROTO_AFHDS2A,	PWM_IBUS	,	2	,	P_HIGH	,	NO_AUTOBIND	,	0	,	0x00000000 },	// RX number 4
/*	7	*/	{PROTO_AFHDS2A,	PWM_IBUS	,	3	,	P_HIGH	,	NO_AUTOBIND	,	0	,	0x00000000 },	// RX number 5
/*	8	*/	{PROTO_FUTABA,	NONE		,	0	,	P_HIGH	,	NO_AUTOBIND	,	0	,	0x00000000 },	// option=fine freq tuning
/*	9	*/	{PROTO_FRSKYV,	NONE		,	0	,	P_HIGH	,	NO_AUTOBIND	,	40	,	0x00000000 },	// option=fine freq tuning
/*	10	*/	{PROTO_FRSKYD,	PPM_SBUS		,	0	,	P_HIGH	,	AUTOBIND	,	40	,	0x00000000 },	// option=fine freq tuning
/*	11	*/	{PROTO_FRSKYX,	CH_16		,	0	,	P_HIGH	,	NO_AUTOBIND	,	40	,	0x00000000 },	// option=fine freq tuning
/*	12	*/	{PROTO_FRSKYX,	EU_16		,	0	,	P_HIGH	,	NO_AUTOBIND	,	40	,	0x00000000 },	// option=fine freq tuning
/*	13	*/	{PROTO_DEVO	,	NONE		,	0	,	P_HIGH	,	NO_AUTOBIND	,	0	,	0x00000000 },
/*	14	*/	{PROTO_WK2x01,	WK2801		,	0	,	P_HIGH	,	NO_AUTOBIND	,	0	,	0x00000000 },
#endif
`
Thanks

Closed 2022-07-30.

Thread 761 (2022-11-20):

1.3.3.20 loss of connections with V2 frsky receivers?

Luznatural, 2022-11-20:
Since I have upgraded the internal 4 in 1 module of my Radiomaster Tx16S Mk1 to firmware 1.3.3.20 (EdgeTX 2.7.1 firmware in the radio) I have experienced two catastrophic mishaps in glow planes that were fully reliable before.
Both planes were flying stable and straight ahead when suddenly started uncommanded movement without me being able to perform any input until the crash. Once recovered the remainings, the receivers, batteries or servos didn't show any damage and behaved correctly.
Fine tuning had been performed in both planes, and no RCCS warning nor low voltage of the battery was announced by the radio at the moment of the issue.
I discarded interference, as we were flying only 3 people in the field, and our club is well separated from any interference source.
Initially, I guessed there might be a problem with Edgetx firmware, so I downgraded it to the previous firmware, but the issue repeated with another plane. This time I was lucky as the plane simply lost command but remained straight ahead in a shallow dive, touching the ground very softly (only the landing gear affected).
Since then, I have performed several tests in the ground with different receivers and servos, and from time to time the phenomenon repeats without performing any special or remarkable command. Simply, it happens. I mean, I do not perform any brusque movement nor move the servos extremely, the battery is not going down on voltage, etc. You just have to wait with the radio on, and suddenly one or various servo move by themselves.
It,s like the receivers loosing connection with the radio (red light in the receiver for 1 to 3 seconds, again without any RCCS low or critical warning, nor low battery warning).
All the receivers I use are with the latest Frsky V2 FCC firmware (X8R) since 2021.
I downgraded my 4 in 1 module to the previous firmware, and I was unable to repeat the problem, so at this moment and with many doubts in mind, I think it is better to report it to you, just in case.
I have seen some similar reports on EdgetX issues, but in my experience (and apparently) the problem is not related to it.
You are doing a great job. I HOPE I am wrong!

benlye, 2022-11-20:
I've got a TX16S running EdgeTX 2.71 and a MULTI-Module running the released v1.3.3.20 build, with the module bound to an X8R running EU firmware v2.1.  I've set a failsafe on the RX and am running a servo sweep test on the TX to constantly move the servo.  If/when there is a glitch I'd expect the servo to stop moving and/or jump to its failsafe position, both of which I should hear/see.

I've run the test continuously for over 20 minutes and have not observed any glitches - no loss of servo control and no loss of signal shown by the RX LED.  How long does it take for you to observe the loss of signal / loss of control on your RX?

Luznatural, 2022-11-20:
Good afternoon benlye,
Thank you so much for your response.
My apologies to answer so late.
In my tests, sometimes takes 5 minutes to have the problem, but some others you stay for one hour and you don't get any error. Mi failsafe is set to "hold". I do not know if that,s a factor for the problem.
Today, in my club the same happened to a friend also with TX16S Mk1 ETX 2.7.1, the firmware of the module 1.3.3.20 and X8R with firmware 2.1.0 v2, with a gas plane that was separated only 300 meters. But this time the radio voiced "telemetry lost" before loosing control.
I believe it's a random occurrence. But I am afraid it happens
Again, I hope I am wrong!!!

pascallanger, 2022-11-20:
Which fw version are you going back to ?

Luznatural, 2022-11-20:
Good afternoon Pascallanger. I go back to 1.3.3.9

Obtener Outlook para Android<https://aka.ms/AAb9ysg>
________________________________
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

pascallanger, 2022-11-20:
1.3.3.9 is not a release... Have you compiled it yourself ?

Luznatural, 2022-11-20:
My apologies, I went to the radio to check. It,s 1.3.3.7.
I didn't compile it.

Obtener Outlook para Android<https://aka.ms/AAb9ysg>
________________________________
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

Luznatural, 2022-11-20:
Yesterday, I read in the list of new issues for ETX someone telling something smililar but mentioning it was caused by ETX 2.7.1.
I do not know if it's related or not.
But now I cannot find there that issue...

benlye, 2022-11-20:
@pascallanger should we create a 1.3.3.20 test build using the old compiler?

I still haven't been able to reproduce the issue.

pascallanger, 2022-11-20:
@benlye Yes let's try to rule it out.
I'm not able to reproduce it as well using a S6R but I'm still on opentx.

benlye, 2022-11-20:
@Luznatural can you try to reproduce the issue with each of the firmware builds in this zip file, please?  They are both from the v1.3.3.20 release code but are created with different compilers.

In your radio they will both show up as v1.3.3.20 so you will need to keep track of which one you flash and test.

[multi-stm-1.3.3.20.zip](https://github.com/pascallanger/DIY-Multiprotocol-TX-Module/files/10050665/multi-stm-1.3.3.20.zip)

Luznatural, 2022-11-20:
I will do that tomorrow morning. I am out of home now. Do not worry. I will Keep track and report back

Obtener Outlook para Android<https://aka.ms/AAb9ysg>
________________________________
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

Luznatural, 2022-11-22:
Good morning to all,

I have been doing extensive tests with the three firmwares that you sent me, using the same receiver installed in one plne without wings to be able to see the receiver, reduced power on and taking the radio to a distance of 50 meters, making a fine tuning, and watching RCCS. Special care taken to make sure which version of firmware was installed. All firmware updates to the internal 4 in 1 module were made from the SD firmware folder, using the radiomaster TX16S Mk1.

Firmwares:

  *   1.3.3.20 Released, I will call it released
  *   1.3.3.20a, I will call it a
  *   1.3.3.20b, I will call it b

Results:

  *   Fine tuning in all three firmware verion resulted in: released +4; a +5; b +4.
  *   I have been able to reproduce the failure in released 3 times in 2 hours of checking. The symptoms were green light of the receiver going off, total loss of signal during 4 to 5 seconds, then green light again. RCCS went to cero without any warning and back to normal after green light reappeared.
  *   Unable to reproduce the failure in releases a and b in two hours testing each, but detected from time to time a blinking for less than a secondin of the green light of the receiver, without loss of control and no RCCS warning, just a fluctuation of the RCCS from 82 to 72 and back.
  *   RCCS results using low power or normal power: released 83 and 89; a 78 and 82; b 78 and 82
  *   I had to repeat firmware update to released version, as rthe first time it caused a warning of firmware not loaded. wrong operation. Second intent was correct.

My initial conclusions are:

  *   Released version has normally a higher RCCS number than versions a and b; this is theorically better. Could the problem be a possible saturation of signal to the receiver due to the higher RCCS?
  *   Versions a and b are theoretically more stable than released, according to the results.

If you want me to do any further tests, I will do them.

I hope it helps....

-------- Mensaje original --------
De: Ben Lye ***@***.***>
Fecha: 20/11/22 21:52 (GMT+01:00)
Para: pascallanger/DIY-Multiprotocol-TX-Module ***@***.***>
Cc: Luznatural ***@***.***>, Mention ***@***.***>
Asunto: Re: [pascallanger/DIY-Multiprotocol-TX-Module] 1.3.3.20 loss of connections with V2 frsky receivers? (Issue #761)

@Luznatural<https://github.com/Luznatural> can you try to reproduce the issue with each of the firmware builds in this zip file, please? They are both from the v1.3.3.20 release code but are created with different compilers.

In your radio they will both show up as v1.3.3.20 so you will need to keep track of which one you flash and test.

multi-stm-1.3.3.20.zip<https://github.com/pascallanger/DIY-Multiprotocol-TX-Module/files/10050665/multi-stm-1.3.3.20.zip>

—
Reply to this email directly, view it on GitHub<https://github.com/pascallanger/DIY-Multiprotocol-TX-Module/issues/761#issuecomment-1321240168>, or unsubscribe<https://github.com/notifications/unsubscribe-auth/AKMIXZGETMDJJ47RGSZ3YS3WJKFRJANCNFSM6AAAAAASFUWQBU>.
You are receiving this because you were mentioned.Message ID: ***@***.***>

benlye, 2022-11-22:
If both the 'a' and 'b' firmware performed the same, then it seems like we can tentatively rule out the compiler change - if the compiler was the problem then I would have expected one of those firmware build to show the same behavior as the 'released' build.

I have a slightly more scientific test running on my bench since last night - I'm using an Arduino to capture the PPM output of my X8R receiver.  I'm, outputting the PPM values on all 8 channels to serial and capturing that data to a log file.  The radio is outputting servo sweeps with various timing on four channels, constant +/- 50% values on two channels, and 0% on two more channels.  My failsafe is set (via the TX) to set all channels to -100%.

I ran it for four hours this morning (EdgeTX 2.7.1 on the TX16, released FW v1.3.3.20 on the MULTI-Module, EU v2.1 FW on the RX) and did not have any detectable outages on any channel.  I'm running it again now and will let it run until the TX batteries go flat.

I'm not sure what else I can change to test.  I'm wondering if we should try to duplicate the module ID and RX number?

pascallanger, 2022-11-22:
@benlye what is the difference between a, b and release?
I would have thought that either a or b was the same as release. But it looks like only release is impacted so I'm a bit confused.
What about your X8R, is it running the exact same code as @Luznatural?
How do you identify a glitch in your test? Would it be any channel reaching -100%? I don't know how long the RX needs to go to failsafe, you most likely need a few secs without packets to reach this state. You might not want to do it but I think a good input to have would be to solder a wire to the X8R LED so you see in your log when the green LED goes off or red goes on (gnd being common only 1 wire is needed before the resistor).

Having the same ID and RX number would remove one more element but I would be surprised if it has an impact because I assume the tests on the 3 fws have been done using the same RX, same ID and same RX number, @Luznatural can you confirm?

benlye, 2022-11-22:
a = 1.3.3.20 code compiled in my environment with the old board/compiler
b = 1.3.3.20 code compiled in my environment with the new board/compiler
release = 1.3.3.20 code built in Git by the CI/CD process

My build environment is Ubuntu using the Arduino CLI, so should be the same as the Git build environment.  My X8R is running the latest v2 EU firmware, which is what  @Luznatural said they are running.

I would identify a glitch as any channel deviating measurably from the expected output.  I'm sampling the channels around 60Hz, so I think I should be able to see a 1-3sec outage. I've been parsing the output using a script as well as plotting it to analyze visually.  If I force a disconnect (e.g. by changing the RX Num on my model) the RX drops to the F/S values immediately.

The X8R is _supposed_ to output the RSSI as PWM on the RSSI pins, but I couldn't get a signal there (this seems to be 'normal').  I can open it up and see if I can solder a wire to the red LED.

benlye, 2022-11-22:
I now have an input coming from the green LED and I'm logging its state along with the PWM data.

I had to connect to the side of the LED which is connected to the STM3 (not the resistor side), and even then it was tricky - the pin is constantly cycling, so I had to de-bounce it and detect the state over a few cycles.  If it changes state I'm detecting and logging it within ~0.05s, so I think that's OK.

(If you watch it very closely you can actually see the green LED flicker every now and then with the naked eye. I verified that this also happens with older MULTI firmware, so I don't think it's a symptom.)

benlye, 2022-11-23:
My RX is running v2.1.0 LBT firmware, dated 2020-03-24 on the FrSky website.  The MD5 hash of the file is `F7350366F76F2AC6E0EF4AC4EDF8AA2D`.  It's the one that can still be downloaded from [their website](https://www.frsky-rc.com/x8r/).

@Luznatural can you confirm that this is the exact same firmware you are using on your X8R RX?

I'm happy to try changing the TX ID and RX.  At this point running the tests is very easy and I can leave it running in the background for any length of time.

Luznatural, 2022-11-23:
Just to reminded you, I am using FCC firmware...

Obtener Outlook para Android<https://aka.ms/AAb9ysg>
________________________________
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

benlye, 2022-11-23:
> Just to reminded you, I am using FCC firmware...

Ugh, I don't know why I had it in my head that you were using EU/LBT.  Setting up to test with that now...

pascallanger, 2022-11-23:
Let's see... FCC or lbt are pretty much the same...
@Luznatural can you share your ID using the multi config lua script and your RX number?

benlye, 2022-11-23:
My test is running again. I flashed the RX using `X8R_ACCST_2.1.0_FCC.frk` with MD5 hash `174DC4E071917E93802C622A9C7ADB881`.

If you can let me know your TX ID and RX num I can test those on my radio.  You can get the TX ID using the MultiConfig script in the Tools menu.  It is the 'Global ID' value.

benlye, 2022-11-24:
I ran the test with FCC firmware on the X8R for 12hrs - no glitches.

pascallanger, 2022-11-24:
12 hours wow. I would have expected that result since like I said FCC and LBT are pretty much the same at least from a Multi perspective.

@Luznatural We can't reproduce the issue... Could it be your own setup?
-  X8R fw version, can you confirm that you are running the same as Ben
-  Could it be that you have a telemetry screen or a lua running in the background which could affect the radio behavior?
     - Try to create a blank model and just run your test
-  Your ID & RX num is affecting either multi or the RX (known issue on SxR, I haven't heard the issue on other models but who knows)
     - Give us your ID and RX num
-  Your plane setup:
     - onboard power issue?
     - one device like the ESC or servo creating interferences
     - ...
     - Try to do a setup on your bench using a trusted power source, receiver and a trusted servo

Luznatural, 2022-11-24:
Sorry for the delay. I was on workout trip out. My Tx ID is 65 57 FE 42
And the receiver Number is 17
Sorry again

Obtener Outlook para Android<https://aka.ms/AAb9ysg>
________________________________
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

Luznatural, 2022-11-24:
My X8R Firmware is FCC 2.1.0
The plane is a glow .46 Thunder Tiger engine. I do not have an ESC, and the servos are brand new futaba that run smoothly without extranjero noises.
I will do the tests again with brand new RX, servos and fresh battery, and report again.

Obtener Outlook para Android<https://aka.ms/AAb9ysg>
________________________________
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

Luznatural, 2022-11-24:
I have been doing a recap in the TX configuration, and I have the following:
Module firmware multimodule 1.3.3.20 AETR
External module OFF

VERSION
FW: 2.7.1 (a55aff02)
DATE:2022-05-30
TIME:23:15:22
CFGV: 221
OPTS: bluetooth, crossfire, ghost, afhds3, internalgps, internalmulti, internal access, multimodule, luac

Obtener Outlook para Android<https://aka.ms/AAb9ysg>
________________________________
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

benlye, 2022-11-25:
I ran the same test again today for several hours using the TX ID and RX number above - same result, no dropouts.

I can't easily get 50m between my TX and RX but I put ~10m and a few solid walls in the way and I had a steady 80db RSSI.  Every now and then my Arduino detects the RX LED going out but it's only for 1-2 frames, or about 15-30ms.  Not long enough to visually turn the green LED off, and certainly not long enough to turn the red LED on and trigger failsafe.

Every configuration I've tested behaves pretty much exactly the same and I can't find any evidence that anything is any different with v1.3.3.20.

Luznatural, 2022-11-25:
I have been repeating my humble tests yesterday, and this time I was unable to get a single failure.

Perhaps is a problemas of my área of flight rather than related to the software or firmware.

I think both of you have been very kind, patience with this issue, and invested a lot of time both three of us, to make sure that the system is safe.

On the other hand, I made a forensic inspection of my friend,s weekend crash, and he had several things to fix in his plane, like having a single lipo for both the gas engine and the receiver. So, the possibility of interference is exponential, especially with an X8R receiver. So I lectured him for raising the bells of alarm.

Then, we will have to let it go.

Thanks a lot for taking care of us and being so rigorous in your firmware deliveries.

If anything else arises I will let you know, and I hope you take me in account if you have to perform any future test, that I will gladly assume.

Thanks again

Best regards
Jaime

Obtener Outlook para Android<https://aka.ms/AAb9ysg>
________________________________
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

Closed 2023-10-30.

Thread 840 (2023-03-20):

Jumper 4in1-SE Module "Fail to init. device" in FlashMulti Verbose

CarryFlagMyth, 2023-03-20:
Hi,
Module inherited from a Jumper T12. Tried several things already to have it _at least_ read by Flash Multi: purchased a new micro USB cable, upgraded OpenTx radios' firmware (Taranis Q7 & Jumper T12). Green light when plugging USB & Device manager showing _Silabs CP210x USB to UART Bridge_ to port COM8. Major problem here is as described in title: _Read/Write_ buttons in Flash Multi software won't go past the first step. I have seen you reply once COM ports could be busied by programs running in the background; yet I don't see why, having not ran a configurator program for ages since I'm stuck with this one problem for now.
Am I missing something here? Thank you

benlye, 2023-03-21:
Can you post the output from FlashMulti?  Screenshots including the detailed log window.

CarryFlagMyth, 2023-03-21:
Yes, if you want
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

CarryFlagMyth, 2023-03-21:
Thanks for your reply. I've downloaded zip file afresh and ended with a FlashMulti 0.6.1 folder with 24 files, 4 folders. Is this what it's supposed to be? Also, I was prompted I was launching a program that couldn't be checked by Windows SmartScreen. Could program's subroutines have been hindered at a point?
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

benlye, 2023-03-21:
You just need to make sure you extract all the files that are in the archive, which should include a small folder structure. 24 files in 4 folders looks about right.  It should look like this:

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

Importantly, you should have stm32flash.exe in the tools folder. Depending on your system, you may have to right-click on stm32flash.exe and check 'Unblock' on the security tab.

CarryFlagMyth, 2023-03-21:
Mine folder is just the same, save for the config file, reading _flash-multi.exe.config_; and it hasn't a small gear icon.
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
Running FlashMulti once unblocked from Windows command line gives a likewise result, safe for the _stm32flash.exe does not exist_ argument:
_stm32flash 0.4

http://stm32flash.googlecode.com/

Interface serial_w32: 115200 8E1
Failed to init device._

benlye, 2023-03-21:
Can you try moving the flash-multi-0.6.1 folder somewhere that doesn't have accented characters in the path?  E.g., `C:\Temp\flash-multi-0.6.1`.

I think `téléchargements` might be causing the problem (as per https://github.com/benlye/flash-multi/issues/30)

CarryFlagMyth, 2023-03-21:
I've moved the Flash Multi folder to hard drive root C:\ but exact same things occur.

CarryFlagMyth, 2023-03-21:
Actually no my mistake; it now reads:

.\tools\stm32flash.exe -r "C:\Users\andre\AppData\Local\Temp\tmp7729.tmp" -S 0x8010000:32 -b 115200 COM8

stm32flash 0.4
Failed to init device.

http://stm32flash.googlecode.com/

Interface serial_w32: 115200 8E1

CarryFlagMyth, 2023-03-21:
And no longer stm32 doesn't exist - as windows popup error screen meant the same failure I wouldn't notice

benlye, 2023-03-22:
OK, now we're at least trying to talk to the module.  'Failed to init device' means that the flashing program couldn't find an STM32 to talk to on the given COM port.  This can be for many reasons, from a bad USB cable to a faulty MULTI-Module.  All I can suggest is trying different USB cables or ports, or even a different computer (if you can).

CarryFlagMyth, 2023-03-22:
I suppose USB cables I use cannot be blamed as one is brand new; and both are showing the Multi Protocol device as CPx210 etc. properly in Device Manager. As from another computer, I have just tried, stm32 file needs to be unlocked, and past this point, program did run but won't init. device.

CarryFlagMyth, 2023-03-22:
As for the module to be defective; at least not as far as its behavior once inserted inside the radio _turned on_ is concerned. Therefore, have we exhausted every known causes of update malfunctioning _via_ Flash Multi? Beside unreliable computer hardware, what could prevent this module from initializing, according to you?

benlye, 2023-03-22:
In order for the flashing tool to interact with the module, the module must be in 'BOOT0' mode.  This is achieved by connecting the BOOT0 pin on the MCU to VCC.  On the JP4in1 modules this should happen when the USB cable is plugged in.  We have seen at least one module failure where it did not.  There's a header available on the PCB where you can manually bridge VCC and BOOT0.

That said, the fact that your module has only the green LED lit when it's plugged in suggests that this is probably not the problem you have - if the module was in 'normal' mode the red LED would be active.

That leaves some other hardware issue - a bad CP2102 chip, a bent or broken data pin in the USB connector, a bad solder joint between the USB connector and the PCB, or a bad connection elsewhere.

The PCB in this module doesn't serial header pins so the options for flashing it via serial are limited.  I assume you've already tried flashing it from the radio, which is why you are trying to use the USB port?

One last thing to check - when using the USB port, the module should be removed from the radio, or if it's in the radio, the radio must be turned off.

CarryFlagMyth, 2023-03-22:
You're right, I first aimed at upgrading my module through the SD card. This is what puzzles me most since I've been trying out this Flash Multi software: the **[SYNC ERROR]** message when running *.bin file from SD card is reputed to be caused by no bootloader present, or more precisely, that Flash Multi was never used to flash the device at least once. In my case, "Flash Module Bootloader" in the _Advanced>Actions_ menu is never available. In Flash Multi Documentation Index:  _This menu item_ (as well as Reset Module to DFU Mode) _is only enabled when a MULTI-Module in USB Serial mode is attached, and the COM port corresponding to the module is selected_...
Is this not the case for my module? When are these menu items allowed? My guess is Jumper 4in1-SE modules are one of a kind, and that other modules with USB plugs are enabling to run these functions when connected. More to this, I have read there's a difference between 1st and last Gen. Jumper 4in1-SE modules. Isn't there an interplay between the series that could account for the malfunctioning we're struggling with?
As for the ultimate check you mention, a couple of days ago when I started working this out, I used a bad USB cable, and ever since, I have taken greater care to whether the module was radio off; otherwise device manager would rarely if ever recognize the device as a Virtual COM Port like it should. With the Jumper T12 cable and the one I bought last week-end, Flash Multi always gets a COM port no matter if the radio is lit. But now I know that's the way it ought to be, and am attempting to read and write considering this.

CarryFlagMyth, 2023-03-29:
I have tried other diverse methods, one being flashing firmware from SD, with a custom booloader allowing to run apps; it felt promising but didn't work either (See @LapinFou [Opent Tx Wiki](http://opentx-doc.fr/)). I didn't bridge Boot0 & VCC pins, for I gather it's the same than plugging USB on JP4in1 devices. I have read a post on Github of someone eventually having updated his module with success by running Flash Multi from other computers. I keep that in mind.
So one remaining method is using Arduino Ide, and I'm not too comfortable with the idea; although I did purchase a USB to serial adapter. It has an easy 3.3/5 volts switch, so here is not my concern. Am I to solder pin headers on the back of my module to proceed with this method? Could you hint me on how to set up the hardware?
I can do soldering if needed, and I do have tiny jumpers for bridging pin headers; as well as I also have male/female wire extenders matching pin headers. But I cannot figure out how much of soldering - _if any_ - is required. My guess is Boot0 & VCC pins might be needing it, as for the linking with the adapter, I was wondering if a wire extension with pin headers at its end could suffice instead of soldering some more.
Perhaps you'll dismiss most of this considering it is the likewise of what I have attempted so far; but I thought I'd ask ;)

benlye, 2023-03-30:
Unfortunately the JP4IN1 module does not expose headers or pads for the serial TX and RX connections on the PCB - you would need to solder TX and RX onto the (very small) pins of the STM32 or CP2102 chip directly, and use the BOOT0 and 3V3 header holes to bridge BOOT0.  TX and RX are PA9 and PA10 on the STM32.

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

CarryFlagMyth, 2023-03-31:
I won't solder on the processor's legs for sure - I know it's sometimes suggested for drones with missing UART. But I did solder pin headers onto the GND 3,3v Boot0 pins; yet I'm not sure I'm making an effective short between the two latter. Is the green light the only signal then? Shall I short when plugging USB then release? Lastly, I wonder if the five MPM's plugs that connect it with the transmitter cannot be used with USB/Serial adapter? I believe I have seen some of them labelled as Rx/Tx; and beside, since the module's presumably updatable _via_ the transmitter, that implies a serial link could work the same... This is profane speech, but it seems odd given MPMs haven't their Tx/Rx made available for connecting.

benlye, 2023-04-01:
Green LED only indicates that the module is in BOOT0 mode.  Unfortunately the RX/TX pins that connect to the radio are not the same ones that can be used to flash the module when it is in BOOT0 mode - they can only be used when the bootloader is running (and you don't have the bootloader on your module).

CarryFlagMyth, 2023-04-07:
I recently used a *.frk file, and when launching it from regular radio mode (not _bootloader_), it offers to either flash S.Port, Internal module or External module. Have you ever heard of a MP module that could be flashed in this fashion; or is this just the External RF files of the radio that are updated this way, regardless of whether an external module is involved in the process?

horjab, 2023-08-06:
Hi everyone.
I have the same problem.
Did someone find the solution please?
Thank you

pascallanger, 2023-08-06:
Which problem ? What are the LEDs showing up at boot ?

benlye, 2023-08-06:
@horjab no need to post twice. We can track your issue at https://github.com/benlye/flash-multi/issues/54.

horjab, 2023-08-06:
Here I found later the same issue I have, but no conclusion.

benlye, 2023-08-06:
We don't know if it's the same problem. You need to post the verbose logs. I don't care if we troubleshhot your problem here or on the Flash Multi repo, but we're only doing it in one place, so if you want to do it here then I'll close the other one.

horjab, 2023-08-06:
Thank you
We will continue here.
Please,  how I  post the verbose logs?

benlye, 2023-08-06:
Tick the 'Show verbose output' box, try to read or write the module again, and post the verbose logs.

horjab, 2023-08-06:
Is this box in the multiflash?

benlye, 2023-08-06:
> Is this box in the multiflash?

Yes

horjab, 2023-08-06:
bingo 👍 .\tools\stm32flash.exe -r "C:\Users\h.bucovanu\AppData\Local\Temp\tmp8177.tmp" -S 0x8010000:32 -b 115200 COM5

stm32flash 0.4
Failed to init device.

http://stm32flash.googlecode.com/

Interface serial_w32: 115200 8E1

benlye, 2023-08-06:
So now you need to try all the same things - different USB cables, different PC (if possible).  If none of that works then you probably also have a faulty module and unfortunately there's nothing further we can do.

horjab, 2023-08-06:
Waall ready done cables and 2 dells.
Will soldering to the processor with the FTDI witch  I all ready use for un internal module T16S work ?

benlye, 2023-08-06:
> Waall ready done cables and 2 dells. Will soldering to the processor with the FTDI witch I all ready use for un internal module T16S work ?

It's possible.  You need TX, RX, 3V3, and GND.  You can use the empty holes on the PCB to bridge BOOT0 to 3V3 to get the chip into flashing mode.

horjab, 2023-08-06:
OK ça marche. I will try it.
thank you for your support and readiness

pascallanger, 2023-08-06:
Have you tried to flash from the radio itself ?

horjab, 2023-08-06:
No because the version is 1.2.1.25 not even 1.2.1.51 my gues is that is  no bootloader inside
but I will try this also
Thank you

Closed 2023-10-30.

Thread 873 (2023-08-06):

No output on Flysky FS-A8S Receiver

bishko, 2023-08-06:
Hi Guys,

I'm having some trouble setting up the Flysky FS-A8S with my Radiomaster TX16S.

When selecting the FlySky2A protocol and the "PPM,SBUS" from the sub-menu, the receiver binds, but does not produce any SBUS output. As per the manual I have ensured that the receiver is in SBUS mode via the blinks. I have tired to output both 8 and 16 channels from the TX16S in all other sub-menu options, but it still does not seem to work. I have also tried to run the receiver in IBUS mode as well and to then bind to the TX16S and none of the option produce an output for some reason.

Could someone please let me know what I might be dowing wrong or just let me know what the correct way is to set this receiver up?

Thank you very much in advance! :)

geovinny1, 2023-08-22:
I have also observed a problem with Flysky and SBUS. My test as follows:
Radiomaster TX16S MkII, EdgeTx 2.7.1, Multimodule V1.3.3.20 AETR, Protocol FlSky2A PWM,SBUS
Flysky FS-iA6B receiver feeding into an Arduino for analysis.
The receiver outputs IBUS not SBUS in all cases (including other sub-protocols). I know that because I am decoding the output and it is IBUS. I removed all sensors (input telemetry) to ensure that wasn't confusing things. I rebound and cold booted.
In order to test MYSELF, I can decode a Frysky S8R receiver and it is SBUS. This originally cropped up because a commercial 16ch SBUS decoder as seen on aliexpress would not work with the FS-iA6B.

geovinny1, 2023-08-22:
I should also say it's not clear if the OP needs an inverter with FS-A8S and SBUS. I have inverters as necessary. (you don't get anything decipherable if the inversion is wrong)

pascallanger, 2023-08-22:
I don't have access to a genuine Flysky TX so it's going to be hard to troubleshoot... Do you know if this is supported by this receiver (at least on the manual)? Do a genuine Flysky TX supports the switch from IBUS to SBUS?
I think this was implemented for a 3rd party firmware.

geovinny1, 2023-08-22:
I have no documentation that the FS-iA6B (receiver) supports SBUS. With the OP's FS-A8S i-BUS/S.BUS is written on the case (I don't have an FS-A8S).
I know that the FS-iA6B itself works with sub-protocols marked "SBUS", but SBUS doesn't come out of it. I know that PWM/PPM options work OK on the CH1 connector.
I thought IBUS or SBUS was Tx-generated, I don't believe the receiver is doing some sort of conversion. But I have no means to check the protocol until it comes out of the receiver. For that matter, I can't check rx firmware version except that it's "new". It must be relatively easy to see if a TX16S MkII is transmitting SBUS protocol when SBUS is selected?

For my purposes I can live with iBUS. But the OP and others may surely have problems (e.g. my 16ch SBUS decoder is not useable with FS-iA6B, and I'd be nervous to buy an FS-A8S for SBUS)
Cheers

pascallanger, 2023-08-22:
"I thought IBUS or SBUS was Tx-generated," No, the RX is dealing with that. This is just a config flag sent to the RX to switch from one to the other same as PWM/PPM.

geovinny1, 2023-08-22:
Thank you for clearing that up. Both the OP and my receiver may be Rx firmware issues. Cheers

Closed 2023-10-30.

Thread 885 (2023-09-11):

can't bind pelikan scx24

bd4, 2023-09-11:
I am trying to bind Radiomaster Boxer with internal Multi module to an SCX-24 from Horizon Hobby, serial AXI00001T1. It has AE-6 ESC/Receiver combo. I have tried in low power mode and normal mode, close and far away, no luck. I start binding on the transmitter before turning on the scx24, which has a read light on the AE-6 that blinks three times than stays off, while the [Bnd] indicator in edgetx continues to bilnk.

Did something change with these models, so i.e. older scx-24 were using a different receiver with different protocol? Note that the transmitter that came with it does work, so the car and receiver are functioning normally. I did see that there is a V2 out now, I think from 2022, and what I have is a V1. The V2 has a blue ESC/receiver combo, HRZ0015.

bd4, 2023-09-11:
It's worth noting, that in the receiver manual, it says the Frequency is "2.4GHz FHSS". That is the only clue regarding protocol.

bd4, 2023-09-11:
Also the transmitter that came with it is an AX-4, which is listed as supported in the Protocol_details doc. So not sure what I am doing wrong here, or of something changed.

pascallanger, 2023-09-11:
Most if not all the time, bind works like this:
1. Power on the RX in bind mode. If there is a button then press it. If the RX has no button and do not need to be bound each time then you need to wait for the RX to go in bind mode after a timeout.  If the RX has no button and needs to be bound each time then you should send a bind not to long after power on.
2. Put the radio in bind mode

pascallanger, 2023-09-11:
Obviously you need to select the right protocol and subptotocol.

bd4, 2023-09-11:
Thanks for the reply! There is no bind button or jumper on the AE-6, the instructions say that it should immediately enter bind mode. I did try leaving it on for 5+ minutes, and it did not change to a different mode or succeed in binding. I did select Pelikan and SCX24 protocol, but I am not sure if this model of SCX24 uses the same protocol as what was used to create the original SCX24 support. It would be helpful to know what receiver was used for that. But the docs do say transmitter AX-4, which is the same as what I have, which would suggest it was the same protocol. So not sure what the problem is here.

pascallanger, 2023-09-11:
Can you try to increase the RX number by 1 and try again?

pascallanger, 2023-09-11:
Search the closed issues for scx24, may be you will find the RX type used at that time.
Do you have a logic analyzer to dump the a7105 SPI bus? Can you confirm the TX has an a7105 inside near the antenna?

bd4, 2023-09-11:
Tried several RX numbers, up to 06, no luck so far.

I don't have a logic analyzer currently, would one of the inexpensive usb ones from amazon work?

I'll see if I can open up the TX.

pascallanger, 2023-09-11:
Yes $10 saleale compatible 8 channels can do the trick. You'll have to solder small wires around the a7105.

bd4, 2023-09-11:
It does have an a7105. I am not good at soldering yet, but motivated and have an iron and practice board to use before trying the real thing. This is what it looks like: https://bda.space/images/ax-4-circuitboard.jpg. The antenna is on the right, the a7105 is on the left. There are some things that look like pads on the left, but not sure if/how are connected to a7105. Ordered an analyzer, should arrive in a day or two.

I want to use this with a flight type edgetx transmitter, to train pilots on the ground re basic controls and orientation before advancing to planes.

bd4, 2023-09-13:
Logic analyzer arrived. Any links to documentation on what pins to connect and how to dump SPI bus on the a7105?

bd4, 2023-09-14:
I found the rcgroups thread about adding SCX-24 support, in particular:
https://www.rcgroups.com/forums/showpost.php?p=46962099&postcount=21959

I have the C-10, so not sure why it is not working. I know that sometimes models have revisions and radios change, but often there is noise about that on the internet, e.g. the Smasher V2.

Here is the picture from rcgroups of the transmitter the user used to reverse, with your annotation: https://static.rcgroups.net/forums/attachments/1/1/5/4/3/7/a14854331-93-capture.png. Mine does look different. Mine does have 7 pads that would be easier to solder, but it is hard to see if/how they are connected to the ar7105. I think I will need a lot of practice before I am ready to solder directly to the tiny chip pins... I do have a microscope though :P.

pascallanger, 2023-09-14:
We are interested by 5 wires in total: GND (can be taken where you want Batt- if you want) and the 4 others noted on the picture below.
You don't have to solder on the A7105 pins which are too small. What I would do is to use the 4 tracks which goes between the A7105 and ESP as I highlighted on the picture, remove the green using a cutter to access the copper then solder your wire in place. There is no way to do shorts or break something if you use this method. Once your happy use a tape to secure all the wires so one won't get loose with time.

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

bd4, 2023-09-14:
Thanks that all sounds doable! I am going to go through an elenco solder practice board this weekend, then give the transmitter soldering a go.

pascallanger, 2023-09-14:
Also try to use the software Logic 1.2.14 for the captures. Latest versions have a bug with SPI decoding that they've never corrected...

pascallanger, 2023-10-30:
Any news ?

bd4, 2023-10-30:
Got distracted with other projects. I am putting a new ESC and RX in my SCX24, which makes the stakes for soldering the stock TX lower, still planning on attempting, hopefully this weekend.

pascallanger, 2023-10-30:
You can send me the TX and RX then, I will add the proto for others.

bd4, 2023-10-31:
> You can send me the TX and RX then, I will add the proto for others.

ok I actually have three surface tx/rx that I pulled out, this v1 scx24, vanquish vt/vr-1, and an hbx 16889a pro (esc/rx combo). I think the HBX may be wltoys proto and already supported, but didn't try, wanted to use with a radiolink surface tx so needed to swap anyway. Could send all at once.

pascallanger, 2023-10-31:
If you are willing to send me everything at once, contact me by email pascal _ langer @ yahoo . fr (remove the spaces).

bd4, 2023-11-04:
Related to #900 , closing this.

Closed 2023-11-04.

Thread 891 (2023-09-24):

V761 Protocol - Battery Telemetry / Low Voltage Alarm - Feature Request

Narb1cus, 2023-09-24:
Hi,

Was wondering if it is possible to add battery telemetry to the V761 protocol for use with Open TX ?

The stock TX features a low voltage alarm but this is not currently supported in the 4in1 firmware.

The Volantex / Eachine 400mm warbirds are quite popular so i'm sure this would be greatly appreciated - if its even possible!

Discussion here - https://www.rcgroups.com/forums/showthread.php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

Thanks

pascallanger, 2023-09-24:
Which planes have telemetry?  For sure not the old models when I've reversed the protocol....
Is there a way to identify them from outside?

Narb1cus, 2023-09-24:
Hi, Thnaks for the reply.

I'm really not sure tbh. Afaik they all support the low voltage alarm with the stock TX from the reviews i've watched.

I know that the Volantex Spitfire and BF109 definitely do as my friend has them both and bought them within the last year. He's just bought a Jumper tlite with 4in1 and they wrok great with the latest frimware but low voltage alarm is the one feature he's missing.

They both have this version of the flight board installed - https://uk.banggood.com/VolantexRC-Mini-Mustang-P-51D-or-Mini-F4U-or-Mini-P47-RC-Airplane-Fixed-Wing-Spare-Part-2_4GHz-4CH-Receiver-Board-With-On-Board-Servos-p-1997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

pascallanger, 2023-09-25:
I've posted on RCG. I know one of my friend purchased a "zero" not so long ago. May be it has this feature, I'll ask him to check the manual.

pascallanger, 2023-10-30:
Telemetry added in v1.3.3.33

Closed 2023-10-30.

Thread 903 (2023-11-05):

Kyosho Syncro KR-331 receiver not binding

RichW012, 2023-11-05:
Hi there, my Radiomaster TX16s will not bind to a Kyosho RC Car receiver. The list of protocols includes Kyosho FHSS, my receiver is the KR-331. The original TX is the KT_231P+ I have tried all settings combinations and I have the latest EdgeTX "Providence" v2.9.1. and the module firmware V1.3.3.33. I've been told this is a multi protocol issue. Thanks

pascallanger, 2023-11-05:
Who told you it's a multi protocol issue?
As far as I know it works, so I would like some proof.

RichW012, 2023-11-05:
Ive been on the Radio Master Products User Group and that's what they said.  Im not an expert in this so I bow to the greater knowledge. Its just been a case of trying everything with a receiver that is known to work, with a radio that's got no problems, and this is whats left. I understand the MiniZ receivers bind OK, but its my RTR Car ( Neo inferno3 )that won't. How can I supply proof?

pascallanger, 2023-11-06:
Do you have any protocol working with the A7105 RF component?

RichW012, 2023-11-06:
No I don't have any other receivers that uses a protocol using that component, so guessing where you are going, I need to test it somehow and make sure its not just a faulty A7105 RF component in my TX, is that possible with a multi-meter? I do have a diagram of the chip.

pascallanger, 2023-11-06:
A multimeter won't help. Do you know anyone around you with a flysky receiver? This is quite a known brand.

pascallanger, 2023-11-06:
I've been able to borrow a mini-z with a kt-531 TX. I'll have it on Saturday so I can test.

pascallanger, 2023-11-07:
My friend came with his mini-z FHSS with KT-531 radio. I've been able to bind his mini-z right away and control it with my TX16S.
Bind procedure: On the mini-z FHSS push the bind button and power it on -> led flashing quickly. Then launch a bind on the TX16S using KYOSHO/FHSS. That's it, you have full control of the car including CH4 which is for the front LEDs.
Here is the video: https://youtu.be/vBmwb3wiUTg

pascallanger, 2023-11-08:
If it still doesn't work when doing a proper bind sequence then it means that the transmitter KT_231P+ and KR-331 are not using the same "FHSS" protocol as the KT-531p. If you want this protocol to be added then you need either to ship me the TX+RX to France or sponsor the purchase of a TX+RX set locally (around 60€ incl shipping).

pascallanger, 2023-11-08:
Ok I think here it is: https://www.kyosho.com/jpn/support/instructionmanual/digital_prcs/pdf/82146_KRG-331_IM_A4.pdf
It's not the Kyosho FHSS protocol but what they call the "Syncro" protocol. Syncro TX are KT-231P, KT-231P+, KT-331, KT-432PT, KT-431S, KT-631ST.

RichW012, 2023-11-09:
Thank you for all your help Pascal! We have got to the bottom of the mystery! I will consider sponsoring the purchase, however I am in the process of moving and don't have spare money right now. As RadioMaster have just released the MT12 Surface Radio others might want to help. Thanks again

WazabiQc, 2024-01-06:
I was having the same issue with a Kyosho Blizzard, KT-431S radio with a KR-632 receiver.. I thought it was Kyosho FHSS at first as well because it's written all over it.. Would that be the same issue then ?

Wandereradi, 2024-01-17:
@pascallanger Well i am game with whatever you need, I was out of country so couldn't reply back.

So now let know if I could use a Logic Analyser and share the output from the TX to the A7105 chip.

or a Link from where i could ship you a TX RX. Mind you I am in India so there is no way to return the radio to me ( it would be your)

other option
I am confident enough do the the Logic analyser stuff if you have a thread on how to. Pretty good with soldering and stuff, I cant code thats all but analyser will not need coding so i am pretty ok, with a little guidance.

Wandereradi, 2024-01-26:
@pascallanger  please send me your details as to where to ship a new KT331 with a receiver. I tried a couple dataloggers ( clone ) but was not successfull.. thanks in advance

pascallanger, 2024-01-26:
@Wandereradi you can contact me at pascal _ langer @ yahoo . fr

Wandereradi, 2024-01-29:
@pascallanger  I have recorded the Logic for as below on the TX side. using 4MS/s  CH 0 -> EN, CH1 -> CLK, CH2 -> SDIO.
Binded Receiver - TX Logic Powered on
Binded Receiver - TX Forward & Reverse
Binded Receiver - TX Left & Right
Binded Receiver - TX Channel 3
Fresh Receiver - TX Bind

If there is any issue with the data please let me with what Sample rate should i Capture.
[KT331 Dump with 4MS_s.zip](https://github.com/pascallanger/DIY-Multiprotocol-TX-Module/files/14080865/KT331.Dump.with.4MS_s.zip)

pascallanger, 2024-01-29:
I've started to look at the dumps. Just by curiosity, is it an A7105 or another RF chip? Strangely they access an unknown register on the A7105, or there is something else.
I had to rewrite part of my decoder since you are using a Logic 2 version on which the SPI decoder is buggy... Logic 1 is fine. Anyway I can see what's going on.
The payload is huge with 37 bytes!
The radio is sending bind packets at every power up then switch to normal mode. The RX does not send anything to the TX so you don't need to power the RX when doing dumps.
They are using the same ID as Flysky and other Kyosho TXs: 0x5475c52A
I've quickly checked the RF channels, a sequence is repeating but not more than that for now.
I've checked the throttle capture, they transmit this channel on 2 bytes (LSB first) 1000 low 2000 high which is directly the PWM value. So the same will be true for all the others.
More to come...

pascallanger, 2024-01-29:
I should be able to code this protocol with what I have understood. I need to check this proto against the existing kyosho protocols to see if it's a variant.

pascallanger, 2024-01-29:
It's nearly a copy of the kyosho FHSS protocol. I need to check exactly why you can't bind, there is only one byte difference in the payload and RF channels are the same. Normal mode has also a few bytes difference.
What I haven't looked at all is the init of the component, may be that's where the real difference is.

Wandereradi, 2024-01-29:
Hi @pascallanger here are the pics from the RF board on the KT331.
you mentioned above that Logic2 has a issue so you mean to see the application installed on the laptop right?
which version are you using so i will also capture as per that. just in case.
Yes the receiver has blinking light for a few seconds afte the Tx has powered up - may be 2secondish or max 3.

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

pascallanger, 2024-01-29:
Interesting it's an A7105 but they are accessing a register which doesn't exist, a bug in their fw probably so I don't care...
What happens when you try to bind the receiver with the Kyosho/FHSS protocol? Do you see something on the RX LED?

Wandereradi, 2024-01-29:
its a A7106 not 5

pascallanger, 2024-01-29:
I should put my glasses on 😄 The A7106 have this additional register but I don't think it matters.
Ok the init of the A7105/6 is the same as the Kyosho FHSS. The ID is also the same. The bind packet has only 1 byte difference. I'm going to create a sub protocol Syncro and change this byte to see if that's what preventing to bind.

pascallanger, 2024-01-29:
I've pushed all the differences I've seen between FHSS and Syncro. Let's see if it works, you can download the test version v1.3.3.44 here: https://downloads.multi-module.org/latest-test/
I think most of the changes are useless, so if it works I would like to come back on some of them to lighter the code so I would need you to do some more tests.

Wandereradi, 2024-01-29:
> I've pushed all the differences I've seen between FHSS and Syncro. Let's see if it works, you can download the test version v1.3.3.44 here: https://downloads.multi-module.org/latest-test/ I think most of the changes are useless, so if it works I would like to come back on some of them to lighter the code so I would need you to do some more tests.

Hi Pascal, I forgot to inform I have Radiomaster MT12 4 in 1 tx, so i would need a build for that.

Also correct me - I would need to put this Bin file in the firmware folder and run firmware from firmware in the sys page

pascallanger, 2024-01-29:
The zip file on the test link contains all the builds. You most likely want to use this one: mm-stm-serial-aetr-v1.3.3.44.bin
Place it in the firmware folder of the SD card then in SYS navigate to the SD card -> firmware -> click on the above bin file and flash the internal module as proposed (if the bin file doesn't appear reduce the file name length).

Wandereradi, 2024-01-29:
> The zip file on the test link contains all the builds. You most likely want to use this one: mm-stm-serial-aetr-v1.3.3.44.bin Place it in the firmware folder of the SD card then on the radio in SYS navigate to the SD card -> firmware -> click on the above bin file and flash it the internal module (if the bin file doesn't appear reduce the file name length).

Uploading the firmware to the Tx , fingers crossed.

Edit - when i scroll the protocols, and come to Kyosho, it shows Subtype FHSSSY for a second and than changes to FHSS and i do not see a "Syncro"

Wandereradi, 2024-01-29:
Update - If i use Kyosho FHSS, it does not pair.

pascallanger, 2024-01-29:
You should see Kyosho FHSS->Hype-Sync
If you don't see that it means that you are either using an old version of EdgeTX (most likely) or the module is not talking anymore to the radio (you should see the module version displayed under the model where you select Multi

pascallanger, 2024-01-29:
Ok I made a typo on the subproto which might cause what you describe. The system is currently building the version v1.3.3.45, download it from the same place.

Wandereradi, 2024-01-29:
> Ok I made a typo on the subproto which might cause what you describe (FHSSHy). Download the version v1.3.3.45 from the same place and try. I'm not at home and I don't have any hw to test my code against.

I uploaded the new 1.3.3.45 but i do not see Syncro under Kyosho and FHSS doe pair.

pascallanger, 2024-01-29:
Do you see the hype subprotocol? Do you see the firmware version under multi?

Wandereradi, 2024-01-29:
> Do you see the hype subprotocol (Kyosho FHSS->Hype->Sync)? Do you see the firmware version under multi?

I do see what you mentioned above but do not see Firmware # AETR

pascallanger, 2024-01-29:
Can you take pictures of your radio screen ?

pascallanger, 2024-01-29:
Update your version of edgetx

Wandereradi, 2024-01-29:
> Update your version of edgetx

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

Wandereradi, 2024-01-29:
> Update your version of edgetx

How do I update the Edge Tx on RadioMaster MT12 4-in-1

pascallanger, 2024-01-29:
"No telemetry" is the issue here

Wandereradi, 2024-01-29:
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

the Edge Buddy does not support MT12 radio that i have, ie do not see it in the list. Also I see only FHSS and Hype, when Kyosho is selected and there is no "Syncro" - 1.3.3.45

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

pascallanger, 2024-01-29:
They give you the link to the latest version on the screen above.
Until the message no telemetry is displayed on the screen it won't work...

Wandereradi, 2024-01-29:
> They give you the link to the latest version on the screen above. Until the message no telemetry is displayed on the screen it won't work...

I have re-installed the edge tx firmware seen on above screenshot using the bootloader method but it is the same version.

pascallanger, 2024-01-29:
If you create a new model and select multi with whatever protocol (not Kyosho), do you see the version or no telemetry ?

Wandereradi, 2024-01-29:
> If you create a new model and select multi with whatever protocol (not Kyosho), do you see the version or no telemetry ?

Hi Pascal,

Yes, when i am using the 1.3.3.33, and bind with Flysky 2A - I do see Version, and sometimes  - I sometimes
see Version # Binding.

pascallanger, 2024-01-29:
No the fw for the Mt12 is not different. I bet that if you load that model with the new firmware it will work. I must have introduced a bug in the Kyosho protocol which is doing the main code to run and therefore the radio not recurving info from the module. I should be home tomorrow and I'll investigate further.

Wandereradi, 2024-01-30:
> No the fw for the Mt12 is not different. I bet that if you load that model with the new firmware it will work. I must have introduced a bug in the Kyosho protocol which is preventing the main code to run and therefore the radio is not receiving info from the module. I should be home tomorrow and I'll investigate further.

I have created a new model when I was testing the code, but the behavior was same. Unless I am missing something

pascallanger, 2024-01-30:
You are not doing what I was asking or talking about but forget anyway this was like I was thinking a crash when you select the protocol kyosho/fhss...
Please test v1.3.3.46

Wandereradi, 2024-01-30:
@pascallanger  Observations:
1) When the Rx power cycle's binding is not affected ( TX was constally on )
2) When Tx power cycle's with the new build - Internal Rf  Mode -> Off and i have manually turn it to Multi and select Kyosho
3) When we are trying to bind, FHSS also works but Only Syncro should work.
4) If i use a Flysky2A protocol receiver and power cycle the TX, it re binds and "Internal RF" - Mode is mantained and RX automatically binds

pascallanger, 2024-01-30:
1. Ok
2. Wy would the internal rf turns off? It has nothing to do with Multi since the radio stores the info so most likely a bug in the MT12 firmware. It's normal if the internal RF modules is off that you have to reselect Kyosho/Sync
3. This is what I would have guessed. The 2 protocols are so closed that only one byte is preventing the Sync RX to bind with FHSS. I think could even modify the FHSS protocol to bind FHSS and Sync RXs without having to add Sync...
4. Does the internal module stays on if you select Kyosho/FHSS? (my expectation is yes)

Please redownload the latest test firmware and test it. The version will be the same but I've done some code cleanup.

Wandereradi, 2024-01-30:
> 4. Does the internal module stays on after power cycle if you select Kyosho/FHSS? (my expectation is yes)   -> Yes it as you
       mentioned

pascallanger, 2024-01-30:
> > 4. Does the internal module stays on after power cycle if you select Kyosho/FHSS? (my expectation is yes)   -> Yes it as you
> >    mentioned
> >    But  if we have selected Syncro than at power cycle of tx, the internal module is off and also a random protocol is selected.

It proves that it is a MT12 EdgeTX firmware bug. You can try the latest nightly to see if they have fixed it. As a temporary fix, bind in Syncro and go back to FHSS.

Wandereradi, 2024-01-30:
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

I do not see a MT12 EdgeTx firmware nightly build, do you have a link?

pascallanger, 2024-01-30:
https://github.com/EdgeTX/edgetx/releases

pascallanger, 2024-01-30:
If you click the link I sent you above it's the first top entry called nightly... The MT12 fw is in the zip file.
But you can do all that from the companion tool if you install it as I already suggested, in the settings you can ask it to install the latest nightly or latest stable on the radio for you...

Wandereradi, 2024-01-30:
> If you click the link I sent you above it's the first top entry called nightly... The MT12 fw is in the zip file. But you can do all that from the companion tool (not buddy) if you install it (installation files are on the same link as above but from the stable release edgetx-cpn-xxx-v2.9.3.zip) as I already suggested, in the settings you can ask it to install the latest nightly or latest stable on the radio for you...

I installed the Nightly build -> Installed the Syncro build -> Turned on the Internal Module -> Set Kyosho -> Syncro, Binded the receiver, -> power cycled the tx -> worked as expected i.e. RX was bound back on power on.

pascallanger, 2024-01-30:
Have you tried the latest test version?

Wandereradi, 2024-01-30:
> Have you tried the latest test version?

Yeah, it was the you told me where you did some clean up and the version would be same.

Wandereradi, 2024-01-31:
@RichW012 and @WazabiQc Guys could you also assist in testing the Build for KR331 receviers, I have had an accident with my car.
@pascallanger thank your this quick turnaround, Really appriciate the help.
Also I will be further testing the code, currently trying to get the trims and dual rate set up on the MT12 ( completely new on EdgeTx)

pascallanger, 2024-01-31:
Please test the latest v1.3.3.47 test version. There is only FHSS and Hype as sub protocols. FHSS will bind both FHSS and Syncro receivers.

Wandereradi, 2024-02-01:
> Please test the latest v1.3.3.47 version available here: https://downloads.multi-module.org/latest-test/ The sub protocols are FHSS and Hype. FHSS will bind and control both FHSS and Syncro receivers.

Tested the 1.3.3.47 build,
Observation -
1) Syncro is no longer displayed.
2) Fresh binding is a bit slowe compared to when we had subtype syncro - my understanding is that now Tx is sending 2 types to
    bind so its taking time.
3) Flysky2A also binds the tx to rx.

I will test more on the weekend or tonight and repot back here.

pascallanger, 2024-02-01:
1. Ok
2. Not really... I haven't touched the total bind time. What you could observe is the RX accepting the bind packets 250ms after you press bind on the TX and not right away.
3. Too bad. But I think we are ok.
4. The bind payload size of Flysky2A is the same as Kyosho/FHSS and they use the same ID. So depending exactly on what the RX is checking it can just accept the bind but won't be controllable.
5. Good

I think I can close this issue now but let me know.

Wandereradi, 2024-03-15:
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

For #4 from above I am able to control the Kyosho. kR331 even if I have selected the FLYSKY2A protocol.

Range is all is good - have been able to control my car for around 100mts which was more than enough for me.

When would this code come to Release is what I wanted to know.

Also I sent you an email some time back for some help. Would you have time to help on it.

Also could we have Weight changed to Dual Rate or D rate

pascallanger, 2024-08-12:
Install the latest test firmware available on the main page and it should work flawlessly.

dogesTV, 2024-08-12:
> Install the latest test firmware available on the main page and it should work flawlessly.

Yes it worked thank you very much

Closed 2024-02-05.

Thread 938 (2024-02-05):

Evaluate Radiomaster RC3S protocol

pwkpete, 2024-02-05:
Per our conversation on rcgroups. Here are the images from the radio to evaluate if it may even be possible to implement the earlier Radiolink ground protocol: https://www.radiolink.com/newsinfo/664430.html

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

pascallanger, 2024-02-05:
The RF chip is under the glue so we don't know what it is...
The SPI bus is well exposed and can be connected to an analyzer.
Do you want to purchase and connect an analyzer (around $10) to your radio or proceed differently?

pascallanger, 2024-02-05:
A small 8 ch Saleae analyzer (https://www.ebay.fr/itm/262812296176) connected to MOSI, CLK, MISO, CSN and GND.

pwkpete, 2024-02-05:
That's funny, I happen to have one of those right in front of me, though I
have never used it...

I can solder that up, any particular software to use?

I assume, record from power on to bind?

On Mon, Feb 5, 2024 at 12:11 PM pascallanger ***@***.***>
wrote:

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

pascallanger, 2024-02-05:
Please use the logic software v1.2.14
I would need different capture files for:
- power on
- power on + bind
- throttle mid->low->mid->high-mid
- steering mid->low->mid->high-mid
- same for any other channels

pwkpete, 2024-02-06:
[RC4G.zip](https://github.com/pascallanger/DIY-Multiprotocol-TX-Module/files/14174599/RC4G.zip)

Can you see if these are what you need, or if I did it correctly?
CSN = Chan3
MISO=Chan4
CLK=Chan2
MOSI=Chan1

pascallanger, 2024-02-06:
Sorry but the sample rate is too low, the files are unusable as they are... You need to increase it quite significantly (*4 or *8).
GND is well connected between the GND of the radio and the GND of the Saleae, right?

pwkpete, 2024-02-06:
Yes ground is connected. Will up sample rate and try again. First time with
this so learning how to use it correctly. Thx!

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

pwkpete, 2024-02-06:
Here are the files a 8MS/s, let me know how these work. I did not initiate a bind to new RX yet, want to make sure this works so far.
[8MS per s.zip](https://github.com/pascallanger/DIY-Multiprotocol-TX-Module/files/14187129/8MS.per.s.zip)

Thx!

pascallanger, 2024-02-07:
Getting there, but still not fast enough... You should see 8 pulses of clock per byte, there are only 5-6 right now.
If you add a SPI analyzer (on the right side) and configure the inputs (MOSI, MISO...) with everything else by default, it should be able to decode which is not the case right now.

pwkpete, 2024-02-07:
Ok, tried again at 24MHz
SPI analyzer finds stuff, but the clock has me confused - I'd expect to see a consistent pulse
[Power On.zip](https://github.com/pascallanger/DIY-Multiprotocol-TX-Module/files/14195637/Power.On.zip)

pascallanger, 2024-02-07:
It works this time. I need to find out which component they are using now.

pwkpete, 2024-02-07:
[Scans @ 16MHz.zip](https://github.com/pascallanger/DIY-Multiprotocol-TX-Module/files/14195827/Scans.%40.16MHz.zip)
Awesome, I tried the other ones you requested at 16MHz - hope they work as well

pascallanger, 2024-02-07:
It looks like they are using a CC2500. The startup or bind phase looks strange from a first look so I'm wondering if it could be another CC2xxx. I need to spend more time on it.

pascallanger, 2024-02-07:
Now that I've removed the excessive polling that they are doing, I can see that what they are doing at the power up is to find free channels. Once done they start to send data using 2 of these channels every 14.4ms

pascallanger, 2024-02-07:
For "Power and Bind", what are you actually doing on the TX and RX side?
I'm asking since I don't see a difference between bind and no bind... Is there a bind button on the TX? My guess is that there is none and that if you put the RX in bind mode, it just binds to whatever TX is powered at that time.
Do you have multiple TXs?

pwkpete, 2024-02-07:
Power and bind is just turning on the TX and turning on the RX (it is already bound)

I was waiting to see if this worked and then going to do an actual bind - which I have to refresh my memory on how to do it with this setup. I know there is a bind button on the RX. Will look into that in a bit

pascallanger, 2024-02-07:
The TX and RX don't "talk" at least in normal mode, TX->RX only.
Please do a dump of the TX in bind mode. I doubt that the RX being off/on/bind matters but may be I'm wrong...

pwkpete, 2024-02-07:
I didn't see a bind mode in the TX: per the instructions:
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

In fact - I switched to a different model powered up and it connected to the RX without issue

pascallanger, 2024-02-07:
What do you mean by "different model"?
Can you select a model number on the TX? If yes I would need a dump of each model numbre.

pwkpete, 2024-02-07:
Yes, I selected a different model on the TX and it had no effect

It bound to the RX automatically - did not have to put the RX in bind mode

pascallanger, 2024-02-07:
Ok different model does not mean that there is "model match", ie the model and the RX have to match

pwkpete, 2024-02-07:
Correct, it would not seem that it is that 'smart'

pascallanger, 2024-02-07:
Also in the "Gyro" dump I see 2 things moving, like 2 channels. Do you have a mixer or were you moving 2 knobs in the same dump?

pwkpete, 2024-02-07:
In the above upload 'Scans 16MHz.zip' those were with the programmed model. EPA and likely some trim may have been not standard.

There is no 'mid' notch on the gyro channel, it was best guess - that is 100/100 EPA no trim
Aux channel 4 was just an on/off button

Would you like me to re-do any - I can do another gyro scan - I may have bumped the steering, it is close to the knob.

pascallanger, 2024-02-07:
It's not steering moving at the same time as gyro as I can differentiate the channels. It's something else that seems to follow the gyro value in some way. Could it be an unconnected 5th channel which follows the Gyro just because it's closed to it?

pwkpete, 2024-02-07:
That is weird, this is only a 4ch TX.

Mixing is off - I watch output from ch1-4 when adjusting gyro(3) and none move.

[trackstar_dspec_ts4g.pdf](https://github.com/pascallanger/DIY-Multiprotocol-TX-Module/files/14200520/trackstar_dspec_ts4g.pdf)

This extra output does not happen on other channels? I can re-do the gyro scan if you would like

pwkpete, 2024-02-07:
[Gyro v2.zip](https://github.com/pascallanger/DIY-Multiprotocol-TX-Module/files/14200693/Gyro.v2.zip)

Here you go, selected new model, did reset, validated no mix, ran test

Sorry about going too fast, was concerned about the size of the data files - not sure if that was warranted or not

pwkpete, 2024-02-08:
I don't know what to say, I was watching the channel 3 graph in the screen
and making sure not to touch anything else. There wheels were definitely
not turning. Hmmm.

I don't think there is a way to remap channels like that. It was a fresh
model configuration.

Will look again though

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

pascallanger, 2024-02-08:
That's really strange...
Can you redo a capture of all channels on this model which you have just reset?
Plus:
 - On one channel do a capture with an EPA of -120..120
 - Set the failsafe of every channel to a different value: CH1=-50%, CH2=-25%, CH3=+25%, CH4=+50%

pwkpete, 2024-02-08:
Ok we try again!

Reset model

I set failsafe for each channel different, started capture and then turned off rx, hope that achieved what you were needing.

I re-ran all other tests again (EPA 120 for CH1,2)

Hope for better luck this time

[V3.zip](https://github.com/pascallanger/DIY-Multiprotocol-TX-Module/files/14213009/V3.zip)

pascallanger, 2024-02-08:
What values have you used for failsafe on each channel ?

pwkpete, 2024-02-08:
Failsafes are set by input position, can not enter a number manually)

ch1 R49
ch2 F31
ch3 -43
ch4 -100 (option -100 or +100)

pwkpete, 2024-02-10:
I think those values you have there make sense for fail safe, no?

Did my last upload look any different?

pascallanger, 2024-02-10:
Yes it's 200 - failsafe value.
I'll try to code the protocol when I have 5 minutes

pwkpete, 2024-02-10:
5 minutes, lol? You are a machine :)

pascallanger, 2024-02-16:
The code is available on this repo. You need to download, select the protocols you need and compile by yourself since there is not enough space in the flash anymore to do a build with all the protocols.
Documentation is here: https://github.com/pascallanger/DIY-Multiprotocol-TX-Module/blob/master/Protocols_Details.md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
I still need to implement ant ID and find unused RF channels but I would like to make sure it works first.

pwkpete, 2024-02-16:
Ok, thanks!

I will need to learn how to build this again - long ago I did this for an old Atmega module where I needed to enable/disable protocols due to memory but it's been a while.

Will notify when I get the build environment up and can test

pwkpete, 2024-02-17:
I just did a fresh install of the IDE, I don't think I ever had it on this PC and I can't get beyond this error - nothing compiles. Google offers no assistance either. Any ideas, never had this before? (I uninstalled and searched on the machine for any arduino artifact and deleted and then reinstalled - same result)
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

pascallanger, 2024-02-17:
It should be straightforward... Install the recommended version of the Arduino ide (1.8.xxx can't fully remember exactly), point to our board, install the board, select the right build and compile.

pwkpete, 2024-02-17:
I've built it in the past, I'm even following the directions this time :).
I downloaded the nightly version of the ide, pointed to the boards but
something is not right. I used to do embedded system development back in
the dark ages, so I'm not exactly a newbie but my experience with this tool
chain and cross compound with gcc is not up to date

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

pascallanger, 2024-02-17:
Pay attention to the version of the ide, you need to use an old one, the version is in the instructions.

pwkpete, 2024-02-18:
I guess I didn't realize the ide was that tired to the tool chain

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

pwkpete, 2024-02-18:
Got it. In my spare time, I'll try to understand why there is this affinity
to an older version. (I assume at some point it will lose updates or
support.)
Thx

On Sat, Feb 17, 2024 at 3:39 PM pascallanger ***@***.***>
wrote:

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

pascallanger, 2024-02-18:
I know the build is broken for the latest versions. I haven't spent anytime to troubleshoot it so if you can give a hand that would be great 😁
You can have multiple versions of the ide running in parallel if needed.

pwkpete, 2024-02-18:
Ok got it compiled, I see the RC4G code, but not seeing the sub protocol available to select after flashing - also out of the box it compiled and fit, so I suspect I didn't config something correctly.

pascallanger, 2024-02-19:
The board should be set to "Multi X-in-1 STM32F103CB (128KB)". By default with the full package downloaded from here and the file _config.h by default, it should complain that you don't have enough flash space...
"No multi telemetry" means that either the module has not started at all or that serial mode is disabled.
As long as you'll see "No telemetry" you won't see the subprotocol RC4G.

pwkpete, 2024-02-19:
I'll have to mess with it when I get back later this week
I pulled a zip of the master branch, unzipped a new copy, I see #define
ENABLE_SERIAL, I also see your RC4G code, hrmph...
Made no changes, compiled and get:
Sketch uses 120468 bytes (99%) of program storage space. Maximum is 120808
bytes.

On Mon, Feb 19, 2024 at 3:23 PM pascallanger ***@***.***>
wrote:

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

pascallanger, 2024-02-23:
Air and Surface builds are available here: https://downloads.multi-module.org/latest-test/
Please test and report.

pwkpete, 2024-02-24:
Got it compiled and it works perfectly!

Awesome work!

pascallanger, 2024-02-24:
Ok good news.
I still need to implement any ID and find unused RF channels but I wanted to make sure it worked first.
The current code uses your ID so your RX should just be controllable without the need to bind it.

pwkpete, 2024-02-24:
So is each tx flashed with a UID?

On Sat, Feb 24, 2024, 10:58 AM pascallanger ***@***.***>
wrote:

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

pascallanger, 2024-02-26:
Please test the latest radiolink/rc4g version which includes any ID and best RFs. It is available in the Surface build here: https://downloads.multi-module.org/latest-test/

pascallanger, 2024-02-26:
Both... If you load the Surface (SFC) firmware it will work on the TX16S, same if you download and compile.

pwkpete, 2024-02-26:
Ok, on the protocol dialog it says ID is unique, is there a way to set the ID? (Can I set it to match my real TX?)

pascallanger, 2024-02-26:
The ID in the new version is set to the one of your TX16S. You could change the ID (using the config lua script) so it match your original TX but this will affect all other protocols.
When the radio is saying "ID is unique", it's talking about the RX number value not being used elsewhere. You can have up to 64 matching RXs per protocol.

pascallanger, 2024-02-26:
Just install the new code and bind the RX to see if it works.

pwkpete, 2024-02-26:
Verified: change RX # lost connectivity, changing back reestablished.
Power cycled RX and TX - connects correctly.

All looks good

pascallanger, 2024-02-26:
Ok I call it done then

pwkpete, 2024-02-27:
I'm trying to follow where the TX id comes from:
#define eeprom_read_byte EEPROM.read
#define EEPROM_ID_OFFSET		10

MProtocol_id_master=random_id(EEPROM_ID_OFFSET,false);

random_id(...) calls: eeprom_read_byte((EE_ADDR)(address+10)) = checks for 0xf0 and if so reads from address + 5 to 1 masking and shifting the addreess into id which gets returned

I assume EEPROM.read is coming from the board config and knows the starting addr of the eeprom for the multi module but I'm not following how that is unique/tx (yet)?

Am I reading the code correctly?

pascallanger, 2024-02-27:
id = STM32_UUID[0] ^ STM32_UUID[1] ^ STM32_UUID[2];

Closed 2024-02-26.

Thread 947 (2024-02-16):

Ko Propo Mini-z Protocols ASF/MHS

stbn72, 2024-02-16:
Hi, i would like this protocols to be added

FilePhil, 2024-03-16:
Hey,
Support for this Protocol would be awesome.

I have found this Guide  [[#379](https://github.com/pascallanger/DIY-Multiprotocol-TX-Module/issues/379)](https://github.com/pascallanger/DIY-Multiprotocol-TX-Module/issues/379#issuecomment-653743696)
 and tried to Capture the needed Sequences.

 I used a BitScopeBS05U so i could only record on 8MHz.
[ASF_8mhz_dumps.zip](https://github.com/pascallanger/DIY-Multiprotocol-TX-Module/files/14623310/ASF_8mhz_dumps.zip)

Please let me know i this is enough Resolution or if i should order another Logic Analyzer.

 ASF Module Overview:
 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

Thank You,
Best Regards Phil

pascallanger, 2024-03-16:
Wow it looks quite small to solder wires on this board... I can see only 3 arrows on the PIC does it mean you haven't connected one of the signal (blue)?
Sorry but can you extract the SPI data from your dumps? or point me to the needed software? Right now I can't read the files in the zip file to see if they are good or not.

FilePhil, 2024-03-16:
Hey, yes I found only these Three Pins on the mcu, but i will recheck it tomorow, mabye I missed the Connection.
The Data in the ZIP should be  PulseView Session files like in the other Issue. I  converted of the Data Form the Bitscope, because the DDR/CSV is not very usefull...

FilePhil, 2024-03-16:
Hey, yes I found only these Three Pins on the mcu, but I will recheck it tomorow, mabye I missed the Connection.
The Data in the ZIP should be  PulseView Session files like in the other Issue. I  converted of the Data Form the Bitscope, because the DDR/CSV is not very usefull...

FilePhil, 2024-03-19:
Today I got the Logic Analyser and went to work:
I checked the MISO and MOSI Pins again and It seems to be that they are connected to the same pin on the MCU.
The soldered wires is not bridged with any other Pin on the MCU.
Maybe they use the 3 Pin SPI Mode stated in the Datasheet?

> This interface may be optionally operated in a 3-pin mode with
the MISO and MOSI functions combined in a single bidirectional
data pin (SDAT). When using 3-pin mode, user firmware must
ensure that the MOSI pin on the MCU is in a high impedance
state except when MOSI is actively transmitting data.
>  [Datasheet CYRF6936 Page 5](https://media.digikey.com/pdf/Data%20Sheets/Cypress%20PDFs/CYRF6936.pdf)

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

I probed the SPI with PulseView in 12MHz Mode, here are the Session Files:
[ASF_12MHz_PulseView_SRs.zip](https://github.com/pascallanger/DIY-Multiprotocol-TX-Module/files/14656546/ASF_12MHz_PulseView_SRs.zip)

Hopefully this helps with the analysis, Thank you!

pascallanger, 2024-03-20:
I've only looked at the On_Idle file for now.
Wow they are a bit crazy on the cyrf polling...
They are nearly using all the default values of the cyrf for the init.
They transmit only on one channel but they keep listening on that channel so I think they have a system to switch from one channel to another as needed. (Traxxas TQ is the other protocol doing something like this).
CRC16 is disabled so there must be a CRC in the payload itself.
The payload is 9 bytes. There must be an ID 2 to 5 bytes and a CRC 1-2 bytes.
More to follow...

pascallanger, 2024-03-20:
I see that some TXs/RXs have 4 channels. Do you confirm? Your TX has only 2 channels right?
What's the bind procedure? I have some trouble to see how the bind works...

pascallanger, 2024-03-20:
Payload 9 bytes
01|AB|31|BF|77|7D|FF|AA|5C
---|---|---|---|---|---|---|---|---
ID0|ID1|ID2|CH LSB?|STR|THR|AUX1?|AUX2?|checksum

ID0 most likely
ID1 most likely
ID2 most likely
CH_LSB -> this byte looks like the concatenation of the 2 low bits of the 4 channels but it is hard to see on the dumps: AUX2.b1 AUX2.b0 AUX1.b1 AUX1.b0 THR.b1 THR.b0 STR.b1 STR.b0
STR 30..7C..CC -> 8 upper bits. Can be extended to 00..7F..FF ?
THR 12..7C..DE -> 8 upper bits. Can be extended to 00..7F..FF ?
AUX1 most likely
AUX2 most likely
Checksum=sum(P[3..7]) , the ID is excluded from the calculation which is ok

pascallanger, 2024-03-20:
> I think its 2 channels (i would only need 2 i guess)

I've found many RXs with 4 channels: https://fr.aliexpress.com/item/1005003078678987.html

FilePhil, 2024-03-20:
Hey,
**I see that some TXs/RXs have 4 channels. Do you confirm?**
Yes I habe Seen the New RX with 4 Channels.

**Your TX has only 2 channels right?**
It can output 3 Channels, should I try to make a recording?

**How many channels do you have on your RX?**
The Mini Z MR-02/03 have 3 Channels RX, the Thrid is only for turning on Lights.

**What's the bind procedure?**
1. Hold Button on the TX Module
2. Turn on TX
3. Release Module Button
4. Hold BIND Button on the RX/Mini-z
5. Turn On RX/Miniz
6. Release BIND Button
7. Wait for the Red light to go to Solid
8. Power Cycle both

pascallanger, 2024-03-20:
Can you record CH3?

FilePhil, 2024-03-20:
Okay, I will Try it Later.
The Module uses PPM from the TX, mabye I can Simulate the 4. Channel, if it would helps?

pascallanger, 2024-03-20:
Having the 3rd channel should be enough to clear the assumptions.

pascallanger, 2024-03-20:
I need to check my decoder there might be something I'm not seeing on the bind... I do see the difference with On_idle but I can't see what's helping for the bind.

FilePhil, 2024-03-20:
Okay mabye i have to unbind the RX first to see the Binding.

pascallanger, 2024-03-20:
> Okay mabye i have to unbind the RX first to see the Binding.

Not sure how you can unbind it unless you have a second TX?

pascallanger, 2024-03-20:
> Okay mabye i have to unbind the RX first to see the Binding.

Was the RX powered on and in bind mode when you launched the "Binding" capture?
I see the TX sending a packet and kind of listening to something (an answer?) which never comes...

The only thing I see different during the bind is that the TX looks for a free channel before transmitting.
In normal mode it uses a channel (last used? have you done all your dumps On/STR/THR without powercycling the radio?) and listen on this channel. I assume that if it finds another TX on that channel it will switch to a new one but that needs to be looked at because there might be a notification to the RX that the RF is about to change.
Loads of questions...

Traxxas TQ is also transmitting on a single channel, use the last known good channel (same as above?), and if it hears about another TX, it will tell the RX to meet at another channel before switching. If the RX is lost, it doesn't scroll through all the RF channels but instead it sends "help" on a specific channel, the TX receives it and sends a "hello" packet saying I'm using this specific channel come to me.

pascallanger, 2024-03-20:
Is it possible to bind multiple RXs to your TX?
What happens in this example:  Bind your RX but power it off, launch a new bind on the TX with the RX still off, power of the TX. Will the RX reconnect after that? You might need to retry a few times to make sure the TX has selected another channel, ie if it works when you power on the RX, power it off, put the TX in bind, power cycle and power the RX.

FilePhil, 2024-03-20:
**Was the RX powered on and in bind mode when you launched the "Binding" capture?**
No, You have to first put the TX into Binding Mode than the RX. The other way around does not work.

**It even never switches to normal mode during the dump**
You have to Powercycle after the Binding, before that nothing moves.

**Have you done all your dumps On/STR/THR without powercycling the radio?**
I captured each dump on a fresh Powercycle.

**Is it possible to bind multiple RXs to your TX?**
Yes, they also work on the same time. A Race against yourself is possible :)

**What happens in this example: Bind your RX but power it off, launch a new bind on the TX with the RX still off, power of the TX. Will the RX reconnect after that?**
The RX reconnects every time, I tried the sequence like 5 times.

I have also recorded a new Binding with an previous unbound RX (I borrowed another TX)
[ASF_12MHz_PulseView_Binding.zip](https://github.com/pascallanger/DIY-Multiprotocol-TX-Module/files/14673250/ASF_12MHz_PulseView_Binding.zip)

FilePhil, 2024-03-20:
I tried also to Capture CH3, but on the TX I can only map it to toggle buttons, so full left or full right.
[ASF_12MHZ_PulseView_CH3.zip](https://github.com/pascallanger/DIY-Multiprotocol-TX-Module/files/14674400/ASF_12MHZ_PulseView_CH3.zip)

pascallanger, 2024-03-21:
CH3 is showing what I was expecting. It goes from 01 to FF. For the 2 additional bits I have been able to correlate the change and one of the 2 bits so I'm sure of the position of CH4 and CH3 but not STR and THR. The last 2 bits are hard to identify due to the noise, they keep moving quite a lot...

pascallanger, 2024-03-21:
Binding_Fresh and Bind_Long are completly different compare to Binding. There is actually a 4 bytes bind packet being sent with the ID.
Binding follows the same path but somehow does not get what it wants, continue to scan and finally switches to normal mode.
From the SPI dumps I can't see what's different but I guess the IRQ pin is signaling that a packet has been received (from the RX in bind mode) which triggers the bind packets to be sent.

I'm wondering if I can simply scan for a free channel 04..50 and blindly send bind packets. Same for normal mode by the way.

pascallanger, 2024-03-21:
I can now code this protocol but I will need other dumps to see what happens when the frequency is used. Your TX is sending always on 4 so you could start recording, turn on the multi module which will also sends on 4 and we will then see what happens.

My guess is that on detection of a used channel the alternating normal packets will be sent on 2 different channels current and a free channel for a (long) period of time and then fully switch to this new channel for a "smooth" transition.

pascallanger, 2024-03-22:
Please test v1.3.4.3 SFC available here: https://downloads.multi-module.org/latest-test/
The documentation is located here: https://github.com/pascallanger/DIY-Multiprotocol-TX-Module/blob/master/Protocols_Details.md#kyosho3---98
It uses @FilePhil ID and RF frequency for now for test purposes.
@FilePhil, please test as follow:
1. take a RX bound to the TX you use for dumps and power it on
 - create a model using the new protocol Kyosho3/ASF
 - you should have control right away -> be careful with throttle...
2. take an unbound RX
 - put the RX in bind mode
 - launch a bind on the TX
 - bind should work and you might even get control right away

FilePhil, 2024-03-23:
Awesome, how fast you managed it.
I tested the Firmware:
- The Throttle and Steering works, but with heavy stuttering and the Throttle seems not to reach full Throttle. [See Video](https://youtu.be/bgEe3ZrchNM)
- One time the Controls doesn't work for a few seconds and then the steering moves without input for a few times.
- Binding a new RX does not work. After starting the Bind on the TX, it beeps after 2s and the binding exits without any actual binding.

FilePhil, 2024-03-23:
Also i Attached the IRQ Pin to the Logic Analyser and recorded the Sessions:
[ASF_12MHz_IRQ_PulseView_SRs.zip](https://github.com/pascallanger/DIY-Multiprotocol-TX-Module/files/14729542/ASF_12MHz_IRQ_PulseView_SRs.zip)

pascallanger, 2024-03-23:
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

Can you test with v1.3.4.4 ?

For Throttle not reaching maximum speed, it might just be due to the stuttering which I hop is solved in this version.
What I've done so far is to assign directly what the radio sends to the channels. The output range from multi is 19..E6, Throttle on your original TX is 12..DE, so as you can see your original TX goes a little lower 12/19 but at the top multi goes beyond DE/E6.
You can increase the range if you want, far more than the original TX, if you enable "Extended limits" and set your outputs (not mixers) to 125% giving 00..FF. I can change that to whatever would work but that's how it is so far.

FilePhil, 2024-03-23:
Thanks, I tested  v1.3.4.4:
Throttle and Steering works without any visible Issues while bench testing.

Binding a new RX works if the binding on TX is launched first and then the binding on the RX is started (Releasing the Binding Button on RX).
But you have to be quick, because the TX binding terminates after 2s.
**Is it possible to expand to 10s or 20s ?**

The binding seems to reuse my original TX ID for the new bound RX.
I can control also the RX bound to the MultiModule TX with the original TX .
So I can not use both at the same time for different RX.

pascallanger, 2024-03-23:
We are not done yet.... We will change the ID later.
I would like you to do the following, you might only have one try so prep yourself:
 - use an already bound RX but do not power it on
 - start a recording and power on the original TX, save the file but don't turn off the TX
 - with the original TX still powered, start a recording and then quickly power on multi (be careful here powering up the radio and module takes time so the recording must be long enough) and save the file
 - power off the original TX and multi, power on the RX, start a recording and power on the original TX. Save the file. Is the RX still working (assume yes but...)?

FilePhil, 2024-03-24:
I followed the Steps and the RX is still working on the original TX and Multi.
[ASF_Scenario_1.zip](https://github.com/pascallanger/DIY-Multiprotocol-TX-Module/files/14735006/ASF_Scenario_1.zip)

pascallanger, 2024-03-25:
Ok so strangely when there is a clash the TX doesn't change the RF frequency but instead shorten the packet (5 bytes instead of 9) and sends it less often which means that only steering is getting out every 16ms...

pascallanger, 2024-03-25:
Can you try v1.3.4.5 which supports multi IDs?
Try to bind any RX, is it working? Verify connectivity after a power cycle of the RX, connectivity after a power cycle of multi. Make sure that the RX doesn't work anymore with the previous TX.

Assuming it works, I would need 2 dumps of the original TX:
 1. Turn on multi, start recording, power on the original TX and leave it idle
 2. power on the original TX, start recording, turn on multi
Make sure to record long enough in both cases

FilePhil, 2024-03-25:
**Try to bind any RX, is it working? Verify connectivity after a power cycle of the RX, connectivity after a power cycle of multi. Make sure that the RX doesn't work anymore with the previous TX.**
Yes, it works to bind and the RX doesn't work anymore with the previous TX.
When the original TX is also on and i try the multi TX, the Multi RX start to stutter and after a few seconds the connections seems to be lost and i can not control it any more.

**Assuming it works, I would need 2 dumps of the original TX**
I recorded the Scenario one time without RXs powered on and one time with RXs on.
I don't know if its makes a difference.
[ASF_Scenario_2_RX_off.zip](https://github.com/pascallanger/DIY-Multiprotocol-TX-Module/files/14746683/ASF_Scenario_2_RX_off.zip)
[ASF_Scenario_2_RX_on.zip](https://github.com/pascallanger/DIY-Multiprotocol-TX-Module/files/14746687/ASF_Scenario_2_RX_on.zip)

I also noticed that the range is only around 1m, is this a test firmware thing? :)

pascallanger, 2024-03-25:
> I also noticed that the range is only around 1m, is this a test firmware thing? :)

This is unexpected and I don't see why since I'm setting the cyrf to full power unless you have checked low power...

pascallanger, 2024-03-26:
> **Assuming it works, I would need 2 dumps of the original TX** I recorded the Scenario one time without RXs powered on and one time with RXs on. I don't know if its makes a difference. [ASF_Scenario_2_RX_off.zip](https://github.com/pascallanger/DIY-Multiprotocol-TX-Module/files/14746683/ASF_Scenario_2_RX_off.zip) [ASF_Scenario_2_RX_on.zip](https://github.com/pascallanger/DIY-Multiprotocol-TX-Module/files/14746687/ASF_Scenario_2_RX_on.zip)

Too bad your TX has changed its RF channel outside of the dumps surely during your tests above. So I still don't have the info on what to do when there is a RF conflict...
I've updated the RF channel to match your current TX channel. You have only one chance to do the capture right since it will change again when both TXs are up at the same time...

FilePhil, 2024-03-27:
Okay new try, now the first time both turned on the same time:

[ASF_Scenario_2_RX_On_first.zip](https://github.com/pascallanger/DIY-Multiprotocol-TX-Module/files/14780624/ASF_Scenario_2_RX_On_first.zip)

FilePhil, 2024-03-27:
I recorded also a range test, where i am walked away with the RX.
Maybe something happens, when the Distance Changes.
[ASF_Range_bigger_3m.zip](https://github.com/pascallanger/DIY-Multiprotocol-TX-Module/files/14780686/ASF_Range_bigger_3m.zip)

FilePhil, 2024-03-29:
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

Okay, I assume from the Answer you need only the 2. sequence, right?
I thought you need Both and did both sequences.
I have not powered them up at the same time.
I have tried to say, that I tested them not before the record.😅

To be clear this time:
Prepare:
1. Bind Original TX with RX, turn off
2. Bind Multi TX with other RX, turn off

Record Sequence:
1. Power on the original TX
2. start recording
3. turn on multi
4. record for 30s

FilePhil, 2024-03-29:
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

I did try to power cycle, but the same result.
I will test it again with the new Version.

pascallanger, 2024-04-18:
I'm closing this issue as the code works as it is.

stbn72, 2024-05-04:
> I'm closing this issue as the code works as it is.

Hi, what about the MHS protocol?

starryalley, 2024-09-23:
Hi thanks for all the hard work you did. Today I tried to bind my 4-in-1 (on RM zorro) with kyosho3 ASF protocol (i built it from the master branch) but I couldn't get my mini-z to bind. My original TX is a KT-18 and my mini-z is a MA-020. (I assume this issue is for this particular protocol.)

When I put my RX in the bind mode it just kept flashing no matter how I tried to bind from my 4-in-1. Any help is appreciated. Thanks.

FilePhil, 2024-09-25:
Hey @starryalley ,
did you start the binding on TX first and then the binding on the RX by Releasing the Binding Button on the RX?
The other way around seems not work.

starryalley, 2024-09-25:
Hi @FilePhil yes. Indeed I tried both ways but unfortunately both didn't work. The red light just keeps blinking on the mini-z RX. Are your original TX also KT-18? Should I be turning on power on mini-z while holding the binding button and then releasing it quickly right after I hit the bind on TX?

starryalley, 2025-01-08:
Any update about this? I am thinking to purchase a MT12 radio with 4-in-1 module and it would be great to control my existing 2 mini-z with ASF protocol (original TX is a KT-18). If anyone succeeds in controlling their mini-z that also comes with KT-18, would you please give me detailed instruction on how to do it? I am using a Zorro with 4-in-1 to test it. Thank you.

pascallanger, 2025-01-08:
That protocol should work fine. Try using the latest SFC test version.

starryalley, 2025-01-09:
Thanks for confirming. I just re-flashed again (I built the bin myself so I can select protocols that I need) and magically it binds the first time I try! I can confirm it's all working fine. I have no idea why I failed to bind it last time (last September).

starryalley, 2025-01-14:
Sorry to comment again, but I think the ASF binding is still problematic.

What I reported earlier for a success bind was a MB-010 (buggy) with ASF. It comes with KT-18 transmitter.
Today I tried with my other old mini-z (MA-020 AWD with ASF protocol), it just refuses to bind. I went back to MB-010, it binds again successfully. However this MA-020 binds with the same KT-18 transmitter. (I use the same KT-18 transmitter to control both mini-z cars). The red light just keeps on flashing on the RX.

What can I help to troubleshoot? Thank you.

pascallanger, 2025-02-27:
Funny enough I've just bought also an old mr03 without remote. It binds with kyosho fhss.

Mariorossi07, 2025-02-27:
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

wooooowww! great job @pascallanger it worked flawlessly at first try!

starryalley, 2025-02-27:
> Hi there everybody. I have just bought an old mr03 that has a kt18 transmitter and I can't get it to connect to the multimodule. [@starryalley](https://github.com/starryalley) have you found anything to solve your issue? Thanks in advance

Hi @Mariorossi07 i was unable to get this particular ASF MA020 (9~10 yo AWD) to bind at all at that time. I've tried the latest test version, built my own firmware, and various (>40+) binding attempts. All failed. But my mini-z Buggy (ASF) binds instantly and works flawlessly. I've since replaced the old mainboard with the new FHSS so I am all good. FHSS is already known to work.

Great to hear yours binds successfully! Looks like it may be just this MA-020 RA-23T ASF receiver that has the problem binding.

I also have a DasMikro brushed ASF board (compatible with MR03) waiting for me to move to my old AM radio MR-02 and I really hope it binds with my MT12. I still haven't found time to work on this yet.

pascallanger, 2025-02-27:
If ASF doesn't bind for everyone, I can do something else but it looks like we are all good now 👍

starryalley, 2025-02-27:
Thank you and appreciate all the hard work you've done. @pascallanger I am grateful enough that my ASF mini-z buggy works flawlessly and binds instantly. I'll update when I get my DasMikro ASF board up on my old MR-02 and see if it binds.

Mariorossi07, 2025-02-28:
@starryalley have you tried [latest test version](https://nightly.link/pascallanger/DIY-Multiprotocol-TX-Module/workflows/main/master/multi-test-build.zip) v1.3.4.42 as per @pascallanger message? the stable version didn't work for me but the latest nightly build worked like a charm.

starryalley, 2025-02-28:
No I haven't since I don't have any not-working ASF at this moment. Hopefully [this commit](https://github.com/pascallanger/DIY-Multiprotocol-TX-Module/commit/fa055e991ce3754dfe7fa9a079ff9b679e092175) fixed it. I will know when I have my DasMikro ASF MR-02 ready in a few weeks. Thanks.

Mariorossi07, 2025-02-28:
@starryalley sorry for the side question but is the DasMikro ASF compatible with mr02? I thought it was not beacuse steering servo is different between mr02 and mr03

starryalley, 2025-02-28:
> [@starryalley](https://github.com/starryalley) sorry for the side question but is the DasMikro ASF compatible with mr02? I thought it was not beacuse steering servo is different between mr02 and mr03

I heard it's compatible with MR02 from reddit group. More than 1 people reported it worked on AM MR-02 so that's why I bought it, just that one needs to re-use existing MR02 steering servo and potentiometer. Actually the board does not come with any other thing, just the board itself so soldering battery/motor/potentiometer/steering motor wires are needed. I'll report here when I get to this and try my MT12 4-in-1 with the new firmware to bind it.

starryalley, 2025-03-04:
Just a quick update. I compiled the latest 1.3.4.42 which has [the commit](https://github.com/pascallanger/DIY-Multiprotocol-TX-Module/commit/fa055e991ce3754dfe7fa9a079ff9b679e092175), and put into my MT12, and then got my decommissioned old MA-020 RA-23T ASF receiver mainboard out of the parts box, supplying some 5V power, and now wow, it binds and works wonderfully. Great work @pascallanger !

I am now pretty sure the Das Mikro ASF board should be fine too! I'll report in a few weeks if I can use MT12 with the 20yo MR-02.

starryalley, 2025-04-04:
Happy to report the [DasMikro brushed ASF board](https://www.dasmikro.com/product/dasmikro-mini-z-mr-03-brushed-asf-main-unit-set-compatible-to-mr-03-brushed/) binds just fine with the MT12 with this latest 1.3.4.42.

(By the way I probably broke my board after I soldered some wires repeatedly, specifically the steering motor only turns in one direction so guess some components went bad. Anyway it's unrelated to this issue. )

plfdez, 2025-04-25:
Thank you guys for your work on these boards. I have been testing with several boards (2 types) with this result:
- ASF boards: all bind successfully with 4-in-1 module (kyosho3)
- MHS/ASF boards: none of them bind to the 4-in-1 module (kyosho3). These boards bind well with old KT18 transmitter because the board recognize is an ASF protocol and disable MHS one. However this not happend with the 4-in-1 module.

Again, thanks you for your work

pascallanger, 2025-04-26:
Strange I'm wondering why...
The KT18 stays on bind all the time where multi binds only for a few seconds. So it might be that the board tries ASF at different times like right at the beginning or a few seconds later. Have you tried to bind at different times?

plfdez, 2025-04-29:
I tested at different times but with the same result. Only to give more details: 4 in 1 module with ATmega328P.

lschunn, 2025-06-03:
> Use the latest test version instead https://downloads.multi-module.org/latest-test/

Thanks, I've updated M12 to latest test version 1.3.4.50, but still not able to bind the Kyosho buggy ASF.
I confirmed stock transmitter KT-18 binding 100% ok.

plfdez, 2025-06-03:
Hello,
I leave my last tests and work around to see if some clue could be extracted. As I said before, I have several ASF/MHS boards and 1 of them completes the bind process and the others not. What I have done to have all of them working with my MT12 transmitter, is the following:
- Complete the bind process with all boards and my KT18 transmitter.
- Re-compile multiprotocol firmware with "KYOSHO_FORCE_ID" option in Kyosho3_cyrf6936.ino file, putting the ID from my KT18 previously used for binding.
- Then, with the 4-in-1 module in my MT12, I can control all the boards.

To sum up, there is a problem in the bind process with some boards, but the normal working of the protocol is fine.

plfdez, 2025-06-03:
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

Convert to 3 bytes hex number

pascallanger, 2025-06-03:
Ok I'll check the dumps to see what I've missed on the bind part.
Hopefully you can test if I post a new code, correct?

Closed 2025-01-09.

Thread 977 (2024-05-14):

Hitec telemetry not fully received

pierrotm777, 2024-05-14:
I open this issue for help to complet the hitec telemetry.
Actually, my Tx16s MkII 4IN1 receive only  TRSS, TQly and RxBt.
I should like to have all other features as rpm, current, voltage, temp, and fuel, etc..
For my test, I use:
- Radiomaster Tx16s MkII 4IN1
- Hitec optima 7 receiver
- Hitec telemetry station HTS-SS
- Hitec RPM sensor
- Hitec Fuel.

I have a logic analyser.
Thanks for your help,
Pierre

pascallanger, 2024-05-14:
Now that you give the sensors you are using, this is strange as it should be working at least the RPM but let's check what the module is receiving.

pierrotm777, 2024-05-14:
How

pierrotm777, 2024-05-14:
Reopen sorry

pascallanger, 2024-05-15:
Frame 11 contains the RXBatt
RPM and FUEL should be in frame 15
Frame 1B contains the Vario information which is far from the RPM and Fuel you are talking about...
I've looked at both hitec_v2-1 and hitec2. There is only a response on frame 11.
Are you using real sensors or playing around?
The sensors I've implemented on OpenTX/EdgeTX are at the end of the hitec protocol file with the frames content: https://github.com/pascallanger/DIY-Multiprotocol-TX-Module/blob/2bdbd7088c0846b08be1d47e889d0cb85cf533ff/Multiprotocol/Hitec_cc2500.ino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
If the frames arrive then the radio should display them.

pierrotm777, 2024-05-15:
I use real sensor for these tests.
But I use optima as subprotocol and not opt_fw.
As see if that changes something with opt_fw.

pascallanger, 2024-05-15:
So Optima is the one you want

pascallanger, 2024-05-15:
Do you see the i2c frames of your sensors?

pierrotm777, 2024-05-15:
Curiously yes, I but they are empty.

pascallanger, 2024-05-15:
If empty then they won't display... Verify the connections, that's all I can say.

pierrotm777, 2024-05-15:
My connections are correct.

pascallanger, 2024-05-15:
Then may be the telemetry station is faulty or the sensors...
We can check what the module is receiving but I fear that it will be the same as what you have on i2c.
With an external multi module, download the latest sources, select only a few protocols in _config.h and compile with debug option set to native for an irangex module or ftdi for the others, upload, open the serial monitor and you should see the debug prompts.

pierrotm777, 2024-05-15:
Can i use your [mm-stm-xn297dump-usbdebug-v1.3.4.0.bin](https://github.com/pascallanger/DIY-Multiprotocol-TX-Module/releases/download/v1.3.4.0/mm-stm-xn297dump-usbdebug-v1.3.4.0.bin) or i need to compile my own version ?

pascallanger, 2024-05-15:
> I have a diy external module for another radio, but it is not compatible with my tx16s external box. I need to work for adapt it, add power dc converter etc... I see that as soon as possible

Debug is only available on stm32 modules

pascallanger, 2024-05-15:
> Can i use your [mm-stm-xn297dump-usbdebug-v1.3.4.0.bin](https://github.com/pascallanger/DIY-Multiprotocol-TX-Module/releases/download/v1.3.4.0/mm-stm-xn297dump-usbdebug-v1.3.4.0.bin) or i need to compile my own version ?

I can't remember which protocols are included in the xn297dump version. The best is to compile by yourself.

pierrotm777, 2024-05-15:
Ok, I use a blackpill board as module.
This is my Diy board, here a bluepill but i use a blackpill.
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

I have build a board for my external box.
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
Witch pin i must to use for Rx (B10) and Tx(A3).

pascallanger, 2024-05-15:
It might just be easier to add a FTDI on your TX16S internal module...

pierrotm777, 2024-05-15:
Do you think that this _config.h file would be ok for my blackpill on my external tx16s ?
[Config.zip](https://github.com/pascallanger/DIY-Multiprotocol-TX-Module/files/15324047/Config.zip)

pascallanger, 2024-05-15:
From a quick review it looks good.

pierrotm777, 2024-05-15:
Ok, i shall try to update and adapt my module tomorrow.

Thanks for your help,

Pierre

pierrotm777, 2024-05-16:
Sorry Pascal,
I was very busy this day.
What I must define into my config file for build a FTDI debug version.
Tx to S-port pin and Rx to PPM_OUT pin.
I upload always my firmware with a FTDI module on pins a9/a10 and +5v/gnd.
I suppose that the debug uses these pins?

pascallanger, 2024-05-16:
It's not in the config file but in Arduino. Set Debug Option to FTDI.

pierrotm777, 2024-05-19:
Hello Pascal,

Sorry again for this delay.
I have some issue for have a firmware witch bind my hitec receiver.
Do i need to uncomment these two lines ?
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

I send you again my last config file.
[_Config.zip](https://github.com/pascallanger/DIY-Multiprotocol-TX-Module/files/15368765/_Config.zip)

For upload the firmware, i hold the BOOT button and power the module and i use my FTDI module for upload the firmware.
I connect well the A3 pin to S-Port and B10 to PPM_OUT pin.

But no bind :-(

pierrotm777, 2024-05-19:
I have tried also to use the flash_multi tool for upload my firmware with same result, no bind.
I have also tried the mm-stm-xn297dump-ftdidebug-v1.3.4.0.bin firmware.
No bind.

pascallanger, 2024-05-19:
What does the LED ?

pierrotm777, 2024-05-19:
The LED BLINK each 500ms i think.
I have tested my module with my DIY handset and my LED stay well to ON.
So my DIY handset see well that HITEC protocol is on the MPM module.
But on my TX16S, the LED blink always.

pierrotm777, 2024-05-19:
It's i invert my serial connection, my led is now ON and i can bind :-)
I continue now.

pierrotm777, 2024-05-19:
Bind is now ok, i can move a servo on my channel 3, but i haven't telemetry.
My stm32 haven't inverted serial port.
I have commented all telemetry defines:
//#define INVERT_TELEMETRY

//#define INVERT_TELEMETRY_TX

//#define MULTI_TELEMETRY

//#define MULTI_SYNC

pascallanger, 2024-05-19:
And the debug display, this is what's interresting for now...

pierrotm777, 2024-05-19:
[debug1_hitec.txt](https://github.com/pascallanger/DIY-Multiprotocol-TX-Module/files/15369154/debug1_hitec.txt)
This is my first debug file with RPM and FUEL sensors

pierrotm777, 2024-05-19:
My wiring for a bind ok is that:
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
But i don't receive telemetry  TRSS, TQly and RxBt as i can with the internal MPM module.

pierrotm777, 2024-05-19:
I receive also these infos:
Module Flash size: 128KB
EEPROM initialized: 0
Protocol selection switch reads as 0
Module Id: 3700705c
Init complete
Protocol selected: 0, sub proto 0, rxnum 0, option 255
Protocol selected: 39, sub proto 0, rxnum 0, option 0
Proto=Hitec, nbr_sub=3, Sub=Optima, Opt=2, FS=0, CHMap=0, rfSw=1

pierrotm777, 2024-05-20:
Hello,
Do you need other debug?
If I can help, say me how to do.
Pierre

pascallanger, 2024-05-21:
For the telemetry to work on the radio, you have to invert B10 with something like a simple transistor B=B10, C=SPORT, E=GND.
Exactly like on I2C, the data in your telemetry is full of zeros just the RXBatt value in frame 11.
Anyway, with what you get the radio should display plenty of sensors. You must do the sensors detection while the RX is powered and connected to the station.
The decoding of the frames is happening here in EdgeTX: https://github.com/EdgeTX/edgetx/blob/53c794da8cd3dcbc6d49597f642799a3c6d9d49b/radio/src/telemetry/hitec.cpp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
Since you had some telemetry values like RSSI and more displayed, it looks like everything works as expected. It is a matter of doing the sensors discovery with the station plugged (no need for sensors to be connected).
Are the telemetry frames coming at a good pace? You seem to miss quite a few which is most likely a bad tuning or too close from the RX.

pierrotm777, 2024-05-21:
The station and sensors seems well connected. I think to a Rx data input default.
I shall try to find another receiver for my tests.
Thanks for your help.

pascallanger, 2024-05-21:
The RX and station are well connected since you get the frames 11 and up, The RX alone send frame 10 only, this is where if you do the sensors detection at that time it won't work. Just that the sensors connected to it don't send anything. RPM being at zero is normal, you need to move a magnet in front of it to get values. I'm not sure what the fuel sensor is supposed to send by default but 0 looks like a good default value too.

pierrotm777, 2024-05-21:
I shall try to simulate a blade and look at if the rpm sensor return something.

pascallanger, 2024-05-21:
Yes you need to do that or you have 0 rpm...
But even with everything at zero, you should see on the radio plenty of sensors. At least that was the case on OpenTX, may be a bug has been introduced in EdgeTX but that would be strange since you have the RX batt from what you said. All I can think of is that you've done the sensors discovery before having the station correctly plugged.

pierrotm777, 2024-05-21:
I have some news.
If i use my DIY handset with a DIY MPM module (STM32 128K) i have this debug file.
[debug2_hitec.zip](https://github.com/pascallanger/DIY-Multiprotocol-TX-Module/files/15387353/debug2_hitec.zip)
As you can see, the frame seems not to 0 .
I do a new test with my TX16S and the same MPM module .

pierrotm777, 2024-05-21:
Same results with my DIY handset.

pierrotm777, 2024-05-21:
I don't understand why, but if i use again my internal module, i receive no all the telemetry (20 sensors).
But RPM stay to 0.
Very curious, may be the method for bind?
I don't know !

pierrotm777, 2024-05-21:
Please read :
I don't understand why, but if i use again my internal module, **i receive now all the telemetry (20 sensors**).

pierrotm777, 2024-05-21:
But now, i haven't a debug possibility :-( !

pascallanger, 2024-05-21:
I don't know what you want to debug on the module... The module does what it is supposed to do. The protocol is working as expected and forward the received telemetry to the radio to be decoded and displayed. So having debug is kind of useless really... I'm still unsure what you are looking for here... By the way, The TX16S internal module can run debug easily using a FTDI as mentioned earlier.
If you get no reading from your sensors it means that either you are not activating them (for example RPM, use a magnet in and out quickly and the rpm will appear) or the sensors are broken or there is a sensor cable issue or the station has an issue... But in the end it's not an issue with Multi or the radio.

pierrotm777, 2024-05-21:
My final goal is to build a telemetry simulator module for Hitec. But I didn't know if I had a handset issue or a problem with my telemetry simulator.
I know now that my problem is with my simulator module which don't return the good frames.

pascallanger, 2024-05-21:
Ok closing this thread then.

pierrotm777, 2024-05-21:
Yes, thanks again Pascal

Closed 2024-05-21.

Thread 978 (2024-05-15):

Qidi560 Bind and control issue

Kfreel2019, 2024-05-15:
Hello. There seems to be an issue with binding the Qidi560 to OpenTx using FX9630 protocol Bind seems semi successful as most controls respond normally. All lights flash rapidly, there has been no success in assigning a switch to control the lights.  With gyro off, plane idle and no input from Tx servos will randomly move at irregular intervals.  I have seen lights behave properly only when toggling Bind on tooff by pressing and holding "enter" button after achieving a new bind

I am a complete novice with RC in this aspect, I have a Jumper TLite if that's relevant

pascallanger, 2024-05-15:
Can you do the same servo test with the original transmitter? Just to be sure that it's not a behavior of the plane to move its servo on its own time to time.
I don't really understand what you are doing to get the lights to behave properly... Can you give all the steps like 1. power on the plane LEDs are blinking, 2. launch a bind on the radio LEDs stop blinking...

Kfreel2019, 2024-05-15:
I tried email response with videos but didn't work.
I connected the stock TX and had jo abnormal behaviors over a period of 5 minutes. Process to see lights work normally- tx on with bind ch selected ,plug in battery,  then select bind in reciever menu.(plane binds controls function properly lights flashing abnormally) at this point if you select bind the lights will act appropriately for approximately 1 sec before going dark and the bind refreshing. Note that when losing connection to the stock TX light go off immediately.

If its of any help if I could find and ship a stock Rx I will do so, though there is no listing kn BG or Ali for one at the moment.

pascallanger, 2024-05-15:
I've finally purchased this plane. One more... I just have too many I shouldn't have done it but... You are welcome if you want to make a small donation for it instead of your proposition of shipping the RX ;-)
So let's wait for the delivery end of next week.

pascallanger, 2024-05-16:
I've received the QIDI-560 TX.
I'm totally puzzled as there is a bug with the light function... From what I see if you long press once the "Function key" to change the LEDs pattern then the trims won't work correctly anymore. To test the bug, power on the radio and plane, change the trim on roll/aileron, you should see the effect of the trim on the ailerons, set back the roll/aileron trim to center, now long press the "Function button" until it beeps, try to change the trim on roll/aileron, you should see the trim effect on rudder now despite trying to adjust ailerons... Same goes with the rudder trim which you can't set anymore once you longed press that button.
Basically the long press on the light mess up the trims. And adjusting the rudder trim (and may be the elevator trim) will most likely affect the LEDs...
So now the thing is that I'm setting all the trims all the time and therefore it has a side effect of playing with the LEDs again and again. On their sides, they only send the trim that you are touching to the plane. So if you don't touch the trims nothing happens, you might just see something when playing with the trims.
Each time you press the rudder trim, it's like long pressing 2 times the function button which I don't know what it does on the LEDs.
Can you test my assumption on the trims bug before I start to implement something?

Basically, if I disable the trims for this plane, things should start to work. The DR channel of the QIDI 550 is the acrobatic feature (short press on function key) on this plane which is launched each time you toggle the associated switch.

Kfreel2019, 2024-05-16:
Yes, I will give it a go in about a half hour. Just got home from work and need to wash up.

pascallanger, 2024-05-16:
And I need to eat... I've already spent more than 3 hours in a raw wondering how I am going to deal with this bug...

Kfreel2019, 2024-05-16:
Yes I observe the same action. The rudder trims after turning the light off almost seem to aft as a rudder button. If you do a short press it will move and return to it's position. I tried setting the trims to switch's on my Jumper Lite- when toggling them the flash pattern of the lites change.

pascallanger, 2024-05-17:
Please test v1.3.4.9 available here: https://downloads.multi-module.org/latest-test/
I've added a new subprotocol under FX called Q560, check the channels assignment: https://github.com/pascallanger/DIY-Multiprotocol-TX-Module/blob/master/Protocols_Details.md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

Kfreel2019, 2024-05-17:
I will test when I get home from work(will be about 9 hours).  Other users have reported instability issues so TBH I haven't even put it in the air yet.

Also, thank you for working on this!

Kfreel2019, 2024-05-18:
So after struggling to figure out updating the firmware, (I did say I'm a novice, right?) It all looks good to go. Leds go on off, gyro switchs work, only had to reverse rudder.  I will be able to test fly on Sunday.  Thanks Pascal!

jwebber23, 2024-07-12:
Hi, i looked at the link and found version 1.3.4.10 but only had the version taer rather than the aetr that i normally have.  Will there be a test build in aetr or do i need to wait for the stable release update?

pascallanger, 2024-07-12:
Check again in the file it's there.... It's even the test version 1.3.4.11 since this issue has been completed

jwebber23, 2024-07-13:
Hi,
Sorry, yes it is there.  I was using the search in Windows 11 file browser and it was "helpfully" limiting the search results.

I have tried it and it all looks good.  I will have a fly tomorrow.

Thanks :-)

jwebber23, 2024-07-14:
All worked as expected.  Thanks again for your help.

mkfrcp, 2024-08-24:
Hi, I try to bind TX16S (4 in 1 mm) and my Qidi 560. I upgraded mm to 1.3.4.11 (TAER) and set FX560 protocol without success. As I've never use bind on channel before, I tried both bind on channel (CH16) an manual bind. It does'nt work at all. Of course, the original transmitter binds immediatly to the plane. Any idea?
Thks in advance for your help :)

pascallanger, 2024-08-24:
The protocol is FX and sub protocol Q560: https://github.com/pascallanger/DIY-Multiprotocol-TX-Module/blob/master/Protocols_Details.md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
Hitting the bind button or checking the bind on channel feature and assigning a switch to ch16 should get the bind going.
What's the module status on the radio?
Are you trims nearly centered?

mkfrcp, 2024-08-24:
The 4in1 module works fine with HoTT ou Frsky receivers.
Model memory is totally new (trims are centered).
When I hit the bind switch affected to CH16, "Binding" is shortly displayed on the screen but the plane is not responding.

pascallanger, 2024-08-24:
You need to maintain the bind switch pressed for a few seconds not just a short pulse. But I don't think it's the issue here.
Hott and frsky are using the cc2500 RF component. Do you have any planes using the nrf24l01?

mkfrcp, 2024-08-24:
I tried to maintain the switch a few seconds. No effect. Unfortunately, I don't have any plane using the nrf24l01 chip. The QIDI TX PCB is not equipped with a nrf24l01 but a CB2401. Based on the datasheet of this component, it is probably a clone of nrf24l01. Is there another test to do ?

mkfrcp, 2024-08-27:
Is there a way to test that the nrf24l01 chip built into the Radiomaster multimodule is working properly?

pascallanger, 2024-08-27:
CB2401 is a PA (power amplifier). They are using a XN297 core in the all in one MCU + RF chip.
No idea how to test the NRF without a model or putting it in debug mode...
Have you tried to bind in low power mode?

mkfrcp, 2024-08-27:
True !
Yes, I tried to bind in low power mode too. Without success.
I'll try to find a model and let you know.
Thks for your help.

alex97barth, 2024-12-12:
> Please test v1.3.4.9 available here: https://downloads.multi-module.org/latest-test/ I've added a new subprotocol under FX called Q560, check the channels assignment: https://github.com/pascallanger/DIY-Multiprotocol-TX-Module/blob/master/Protocols_Details.md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 It should address the lights. I have no idea if it had a link with the servo movements you've seen. I've also been reported that in 6G the plane would continuously do aerobatics, did you experience the same? I can't see why it would be the case since you need to change CH5 for the flag to be set/unset...

I am having the same issue: continually doing aerobatics in 6G mode. Channel 5 set to toggle flight modes. Channel 7 set to LED channel 6 has no efffect on flight modes.

pascallanger, 2024-12-12:
I'm flying with this plane every WE and all the members of my club have one too flying with Multi. No issues so this must be something you are doing.

alex97barth, 2024-12-15:
> I'm flying with this plane every WE and all the members of my club have one too flying with Multi. No issues so this must be something you are doing.

Thanks for letting me know. I will try again and check in. Has anyone had success with an external sbus receiver?

MeTeeZee, 2025-01-23:
> Please test v1.3.4.9 available here: https://downloads.multi-module.org/latest-test/ I've added a new subprotocol under FX called Q560, check the channels assignment: https://github.com/pascallanger/DIY-Multiprotocol-TX-Module/blob/master/Protocols_Details.md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

Hello, thank you for the work you do for this.  I was wondering when you might expect that the q560 sub_protocol will form part of the "latest stable" release. Many thanks, T

pascallanger, 2025-01-23:
> Hello, thank you for the work you do for this. I was wondering when you might expect that the q560 sub_protocol will form part of the "latest stable" release. Many thanks, T
When I'll be done with some of the protocols I'm working on right now.

Closed 2024-06-04.

Thread 1002 (2024-08-21):

Irangex nano pl18 edgetx 2.10.3

swemiklan, 2024-08-21:
Flasht edgetx  to pl18  ( no hardware mod ) installd new nano module and tryed to bind. no luck.
Edgetx show ( no multi telemetry detected ) in model page and radio information.
Flash module wiht 1.3.3.33 managede after some trubble dfu mode/ usb i can read firmware of module trou flashmulti 6,1
still no luck binding, sam text in edgetx.  Now i am not able to read module wiht flashmulti, module led are solid green and red slow blink.   Elrs module works fine.
Can i erase module in flashmulti when its not responding/ able to read module.  Other suggestions.
Bangood Note:
"The STM32 MCU have change to ARM, fireware is ARM CORTEX-M
The new stock will be ARM, Existing inventory is not affected"
Mikael

pascallanger, 2024-08-21:
Which module is it?

swemiklan, 2024-08-22:
IRangeX IRX4 LITE CC2500 NRF24L01+ A7105 CYRF6936 4 I 1 Multiprotokoll TX-modul för Frsky X-lite  from  bangood.

swemiklan, 2024-08-23:
Now module is back in order Thank to Benlye.
Module is not recogniced by tx  ( no multi telemetry detected ).
How do i continue troubleshoot multimodule  (serial conection ) ?
Elrs module is working in same adaptor.

swemiklan, 2024-08-23:
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

pascallanger, 2024-08-23:
What's the module LEDs doing ?

swemiklan, 2024-08-24:
Solid green and red blink.

swemiklan, 2024-08-24:
Does multimodule need more or other placement of serialport?
Nano adaptor has 3 wires and i have done conectivity test trou adaptor to inside module all good.
Nano adaptor works in radio wiht elrs module and radio works wiht jr adaptor and irangex plus module.

pascallanger, 2024-08-24:
You are not saying how the module blinks...
The module needs 4 wires to work: Ppm, telem, gnd, batt.

swemiklan, 2024-08-24:
Its green solid and red blink.
Ok now we getting som where, schematic on nano  and jr adapters i see 3 connections serialport to the right in adaptor where do fourth (ppm) go?
How can i compere jr bay pinout and nano pinout?
I need to trace out connetion to pl18.
I will start to google  Pinout,   THANKS ALOT  Mikael

swemiklan, 2024-08-24:
PPM from pl18  = found    ( compared wiht fjr2 )
Now where to put it in MPM lite pinout ?
https://www.rcgroups.com/forums/attachmentNew.php?attachmentid=11016912  is all i found, In jr its equivalent toNr5 Pxx out on Nano/lite pinout?    Shoud i solder wire to pin nr 5 in nano adapter to try out?

swemiklan, 2024-08-24:
So i tryed soldering wire from pin ppm/ RX in tx to pin 5  Pxx out in MPM and no difference.
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 This is Frm301 Connection to Pl18
Adaptor has 3 wires from sport, gnd and +5v to serialport, gnd and vcc in Mpm originaly and now + my wire now.
Is there a need for more wires in adaptor maybe between Head/tx to Pxx in also ?

swemiklan, 2024-08-24:
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
Found this at last.
point 1  Is  rouled out.
point 2 FW on radio and module seems correct , inverson setting in use probleby not different mpm works.
point 3 Foulty module hmmm how do i solve that issue?

Closed 2024-08-25.

Thread 1011 (2024-09-05):

Arduino Pro Mini build - Unable to put into PPM bind

eltesco1, 2024-09-05:
Hi There,

I have built a CC2500 only module for FRsky protocols. I have built the device and triple checked all connections. Device is in PPM mode switch position 1.
Device is on the bench, when i hold down the bind button (pin 13) and power on, i get no status LED (pin 13 via resistor) until i release the button and then all i get is a slow blink (No PPM signal i think). No Matter what i do i cannot get it into bind mode. It also seems i cannot get it into bank select (position 15) red just continues the slow blink.

I can turn the device to serial mode (get faster flashing LED (no serial input i think). However my radio is not yet compatible with the serial function.

Any ideas for tests i can do to find out why?

pascallanger, 2024-09-05:
When you hold down the bind button you short cut the LED which is why you don't get any information until you stop pressing it.
If the LED blinking pattern indicates no PPM or serial then the module won't do anything, no transmission is allowed and therefore binding can't happen.
The bank selection is only available if you have defined more than 1 bank in _config.h. The default builds and the config file by default have only 1 bank defined.

pascallanger, 2025-02-26:
No more requests so closing

Closed 2025-02-26.

Thread 1046 (2024-12-13):

Servo is not working properly with SLT2

AlexGigov, 2024-12-13:
Hello,
I have a strange servo behaviour on Losi Micro-B using Radiomaster Mt12 with an external Radiomaster 4in1 module with 1.3.4.12 test build firmware. The RX and TX bind together, but the servo is not smooth. The best I can describe it is as if the packet rate is not constant and there are micro cuts during the movement. I do not see a problem with the throttle. So far I have tried to change the inputs, frequency tuning and tested with different channel order but the issue persists.
With the original Spectrum SLT2 TX everything works smoothly.

Any idea what could solve the issue?

Thanks

Pencilvestr, 2025-01-01:
I think someone needs to send in an SLT2 RX/TX to fix these issues.

You can look at the original post I made for SLT2. I think its as good as it gets for the time being until someone donates

CDRaff, 2025-01-30:
How can I send one? Would you like one of the newer orange button ones that controls DSC too?

pascallanger, 2025-01-30:
Which protocol are you using for SLT2? There is no SLT2 protocol... Are you talking about the protocol SLT and subprotocol V1_4CH?
If that's the case, I need an original TX + RX (or car or whatever) to be sent to my attention in France.

pascallanger, 2025-02-21:
I could purchase a car set to get to the bottom of this issue but I need a little help as they all seem quite expensive...

pascallanger, 2025-02-21:
So if you are ok to do some donation(s) let me know.

Gaz-B, 2025-02-24:
> I’ve encountered the exact same problem with my Mojave GROM, which comes with a 2-in-1 receiver with ‘SLT’ symbol on it. My MT 12 tx successfully bound with the receiver with ‘SLT’-‘V1_4CH’ (fw v1.3.4.31 and only successful with this protocol), but the steering is not as smooth as when it was bound with the original tx. Hope this issue could be solved in the future. Thanks a lot.

I don't know if you've tried but the Gyro DSC ?. Can you adjust this with the MT12 ?.

Gaz-B, 2025-02-24:
> I could purchase a car set to get to the bottom of this issue but I need a little help as they all seem quite expensive...

There are some TX RX combos removed from cars at quite reasonable prices. Would having one of these deffo get the issue resolved. https://www.ebay.co.uk/itm/276839217240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

Gaz-B, 2025-02-24:
> I’ve encountered the exact same problem with my Mojave GROM, which comes with a 2-in-1 receiver with ‘SLT’ symbol on it. My MT 12 tx successfully bound with the receiver with ‘SLT’-‘V1_4CH’ (fw v1.3.4.31 and only successful with this protocol), but the steering is not as smooth as when it was bound with the original tx. Hope this issue could be solved in the future. Thanks a lot.

Now you have it working are you able to adjust the gyro DSC ?.

Pencilvestr, 2025-02-24:
I'll donate for a car / just the RX/TX set if either will work. Let me know.

pascallanger, 2025-02-24:
I've found a TX + Rx set for 30€ + 5€ shipping on the local second hand market: https://www.leboncoin.fr/ad/modelisme/2910782924
Are you ok to donate for the purchase?

What does gyro DSC mean? Is that something you can set from the radio?

Pencilvestr, 2025-02-24:
Donated 15usd, hopefully someone else can help cover the rest

Gaz-B, 2025-02-24:
DSC. Digital Stability Control. You alter the gyro gain by putting full right steering and then pressing the TX power button. I don't get my car until tomorrow so can start playing then but as it's only a 2ch radio I'm starting to wonder if getting full functions with another radio is even achievable.

________________________________
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

Gaz-B, 2025-02-24:
This is the full manual to the Brushed unit in your link they don't seen to do one for the brushless but the radio function DSC ETC all seem to be identical. https://www.horizonhobby.com/on/demandware.static/-/Sites-horizon-master/default/dw8aae40b5/Manuals/SPMXSER1025_MANUAL_EN.pdf
Spektrum Firma 25A Brushed Smart ESC Spektrum Firma 25A gebürsteter - Horizon Hobby<https://www.horizonhobby.com/on/demandware.static/-/Sites-horizon-master/default/dw8aae40b5/Manuals/SPMXSER1025_MANUAL_EN.pdf>
4 Waterproof Component Your new Horizon Hobby® Spektrum™ 25A Brushed Waterproof 2-in-1 ESC and Dual Protocol Receiver has been designed and built to allow you to operate the product in many “wet conditions”,
www.horizonhobby.com

________________________________
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

yinglong, 2025-02-25:
> > I’ve encountered the exact same problem with my Mojave GROM, which comes with a 2-in-1 receiver with ‘SLT’ symbol on it. My MT 12 tx successfully bound with the receiver with ‘SLT’-‘V1_4CH’ (fw v1.3.4.31 and only successful with this protocol), but the steering is not as smooth as when it was bound with the original tx. Hope this issue could be solved in the future. Thanks a lot.
>
> Now you have it working are you able to adjust the gyro DSC ?
Haven’t dug into that yet. But my guess is that the dsc should be implemented as a dedicated channel(CH 3?).

Gaz-B, 2025-02-25:
[yinglong] The Transmitter and receiver is two channel only. This I believe is why changing DSC profiles is done with full lock and pressing the power button. I was expecting the same as you then started reading in more detail.

pascallanger, 2025-02-25:
I don't see anything about DSC in the documentation you linked... I'm not even sure which RX/ESC I'm going to get if I purchase the set I linked earlier...

Gaz-B, 2025-02-25:
> I don't see anything about DSC in the documentation you linked... I'm not even sure which RX/ESC I'm going to get if I purchase the set I linked earlier...

My mistake that seems to be a Brushless only feature. I should have sent this manual.  https://www.arrma-rc.com/on/demandware.static/-/Sites-horizon-master/default/dw4bd747f2/Manuals/ARA2306_MANUAL_ML.pdf

pascallanger, 2025-02-25:
Can you try the latest [test version](https://nightly.link/pascallanger/DIY-Multiprotocol-TX-Module/workflows/main/master/multi-test-build.zip) v1.3.4.36?

pascallanger, 2025-02-25:
They indicate that the SLT2 transmitter is different being SLT2 DSC on this brushless version. So no idea what changes they have made...
The TX sends 4 channels even if they say 2. So may be the gyro mode is on one of the other 2 channels. To be tested.

Gaz-B, 2025-02-25:
> Can you try the latest [test version](https://nightly.link/pascallanger/DIY-Multiprotocol-TX-Module/workflows/main/master/multi-test-build.zip) v1.3.4.36?

😁😁👌👍👏 Great success Held the power button for 3 secs and instant auto bind. Steering seems smooth I never saw what the previous versions were like as I only just picked up the car new and fitted a battery plug. DSC is on ch4 I've put it on a knob ranging -35 off to 15 full.  It seems the stock DSC command of right steering and power press sets the output value of CH4 as it can be done with the car off.

pascallanger, 2025-02-25:
Can you test with the latest release to compare ? If everything runs smooth on 1.3.4.36, the issue is really the TX ID vs RF frequencies. In this version you are locked down to only the ID of @Pencilvestr 's radio. Let's try to see if we can get more than 1 ID working to prevent accidents of controlling other cars...

Gaz-B, 2025-02-25:
If I use 1.3.4.31 With my ID 50 17 6F 22 No bind with ID 65 50 FE 30 it binds but choppy steering. With 1.3.4.37 with my original ID 50 17 6F 22  still no bind.

CDRaff, 2025-02-25:
Feels rock solid to me now. I was on the 1.3.4.25 prerelease and it felt kinda wonky, a little jittery and a little laggy; now it feels rock solid. Tested on the SPMXSE2625RX found in the brushed Mojave Grom, the SPMXSBER1025G found in the brushless Typhon Grom BLX, the SPMXSE4510RX found in the Fury 223s, and the SPMXSE2825RX found in the Losi Micro-B.

@Gaz-B great job sussing out the DSC settings. I had been goofing with it, and found that little spot on channel 4 that would enable it, but I was too dumb to think to change the channel min/max to fine tune it. Works on both the SPMXSBER1025G and the SPMXSE4510RX.

Also will be donating this coming week; we had previously discussed me trying to get a esc and receiver to you, but my wife got sick with a gallbladder thing so it side tracked me for a bit, but we're all back in order now and I'll be able to send a chunk of change off to you to help you get some gear. Thanks a ton for all the hard work you are putting in.

pascallanger, 2025-02-25:
@CDRaff Can you try all the receiver numbers from 0 to 63 with this new [test version ](https://nightly.link/pascallanger/DIY-Multiprotocol-TX-Module/workflows/main/master/multi-test-build.zip)1.3.4.37 and let me know which ones are working or not?
You will need to rebind for each receiver number, check the LED for flickering and steering smoothness.

CDRaff, 2025-02-25:
Just edited my comment, but it was based off the 1.3.4.36 not .37. Will test .37 and will expand beyond the first few receiver numbers. When testing on .36 I had gone to receiver 04 and found that they were all working no matter what receiver I was using.

CDRaff, 2025-02-25:
Ok tested receivers 00-60 on the SPMXSE2825RX(Losi Micro-B) and on the SPMXSBER1025G(Typhon Grom BLX 223s) and both work well on every receiver. Every once in a while I would hit a receiver number that would initially act wonky when first bound, but power cycling the car fixed it every time so that may have just been caused because I was binding over and over again.

I'll test the SPMXSE2625RX and the SPMXSE4510RX tonight when I get some free time.

pascallanger, 2025-02-25:
That looks promising! I think it will work fine on the other receivers. Instead, can you try the receiver numbers on v1.3.4.38 ?

CDRaff, 2025-02-25:
Yes I can. As soon as I have some free time I'll jump on it.

Gaz-B, 2025-02-25:
I just tried all 60 the ones that weren't happy were 14,25,36,57, Very sluggish and jittery steering.

pascallanger, 2025-02-25:
> I just tried all 60 the ones that weren't happy were 14,25,36,57, Very sluggish and jittery steering.

Which version ? Have you power cycled the model like @CDRaff indicated earlier?

pascallanger, 2025-02-25:
Great 👍 Can you try the receiver numbers on v1.3.4.38?

Gaz-B, 2025-02-25:
> [@Gaz-B](https://github.com/Gaz-B) Great 👍 Can you try the receiver numbers on v1.3.4.38?

What exactly am I looking for as on retest 37 seems faultless.

Gaz-B, 2025-02-25:
v1.3.4.38 All 60 working a couple stumbled on first bind power cycle sorted them. I did notice on some flickered the blue led for a couple of secs then sorted themselves before I could try a power cycle. Stumbles were on 25,28,30,44.

pascallanger, 2025-02-25:
> > [@Gaz-B](https://github.com/Gaz-B) Great 👍 Can you try the receiver numbers on v1.3.4.38?
>
> What exactly am I looking for as on retest 37 seems faultless.

I'm trying to figure out the IDs versus frequencies. Right now, you've confirmed that I can generate 64 good pairs. I usually don't stop there and try to get more. If I implement only these 64 IDs, you have 1 chance in 64 to have a conflict if someone uses a multi module nearby and that gets worse if there are more of them around you.
I don't have a RX so I can't test myself... I usually spend endless hours trying this kind of things so that you don't have to worry about conflicts. Here I'm trying to reduce the number of tests by changing some parameters which I think would work but I need the confirmation.
But if you think that's useless, I stop here. I don't have a SLT2 receiver and probably won't own one so up to you.

CDRaff, 2025-02-25:
Tested 0-63 on firmware 1.3.4.3.8 on both the SPMXSE2825RX(Losi Micro-B) and the SPMXSBER1025G(Typhon Grom BLX 223s) and both were working well with all errors being sorted after power cycling. There was a bit of a longer hangup on receiver 19 when binding to the SPMXSBER1025G, but it eventually sorted itself out.

Gaz-B, 2025-02-25:
I don't mind testing it's just I couldn't see any change so had no idea if it was helping. I'm so used to having to bind the Losi promoto with every battery this now seems well sorted 🤣.

pascallanger, 2025-02-25:
Ok hopefully last try with v1.3.4.39 which is using partly your module ID. If you both @CDRaff and @Gaz-B and may be others try once more receiver numbers between 0 to 63. If it works I call it done.

The Losi Promoto is on my list to address soon as I do have access to one nearby.

pascallanger, 2025-02-25:
@Gaz-B, I would like to update the documentation with your findings on the DSC settings.
Do you have the values for the different modes? Or should I just indicate "CH4 is used for DSC settings: -35% off to +15% full"

Gaz-B, 2025-02-25:
> [@Gaz-B](https://github.com/Gaz-B), I would like to update the documentation with your findings on the DSC settings. Do you have the values for the different modes? Or should I just indicate "CH4 is used for DSC settings: -35% off to +15% full"

Those are the figures that appear to be right. Not easy to be sure but that seems to cover off to full gyro action. I have no means to measure what the CH4 output pulses are on the stock radio.

Gaz-B, 2025-02-25:
> The Losi Promoto is on my list to address soon as I do have access to one nearby. That is exciting news I know a few are doing like me and rebinding with every battery.

pascallanger, 2025-02-25:
Oh you mean that it's proportional from -35% to 15% ? The documentation you shared earlier kind of indicate that there was only 4/5 steps.

Gaz-B, 2025-02-25:
> Oh you mean that it's proportional from -35% to 15% ? The documentation you shared earlier kind of indicate that there was only 4/5 steps.

Yes the stock radio is changed by full right steering and push the power button with with each press cycles from 1 to 4 beeps. 1 being off and 4 being max. My guess is they set  ch4 to preset outputs the receiver doesn't even need to be on. When the car is linked it just sees the set position.

Gaz-B, 2025-02-26:
1.3.4.39 all 63 slots working three needed a power cycle and were fine after.

Gaz-B, 2025-02-26:
> Tested all 64 receivers on v1.3.4.39 on both SPMXSE2825RX(Losi Micro-B) and SPMXSBER1025G(Typhon Grom BLX 223s) and everything is still working fine.
>
> Also as for the DSC control note I think what your planned "CH4 is used for DSC settings: -35% off to +15% full" is good. Maybe include the pulse width length in microseconds(from 1321µs to 1577µs) as well?

Do those figures seem right on your BLX grom too ?. I only picked mine up today so this testing is all it's done so far.

CDRaff, 2025-02-26:
Yes they seem like the right numbers on both the Typhon Grom 223s and the Fury 223s.

pascallanger, 2025-02-26:
Ok, I've cleaned up the code and updated the documentation. Let's close this issue.

Closed 2025-02-26.

Thread 1048 (2024-12-18):

New protocol for JJRC H36 (yet another)

Tikju, 2024-12-18:
Hello Pascal,

I just purchased a brand new JJRC H36 from Aliexpress and was hoping to bind it using the IRangeX IRX4+ with either the MJQx -> E010 or the E010 R5 protocols. Unfortunately, neither of them worked (despite trying different frequency fine tuning settings). I am thus assuming that the current version of the H36 comes with yet another new procotol that is not supported by Multi Module, yet. The board on my drone reads JR-NH010R9.

I also found this discussion on rcgroups that suggests the same: https://www.rcgroups.com/forums/showthread.php?4554145-New-version-of-the-JJRC-H36-%28E010-or-NH010%29

Would you be willing to attempt reverse-engineering this new protocol? What kind of information / support would you need from my side?

Thanks a lot in advance and best regards!
Tobias

Tikju, 2025-01-19:
[H36_dump.txt](https://github.com/user-attachments/files/18468178/H36_dump.txt)

Small update: I just made an XN297 Dump with the IRX4+ (see attachment). Would this be sufficient for figuring out the protocol?

pascallanger, 2025-01-19:
This is a good start but I need more dumps to try to understand this protocol.
First use the latest XN297Dump protocol version that you can find in the test build https://downloads.multi-module.org/latest-test/
Please run the following dumps in Auto mode:
 - Capture the original TX in bind mode
 - Capture the original TX in normal mode
   - at the end when identify sticks appear, move slowly (really slowly) the following channels A E T R and then press the feature buttons in a specific order that you'll write down and paste here.

Tikju, 2025-01-19:
Thanks a lot for these instructions!

Here are the logs for the different channels and modes:
[H36 Dump.zip](https://github.com/user-attachments/files/18470265/H36.Dump.zip)

If something is missing or I can test further things, let me know!

Tikju, 2025-01-27:
Cool, thanks for looking into it!

You need to go from 0 to +100% throttle (TX beeps once) then to -100% (beeps again, drone flashes to indicate that it's bound).

pascallanger, 2025-01-27:
XN297, address length=5, bitrate=1M, Scrambled

Bind
---
RF channel: 50
Timing: 2065µs,3085µs,10285µs...
Address: CC 6C 47 90 53

Packet
P(13): 2E BC 00 11 00 36 3A 31 2B 00 00 00 ED
P[0] = 2E ? TXID or just start?
P[1] = most likely a crc
P[2] = TXID[0]?
P[3] = TXID[1]?
P[4] = TXID[2]?
P[5] = RF[0]=54
P[6] = RF[1]=58
P[7] = RF[2]=49
P[8] = RF[3]=43
P[9] = 00 ?
P[10] = 00 ?
P[11] = 00 ?
P[12] = ED ? bind ?

Normal
---
RF channel: 43, 49, 54, 58
Timing:
- each channel is sent 4 times 1830µs,3085µs,3085µs
- switch from one channel to the next 18500µs, so 10500µs between end of channel n and channel n+1

Address: CC 6C 47 90 53 => same as bind

Packet
P(13): 2E 54 00 11 00 7E 80 80 80 00 20 20 60
P[0] = 2E ? TXID or just start?
P[1] = most likely a crc
P[2] = TXID[0]?
P[3] = TXID[1]?
P[4] = TXID[2]?
P[5] =
P[6] =
P[7] =
P[8] =
P[9] =
P[10] =
P[11] = Trim E 02..20..3E
P[12] =

pascallanger, 2025-01-27:
I'm confused by how you name the sticks...
Left<->right is aileron, correct?
Azimuth is rudder, correct?
Forward<->backward is elevator, correct?

Tikju, 2025-01-27:
Yes, right. I didn't know how they are typically called for drones. :)

pascallanger, 2025-01-27:
I'm trying to figure out the crc right now...

pascallanger, 2025-01-28:
Ok I've got the crc figured out... Took me a lot of hours (4+) for something in the end relatively easy...
From there I can code the protocol.

pascallanger, 2025-01-28:
Please try the [test version](https://nightly.link/pascallanger/DIY-Multiprotocol-TX-Module/workflows/main/master/multi-test-build.zip) 1.3.4.25 protocol H36, documentation: https://github.com/pascallanger/DIY-Multiprotocol-TX-Module/blob/master/Protocols_Details.md#h36---103

If you set the receiver number to 0 (default) it will use your original TX ID as a test to make sure everything works fine (some channels might be reversed, I didn't pay attention...). But if you increase the RX number it will use your radio ID.
Can you try different values of RX number and see if it works?

Tikju, 2025-01-28:
Wow, good work! Everything works absolutely perfectly out of the box. I tried a few different RX numbers between 0 and 63 and was able to rebind with all of them.

Also, all the channels are correct, I did have to reverse anything. Regarding the speed mode, I am assuming that it always uses the faster one now and I could reduce the channel weights myself in Edge TX if I wanted the drone to be slower, right?

In any case: Thanks a lot for your effort!

pascallanger, 2025-01-28:
> Regarding the speed mode, I am assuming that it always uses the faster one now and I could reduce the channel weights myself in Edge TX if I wanted the drone to be slower, right?

Yes... I usually set the rate to high with all the models since you can control everything on the radio side like adding expo or dual rate which is better than just low rate.

> Thanks a lot for your effort!

If you appreciate my work and want to offer me a beer, here is the page: https://github.com/pascallanger/DIY-Multiprotocol-TX-Module/blob/master/docs/Donations.md

Closed 2025-02-26.

Thread 1054 (2025-01-04):

Eachine EAT15 car support?

yarda, 2025-01-04:
In the recent firmware 1.3.4.0 the EAT14 support was added (XK/cars). Any chance to add support for the quite popular EAT15 car (also known as UDIRC UD1603)?

pascallanger, 2025-01-19:
Without access to one of these cars I can't really do anything...
2 options:
 - you send me the original TX and car
 - you sponsor the purchase of one car

pascallanger, 2025-01-20:
You can use your multi module to scan and possibly listen packets over the air using a debug firmware and the XN297Dump protocol like on this other issue: https://github.com/pascallanger/DIY-Multiprotocol-TX-Module/issues/1048#issuecomment-2601004104

yarda, 2025-01-20:
Thanks for the tip, I didn't know it.

pascallanger, 2025-01-20:
https://github.com/pascallanger/DIY-Multiprotocol-TX-Module/blob/master/docs/Advanced_XN297Ldump.md

yarda, 2025-02-10:
I had trouble to flash the debug firmware from the release [mm-stm-xn297dump-ftdidebug-v1.3.4.0.bin](https://github.com/pascallanger/DIY-Multiprotocol-TX-Module/releases/download/v1.3.4.0/mm-stm-xn297dump-ftdidebug-v1.3.4.0.bin). On the radio it shows error:
```
NEEDS FILE
opentx-inv
```
The other firmwares from the release flashed and worked OK, including the usbdebug variant. Unfortunately, my module doesn't have connected USB lines to the STM32 and there is built-in CP2102 bridge, so I need the FTDI debug firmware variant.

I will try to compile it myself

benlye, 2025-02-10:
@yarda we currently don't have a way to compile an FTDI debug image which can be flashed from the radio. I'm working on it but have a few issues to resolve in the build process first.

For now you have two options:
1. Use the file attached to [this comment](https://github.com/pascallanger/DIY-Multiprotocol-TX-Module/issues/1069#issuecomment-2642516360), which can be flashed from the radio
2. Assuming you have an external module - it sounds like you do - upload the firmware using the [Flash Multi](https://github.com/benlye/flash-multi) tool

yarda, 2025-02-10:
> [@yarda](https://github.com/yarda) we currently don't have a way to compile an FTDI debug image which can be flashed from the radio. I'm working on it but have a few issues to resolve in the build process first.
>
I was tempted to flash the ftdi debug firmware from the release through the USB adaptor, but I discarded this idea due to the failed firmware check in the radio. Maybe it could be also mentioned in the readme.

yarda, 2025-02-12:
The protocol seems pretty easy, channel 45, 250k:
```
P: 08 WW TT SS LL 00 00 00 00 GG EE DD PP 00 CC

WW - steering wheel, 00 - min, 64 - idle, C8 - full
TT - throttle/break , 00 - min, 64 - idle, C8 - full
SS - speed mode, 00 - min speed, 64 - middle speed, C8 - full speed
LL - light switch, 00 - idle, C8 - pressed
GG - gyro, 00 - min, C8 - max
EE - steering trim, 00 - min, C8 - max
DD - steering dual rate, 00 - min, C8 - max
PP - reverse switches, 00 - all normal, 40 - throttle reversed, 80 - steering reversed
CC - checksum, just sum bytes 0 - 13

Example packet:
P: 08 64 64 00 00 00 00 00 00 00 34 4F 00 00 53
```

I need to capture the bind sequence,  I had some trouble with it, maybe it is (I am not 100 % sure):
```
250K C=45 Enhanced pid=3 S=Y A= F6 96 01 00 81 P(0)=
```

It seems it has also telemetry built-in and probably returns car battery status to the remote, but currently I have no idea how to reverse it.

yarda, 2025-02-12:
I don't know whether it sticks to channel 45 or can autoselect different channel e.g. in case it's used/noisy, I tried several times and every time I got channel 45 (I will also recheck). It seems there is no hopping.

yarda, 2025-02-12:
The model is autobound each time the model and remote is switched on.

yarda, 2025-02-12:
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
If power on the car (not the TX) I dumped nothing. If I power on the TX (not the car), I also dumped nothing. If I explicitly listen on channel 45 and power both the car and the TX I got the following:
```
Channel=45,0x2D
RX:     0us C=45 Enhanced pid=1 S=Y A= F6 96 01 00 81 P(0)=
```

yarda, 2025-02-13:
It seems the channel can change, after dozens dumps (steps are: power on the car and TX, control the car, power off the car), I got the following:
```
Proto=XN297DP, nbr_sub=7, Sub=Auto  , Opt=8, FS=0, CHMap=0, rfSw=2
------------------------
Detecting XN297 packets.
XN297 dump, address length=5, bitrate=250K
Trying RF channel: 0,1,2,3,4,5,6,7,8,9,10,11,12,13,14,15,16,17,18,19,20,21,22,23,24,25,26,27,28,29,30,31,32,33,34,35,36,37,38,39,40,41,42,43,44,45,46,47,48,49,50,51,52

Packet detected: bitrate=Using NRF
250K C=52 Enhanced pid=3 S=Y A= F6 96 01 00 81 P(15)= 08 64 64 00 00 00 00 00 00 00 34 4F 00 00 53
--------------------------------
Identifying all RF channels in use.
Trying RF channel: 0,1,2,3,4,5,6,7,8,9,10,11,12,13,14,15,16,17,18,19,20,21,22,23,24,25,26,27,28,29,30,31,32,33,34,35,36,37,38,39,40,41,42,43,44,45
RX on channel: 45, Time:     0us P: 08 64 64 00 00 00 00 00 00 00 34 50 00 00 54
Trying RF channel: ,46,47,48,49,50,51,52,53,54,55,56,57,58
RX on channel: 58, Time:     0us P: 08 64 64 00 00 00 00 00 00 00 34 4F 00 00 53
Trying RF channel: ,59
RX on channel: 59, Time:     0us P: 08 64 64 00 00 00 00 00 00 00 34 50 00 00 54
RX on channel: 59, Time: 11597us P: 08 64 64 00 00 00 00 00 00 00 34 50 00 00 54
RX on channel: 59, Time: 343156us P: 08 64 64 00 00 00 00 00 00 00 34 50 00 00 54
RX on channel: 59, Time: 26351us P: 08 64 64 00 00 00 00 00 00 00 34 50 00 00 54
Trying RF channel: ,60,61,62,63,64,65,66
RX on channel: 66, Time:     0us P: 08 64 64 00 00 00 00 00 00 00 34 4F 00 00 53
Trying RF channel: ,67
RX on channel: 67, Time:     0us P: 08 64 64 00 00 00 00 00 00 00 34 4F 00 00 53
RX on channel: 67, Time: 11676us P: 08 64 64 00 00 00 00 00 00 00 34 50 00 00 54
Trying RF channel: ,68,69,70,71,72,73,74,75,76,77,78,79,80,81,82,83,84

5 RF channels identified: 45[1] 58[1] 59[4] 66[1] 67[2]
Keeping only RF channels with more than 2 packets: 59* 67
--------------------------------
Identifying RF channels order.
Time between CH:59 and CH:59
Time: 47887us
Time between CH:59 and CH:67
Time: 240789us

Channel order:
59:     0us
59: 47887us
67: 240789us

--------------------------------
Identifying Sticks and features.
P: 08 64 64 00 00 00 00 00 00 00 34 50 00 00 54
P: 08 64 64 00 00 00 00 00 00 00 34 4F 00 00 53
P: 08 64 64 00 00 00 00 00 00 00 34 50 00 00 54
```
I am not sure what the channel 67 is, noise, interference (remotes too close)? But it's now probably on channel 59.

pascallanger, 2025-02-13:
> The protocol seems pretty easy

Correction the packet structure is usually easy. The difficult part is usually the ID and associated RF frequencies(y), bind negotiation and sometimes timing.

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

That's a good start.

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

It's not a bind packet...

> It seems it has also telemetry built-in and probably returns car battery status to the remote, but currently I have no idea how to reverse it.

You are not sharing any dumps so can't see anything of what's really going on or help...

> I don't know whether it sticks to channel 45 or can autoselect different channel e.g. in case it's used/noisy, I tried several times and every time I got channel 45 (I will also recheck). It seems there is no hopping.

It can't autoselect... There must be a negotiation or pre established frequencies that are switched to in case of interferences.

>The model is autobound each time the model and remote is switched on.

That's a wild statement. I'm wondering how you can be sure of that...

> If I powered on the car (not the TX) I dumped nothing. If I powered on the TX (not the car), I also dumped nothing.

You are not saying what you do to "dump". But I can tell you that either the TX or the car is sending something.

> If I explicitly listen on channel 45 and power both the car and the TX I got the following:
>Channel=45,0x2D RX:     0us C=45 Enhanced pid=1 S=Y A= F6 96 01 00 81 P(0)=
>So IMHO the address is F6 96 01 00 81.

That's not a bind packet or anything useful

> It seems the channel can change, after dozens dumps (steps are: power on the car and TX, control the car, power off the car), I got the following:

The frequency change might be due to a detected interference

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

First time you are sharing what you are seeing. The output timing on channel 59 is not consistent and a really low packet rate. So something is not right.

pascallanger, 2025-02-13:
First, few questions:
- What does the documentation state about the bind/pairing process? Any specific action(s) on the TX or the car?
- How long does it take for the link to be established between the TX and the car?
- Does the TX report that the car is powered on? LED pattern?

Ok so let's capture the bind packet first to see the content:
1. Turn on only the original TX
2. Set the XN297DP protocol and sub protocol 250K
3. Scan manually all the frequencies from 0 to 84 waiting a ten seconds or more on each channel.
4. If something appears on a channel let it run and post the result here to see the packets and timing. In any case, packets appearing or not continue to scan manually all the channels from 0 to 84.
5. Redo step 2 to 4 with the original TX off and the car on.

yarda, 2025-02-13:
Thanks for the reply and tips.

> First time you are sharing what you are seeing. The output timing on channel 59 is not consistent and a really low packet rate. So something is not right.

I guess channel 59 can be interference, I did the dump when the remotes were cca. 50 cm far apart. If they were cca. 2 meters far I was seeing only channel 45. I will retry multiple times to be sure here. I don't have anything more at the moment, all the dumps were similar as the one I provided and didn't reveal anything more (apart the sticks mapping).

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
Manual quote: After the car power is turned on, the transmitter and the car will carry out automatic frequency matching. When the indicator light of the transmitter and the car lights are always on, the frequency matching is successful. In the process of frequency matching, the car lights will flash rapidly. At this time, the gyroscope is being calibrated automatically. Please place the car on the level ground to complete this operation. After calibration, the car lights return to normal.

Full manual for the reference (it's for UDIR 1601, but IMHO it's the same car, I will recheck with the EAT-15 original manual when at home):
https://udirc.com/wp-content/uploads/UD1601-guide-V2.pdf

>
>     * How long does it take for the link to be established between the TX and the car?
>
cca. less than 2 seconds, I will measure it precisely

>     * Does the TX report that the car is powered on? LED pattern?
>
yes and also the car battery status
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
OK, thanks for the tip, I will try the manual scan, that's the only thing I haven't done yet.

pascallanger, 2025-02-13:
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

There are things you didn't share like the output of channel 45 with the car telemetry.
The time between packets is always displayed and this information is fully missing apart from the last post.
On the only shared dump you can see that none of the channels have a large number of RX which is "strange". I can't compare with how the packets are normally being sent when the car is also on since it's not shared.

> > * How long does it take for the link to be established between the TX and the car?
> cca. less than 2 seconds, I will measure it precisely
That could mean that the bind packets are sent every second or 2 seconds. Which is why you miss them with a quick scan.

> OK, thanks for the tip, I will try the manual scan, that's the only thing I haven't done yet.

Please post dumps of the **slow** manual scan of the tx on only, car on only, and both car and tx on. That will give hopefully a picture of what's going on.

yarda, 2025-02-15:
It's the first time I am using the MULTI-Module dump feature and I am still learning, so please be patient :)

I like the project, so I sent a small PayPal donation according to my possibilities, get a beer or two on me :)

I can confirm the EAT-15 manual is nearly the same to what I linked. In the EAT-15 printed manual some pages are reordered and formatting differs, but the information there is the same, including the text about the frequency matching which is literally the same. The radio and HW seems to be the same on all cars labeled UD1601-UD1608  / PRO variant (and probably also the SG1603-SG1604 variants and maybe others). The only visible difference on the cars is probably the different body shell and different shock tower assembly, but this can be easily cross replaced.

I measured time of the bind process. It usually takes cca. 1 - 2 seconds. The transmitter knows if the car is switched on and in range and if the battery level on the car is OK, this is signaled on the transmitter.

Dump of the manual channel scan, at least 10 seconds on the channel (usually more), transmitter (TRX) on, car off, not bound:
```
Protocol selected: 63, sub proto 0, rxnum 0, option 0
XN297 dump, address length=5, bitrate=250K
Proto=XN297DP, nbr_sub=7, Sub=250Kbps, Opt=8, FS=0, CHMap=0, rfSw=2
Channel=0,0x00
Channel=1,0x01
Channel=0,0x00
Channel=1,0x01
Channel=2,0x02
Channel=3,0x03
Channel=4,0x04
Channel=5,0x05
Channel=6,0x06
Channel=7,0x07
Channel=8,0x08
Channel=9,0x09
Channel=10,0x0A
Channel=11,0x0B
Channel=12,0x0C
RX:     0us C=12 Bad CRC
Channel=13,0x0D
Channel=14,0x0E
Channel=15,0x0F
Channel=16,0x10
Channel=17,0x11
Channel=18,0x12
RX:     0us C=18 Bad CRC
Channel=19,0x13
Channel=20,0x14
Channel=21,0x15
RX:     0us C=21 Bad CRC
Channel=22,0x16
Channel=23,0x17
RX:     0us C=23 Bad CRC
Channel=24,0x18
Channel=25,0x19
Channel=26,0x1A
Channel=27,0x1B
Channel=28,0x1C
Channel=29,0x1D
Channel=30,0x1E
Channel=31,0x1F
Channel=32,0x20
Channel=33,0x21
Channel=34,0x22
Channel=35,0x23
RX:     0us C=35 Bad CRC
Channel=36,0x24
Channel=37,0x25
Channel=38,0x26
Channel=39,0x27
Channel=40,0x28
Channel=41,0x29
Channel=42,0x2A
RX:     0us C=42 Bad CRC
RX: 111843732us C=42 Bad CRC
RX: 304134us C=42 Bad CRC
RX: 112974381us C=42 Bad CRC
RX: 695590us C=42 Bad CRC
RX: 113361919us C=42 Bad CRC
RX: 1469221us C=42 Bad CRC
RX: 113796368us C=42 Bad CRC
RX: 3097612us C=42 Bad CRC
RX: 114166952us C=42 Bad CRC
RX: 4300949us C=42 Bad CRC
RX: 114204779us C=42 Bad CRC
RX: 5398540us C=42 Bad CRC
RX: 114268864us C=42 Bad CRC
RX: 6963087us C=42 Bad CRC
RX: 116293868us C=42 Bad CRC
RX: 6989397us C=42 Bad CRC
RX: 116650037us C=42 Bad CRC
RX: 8955621us C=42 Bad CRC
RX: 117457141us C=42 Bad CRC
RX: 9347786us C=42 Bad CRC
RX: 118235622us C=42 Bad CRC
RX: 10116749us C=42 Bad CRC
RX: 118316290us C=42 Bad CRC
RX: 10836509us C=42 Enhanced pid=1 S=Y A= F6 96 01 00 81 P(15)= 08 64 64 00 00 00 00 00 00 00 32 A4 00 00 A6
RX: 59582us C=42 Bad CRC
RX: 129888808us C=42 Bad CRC
RX: 458120us C=42 Bad CRC
RX: 130307346us C=42 Bad CRC
RX: 1244199us C=42 Bad CRC
RX: 131177429us C=42 Bad CRC
RX: 1651551us C=42 Bad CRC
RX: 131495781us C=42 Bad CRC
RX: 2881383us C=42 Bad CRC
RX: 132281247us C=42 Bad CRC
RX: 3321447us C=42 Bad CRC
RX: 132851912us C=42 Bad CRC
RX: 4336146us C=42 Bad CRC
RX: 134788244us C=42 Bad CRC
RX: 5157733us C=42 Bad CRC
RX: 134826142us C=42 Bad CRC
RX: 7909662us C=42 Bad CRC
RX: 135573694us C=42 Bad CRC
RX: 7935968us C=42 Bad CRC
RX: 136331434us C=42 Bad CRC
RX: 7978977us C=42 Bad CRC
RX: 136342965us C=42 Bad CRC
RX: 9945792us C=42 Bad CRC
RX: 136768575us C=42 Bad CRC
RX: 10306073us C=42 Bad CRC
RX: 136789959us C=42 Bad CRC
RX: 11489822us C=42 Bad CRC
RX: 137207545us C=42 Bad CRC
RX: 11511252us C=42 Bad CRC
RX: 138347297us C=42 Bad CRC
RX: 11528023us C=42 Bad CRC
RX: 139126349us C=42 Bad CRC
RX: 13559653us C=42 Bad CRC
RX: 139131250us C=42 Bad CRC
RX: 13877621us C=42 Bad CRC
RX: 139995642us C=42 Bad CRC
RX: 15033870us C=42 Bad CRC
RX: 140371587us C=42 Bad CRC
RX: 15055325us C=42 Bad CRC
RX: 140757904us C=42 Bad CRC
RX: 15506927us C=42 Bad CRC
RX: 141521865us C=42 Bad CRC
RX: 16265000us C=42 Bad CRC
RX: 141602595us C=42 Bad CRC
RX: 17861034us C=42 Bad CRC
RX: 141984529us C=42 Bad CRC
RX: 18274552us C=42 Enhanced pid=0 S=Y A= F6 96 01 00 81 P(15)= 08 64 64 00 00 00 00 00 00 00 32 A4 00 00 A6
RX: 317846us C=42 Bad CRC
Channel=43,0x2B
RX:     0us C=43 Bad CRC
Channel=44,0x2C
RX:     0us C=44 Enhanced pid=2 S=Y A= F6 96 01 00 81 P(15)= 08 64 64 00 00 00 00 00 00 00 32 A4 00 00 A6
RX: 1543180us C=44 Enhanced pid=2 S=Y A= F6 96 01 00 81 P(15)= 08 64 64 00 00 00 00 00 00 00 32 A4 00 00 A6
RX: 1225578us C=44 Enhanced pid=3 S=Y A= 01 03 05 07 09 P(15)= 01 F6 96 01 00 81 00 00 00 00 32 A4 00 00 E5
RX: 3981582us C=44 Enhanced pid=0 S=Y A= 01 03 05 07 09 P(15)= 01 F6 96 01 00 81 00 00 00 00 32 A4 00 00 E5
RX: 1139992us C=44 Enhanced pid=1 S=Y A= F6 96 01 00 81 P(15)= 08 64 64 00 00 00 00 00 00 00 32 A4 00 00 A6
RX: 832590us C=44 Enhanced pid=0 S=Y A= F6 96 01 00 81 P(15)= 08 64 64 00 00 00 00 00 00 00 32 A4 00 00 A6
RX: 1246061us C=44 Enhanced pid=2 S=Y A= F6 96 01 00 81 P(15)= 08 64 64 00 00 00 00 00 00 00 32 A4 00 00 A6
RX: 1892804us C=44 Bad CRC
RX: 211600888us C=44 Enhanced pid=0 S=Y A= F6 96 01 00 81 P(15)= 08 64 64 00 00 00 00 00 00 00 32 A4 00 00 A6
RX: 5180995us C=44 Enhanced pid=1 S=Y A= 01 03 05 07 09 P(15)= 01 F6 96 01 00 81 00 00 00 00 32 A4 00 00 E5
RX: 435357us C=44 Enhanced pid=1 S=Y A= F6 96 01 00 81 P(15)= 08 64 64 00 00 00 00 00 00 00 32 A4 00 00 A6
RX: 773305us C=44 Enhanced pid=1 S=Y A= F6 96 01 00 81 P(15)= 08 64 64 00 00 00 00 00 00 00 32 A4 00 00 A6
RX: 3929493us C=44 Bad CRC
RX: 219931035us C=44 Enhanced pid=2 S=Y A= F6 96 01 00 81 P(15)= 08 64 64 00 00 00 00 00 00 00 32 A4 00 00 A6
RX: 360915us C=44 Bad CRC
RX: 223903334us C=44 Bad CRC
RX: 1161582us C=44 Enhanced pid=2 S=Y A= 01 03 05 07 09 P(15)= 01 F6 96 01 00 81 00 00 00 00 32 A4 00 00 E5
RX: 408424us C=44 Enhanced pid=1 S=Y A= F6 96 01 00 81 P(15)= 08 64 64 00 00 00 00 00 00 00 32 A4 00 00 A6
RX: 1547960us C=44 Enhanced pid=1 S=Y A= F6 96 01 00 81 P(15)= 08 64 64 00 00 00 00 00 00 00 32 A4 00 00 A6
RX: 38102us C=44 Enhanced pid=3 S=Y A= F6 96 01 00 81 P(15)= 08 64 64 00 00 00 00 00 00 00 32 A4 00 00 A6
RX: 1934214us C=44 Bad CRC
RX: 228741196us C=44 Bad CRC
RX: 2235993us C=44 Enhanced pid=1 S=Y A= F6 96 01 00 81 P(15)= 08 64 64 00 00 00 00 00 00 00 32 A4 00 00 A6
RX: 85548us C=44 Enhanced pid=1 S=Y A= F6 96 01 00 81 P(15)= 08 64 64 00 00 00 00 00 00 00 32 A4 00 00 A6
RX: 1586424us C=44 Enhanced pid=3 S=Y A= F6 96 01 00 81 P(15)= 08 64 64 00 00 00 00 00 00 00 32 A4 00 00 A6
RX: 1139438us C=44 Enhanced pid=0 S=Y A= 01 03 05 07 09 P(15)= 01 F6 96 01 00 81 00 00 00 00 32 A4 00 00 E5
RX: 774592us C=44 Enhanced pid=0 S=Y A= 01 03 05 07 09 P(15)= 01 F6 96 01 00 81 00 00 00 00 32 A4 00 00 E5
RX: 455906us C=44 Enhanced pid=1 S=Y A= F6 96 01 00 81 P(15)= 08 64 64 00 00 00 00 00 00 00 32 A4 00 00 A6
Channel=45,0x2D
RX:     0us C=45 Enhanced pid=0 S=Y A= F6 96 01 00 81 P(15)= 08 64 64 00 00 00 00 00 00 00 32 A4 00 00 A6
RX: 16664us C=45 Enhanced pid=1 S=Y A= F6 96 01 00 81 P(15)= 08 64 64 00 00 00 00 00 00 00 32 A4 00 00 A6
RX: 370399us C=45 Enhanced pid=2 S=Y A= 01 03 05 07 09 P(15)= 01 F6 96 01 00 81 00 00 00 00 32 A4 00 00 E5
RX: 467538us C=45 Enhanced pid=0 S=Y A= F6 96 01 00 81 P(15)= 08 64 64 00 00 00 00 00 00 00 32 A4 00 00 A6
RX: 757525us C=45 Enhanced pid=3 S=Y A= F6 96 01 00 81 P(15)= 08 64 64 00 00 00 00 00 00 00 32 A4 00 00 A6
RX: 16442us C=45 Enhanced pid=0 S=Y A= F6 96 01 00 81 P(15)= 08 64 64 00 00 00 00 00 00 00 32 A4 00 00 A6
RX: 31300us C=45 Bad CRC
RX: 238169900us C=45 Bad CRC
RX: 365308us C=45 Enhanced pid=1 S=Y A= 01 03 05 07 09 P(15)= 01 F6 96 01 00 81 00 00 00 00 32 A4 00 00 E5
RX:  9807us C=45 Enhanced pid=1 S=Y A= 01 03 05 07 09 P(15)= 01 F6 96 01 00 81 00 00 00 00 32 A4 00 00 E5
RX: 21407us C=45 Enhanced pid=2 S=Y A= 01 03 05 07 09 P(15)= 01 F6 96 01 00 81 00 00 00 00 32 A4 00 00 E5
RX: 11616us C=45 Enhanced pid=3 S=Y A= 01 03 05 07 09 P(15)= 01 F6 96 01 00 81 00 00 00 00 32 A4 00 00 E5
RX: 434798us C=45 Enhanced pid=3 S=Y A= F6 96 01 00 81 P(15)= 08 64 64 00 00 00 00 00 00 00 32 A4 00 00 A6
RX: 726253us C=45 Enhanced pid=1 S=Y A= F6 96 01 00 81 P(15)= 08 64 64 00 00 00 00 00 00 00 31 A4 00 00 A5
RX: 472745us C=45 Enhanced pid=3 S=Y A= F6 96 01 00 81 P(15)= 08 64 64 00 00 00 00 00 00 00 32 A4 00 00 A6
RX: 332769us C=45 Enhanced pid=2 S=Y A= F6 96 01 00 81 P(15)= 08 64 64 00 00 00 00 00 00 00 32 A4 00 00 A6
RX: 446280us C=45 Enhanced pid=3 S=Y A= 01 03 05 07 09 P(15)= 01 F6 96 01 00 81 00 00 00 00 32 A4 00 00 E5
RX: 387419us C=45 Enhanced pid=1 S=Y A= F6 96 01 00 81 P(15)= 08 64 64 00 00 00 00 00 00 00 32 A4 00 00 A6
RX: 407697us C=45 Enhanced pid=0 S=Y A= 01 03 05 07 09 P(15)= 01 F6 96 01 00 81 00 00 00 00 32 A4 00 00 E5
RX: 1913412us C=45 Enhanced pid=1 S=Y A= F6 96 01 00 81 P(15)= 08 64 64 00 00 00 00 00 00 00 32 A4 00 00 A6
RX: 64479us C=45 Enhanced pid=0 S=Y A= F6 96 01 00 81 P(15)= 08 64 64 00 00 00 00 00 00 00 32 A4 00 00 A6
RX: 338507us C=45 Enhanced pid=0 S=Y A= 01 03 05 07 09 P(15)= 01 F6 96 01 00 81 00 00 00 00 32 A4 00 00 E5
RX: 397492us C=45 Enhanced pid=2 S=Y A= F6 96 01 00 81 P(15)= 08 64 64 00 00 00 00 00 00 00 32 A4 00 00 A6
RX: 80845us C=45 Enhanced pid=2 S=Y A= F6 96 01 00 81 P(15)= 08 64 64 00 00 00 00 00 00 00 32 A4 00 00 A6
RX: 327493us C=45 Enhanced pid=1 S=Y A= 01 03 05 07 09 P(15)= 01 F6 96 01 00 81 00 00 00 00 32 A4 00 00 E5
RX: 75813us C=45 Enhanced pid=1 S=Y A= F6 96 01 00 81 P(15)= 08 64 64 00 00 00 00 00 00 00 32 A4 00 00 A6
RX: 1102353us C=45 Enhanced pid=0 S=Y A= F6 96 01 00 81 P(15)= 08 64 64 00 00 00 00 00 00 00 31 A4 00 00 A5
RX: 21355us C=45 Enhanced pid=1 S=Y A= F6 96 01 00 81 P(15)= 08 64 64 00 00 00 00 00 00 00 32 A4 00 00 A6
RX: 37916us C=45 Enhanced pid=3 S=Y A= F6 96 01 00 81 P(15)= 08 64 64 00 00 00 00 00 00 00 32 A4 00 00 A6
RX: 365404us C=45 Enhanced pid=0 S=Y A= 01 03 05 07 09 P(15)= 01 F6 96 01 00 81 00 00 00 00 32 A4 00 00 E5
RX: 21395us C=45 Enhanced pid=1 S=Y A= 01 03 05 07 09 P(15)= 01 F6 96 01 00 81 00 00 00 00 32 A4 00 00 E5
RX: 370535us C=45 Enhanced pid=2 S=Y A= F6 96 01 00 81 P(15)= 08 64 64 00 00 00 00 00 00 00 32 A4 00 00 A6
RX: 21579us C=45 Bad CRC
RX: 246929386us C=45 Bad CRC
RX: 43080us C=45 Bad CRC
RX: 247289830us C=45 Bad CRC
RX: 468215us C=45 Enhanced pid=2 S=Y A= F6 96 01 00 81 P(15)= 08 64 64 00 00 00 00 00 00 00 32 A4 00 00 A6
RX: 365140us C=45 Enhanced pid=3 S=Y A= 01 03 05 07 09 P(15)= 01 F6 96 01 00 81 00 00 00 00 32 A4 00 00 E5
RX: 778994us C=45 Enhanced pid=3 S=Y A= 01 03 05 07 09 P(15)= 01 F6 96 01 00 81 00 00 00 00 32 A4 00 00 E5
RX: 42816us C=45 Bad CRC
RX: 249246136us C=45 Enhanced pid=1 S=Y A= F6 96 01 00 81 P(15)= 08 64 64 00 00 00 00 00 00 00 32 A4 00 00 A6
RX: 26380us C=45 Enhanced pid=2 S=Y A= F6 96 01 00 81 P(15)= 08 64 64 00 00 00 00 00 00 00 32 A4 00 00 A6
RX: 360671us C=45 Enhanced pid=3 S=Y A= 01 03 05 07 09 P(15)= 01 F6 96 01 00 81 00 00 00 00 32 A4 00 00 E5
RX: 26296us C=45 Enhanced pid=0 S=Y A= 01 03 05 07 09 P(15)= 01 F6 96 01 00 81 00 00 00 00 32 A4 00 00 E5
RX: 398903us C=45 Enhanced pid=3 S=Y A= F6 96 01 00 81 P(15)= 08 64 64 00 00 00 00 00 00 00 32 A4 00 00 A6
RX: 418049us C=45 Bad CRC
RX: 250530854us C=45 Bad CRC
RX: 1530691us C=45 Enhanced pid=2 S=Y A= 01 03 05 07 09 P(15)= 01 F6 96 01 00 81 00 00 00 00 32 A4 00 00 E5
RX: 43061us C=45 Enhanced pid=0 S=Y A= 01 03 05 07 09 P(15)= 01 F6 96 01 00 81 00 00 00 00 32 A4 00 00 E5
RX: 408242us C=45 Bad CRC
RX: 253333657us C=45 Bad CRC
RX: 3097806us C=45 Enhanced pid=1 S=Y A= F6 96 01 00 81 P(15)= 08 64 64 00 00 00 00 00 00 00 32 A4 00 00 A6
RX: 64163us C=45 Bad CRC
RX: 256447954us C=45 Enhanced pid=1 S=Y A= F6 96 01 00 81 P(15)= 08 64 64 00 00 00 00 00 00 00 32 A4 00 00 A6
RX: 322300us C=45 Enhanced pid=0 S=Y A= 01 03 05 07 09 P(15)= 01 F6 96 01 00 81 00 00 00 00 32 A4 00 00 E5
RX: 59331us C=45 Enhanced pid=3 S=Y A= 01 03 05 07 09 P(15)= 01 F6 96 01 00 81 00 00 00 00 32 A4 00 00 E5
RX: 25948us C=45 Enhanced pid=0 S=Y A= F6 96 01 00 81 P(15)= 08 64 64 00 00 00 00 00 00 00 32 A4 00 00 A6
RX: 693831us C=45 Enhanced pid=0 S=Y A= 01 03 05 07 09 P(15)= 01 F6 96 01 00 81 00 00 00 00 32 A4 00 00 E5
RX: 85695us C=45 Enhanced pid=0 S=Y A= 01 03 05 07 09 P(15)= 01 F6 96 01 00 81 00 00 00 00 32 A4 00 00 E5
RX: 403775us C=45 Enhanced pid=3 S=Y A= F6 96 01 00 81 P(15)= 08 64 64 00 00 00 00 00 00 00 32 A4 00 00 A6
RX: 317193us C=45 Enhanced pid=2 S=Y A= 01 03 05 07 09 P(15)= 01 F6 96 01 00 81 00 00 00 00 32 A4 00 00 E5
RX: 90093us C=45 Bad CRC
RX: 258803507us C=45 Enhanced pid=0 S=Y A= F6 96 01 00 81 P(15)= 08 64 64 00 00 00 00 00 00 00 32 A4 00 00 A6
RX: 332414us C=45 Enhanced pid=3 S=Y A= 01 03 05 07 09 P(15)= 01 F6 96 01 00 81 00 00 00 00 32 A4 00 00 E5
RX: 37910us C=45 Enhanced pid=1 S=Y A= 01 03 05 07 09 P(15)= 01 F6 96 01 00 81 00 00 00 00 32 A4 00 00 E5
RX: 47704us C=45 Enhanced pid=3 S=Y A= F6 96 01 00 81 P(15)= 08 64 64 00 00 00 00 00 00 00 32 A4 00 00 A6
RX: 313288us C=45 Enhanced pid=2 S=Y A= F6 96 01 00 81 P(15)= 08 64 64 00 00 00 00 00 00 00 32 A4 00 00 A6
RX: 26335us C=45 Enhanced pid=3 S=Y A= F6 96 01 00 81 P(15)= 08 64 64 00 00 00 00 00 00 00 32 A4 00 00 A6
RX: 37911us C=45 Enhanced pid=1 S=Y A= F6 96 01 00 81 P(15)= 08 64 64 00 00 00 00 00 00 00 32 A4 00 00 A6
RX: 327251us C=45 Bad CRC
RX: 259710582us C=45 Bad CRC
RX: 353565us C=45 Enhanced pid=2 S=Y A= 01 03 05 07 09 P(15)= 01 F6 96 01 00 81 00 00 00 00 32 A4 00 00 E5
RX: 742949us C=45 Enhanced pid=1 S=Y A= 01 03 05 07 09 P(15)= 01 F6 96 01 00 81 00 00 00 00 32 A4 00 00 E5
RX: 47674us C=45 Bad CRC
RX: 261189488us C=45 Enhanced pid=1 S=Y A= F6 96 01 00 81 P(15)= 08 64 64 00 00 00 00 00 00 00 32 A4 00 00 A6
RX: 429650us C=45 Enhanced pid=1 S=Y A= 01 03 05 07 09 P(15)= 01 F6 96 01 00 81 00 00 00 00 32 A4 00 00 E5
RX: 328051us C=45 Enhanced pid=0 S=Y A= F6 96 01 00 81 P(15)= 08 64 64 00 00 00 00 00 00 00 32 A4 00 00 A6
RX: 471868us C=45 Enhanced pid=2 S=Y A= 01 03 05 07 09 P(15)= 01 F6 96 01 00 81 00 00 00 00 32 A4 00 00 E5
RX: 328307us C=45 Enhanced pid=1 S=Y A= F6 96 01 00 81 P(15)= 08 64 64 00 00 00 00 00 00 00 31 A4 00 00 A5
RX: 790932us C=45 Enhanced pid=2 S=Y A= F6 96 01 00 81 P(15)= 08 64 64 00 00 00 00 00 00 00 32 A4 00 00 A6
RX: 42780us C=45 Enhanced pid=0 S=Y A= F6 96 01 00 81 P(15)= 08 64 64 00 00 00 00 00 00 00 31 A4 00 00 A5
RX: 773845us C=45 Enhanced pid=0 S=Y A= F6 96 01 00 81 P(15)= 08 64 64 00 00 00 00 00 00 00 32 A4 00 00 A6
RX: 21477us C=45 Bad CRC
RX: 264445454us C=45 Enhanced pid=3 S=Y A= F6 96 01 00 81 P(15)= 08 64 64 00 00 00 00 00 00 00 32 A4 00 00 A6
RX: 321941us C=45 Bad CRC
RX: 264488351us C=45 Bad CRC
RX: 1478624us C=45 Enhanced pid=1 S=Y A= F6 96 01 00 81 P(15)= 08 64 64 00 00 00 00 00 00 00 32 A4 00 00 A6
RX: 52718us C=45 Enhanced pid=3 S=Y A= F6 96 01 00 81 P(15)= 08 64 64 00 00 00 00 00 00 00 32 A4 00 00 A6
Channel=46,0x2E
Channel=47,0x2F
Channel=48,0x30
RX:     0us C=48 Bad CRC
Channel=49,0x31
RX:     0us C=49 Bad CRC
RX: 327461690us C=49 Bad CRC
RX: 37908us C=49 Bad CRC
RX: 329374576us C=49 Bad CRC
RX: 2036885us C=49 Bad CRC
RX: 330562181us C=49 Bad CRC
RX: 2106037us C=49 Bad CRC
RX: 330573723us C=49 Bad CRC
RX: 2820461us C=49 Bad CRC
RX: 332159473us C=49 Bad CRC
RX: 2830257us C=49 Bad CRC
RX: 332180979us C=49 Bad CRC
RX: 4046397us C=49 Bad CRC
RX: 333136470us C=49 Bad CRC
RX: 4295538us C=49 Bad CRC
RX: 334275645us C=49 Bad CRC
RX: 4364659us C=49 Bad CRC
RX: 334990017us C=49 Bad CRC
RX: 4419059us C=49 Bad CRC
Channel=50,0x32
Channel=51,0x33
RX:     0us C=51 Enhanced pid=1 S=Y A= 01 03 05 07 09 P(15)= 01 F6 96 01 00 81 00 00 00 00 32 A4 00 00 E5
RX: 747378us C=51 Bad CRC
RX: 361758025us
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

Thread 1055 (2025-01-07):

Module Flash size: 256KB

Mr-Squeeto, 2025-01-07:
Thank you Pascal for your incredible contribution to this project and your continued assistance to others.

Because of its weak transmitter, I currently have one plane that I need to address, a 4 channel Volantex P51, and want to use hardware at hand.
I build this around a FlySky FS-i6S transmitter and a 64KB BluePill STM32 but am having no luck at binding, does this look okay:

Multiprotocol version: 1.3.4.12
Module Flash size: 256KB
EEPROM initialized: 0
Protocol selection switch reads as 1
Using bank 0
Module Id: 1a59e75a
Protocol selected: 48, sub proto 1, rxnum 0, option 0
ID: 1A 59 E7 5A , HOP: 0F 14 46
Using NRF
Proto=V761, nbr_sub=3, Sub=4ch , Opt=0, FS=0, CHMap=0, rfSw=2
Init complete

I am curious about the Module Flash size of 256KB for a 64KB MCU.
Is there a _Config.h setting for this?
Thank you

pascallanger, 2025-01-07:
Everything looks good from a startup perspective.
256KB is what the bluepill's STM32 is reporting... I don't think it has any impact. If the NRF is well connected to the bluepill and you have set the module in bind mode right after the plane has been plugged that should work...

Mr-Squeeto, 2025-01-08:
I will check the NRF wiring.

Thank you. Last request..
Do the lights blink as expected?

https://www.youtube.com/watch?v=pW4d-1_LSx0

_Config.h

#define AETR
..
#define NRF24L01_INSTALLED
..
#define NRF24L01_ENABLE_LOW_POWER
..
#define	FX_NRF24L01_INO
..
#define	V761_NRF24L01_INO
..
#define ENABLE_PPM
..
#define TX_CUSTOM		//Custom
..
#if defined(TX_CUSTOM)
	#define PPM_MAX_100	1900	//	100%
	#define PPM_MIN_100	1100	//	100%
#endif
..
#define MIN_PPM_CHANNELS 4
..
#define MAX_PPM_CHANNELS 10
..
#define NBR_BANKS 1

const PPM_Parameters PPM_prot[14*NBR_BANKS]=	{
#if NBR_BANKS > 0
//******************************       BANK 1       ******************************
//	Switch		Protocol	Sub protocol	RX_Num		Power		Auto Bind		Option		Chan Order
/*	1	*/	{PROTO_V761,	V761_4CH  ,	0	,	P_HIGH	,	NO_AUTOBIND	,	0	,	0x00000000 },
/*	2	*/	{PROTO_V761,	V761_4CH  ,	1	,	P_HIGH	,	NO_AUTOBIND	,	0	,	0x00000000 },
/*	3	*/	{PROTO_V761,	V761_4CH  ,	2	,	P_HIGH	,	NO_AUTOBIND	,	0	,	0x00000000 },
/*	4	*/	{PROTO_V761,	V761_4CH  ,	3	,	P_HIGH	,	NO_AUTOBIND	,	0	,	0x00000000 },
/*	5	*/	{PROTO_V761,	V761_4CH  ,	4	,	P_HIGH	,	NO_AUTOBIND	,	0	,	0x00000000 },
/*	6	*/	{PROTO_V761,	V761_4CH  ,	5	,	P_HIGH	,	NO_AUTOBIND	,	0	,	0x00000000 },
/*	7	*/	{PROTO_V761,	V761_4CH  ,	6	,	P_HIGH	,	NO_AUTOBIND	,	0	,	0x00000000 },
/*	8	*/	{PROTO_V761,	V761_4CH  ,	7	,	P_HIGH	,	NO_AUTOBIND	,	0	,	0x00000000 },
/*	9	*/	{PROTO_V761,	V761_4CH  ,	8	,	P_HIGH	,	NO_AUTOBIND	,	0	,	0x00000000 },
/*	10	*/	{PROTO_V761,	V761_4CH  ,	9	,	P_HIGH	,	NO_AUTOBIND	,	0	,	0x00000000 },
/*	11	*/	{PROTO_V761,	V761_4CH  ,	10	,	P_HIGH	,	NO_AUTOBIND	,	0	,	0x00000000 },
/*	12	*/	{PROTO_V761,	V761_4CH  ,	11	,	P_HIGH	,	NO_AUTOBIND	,	0	,	0x00000000 },
/*	13	*/	{PROTO_FX,	FX620     ,	0	,	P_HIGH	,	NO_AUTOBIND	,	0	,	0x00000000 },
/*	14	*/	{PROTO_FX,	FX620     ,	1	,	P_HIGH	,	NO_AUTOBIND	,	0	,	0x00000000 },
#endif
..
//my adds:
#define ARDUINO_GENERIC_STM32F103C
#define GENERIC_STM32F1_SERIES
//#define DEBUG_SERIAL

Mr-Squeeto, 2025-01-08:
Thank you again. I should have all that I need.
I have tried holding the bind button (black wire to gnd in the video) on start up but it is the same results.

I contacted the seller about a better transmitter option for this plane and he said that it is based on the Volantex P51.
But maybe it has a slightly different protocol than the V761.

I will check my (rats nest) wiring. I do intend to finally etch a circuit board when I have it all correct.

pascallanger, 2025-01-08:
It's the same protocol. Again there was no bind at startup so for whatever reason your strap is. Not working... You can force the module to initiate a bind automatically at startup by changing the No_autobind  flag in the bank.

Mr-Squeeto, 2025-02-26:
Thanks again.
I did have an idea though, could a receiver be coded to collect 2 seconds of transmission to capture the bind signal and then usb send it to file to view on computer?

pascallanger, 2025-02-26:
It's already there and called XN297dump, this will scan and output what it finds on the serial usb connection.
But from our previous exchange your module is not sending any bind packets therefore it can't work. You must request the module to send a bind sequence by pressing the bind button before turning on the module.

Mr-Squeeto, 2025-02-26:
I seem to be able to bind with a PROTO_FX, FX620 so maybe my PROTO_V761, V761_4CH is defective. It has been starting to act up. It is just a cheap toy.
I will dedicate some extra time to this and I will report back if anything comes to fruition.

pascallanger, 2025-02-26:
The FX protocol is autobind. Which means that it will bind even if not ask. This is why it works...
If you don't want to troubleshoot your bind button then just add this line
`BIN_IN_PROGRESS;`
in this file and line: https://github.com/pascallanger/DIY-Multiprotocol-TX-Module/blob/d800f2c3332ef880d122aeb75a3638a9a94995e0/Multiprotocol/V761_nrf24l01.ino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

pascallanger, 2025-02-26:
Try to add the line like I indicated earlier and see if your plane works. You must have the plane on and initialized before turning on the module.

Closed 2025-02-26.

Thread 1057 (2025-01-10):

E190 heli protocol

pascallanger, 2025-01-10:
**E190 protocol**

Normal mode:
----
1M C=50 S=Y A= B3 13 36 DD D9 P(9)= A0 00 00 FD FF F8 F3 55 DC

4 RF channels identified: 50[10] 53[10] 66[10] 73[10]

Keeping only RF channels with more than 6 packets: 50* 53 66 73

Identifying RF channels order.
Time between CH:50 and CH:50
Time: 49734us
Time: 49739us
Time: 49735us
Time: 49735us
Time between CH:50 and CH:53
Time: 18947us
Time: 12435us
Time: 12431us
Time: 12434us
Time: 12436us
Time: 12437us
Time: 12428us
Time: 12440us
Time between CH:50 and CH:66
Time: 24845us
Time: 24844us
Time: 24849us
Time: 24850us
Time: 24860us
Time: 24859us
Time: 24855us
Time: 24852us
Time: 24855us
Time between CH:50 and CH:73
Time: 37272us
Time: 37278us
Time: 37279us

Channel order:
50:     0us
53: 12428us
66: 24844us
73: 37272us

Identifying Sticks and features.
P: A0 00 00 FD FF FD F3 55 E1
P: A0 00 00 FD FF F8 F3 55 DC
P: A0 00 00 FB FB FF F6 55 E0
P: A0 00 00 FD FF FF F3 55 E3
P: A0 00 00 FD FF F5 F3 55 D9
P: A0 00 00 FB FB FD F6 55 DE
P: A0 00 00 FB FB F8 F6 55 D9
P: A0 00 00 FB FB FD F6 55 DE
P: A0 00 00 FD D5 F5 DC 55 98
P: A0 00 00 02 63 D8 4B 56 7E
P: A0 00 00 74 9E 83 95 12 DC
P: A0 00 00 E8 00 00 00 03 8B
P: A0 00 00 DB 00 00 00 01 7C
P: A0 00 00 02 00 00 00 01 A3
P: A0 00 00 00 00 00 00 00 A0

1M C=50 S=Y A= B3 13 36 DD D9 P(9)= A0 00 00 FD FF F8 F3 55 DC

**Normal packet:**
P[0]: 00
    | 80 bind done
	| 20 not telem from the heli
	| 10 Lock
	| 08 H / 00 L
	| 01 Screw pitch (temporary)=long press up
P[1]: 00
	| 08 Land ? only when unlock (toggle) = short press down
	| 20 Mode (toggle)
P[2]: 00
	| 02 Altitude hold
	| 03 Manual
	| 40 Flip (toggle)
P[3]: CH1L A=0..1F4(500)..3E8(1000)
P[4]: CH2L E=0..1F4(500)..3E8(1000)
P[5]: CH3L T=0..1F4(500)..3E8(1000)
P[6]: CH4L R=0..1F4(500)..3E8(1000)
P[7]: CH4H<<6|CH3H<<4|CH2H<<2|CH1H
P[8]: sum(P[1..7])

Sticks low out
P: A0 00 40 E8 00 00 00 03 CB
Sticks low in
P: A0 00 40 00 00 00 E8 C0 88
Sticks low left
P: A0 00 40 00 00 00 00 00 E0

**Telemetry:**
2 different packets:
P(9)=	78	0	0	0	50	10	0	0	D8
P(9)=	78	0	0	0	4F	10	0	0	D7
P[4] = voltage 8.40V 0x60, 8.00V 0x47, 7.60V 0x2B, 7.40V 0x1D, 7.20V 0x0E, 7.00V 0x00
P[5] = status: stopped, flying,...
P[6] = low_voltage = 0x20

P(9)=	79	FE	0A	0	0	0	5	0	86
P(9)=	79	0	0B	0	0	0	5	0	89
P[1] = gyro
P[2] = gyro
P[6] = ?
-----
Bind mode:
----
C=48 S=Y A= 00 00 00 00 00 P(9)= 30 00 00 B3 13 36 DD 55 5E

**Bind packet:**
P[0]: 00
	| 20 not telem from the heli
	| 10 Lock
	| 08 H / 00 L
	| 01 Screw pitch (temporary)=long press up
P[1]: 00
	| 08 Auto land only set when unlock (toggle) = short press down
	| 20 Mode (toggle)
P[2]: 00
	| 02 Altitude hold
	| 03 Manual
	| 40 Flip (toggle)
P[3]: A[0]
P[4]: A[1]
P[5]: A[2]
P[6]: A[3]
P[7]: CH4H<<6|CH3H<<4|CH2H<<2|CH1H
P[8]: sum(P[1..7])

A[4] seems to be the sum of A[0..3]:
TX1 ID: B3 13 36 DD D9 -> A[4]=B3+13+36+DD=D9 => RF: 73,50,53,66 or 0x49,0x32,0x35,0x42
TX2 ID: EB 13 36 AC E0 -> A[4]=EB+13+36+AC=E0 => RF : 77,58,62,71 or 0x4D,0x3A,0x3E,0x47

OB1-OB2, 2025-01-14:
Hey, I'm Left_Drift from RCG. I got the heli and before even trying to fly, I updated the MPM and tried a bind. It seems to work:

- I turned on the heli, and the yellow light flashed fast.
- I pushed "bind" on the TX and the yellow light on the heli turned green - indicating bind-ness.
- I moved the sticks but nothing moved on the heli - am I supposed to have control over the collective/cyclic?

I powered down for now... I want to try flying with the original TX to make sure the heli even operates properly next.

Are there anything specific I need to set up in the model? Right now, I've just setup a simple 4 channel acro model in EdgeTX.

pascallanger, 2025-01-17:
Protocol works but still some to do:
- Add more than 2 TX IDs/RF frequencies -> I need people to do some dumps of other original TXs or send me their unneeded TXs.
- Find where the low batt signal is in the telemetry

Closed 2025-01-19.

Thread 1063 (2025-01-22):

SMODELF JBL-430x 1:43 Rc Drift Car is supported ?

LilTeo14, 2025-01-22:
Pictures:

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

Transmitter Board:

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

Receiver Board:

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

Aliexpress data:
Brand Name: SMODELF
Model Number: JBL-4303

If it is not supported i already have debug firmware to dump over the air and have a analyzer too.

Thanks for help.

pascallanger, 2025-01-22:
I don't think it's supported but feel free to try all the SFC protocols and sub-protocols.

If you have a logic analyzer that would be perfect. Connect it on these 3 pins + GND:

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

LilTeo14, 2025-01-23:
Here is the data from logic analyzer.

https://usmcl-my.sharepoint.com/:u:/g/personal/mateo_morales_usm_cl/EUXc4VDJHHRKo9rgKDj9ESsBLZ2tDzrWaFPluHNe8_kKFw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

Ch0: CSN, Ch1:Csk, Ch2: Data.

M-i-c-h-a-e-l1, 2025-01-23:
Hello,

I have the same car, but with a gyro installed. The Transmitter has an extra potentiometer to change the sensitivity of the gyro.

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

I am willing to test the protocol on my RM 4in1 radio.

Kind regards
M

LilTeo14, 2025-01-23:
The TX keep blinking until the car is power on.

"Bindmode" Tx is the whole time in bind mode "Led blinking"
"Bindmode+Bind" Tx start in bind mode and after 1 second aproximated the car is turned on and the Led stop blinking

https://usmcl-my.sharepoint.com/:f:/g/personal/mateo_morales_usm_cl/EmGWskJlxtdFsW5wWM53tFQBy3OHnQC4ilQJs_frqeEJxw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

pascallanger, 2025-01-23:
It looks good but I need at least Bindmode to start from the TX power on (start the capture before turning on) to see the init of the XN297.
Please also do a dump of the normal mode from the TX power on. If the car needs to be turned for the TX to stop blinking then do a dump as well of this part.

M-i-c-h-a-e-l1, 2025-01-23:
Hello,

The Transmitter also has the following functions:

1. Steereing left - right (and trims)
2. Forward and reverse and brake lights
3. Lights on/off
4. Three levels of speed/power: 20%, 50% and 100%. The speed/power levels are selected with the arrow up/down on the transmitter. If 20% is selected a green LED lights up, 50% orange LED and 100% red LED. I don't think that this is necessary to implement in the protocol as this can be done with a 3 position switch on the radio.
5. Gyro sensitivety (for cars with a gyro)

Kind regards
M

pascallanger, 2025-01-23:
I'll need a different capture for every single channel and feature. So one stuff moving at a time so that it is ready to identify.

LilTeo14, 2025-01-23:
"BindedFromTxPowerOn" I turned on the car, start recording, turned on radio.
"BindModeFromTxPowerOn" Start recording, turned on radio with car off.
Both files uploaded to the same folder!

pascallanger, 2025-01-24:
I've started to look at it but I need these other dumps to understand the protocol, one file per dump:
 - turn on in normal mode with car off
 - turn on in normal mode car on
 - normal mode steering slow move from left to right (making sure trims are centered first)
 - normal mode throttle slow move from reverse to forward
 - lights
 - speed settings 20%, 50% and 100%
 - gyro
 - everything else you can think of

pascallanger, 2025-01-24:
Protocol uses XN297 1Mb Scrambled

Bind
---
Bind is in 3 steps
**Step 1**
Tx sends packets and listens for an answer
TX Addr A7 07 57 A7 26
RF: 7, 39, 69 = 0x07, 0x27, 0x45
Packets TX every 12700µs
RF=7   P(8)=CB 03 A5 00 00 00 00 CF
RF=39 P(8)=CB 03 A5 00 00 00 00 EF
RF=69 P(8)=CB 03 A5 00 00 00 00 0D
....

Packet
P[0] = ?
...
P[7] = next RF mixed with CRC?

**Step 2**
RX from car
P(7)=CB 03 A5 9D 05 A2 68

Packet
P[0] = same as TX
P[1] = same as TX
P[2] = same as TX
P[3] = RXID[0]
P[4] = RXID[1]
P[5] = RXID[2]
P[6] = crc?

**Step 3**
Tx sends packets
TX Addr A7 9D 05 A2 26 -> A7 RXID[0] RXID[1] RXID[2] 26

RF: 35, 45, 75 = 0x23, 0x2D, 0x4B
Packets TX every 2408µs sometimes 3990µs for a packet

RF=35 P(8)=CB 03 A5 00 00 00 00 EB
RF=45 P(8)=CB 03 A5 00 00 00 00 F5
RF=75 P(8)=CB 03 A5 00 00 00 00 13
...

Packet
P[0] = ?
...
P[7] = next RF?

LilTeo14, 2025-01-24:
Hello there!

First of all, thank you so much for your support and guidance. I want to clarify a few points regarding the dumps you requested:

- My radio automatically turns on in bind mode, so there isn’t really a separate “normal mode” when powering it on.

- Because I was out today, I’ll carry out the tests tomorrow to gather the data you need.

- “Turn on in normal mode car on” corresponds to what I did in the file BindedFromTxPowerOn.

- “Turn on in normal mode with car off” corresponds to what I did in BindModeFromTxPowerOn.

For the remaining recordings, do you want me to start capturing data before powering on the radio, or after the radio is already on and bound to the car? Also, is there a recommended length for each recording, or should I record as much as possible?

Thank you again for all your help. I’m really grateful for your time and expertise, and I look forward to getting these dumps done.

Best regards,
Mateo.

pascallanger, 2025-01-25:
To determine the channels and features, just do a capture when the radio is already bound to the car (no need to start from power on).
For the length, it all depends of the action. When it's a channel the capture should cover the full move of the channel. For example for steering the capture should have a slow move from mid->left->right->mid which will be quite long but for lights which is a button I just need a short capture where you press the button one time.

Do you have more than one car? if yes then a capture “Turn on in normal mode car on” of every car would be useful.

We'll see if we can get to the bottom of this protocol but there are many unknowns right now. The most annoying is the last byte of the packet which looks like to have a crc and next channel which calculation is un known yet and could prevent the car to accept packets. The second is the RF channels of normal mode which might be based on the TX ID and RX ID (car) so locking it down to only your set... But I'm getting ahead of myself, let's see the captures and go from there.

M-i-c-h-a-e-l1, 2025-01-25:
Hello,

I noticed the following today when driving with 2 cars: Sometimes when the trasnmitter A and car A are switched on and I switch on car B (and not the transmitter B), the two cars can be driven simultaneously by transmitter A. This already happened twice. I would need to do some tests to reproduce this consistently. No binding of car B is necessary.

Instead of soldering wires to the XNX297LBN could I also use a [SOIC8 SOP8 test clip](https://www.amazon.de/WINGONEER-SOIC8-EEPROM-Circuit-Programmierung-Adapter-SOP8-Test-Clip/dp/B012VSGQ0Q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) to make some dumps? I have never done this before, so no idea if this will be a success ...

LilTeo14, 2025-01-25:
I believe it’s possible, and I actually think it’s a great idea! However, I’m not an expert in this area. You would just need a logic analyzer. I use this one:

[Logic Analyzer on Amazon](https://amzn.eu/d/bu8DK6m)

It’s not the best quality, but it works. Of course, a higher-quality analyzer would be preferable if possible.

LilTeo14, 2025-01-25:
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

I've completed the tests and added the dumps to the OneDrive folder.

For the "lights" test, I toggled the switch 4 times. I also added an additional test for the hazards since there’s a button that activates or deactivates them. For this test, I pressed the button 4 times as well. Let me know if you need anything else!

pascallanger, 2025-01-25:
Based on your captures, I've done the easy part of decoding the normal packets content for the different channels and switches. I've updated my previous post https://github.com/pascallanger/DIY-Multiprotocol-TX-Module/issues/1063#issuecomment-2612928112 with the information and will continue to update it with new findings.
I don't think I'll have the time tomorrow, but the next step is to figure out the crc.

pascallanger, 2025-01-26:
> I noticed the following today when driving with 2 cars: Sometimes when the trasnmitter A and car A are switched on and I switch on car B (and not the transmitter B), the two cars can be driven simultaneously by transmitter A. This already happened twice. I would need to do some tests to reproduce this consistently. No binding of car B is necessary.

This shouldn't be possible with what I see on the none gyro TXs/cars since the address used to transmit is based on the car ID. So the car only listens to its own address nothing else and during the bind the car learns the TX ID, so even if 2 TXs are powered on when you power the car only one will be able to control the car.
Gyro cars might use a different protocol as there is no obvious space for an extra channel. I mean there are some free bits in P[4], P[5] and P[6] but it won't follow their current scheme on how they transmit channels.

M-i-c-h-a-e-l1, 2025-01-26:
Hello,

I hope that I will be able to do some dumps on the cars with the gyros. I have the logic analyser, but I am waiting for the test clip.

Could you please let me know if the following settings are ok for Logic 1.2.14 to do the dumps?

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

How do I connect the logic analyser correctly to the pins of the XN297LBW: MOSI (= Pin ?), MISO (=Pin ?), Clock (=Pin ?) and Enable (= Pin ?).

Please be patient with me, steep learning curve (I hope).

Kind regards
M

pascallanger, 2025-01-26:
> Could you please let me know if the following settings are ok for Logic 1.2.14 to do the dumps?

yes

> How do I connect the logic analyser correctly to the pins of the XN297LBW: MOSI (= Pin ?), MISO (=Pin ?), Clock (=Pin ?) and Enable (= Pin ?).

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
MOSI = DATA, MISO not connected, Clock =SCK, Enable = CSN and don't forget to connect GND to the Bat-. Anyway don't worry, it's easy to find out how you've plugged it, so really connect the 3 pins in green and GND.

pascallanger, 2025-01-26:
I've found a way to calculate the crc. It works for all the packets sent by the TX but the same calculation doesn't work on the packet received by the car (strangely). There is a constant in the crc which I don't know if it changes based on the TX ID or something else but 0x55 looks like a good init for the calculation.
Still completely unknown, the RF channels use for normal packets...

Anyway, I can code the protocol and get it to work with @LilTeo14's car. But don't expect too much as I fear it will only work with that TX ID/RF and car for now...
When there will be more TX and cars we might be able to find out more things.

pascallanger, 2025-01-27:
You are lucky! A friend has one of this car (without gyro) which he dropped on my desk this morning.
I've written the protocol using what I knew so far and some of his radio/car details. Tests were conclusive, driving the car around with my TX16s.
There was still one issue like said previously which was the RF channels in normal mode. I've changed the TX ID which is easy as I'm "owning" it but it had no impact on the RF channels so the conclusion is that the car/RX ID is the one that "decides" the RF channels. So I had to write the code of a car receiver, to push some car IDs to the original TX and get back the RF frequencies by scanning. After a few hours, I've been able to figure out the link between the RX_ID and the 3 RF channels of the normal mode.
So basically any car can be controlled from a Multi module which can use any TX ID.

Please try the [test version](https://nightly.link/pascallanger/DIY-Multiprotocol-TX-Module/workflows/main/master/multi-test-build.zip) v1.3.4.24 SFC and report. The doc is [here](https://github.com/pascallanger/DIY-Multiprotocol-TX-Module/blob/master/Protocols_Details.md#jiabaile---102).
Couple of things:
- The car remembers the TX ID so in theory you don't need to bind it every time. But I haven't implemented it so you need to bind each time which is not difficult with the bind on channel feature.
- It might work or not on gyro cars.
- The ST_TRIM channel is useless in my opinion, better use the radio trims. I've left it just in case the gyro cars need it.

M-i-c-h-a-e-l1, 2025-01-27:
Dear Pascal,

Great news and many thanks for your work! I will test it on my gyro car this week and I will let you know the reslts.

Kind regards
M

pascallanger, 2025-01-28:
@LilTeo14 Have you tested?

LilTeo14, 2025-01-28:
> @LilTeo14 Have you tested?

Hello!
I was away for a couple of days, but in just a few hours I’ll be able to sit down and test the protocol. Thank you so much for your patience, and I’ll be sure to keep you updated on any progress I make.

LilTeo14, 2025-01-28:
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

When I selected the model, I had the car turned on, and the radio automatically bound with the car. After that, every time I turn on the car, it connects automatically to the radio, even if I turn the radio off and back on. As for the channels, everything works perfectly. I tested all the features: speeds, lights, indicators, steering, and throttle, and everything works flawlessly.

pascallanger, 2025-01-28:
The thing I haven't implemented is that the module sends bind packets when the protocol is selected (power on or a bind request using either bind through UI or bind on channel). I could save the car ID in "eeprom" and therefore not launch any bind unless explicitly requested which could be useful if there are multiple people with the same cars around and prevent to bind everything around you. Let me know if this is worth it. Also I'm sending bind requests until I receive an answer from the car. I might want to only do that for 1 sec to make sure to not bind everything around too.

Otherwise that's good that everything works with your module ID and car ID!

Waiting to hear more from @M-i-c-h-a-e-l1 and his gyro cars.

pascallanger, 2025-01-29:
I've implemented a 2 second bind timeout and the storage of the car ID. So bind packets are only sent/needed when you bind a new car. You must use a different RX number per car, otherwise you just overwrite the previously saved car ID.

Please try the [test version](https://downloads.multi-module.org/latest-test/) 1.3.4.25 SFC. [Documentation](https://github.com/pascallanger/DIY-Multiprotocol-TX-Module/blob/master/Protocols_Details.md#jiabaile---102) updated.

M-i-c-h-a-e-l1, 2025-01-29:
Dear Pascal, dear LilTeo,

I tried both versions 1.3.4.24 SFC and 1.3.4.25 SFC and it is not possible to bind the radio to the gyro cars. I tried different receiver IDs, no binding.

The firmware tested was mm-stm-serial-aetr-sfc-v1.3.4.25.bin on my RM Zorro 4 in 1.

Kind regards
Michael

pascallanger, 2025-01-29:
I'm not too surprised since like I said the protocol doesn't really allow for the gyro channel.
I need either a dump over the air or a capture of the SPI bus to see what has changed (hopefully not much).

M-i-c-h-a-e-l1, 2025-01-29:
This is the hardware inside of the transmitter of the gyro cars:

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

It seems to be different from the non-gyro cars.

Kind regards
Michael

pascallanger, 2025-01-29:
There is no SPI bus to sniff since the PAN chip is an all in one integrating micro controller and RF.
You need to use capture over the air. This is done by connecting serially the multi module to a PC and load a debug firmware. If you have an external module, it's easy since you just need to leave the USB cabled plug, if that's an internal module you need to solder a serial converter to the module board. Is that something you can do?

M-i-c-h-a-e-l1, 2025-01-29:
Dear Pascal,

I do not have an external module and unfortunetely I can not solder to the internal module :-(

If someone else is willing to to the dump and you develop a new firmware I am of course ready to test.

Kind regards
Michael

pascallanger, 2025-01-29:
Looking at AliExpress a car with gyro costs 40€. If you are willing to participate to at least half of the cost, I can purchase one and reverse the protocol.

M-i-c-h-a-e-l1, 2025-01-29:
Dear Pascal,

I have sent you an email.

Kind regards
Michael

pascallanger, 2025-02-05:
I've received the car with gyro. It's a totally different protocol from a first look...

pascallanger, 2025-02-05:
XN297 1M Scrambled

Normal packets
---
RF: 18, 27, 53
Timing: 8205µs
Address (4) = 7D 82 28 C2

P(8)= 7F 80 02 FF 50 00 00 AF
P[0] = THR 68..80..A0
P[1] = ST 50..80..B0
P[2] = TH Rate 0->L, 1->M, 2->H
P[3] = Gyro FF..00 FF=off, 0=max
P[4] = 50 ??
          |04 light off
          |01 trim R (momentary)
          |02 trim L (momentary)
P[5] = 00 ??
P[6] = 00 ??
P[7] = check

pascallanger, 2025-02-06:
Ok, I think the protocol for gyro is now final.
@M-i-c-h-a-e-l1  Please try the [test version](https://nightly.link/pascallanger/DIY-Multiprotocol-TX-Module/workflows/main/master/multi-test-build.zip) 1.3.4.30 following the [documentation](https://github.com/pascallanger/DIY-Multiprotocol-TX-Module/blob/master/Protocols_Details.md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).
@LilTeo14 Please also test this version as I heavily touched the code of none gyro and I can't test it. There should be no change, just to check that I haven't broken it...

M-i-c-h-a-e-l1, 2025-02-06:
I have also noticed that on some occesions there is a strange behaviour when braking. One car has this more often, the other car only had this once. The only thing that can be done is to bind the car again to the transmitter and then usually then the braking behaviour changes. There are no settings available I know of which can change this.

Kind regards
Michael

pascallanger, 2025-02-06:
Bind the car: I've done that at least a hundred times to reverse the protocol and it had no effects...

Have you tried your cars?

M-i-c-h-a-e-l1, 2025-02-06:
I have made some tests and everything works as expected with a RM Zorro:

Car binds immediately to the transmitter.

CH1, steering,  pot gimbal -100 to 100 -> ok
CH2, throttle, pot gimbal -100 to 100 -> ok
CH3, gyroscope sensitivity S2 pot -100 to 100 -> ok
CH4, steering trim not tested
CH5, speed, 3-position switch, -100, 0, 100 ->ok
CH 6, light, 2-position switch -100 and 100-> ok
Ch7, light flash, momentary switch, press switch -100, release switch 100  -> ok (not a documented or possible function with the original tx for the gyor car)

All channels are moving in the right direction no servo reverse programming on the radion needed.

For the original and the RM Zorro this behavouor is the same:

Forward - reverse: Froward - brake lights on and stop, then only reverse and lights are off
Reverse - forward: Reverse - forward immediately, no stop and spinning tyres :-) even with rubber tyres.

Kind regards
Michael

pascallanger, 2025-02-06:
Great closing this issue then.

Closed 2025-02-06.

Thread 1069 (2025-01-31):

Park10 branded (wltoys) a160 J3-cub skylark

bad-andy-rc, 2025-01-31:
Recently picked up a Park10 branded version of WLToys' a160 j3-cub rc plane. I would love to bind to it using TX16s 4-in-1. I tried latest stable release v.1.3.4.0, and test release v1.3.4.27 under all protocols known to have worked with prior WLToy's versions. No luck, this board is different. It says P710x on it.

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

pascallanger, 2025-01-31:
Which type of multi module do you have? External by any chance?

bad-andy-rc, 2025-01-31:
It’s internal. Radiomaster TX16s 4-in-1.

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

pascallanger, 2025-01-31:
Do you have a 3.3V FTDI/serial converter that you can connect on your internal module? It requires to open the radio but the pins to connect to on the module are accessible.

pascallanger, 2025-01-31:
That's the 2 pins which need to be connected to use the debug mode on your PC: 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

bad-andy-rc, 2025-01-31:
I’m sorry I do not have one of these.

I work primarily in Mac OS. (But run windows under parallels) When I plug in the transmitter to USB it offers an option for “USB Serial (VCP)” but I don’t suppose that helps?

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

bad-andy-rc, 2025-01-31:
Something like this one would work? https://www.amazon.com/gp/product/B0BJKCSZZW/ref=ox_sc_act_title_1?smid=A1YZW40LYQY3L1&psc=1

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

pascallanger, 2025-01-31:
Yes perfect

bad-andy-rc, 2025-02-04:
Hi Pascal, I’ve received the adaptor - I haven’t done this before so please bear with me - I want to clarify I’ve connected the adaptor as you requested. The pins however are too large to fit the tx16s 4-in-1 holes you’ve ID'd. I can probably work around that just wanted to make sure that’s what you need?

Can I run debug mode as you requested… on a Mac? Or will I need windows?

￼

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

bad-andy-rc, 2025-02-04:
I have downloaded STM32CubeProgrammer. Will this be suitable?

I’ve made the connections. You mentioned "connect the module TX to the USB serial RX.” — Do you mean TX from the 4-in1 to RX as marked on the serial adaptor? Or TX to TX? (The white wire is TX to TX currently, is that correct?)

￼

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

pascallanger, 2025-02-04:
The picture is wrong...

Module|Serial
---|---
GND|GND
TX|RX

I don't know what the STM32CubeProgrammer can do but I don't think it will do it. Install putty if you don't need Arduino.
If you follow this: https://github.com/pascallanger/DIY-Multiprotocol-TX-Module/blob/master/docs/Advanced_XN297Ldump.md you should see the module booting when powering on the radio with a model that has your internal module enabled for Multi.

bad-andy-rc, 2025-02-04:
I’ve corrected the connections and I’m using a PC now to make things easier. Have putty running, but not seeing anything. Something about debug mode needs to be uploaded to the adaptor? https://github.com/pascallanger/DIY-Multiprotocol-TX-Module/blob/master/docs/Advanced_Debug.md

Do I need to follow this? If so what software tool is in the pics?

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

pascallanger, 2025-02-04:
The software in the pic is Arduino. But you can take any serial software...
For the module you need to install the latest debug firmware ftdi debug which is in this zip file : https://nightly.link/pascallanger/DIY-Multiprotocol-TX-Module/workflows/main/master/multi-test-build.zip

bad-andy-rc, 2025-02-04:
Ahh ok, this one? mm-stm-xn297dump-ftdidebug-v1.3.4.28
Just copy onto the SD and flash like usual?

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

bad-andy-rc, 2025-02-05:
I’m attempting to flash the multi-module with that firmware and receiving an error…

NEEDS FILE
Stm-opentx-noinv

￼

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

pascallanger, 2025-02-05:
Please test this file: [multi-stm-ftdi-1.3.4.28.bin.zip](https://github.com/user-attachments/files/18672469/multi-stm-ftdi-1.3.4.28.bin.zip)

bad-andy-rc, 2025-02-05:
Ok thank firmware loaded ok. Thanks. I’ve got putty running but don’t see anything during boot. Do I need to enable something elsewhere?

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

bad-andy-rc, 2025-02-05:
Yes, it does connect on COM4, and I’ve tried a few baud rates. But I never see anything on the screen.

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

pascallanger, 2025-02-05:
Try this version: [multi-stm-ftdi-1.3.4.28a.zip](https://github.com/user-attachments/files/18674677/multi-stm-ftdi-1.3.4.28a.zip)

bad-andy-rc, 2025-02-05:
Nothing with that firmware tone either.

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

pascallanger, 2025-02-05:
That's strange...
Can you take a picture of your setup?
The module should write some outputs when you select a model which is using it or boot the radio with a model using the module.

bad-andy-rc, 2025-02-05:
Sure, here’s some… I know it’s not clean/soldered (No way I could solder safely at that size) but I do see jitter and characters if I mess with the terminals so I know the wires are connected definitely beyond the radio.
￼￼￼

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

pascallanger, 2025-02-06:
That's really strange. Let me reproduce it when I'll be home this WE and get back to you.

bad-andy-rc, 2025-02-06:
Absolutely, thank you. FWIW, when I have the serial convertor connected to PC, it shows an always red light. I had it disconnected from PC last night but still attached to radio, working on other planes and was noticing various lights coming on and off. Green ones in the center, other red ones - and they would change when doing different radio tasks. I took that to mean the adaptor might be seeing some traffic from the radio?

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

pascallanger, 2025-02-06:
I would assume yes since the module sends something each time you change from one protocol to another.
What happens when you open putty and select a model with the LEDs changing? Don't hesitate to change from one model to another using a different protocol.

benlye, 2025-02-07:
@pascallanger I've been working on a board definition for internal serial debugging. I modded one of my radios so I could connect an FTDI adapter to the internal module for testing. I confirm that neither of the builds you posted generates serial debug output.

However, using the new board definition I compiled this binary, which does provide serial output.

@bad-andy-rc, give this binary a go. You should see readable serial output with baud set to 115200. If you don't get anything with this file then you should take a look at your wiring and connections.

[multi-stm-ftdi-1.3.4.30-ben.zip](https://github.com/user-attachments/files/18704940/multi-stm-ftdi-1.3.4.30-ben.zip)

pascallanger, 2025-02-07:
@benlye thanks!!!

bad-andy-rc, 2025-02-07:
@benlye I am getting output. Nice work! Now that this is achieved what output can I provide to help?

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

pascallanger, 2025-02-07:
Few questions:
 - How do you put the TX in bind mode?
   - Is it in bind each time you power it up?
   - Do you exit bind mode when you go up and down on throttle? Something else?
   - Does the TX needs to have the plane powered on to exit bind?
 - Does the TX need the plane to be on for the led to change its pattern after power on?

For the dumps, it depends a little on the above but you can do this anyway:
 - power on the TX in bind mode
 - create a new model, select the protocol XN297Dump and subprotocol auto
 - You should see on the output the module scanning all frequencies and bitrate. Let it do its thing. When it finds something it will start to analyze. When it finishes to look at the RF part, it will switch to identify features. At this stage, save the content of everything that has appeared and store it in a text file that you post here.
For the second dump, you do the same but in normal mode (exit bind). Just reload the model, it will start scanning again... Save the content and call it normal.txt.
At this stage we should see what bind and normal packets look like. The next step is to identify what the packet content is. When the module states identify sticks and features, move slowly the throttle down->up->down, save that to a throttle.txt file. Repeat the action with aileron, rudder, elevator and any other switches/buttons/special features that the plane has every time in a different file.

bad-andy-rc, 2025-02-07:
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
I performed the instructions through the first dump, attached here.  I will perform the rest this evening.

Thanks!
￼

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

Multiprotocol version: 1.3.4.30
Module Flash size: 128KB
EEPROM initialized: 0
Protocol selection switch reads as 0
Using bank 0
Module Id: d33ea96a
Init complete
Normal telem 0,1
Protocol selected: 1, sub proto 0, rxnum 0, option 0
Protocol selected: 1, sub proto 0, rxnum 0, option 0
Protocol selected: 63, sub proto 0, rxnum 0, option 0
XN297 dump, address length=5, bitrate=250K
Proto=XN297DP, nbr_sub=7, Sub=250Kbps, Opt=8, FS=0, CHMap=0, rfSw=2
Channel=0,0x00
Protocol selected: 63, sub proto 3, rxnum 0, option 0
XN297 dump, address length=5, bitrate=250K
Proto=XN297DP, nbr_sub=7, Sub=Auto  , Opt=8, FS=0, CHMap=0, rfSw=2
------------------------
Detecting XN297 packets.
XN297 dump, address length=5, bitrate=250K
Trying RF channel: 0,1,2,3,4,5,6,7,8,9,10,11,12,13,14,15,16,17,18,19,20,21,22,23,24,25,26,27,28,29,30,31,32,33,34,35,36,37,38,39,40,41,42,43,44,45,46,47,48,49,50,51,52,53,54,55,56,57,58,59,60,61,62,63,64,65,66,67,68,69,70,71,72,73,74,75,76,77,78,79,80,81,82,83,84
XN297 dump, address length=5, bitrate=1M
Trying RF channel: 0,1,2,3,4,5,6,7,8,9,10,11,12,13,14,15,16,17,18,19,20,21,22,23,24,25,26,27,28,29,30,31,32,33,34,35,36,37,38,39,40,41,42,43,44,45,46,47,48,49,50,51,52,53,54,55,56,57,58,59,60,61,62,63,64,65,66,67,68,69,70,71,72,73,74,75,76,77,78,79,80,81,82,83,84
XN297 dump, address length=5, bitrate=2M
Trying RF channel: 0,1,2,3,4,5,6,7,8,9,10,11,12,13,14,15,16,17,18,19,20,21,22,23,24,25,26,27,28,29,30,31,32,33,34,35,36,37,38,39,40,41,42,43,44,45,46,47,48,49,50,51,52,53,54,55,56,57,58,59,60,61,62,63,64,65,66,67,68,69,70,71,72,73,74,75,76,77,78,79,80,81,82,83,84
XN297 dump, address length=5, bitrate=250K
Trying RF channel: 0,1,2,3,4,5,6,7,8,9,10,11,12,13,14,15,16,17,18,19,20,21,22,23,24,25,26,27,28,29,30,31,32,33,34,35,36,37,38,39,40,41,42,43,44,45,46,47,48,49,50,51,52,53,54,55,56,57,58,59,60,61,62,63,64,65,66,67,68,69

Packet detected: bitrate=Using NRF
250K C=69 S=Y A= CC CC CC CC CC P(9)= 9C BB CC DD 84 24 20 00 97

--------------------------------
Identifying all RF channels in use.
Trying RF channel: 0,1,2,3,4,5,6,7,8,9,10,11,12,13,14,15,16,17,18,19,20,21,22,23,24,25,26,27,28,29,30,31,32,33,34,35,36,37,38,39,40,41,42,43,44,45,46,47,48,49,50,51,52,53,54,55,56,57,58,59,60,61,62,63,64,65,66,67,68,69
RX on channel: 69, Time:     0us P: 9C BB CC DD 84 24 20 00 97
RX on channel: 69, Time: 49448us P: 9C BB CC DD 84 24 20 00 97
RX on channel: 69, Time: 52415us P: 9C BB CC DD 84 24 20 00 97
RX on channel: 69, Time: 52378us P: 9C BB CC DD 84 24 20 00 97
RX on channel: 69, Time: 52419us P: 9C BB CC DD 84 24 20 00 97
RX on channel: 69, Time: 52387us P: 9C BB CC DD 84 24 20 00 97
RX on channel: 69, Time: 52393us P: 9C BB CC DD 84 24 20 00 97
RX on channel: 69, Time: 52414us P: 9C BB CC DD 84 24 20 00 97
RX on channel: 69, Time: 52394us P: 9C BB CC DD 84 24 20 00 97
Trying RF channel: ,70,71,72,73,74,75,76,77,78,79,80,81,82,83,84

1 RF channels identified: 69[9]
Keeping only RF channels with more than 6 packets: 69*
--------------------------------
Identifying RF channels order.
Time between CH:69 and CH:69
Time: 52390us
Time: 49036us
Time: 55320us
Time: 52369us

Channel order:
69:     0us
69: 49036us

--------------------------------
Identifying Sticks and features.
P: 9C BB CC DD 84 24 20 00 97

pascallanger, 2025-02-07:
It's a variant of the XK2 protocol.
The dump you've sent is what the plane sends to the TX.
The plane is currently waiting for an answer from the TX... So like if your TX is not turned on or not in bind mode or...

Extract from my XK2 protocol notes:
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

The bind RF frequency is different since yours is 69 instead of 71
In your case the plane ID is 84 24 20
The checksum calculation is also different P[8] = sum(P[0..7]) + CF. They've just added 10 so may be it's +10 everywhere?

Normally the TX answers with its ID (replacing the dummy bytes) and the plane acks before switching to normal packets.
Since they've changed the bind RF frequency and the checksum, I'm wondering how much they've changed the protocol... Without all the dumps it's hard to answer.

As you can see you must be extra clear on which state the TX is, which state the plane is and so on when doing the dumps. Usually the LED on the TX and plane changes to indicate the different phases so use this to report.

bad-andy-rc, 2025-02-07:
Here’s what I’m getting now. On the TX16s I am loading another model (FMS) then loading this model. I’ve attached the output…

￼
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

Bad frame RX
Multiprotocol version: 1.3.4.30
Module Flash size: 128KB
EEPROM initialized: 0
Protocol selection switch reads as 0
Using bank 0
Module Id: d33ea96a
Init complete
Normal telem 0,1
Protocol selected: 28, sub proto 0, rxnum 4, option 128
Bad frame RX
Multiprotocol version: 1.3.4.30
Module Flash size: 128KB
EEPROM initialized: 0
Protocol selection switch reads as 0
Using bank 0
Module Id: d33ea96a
Init complete
Normal telem 0,1
Protocol selected: 14, sub proto 0, rxnum 0, option 0
Bad frame RX
Multiprotocol version: 1.3.4.30
Module Flash size: 128KB
EEPROM initialized: 0
Protocol selection switch reads as 0
Using bank 0
Module Id: d33ea96a
Init complete
Normal telem 0,1
Protocol selected: 63, sub proto 3, rxnum 5, option 0
XN297 dump, address length=5, bitrate=250K
Proto=XN297DP, nbr_sub=7, Sub=Auto  , Opt=8, FS=0, CHMap=0, rfSw=2
------------------------
Detecting XN297 packets.
XN297 dump, address length=5, bitrate=250K
Trying RF channel: 0,1,2,3,4,5,6,7,8,9,10,11,12,13,14,15,16,17,18,19,20,21,22,23,24,25,26,27,28,29,30,31,32,33,34,35,36,37,38,39,40,41,42,43,44,45,46,47,48,49,50,51,52,53,54,55,56,57,58,59,60,61,62,63,64,65,66,67,68,69,70,71,72,73,74,75,76,77,78,79,80,81,82,83,84
XN297 dump, address length=5, bitrate=1M
Trying RF channel: 0,1,2,3,4,5,6,7,8,9,10,11,12,13,14,15,16,17,18,19,20,21,22,23,24,25,26,27,28,29,30,31,32,33,34,35,36,37,38,39,40,41,42,43,44,45,46,47,48,49,50,51,52,53,54,55,56,57,58,59,60,61,62,63,64,65,66,67,68,69,70,71,72,73,74,75,76,77,78,79,80,81,82,83,84
XN297 dump, address length=5, bitrate=2M
Trying RF channel: 0,1,2,3,4,5,6,7,8,9,10,11,12,13,14,15,16,17,18,19,20,21,22,23,24,25,26,27,28,29,30,31,32,33,34,35,36,37,38,39,40,41,42,43,44,45,46,47,48,49,50,51,52,53,54,55,56,57,58,59,60,61,62,63,64,65,66,67,68,69,70,71,72,73,74,75,76,77,78,79,80,81,82,83,84
XN297 dump, address length=5, bitrate=250K
Trying RF channel: 0,1,2,3,4,5,6,7,8,9,10,11,12,13,14,15,16,17,18,19,20,21,22,23,24,25,26,27,28,29,30,31,32,33,34,35,36,37,38,39,40,41,42,43,44,45,46,47,48,49,50,51,52,53,54,55,56,57,58,59,60,61,62,63,64,65,66,67,68,69,70,71,72,73,74,75,76,77,78,79,80,81,82,83,84
XN297 dump, address length=5, bitrate=1M
Trying RF channel: 0,1,2,3,4,5,6,7,8,9,10,11,12,13,14,15,16,17,18,19,20,21,22,23,24,25,26,27,28,29,30,31,32,33,34,35,36,37,38,39,40,41,42,43,44,45,46,47,48,49,50,51,52,53,54,55,56,57,58,59,60,61,62,63,64,65,66,67,68,69,70,71,72,73,74,75,76,77,78,79,80,81,82,83,84
XN297 dump, address length=5, bitrate=2M
Trying RF channel: 0,1,2,3,4,5,6,7,8,9,10,11,12,13,14,15,16,17,18,19,20,21,22,23,24,25,26,27,28,29,30,31,32,33,34,35,36,37,38,39,40,41,42,43,44,45,46,47,48,49,50,51,52,53,54,55,56,57,58,59,60,61,62,63,64,65,66,67,68,69,70,71,72,73,74,75,76,77,78,79,80,81,82,83,84
XN297 dump, address length=5, bitrate=250K
Trying RF channel: 0,1,2,3,4,5,6,7,8,9,10,11,12,13,14,15,16,17,18,19,20,21,22,23,24,25,26,27,28,29,30,31,32,33,34,35,36,37,38,39,40,41,42,43,44,45,46,47,48,49,50,51,52,53,54,55,56,57,58,59,60,61,62,63,64,65,66,67,68,69,70,71,72,73,74,75,76,77,78,79,80,81,82,83,84
XN297 dump, address length=5, bitrate=1M
Trying RF channel: 0,1,2,3,4,5,6,7,8,9,10,11,12,13,14,15,16,17,18,19,20,21,22,23,24,25,26,27,28,29,30,31,32,33,34,35,36,37,38,39,40,41,42,43,44,45,46,47,48,49,50,51,52,53,54,55,56,57,58,59,60,61,62,63,64,65,66,67,68,69,70,71,72,73,74,75,76,77,78,79,80,81,82,83,84
XN297
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

Thread 1085 (2025-03-08):

SGF22/J20 has no level calibration function

ror1948, 2025-03-08:
unable to do level calibration on SGF22/J20 plane KFPLAN KF700 J-20 Fighter
thanks

pascallanger, 2025-03-09:
I don't have this plane so I can't check. But if it's like the SG-F22, the calibration is done using the sticks and putting them in the corners. So nothing to do with multi in that case, just follow the original procedure and don't forget to adapt it to the mode you are in.

ror1948, 2025-03-09:
ok any chance you have copy of manual to show this procedure? or just give me more detailed procedure. thanks

rdba2k, 2025-03-09:
I checked the stock TX, there is no calibration button on it. Some FCs can calibrate the gyro when flying if the FC is not installed far away from the correct position. Check the FC installation, fly high and turn off gyro, watch the plane then land and adjust.

ror1948, 2025-03-09:
ok thanks will try in couple of months...too cold now..

pascallanger, 2025-03-14:
Here is how to reset the gyro (level calibration) on the SG-F22:

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

ror1948, 2025-03-14:
Thanks man.

thanks

  On Fri, Mar 14, 2025 at 5:59 a.m., ***@***.***> wrote:
Here is how to reset the gyro (level calibration) on the SG-F22:

image.png (view on web)

—
Reply to this email directly, view it on GitHub, or unsubscribe.
You are receiving this because you authored the thread.Message ID: ***@***.***>
pascallanger left a comment (pascallanger/DIY-Multiprotocol-TX-Module#1085)
Here is how to reset the gyro (level calibration) on the SG-F22:

image.png (view on web)

—
Reply to this email directly, view it on GitHub, or unsubscribe.
You are receiving this because you authored the thread.Message ID: ***@***.***>

Closed 2025-03-14.
