pascallanger/DIY-Multiprotocol-TX-Module/STM32 PCB/Flysky PL18/PL18_multiprotocol/PL18_multiprotocol.kicad_pcb

## KiCad design STM32 PCB/Flysky PL18/PL18_multiprotocol/PL18_multiprotocol.kicad_pcb (2022-11-17)

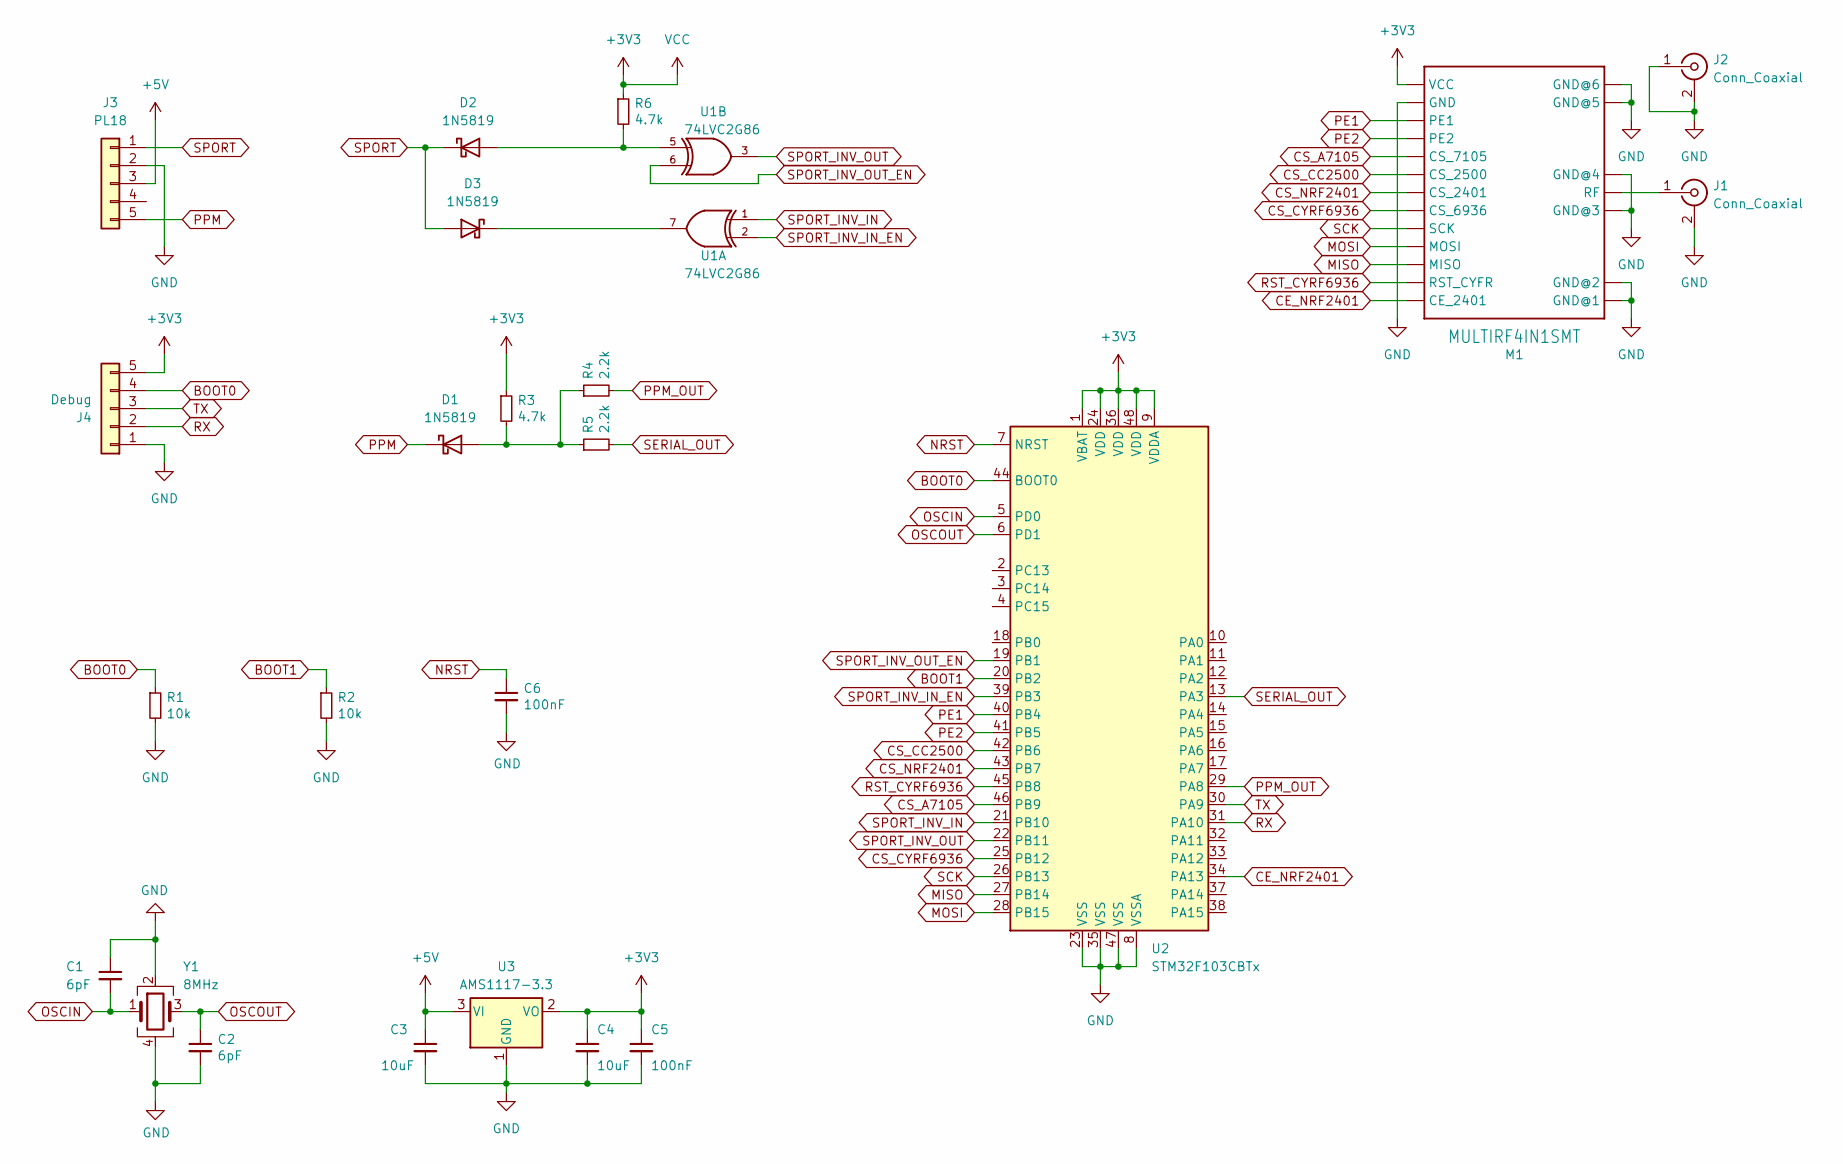
[picture p124: schematic PL18_multiprotocol.kicad_sch]

Parts:
C1, C2: 6pF; C_0603_1608Metric_Pad1.08x0.95mm_HandSolder
C3, C4: 10uF; C_0603_1608Metric_Pad1.08x0.95mm_HandSolder
C5, C6: 100nF; C_0603_1608Metric_Pad1.08x0.95mm_HandSolder
D1, D2, D3: 1N5819; D_SOD-123
J1, J2: Conn_Coaxial; MMCX_Molex_73415-1471_Vertical
J3: PL18; DS-B01F-A-S2
J4: Debug; JST_GH_BM05B-GHS-TBT_1x05-1MP_P1.25mm_Vertical
M1: MULTIRF4IN1SMT; MULTIRF4IN1-SMT
R1, R2: 10k; R_0603_1608Metric_Pad0.98x0.95mm_HandSolder
R3, R6: 4.7k; R_0603_1608Metric_Pad0.98x0.95mm_HandSolder
R4, R5: 2.2k; R_0603_1608Metric_Pad0.98x0.95mm_HandSolder
U1: 74LVC2G86; VSSOP-8_3.0x3.0mm_P0.65mm
U2: STM32F103CBTx; LQFP-48_7x7mm_P0.5mm
U3: AMS1117-3.3; SOT-223-3_TabPin2
Y1: 8MHz; Oscillator_SMD_Abracon_ASE-4Pin_3.2x2.5mm

Connections:
+3V3: C4.1, C5.1, J4.5, M1.VCC, R3.1, R6.1, U1.8 (VCC), U2.1 (VBAT), U2.9 (VDDA), U2.24 (VDD), U2.36 (VDD), U2.48 (VDD), U3.2 (VO)
+5V: C3.1, J3.3, U3.3 (VI)
BOOT0: J4.4, R1.1, U2.44 (BOOT0)
BOOT1: R2.1, U2.20 (PB2)
CE_NRF2401: M1.CE_2401, U2.34 (PA13)
CS_A7105: M1.CS_7105, U2.46 (PB9)
CS_CC2500: M1.CS_2500, U2.42 (PB6)
CS_CYRF6936: M1.CS_6936, U2.25 (PB12)
CS_NRF2401: M1.CS_2401, U2.43 (PB7)
GND: C1.1, C2.2, C3.2, C4.2, C5.2, C6.2, J1.2 (Ext), J2.1 (In), J2.2 (Ext), J3.2, J4.1, M1.GND, M1.GND@1, M1.GND@2, M1.GND@3, M1.GND@4, M1.GND@5, M1.GND@6, R1.2, R2.2, U1.4 (GND), U2.8 (VSSA), U2.23 (VSS), U2.35 (VSS), U2.47 (VSS), U3.1 (GND), Y1.2, Y1.4
MISO: M1.MISO, U2.27 (PB14)
MOSI: M1.MOSI, U2.28 (PB15)
NRST: C6.1, U2.7 (NRST)
unnamed: D1.2 (A), R3.2, R4.1, R5.1
unnamed: D2.2 (A), R6.2, U1.5
unnamed: D3.1 (K), U1.7
unnamed: J1.1 (In), M1.RF
OSCIN: C1.2, U2.5 (PD0), Y1.1
OSCOUT: C2.1, U2.6 (PD1), Y1.3
PE1: M1.PE1, U2.40 (PB4)
PE2: M1.PE2, U2.41 (PB5)
PPM: D1.1 (K), J3.5
PPM_OUT: R4.2, U2.29 (PA8)
RST_CYRF6936: M1.RST_CYFR, U2.45 (PB8)
RX: J4.2, U2.31 (PA10)
SCK: M1.SCK, U2.26 (PB13)
SERIAL_OUT: R5.2, U2.13 (PA3)
SPORT: D2.1 (K), D3.2 (A), J3.1
SPORT_INV_IN: U1.1, U2.21 (PB10)
SPORT_INV_IN_EN: U1.2, U2.39 (PB3)
SPORT_INV_OUT: U1.3, U2.22 (PB11)
SPORT_INV_OUT_EN: U1.6, U2.19 (PB1)
TX: J4.3, U2.30 (PA9)

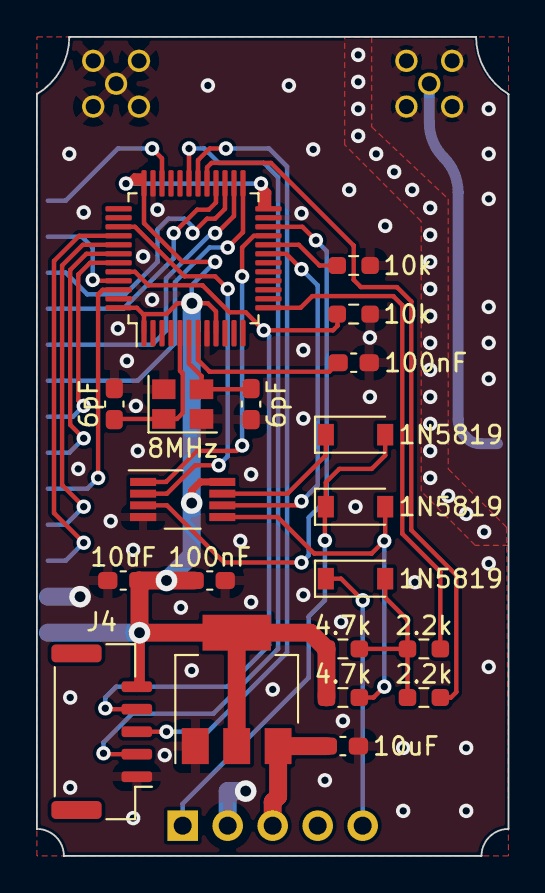
[picture p125: board PL18_multiprotocol.kicad_pcb from above]

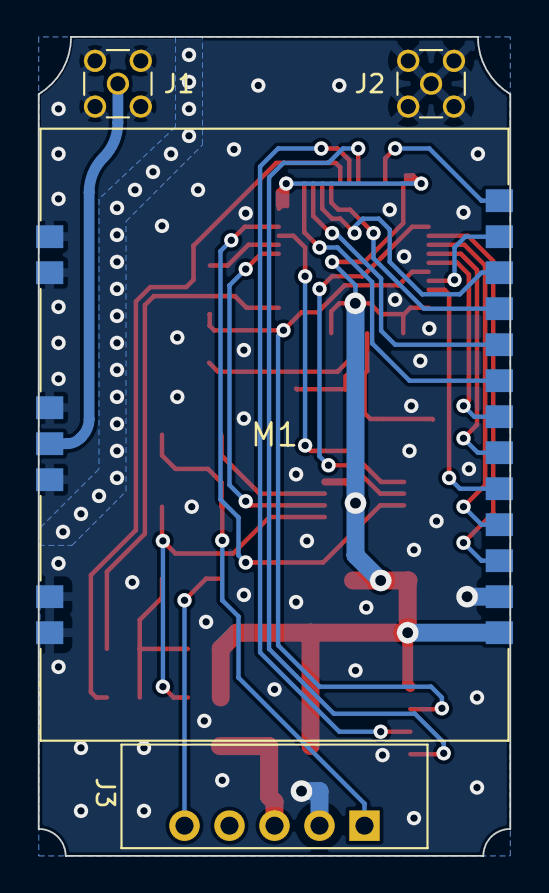
[picture p126: board PL18_multiprotocol.kicad_pcb from below]

Board: 2 copper layers, 26.2 x 45.5 mm, 24 parts (4 on the bottom side), 33 nets.
