pascallanger/DIY-Multiprotocol-TX-Module/PCB v2.3d/Multipro-txV2-3d.kicad_pcb

## KiCad design PCB v2.3d/Multipro-txV2-3d.kicad_pcb (2016-02-10)

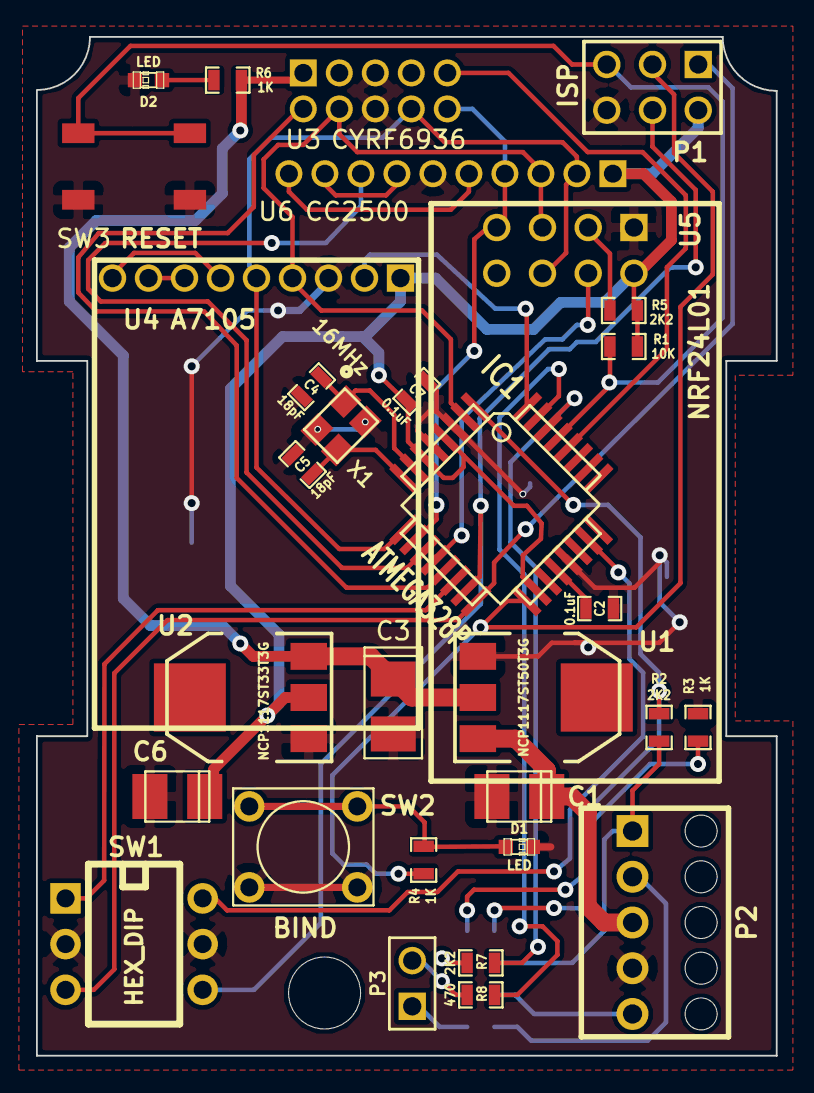
[picture p127: board Multipro-txV2-3d.kicad_pcb from above]

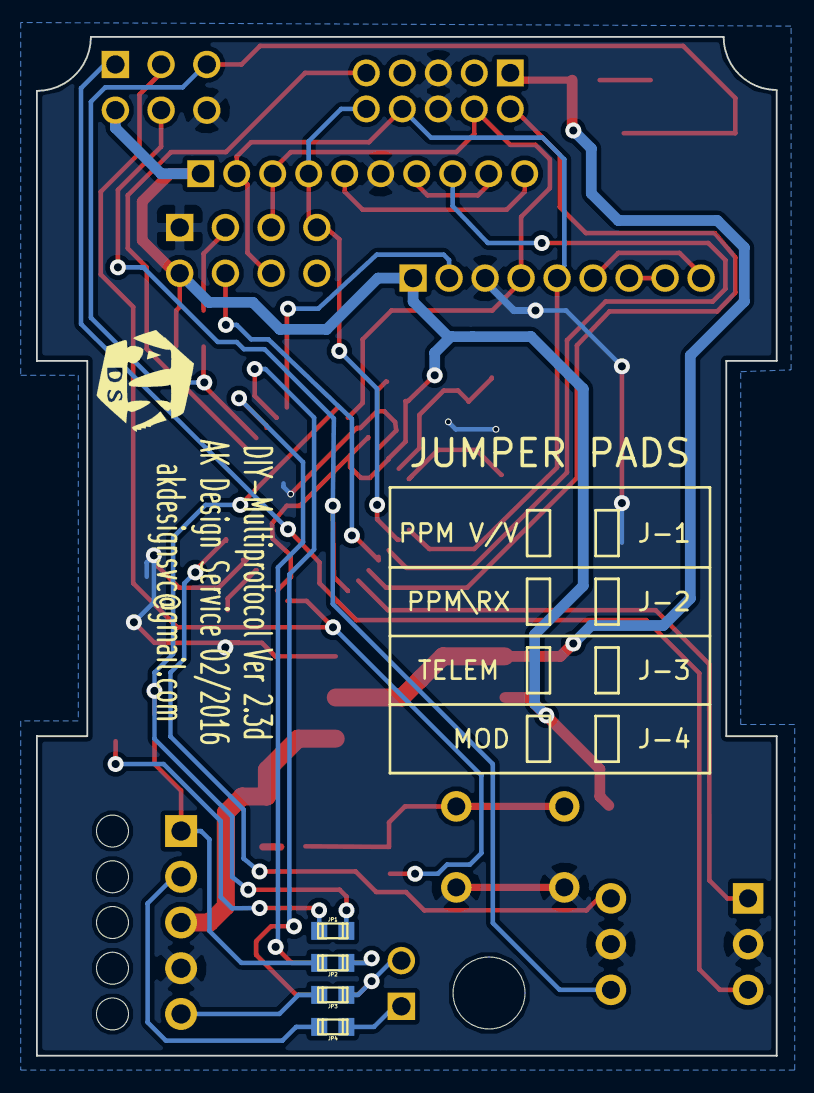
[picture p128: board Multipro-txV2-3d.kicad_pcb from below]

Board: 2 copper layers, 41.1 x 56.6 mm, 37 parts (5 on the bottom side), 38 nets.

Parts:
2_3d_jumper_table: VAL**; 2_3d_jumper_table
C1, C3, C6: 22uF; c_tant_B
C2, C7: 0.1uF; SM0603_Capa
C4, C5: 18pF; SM0603_Capa
D1, D2: LED; LED-0603
Hole_4mm: Hole_4mm
IC1: ATMEGA328P; TQFP32
JP1, JP2, JP3, JP4: JUMPER; c_0603
P1: ISP; pin_array_3x2
P2: CONN_5; MOLEX_4455_N2X5
P3: CONN_2; PIN_ARRAY_2X1
R1: 10K; SM0603_Resistor
R2, R5, R7: 2K2; SM0603_Resistor
R3, R4, R6: 1K; SM0603_Resistor
R8: 470; SM0603_Resistor
SW1: HEX_DIP; DIP-6__300
SW2: BIND; SW_PUSH_6x4.5MM
SW3: RESET; Switch_SMT5mm
U1: NCP1117ST50T3G; SOT223
U2: NCP1117ST33T3G; SOT223
U3: CYRF6936
U4: A7105; XL7105-D03B
U5: NRF24L01
U6: CC2500; header_10_2mm
X1: 16MHz; crystal_FA238-TSX3225

Connections:
3V3: C6.1, C7.1, IC1.4, IC1.6, IC1.18, P1.2, R1.1, R5.2, U2.2, U4.1, U5.2, U6.1
+5V: C3.1, R6.1, U1.2, U2.3, U3.1
/A0: IC1.23, SW1.6
/A7105_CSN: IC1.32, U4.2
/BATT: C1.1, P2.3, U1.3
/CC25_CSN: IC1.11, U6.8
/CC25_LANEN: U6.5, U6.10
/CC25_PAEN: U6.7, U6.9
/CYRF_CSN: IC1.13, U3.2
/CYRF_RST: IC1.28, U3.9
/D3: IC1.1, JP1.1, R2.1
/D10: IC1.14, SW1.1
/D11: IC1.15, P1.4, SW1.4
/D12: IC1.16, P1.1, SW1.3
/MISO: IC1.10, U3.10, U5.7, U6.4
/MOSI: IC1.9, U3.8, U4.5, U5.6, U6.2
/NRF_CE: R5.1, U5.3
/NRF_CSN: IC1.12, U5.4
/PB5: IC1.17, P1.3, R4.1
/PPM_IN: JP2.1, P2.1, R2.2
/RESET: IC1.29, P1.5, R1.2, SW3.1, SW3.2
/RX: IC1.30, R7.2
/SCK: IC1.2, U3.4, U4.4, U5.5, U6.3
/TX: IC1.31, R8.2
/xtl1: C4.2, IC1.7, X1.3
/xtl2: C5.1, IC1.8, X1.1
GND: C1.2, C2.2, C3.2, C4.1, C5.2, C6.2, C7.2, D1.2, D2.2, IC1.3, IC1.5, IC1.21, P1.6, P2.4, R3.2, SW1.2, SW1.5, SW2.3, SW2.4, SW3.3, SW3.4, U1.1, U2.1, U3.5, U3.6, U4.3, U5.1, U6.6, X1.2, X1.4
unnamed: D2.1, R6.2
unnamed: U4.7, U4.8
unnamed: U4.6, U4.9
unnamed: JP3.2, P3.2, R8.1
unnamed: JP3.1, P2.5
unnamed: JP4.2, P3.1
unnamed: JP2.2, R7.1
unnamed: JP1.2, R3.1
unnamed: JP4.1, P2.2
unnamed: D1.1, R4.2, SW2.1, SW2.2
unnamed: C2.1, IC1.20
