pascallanger/DIY-Multiprotocol-TX-Module/STM32 PCB/V1.1/Multiprotocol_STM32_MB_1.1_t.brd

## EAGLE design STM32 PCB/V1.1/Multiprotocol_STM32_MB_1.1_t.brd (2017-04-03)

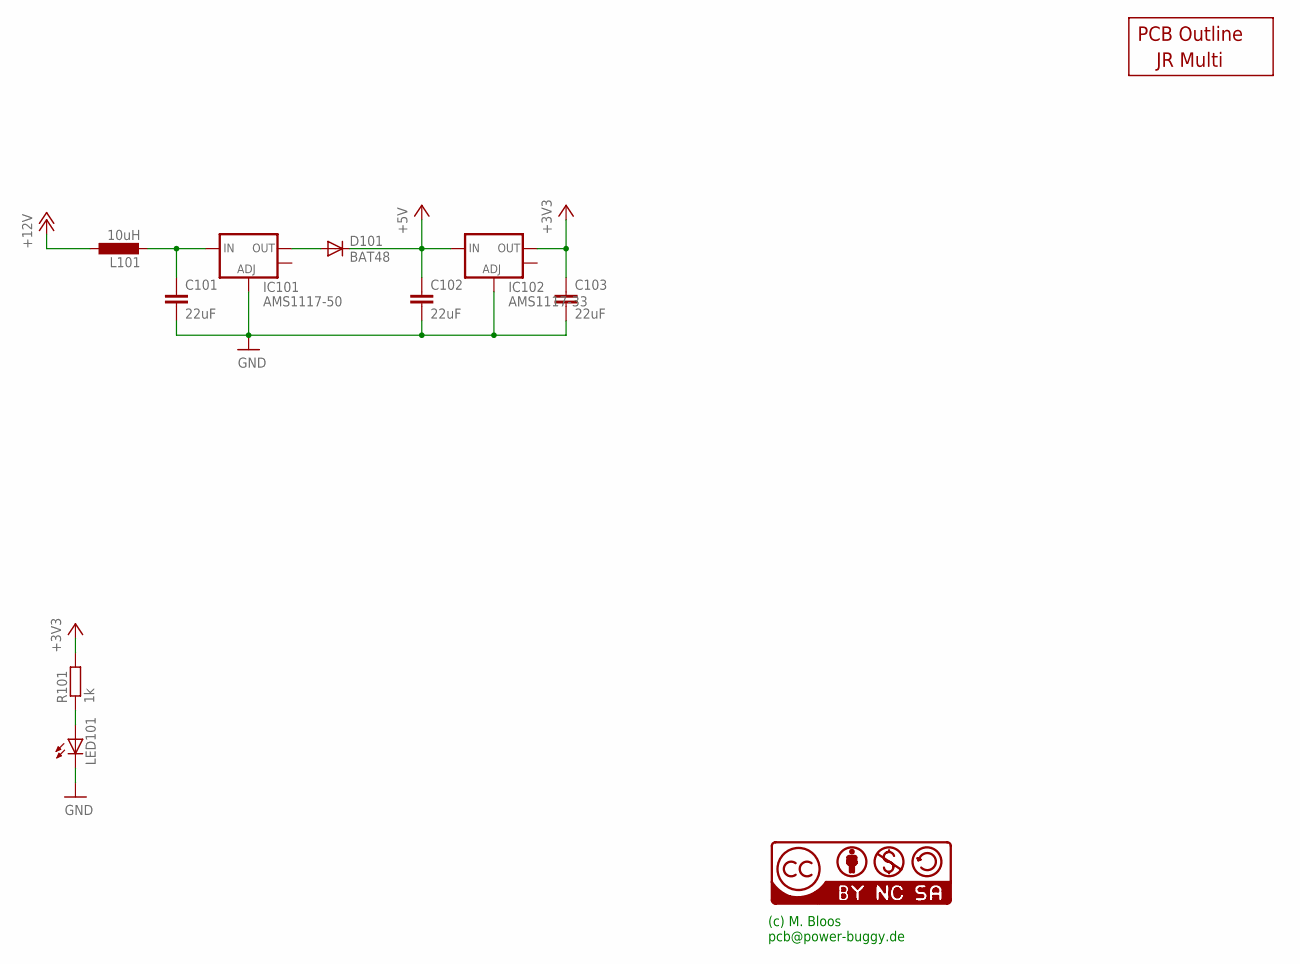
[picture p129: schematic Multiprotocol_STM32_MB_1.1_t.sch, sheet 1]

Parts:
C101, C102, C103: 22uF; C1210K
D101: BAT48; MINIMELF
IC101: AMS1117-50; SOT223
IC102: AMS1117-33; SOT223
L101: 10uH; L1812
LED101: LED3MM
NIX101: CC-NC-BCNIX; CC-NC-B_NIX
OUTLINE101: JR_MULTI
R101: 1k; R0805

Connections:
+3V3: C103.1, IC102.2 (OUT), R101.2; also elsewhere on the board
+5V: C102.1, D101.C, IC102.3 (IN); also elsewhere on the board
+12V: L101.1; also elsewhere on the board
GND: C101.2, C102.2, C103.2, IC101.1 (ADJ), IC102.1 (ADJ), LED101.K (C); also elsewhere on the board
unnamed: C101.1, IC101.3 (IN), L101.2
unnamed: LED101.A, R101.1
unnamed: D101.A, IC101.2 (OUT)

Notes on the sheet:
(c) M. Bloos pcb@power-buggy.de

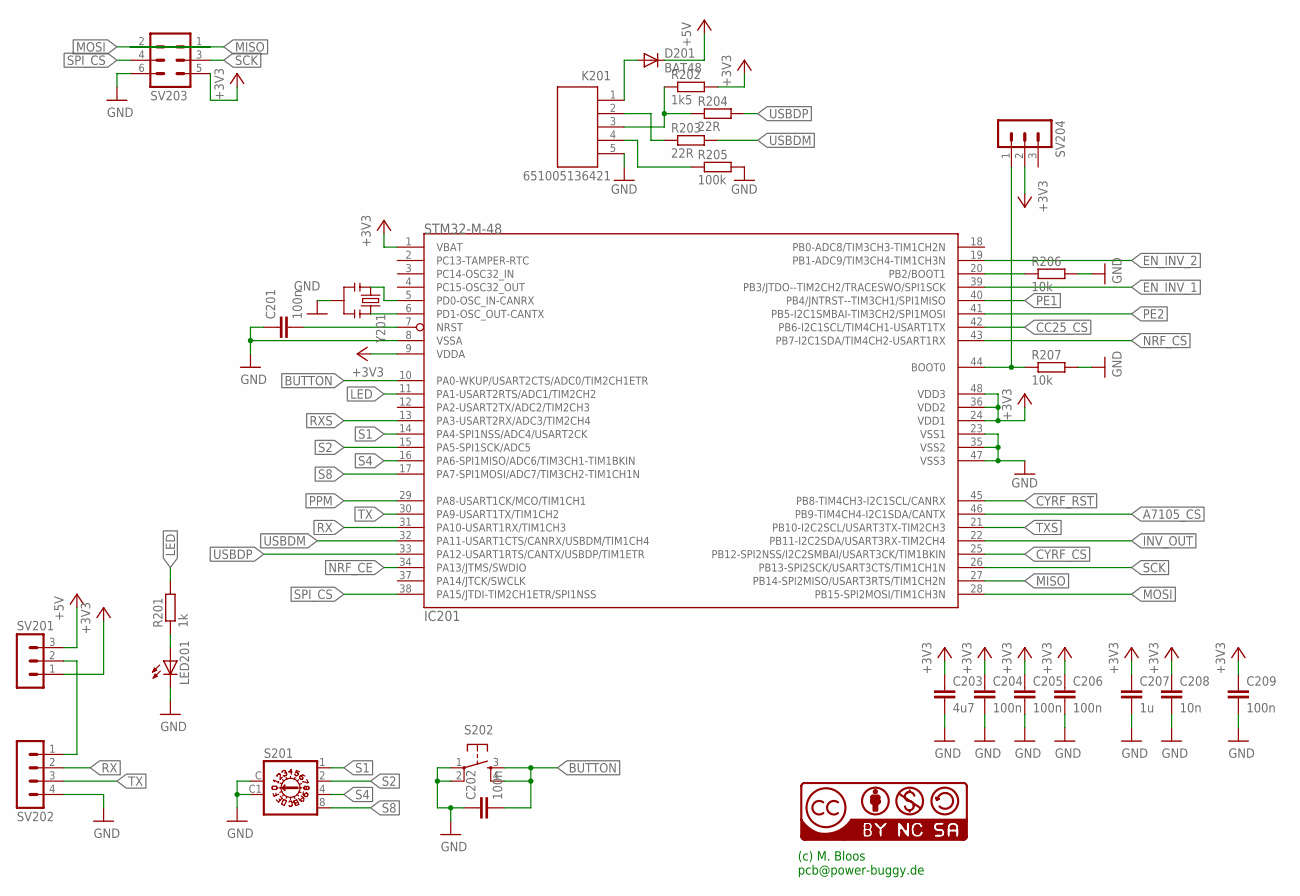
[picture p130: schematic Multiprotocol_STM32_MB_1.1_t.sch, sheet 2]

Parts:
C201, C202, C204, C205, C206, C209: 100n; C0805
C203: 4u7; C0805
C207: 1u; C0805
C208: 10n; C0805
D201: BAT48; MINIMELF
IC201: STM32-M-48; LQFP48
K201: 651005136421
LED201: LED3MM
NIX201: CC-NC-BCNIX; CC-NC-B_NIX
R201: 1k; R0805
R202: 1k5; R0805
R203, R204: 22R; R0805
R205: 100k; R0805
R206, R207: 10k; R0805
S201: A1353HEX
S202: TAC_SWITCHPTH; TACTILE-PTH
SV201, SV204: MA03-1
SV202: MA04-1
SV203: MA03-2
Y201: CSTCE8M00G52-R0; RESONATOR-SMD

Connections:
+3V3: C203.1, C204.1, C205.1, C206.1, C207.1, C208.1, C209.1, IC201.1 (VBAT), IC201.9 (VDDA), IC201.24 (VDD1), IC201.36 (VDD2), IC201.48 (VDD3), R202.2, SV201.1, SV203.5, SV204.2; also elsewhere on the board
+5V: D201.C, SV201.3; also elsewhere on the board
A7105_CS: IC201.46 (PB9-TIM4CH4-I2C1SDA/CANTX); also elsewhere on the board
BUTTON: C202.2, IC201.10 (PA0-WKUP/USART2CTS/ADC0/TIM2CH1ETR), S202.3, S202.4
CC25_CS: IC201.42 (PB6-I2C1SCL/TIM4CH1-USART1TX); also elsewhere on the board
CYRF_CS: IC201.25 (PB12-SPI2NSS/I2C2SMBAI/USART3CK/TIM1BKIN); also elsewhere on the board
CYRF_RST: IC201.45 (PB8-TIM4CH3-I2C1SCL/CANRX); also elsewhere on the board
EN_INV_1: IC201.39 (PB3/JTDO--TIM2CH2/TRACESWO/SPI1SCK); also elsewhere on the board
EN_INV_2: IC201.19 (PB1-ADC9/TIM3CH4-TIM1CH3N); also elsewhere on the board
GND: C201.1, C202.1, C203.2, C204.2, C205.2, C206.2, C207.2, C208.2, C209.2, IC201.8 (VSSA), IC201.23 (VSS1), IC201.35 (VSS2), IC201.47 (VSS3), K201.5, LED201.K (C), R205.2, R206.2, R207.2, S201.C, S201.C1 (NC), S202.1, S202.2, SV202.4, SV203.6, Y201.2; also elsewhere on the board
INV_OUT: IC201.22 (PB11-I2C2SDA/USART3RX-TIM2CH4); also elsewhere on the board
LED: IC201.11 (PA1-USART2RTS/ADC1/TIM2CH2), R201.2
MISO: IC201.27 (PB14-SPI2MISO/USART3RTS/TIM1CH2N), SV203.2; also elsewhere on the board
MOSI: IC201.28 (PB15-SPI2MOSI/TIM1CH3N), SV203.1; also elsewhere on the board
unnamed: IC201.5 (PD0-OSC_IN-CANRX), Y201.1
unnamed: IC201.6 (PD1-OSC_OUT-CANTX), Y201.3
unnamed: SV201.2, SV202.1
unnamed: K201.4, R205.1
unnamed: LED201.A, R201.1
unnamed: C201.2, IC201.7 (NRST)
unnamed: K201.3, R202.1, R204.1
unnamed: D201.A, K201.1
unnamed: K201.2, R203.1
unnamed: IC201.44 (BOOT0), R207.1, SV204.1
unnamed: IC201.20 (PB2/BOOT1), R206.1
NRF_CE: IC201.34 (PA13/JTMS/SWDIO); also elsewhere on the board
NRF_CS: IC201.43 (PB7-I2C1SDA/TIM4CH2-USART1RX); also elsewhere on the board
PE1: IC201.40 (PB4/JNTRST--TIM3CH1/SPI1MISO); also elsewhere on the board
PE2: IC201.41 (PB5-I2C1SMBAI-TIM3CH2/SPI1MOSI); also elsewhere on the board
PPM: IC201.29 (PA8-USART1CK/MCO/TIM1CH1); also elsewhere on the board
RX: IC201.31 (PA10-USART1RX/TIM1CH3), SV202.2
RXS: IC201.13 (PA3-USART2RX/ADC3/TIM2CH4); also elsewhere on the board
S1: IC201.14 (PA4-SPI1NSS/ADC4/USART2CK), S201.1
S2: IC201.15 (PA5-SPI1SCK/ADC5), S201.2
S4: IC201.16 (PA6-SPI1MISO/ADC6/TIM3CH1-TIM1BKIN), S201.4
S8: IC201.17 (PA7-SPI1MOSI/ADC7/TIM3CH2-TIM1CH1N), S201.8
SCK: IC201.26 (PB13-SPI2SCK/USART3CTS/TIM1CH1N), SV203.3; also elsewhere on the board
SPI_CS: IC201.38 (PA15/JTDI-TIM2CH1ETR/SPI1NSS), SV203.4
TX: IC201.30 (PA9-USART1TX/TIM1CH2), SV202.3
TXS: IC201.21 (PB10-I2C2SCL/USART3TX-TIM2CH3); also elsewhere on the board
USBDM: IC201.32 (PA11-USART1CTS/CANRX/USBDM/TIM1CH4), R203.2
USBDP: IC201.33 (PA12-USART1RTS/CANTX/USBDP/TIM1ETR), R204.2

Notes on the sheet:
(c) M. Bloos pcb@power-buggy.de

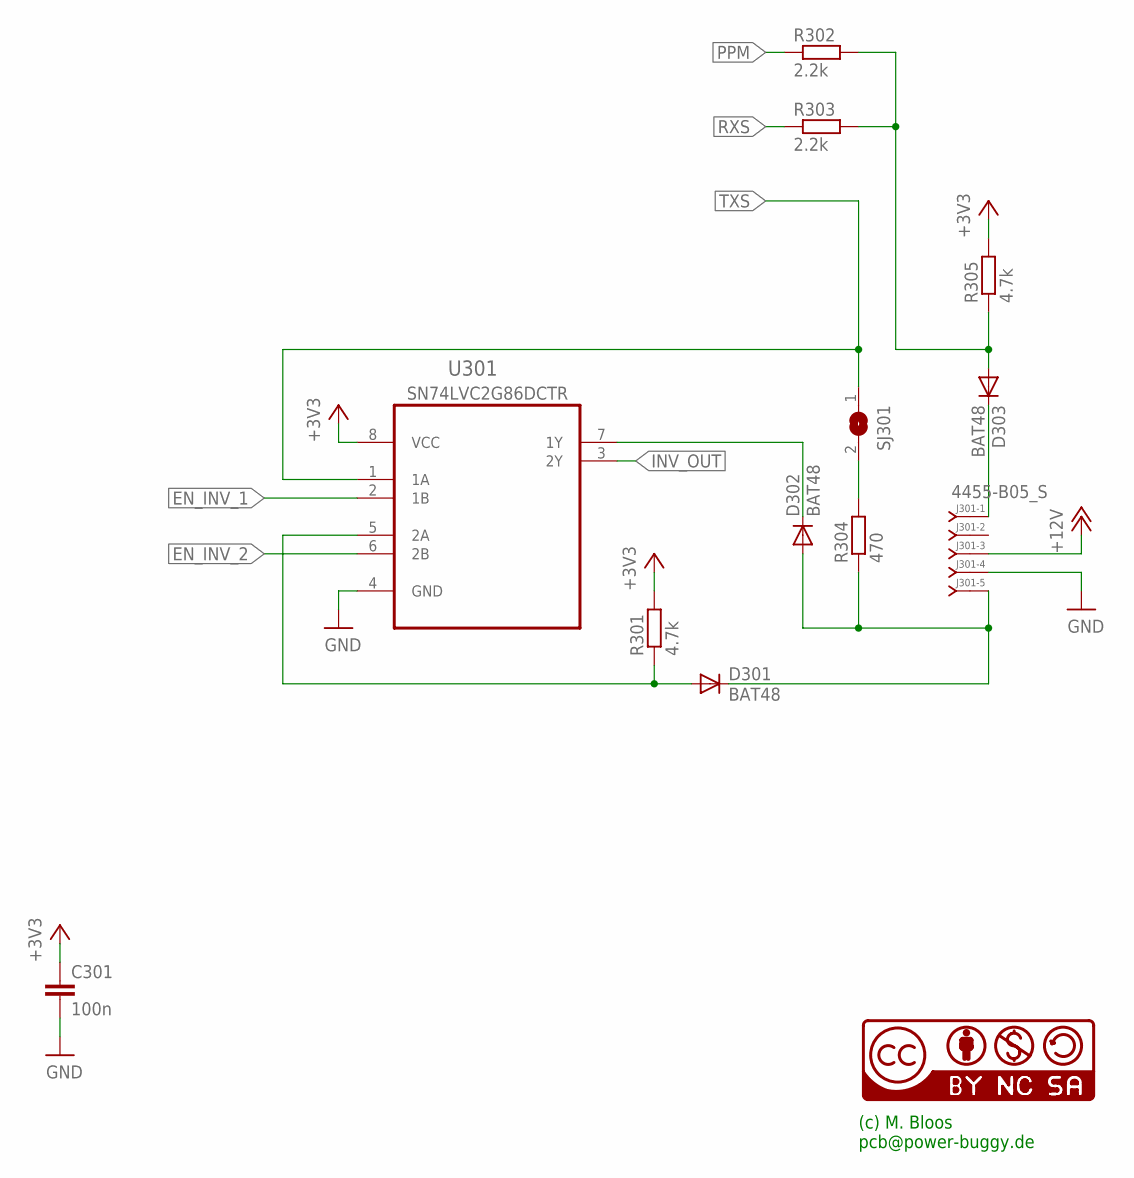
[picture p131: schematic Multiprotocol_STM32_MB_1.1_t.sch, sheet 3]

Parts:
C301: 100n; C0805
D301, D302, D303: BAT48; MINIMELF
J301: 4455-B05_S; 4455-B05
NIX301: CC-NC-BCNIX; CC-NC-B_NIX
R301, R305: 4.7k; R0805
R302, R303: 2.2k; R0805
R304: 470; R0805
SJ301: SJ
U301: SN74LVC2G00DCTR; SOP65P400X130-8N

Connections:
+3V3: C301.1, R301.2, R305.2, U301.8 (VCC); also elsewhere on the board
+12V: J301.3; also elsewhere on the board
EN_INV_1: U301.2 (1B); also elsewhere on the board
EN_INV_2: U301.6 (2B); also elsewhere on the board
GND: C301.2, J301.4, U301.4 (GND); also elsewhere on the board
INV_OUT: U301.3 (2Y); also elsewhere on the board
unnamed: D302.C, U301.7 (1Y)
unnamed: R304.2, SJ301.2
unnamed: D301.A, R301.1, U301.5 (2A)
unnamed: D301.C, D302.A, J301.5, R304.1
unnamed: D303.A, R302.2, R303.2, R305.1
unnamed: D303.C, J301.1
PPM: R302.1; also elsewhere on the board
RXS: R303.1; also elsewhere on the board
TXS: SJ301.1, U301.1 (1A); also elsewhere on the board

Notes on the sheet:
SN74LVC2G86DCTR
(c) M. Bloos pcb@power-buggy.de

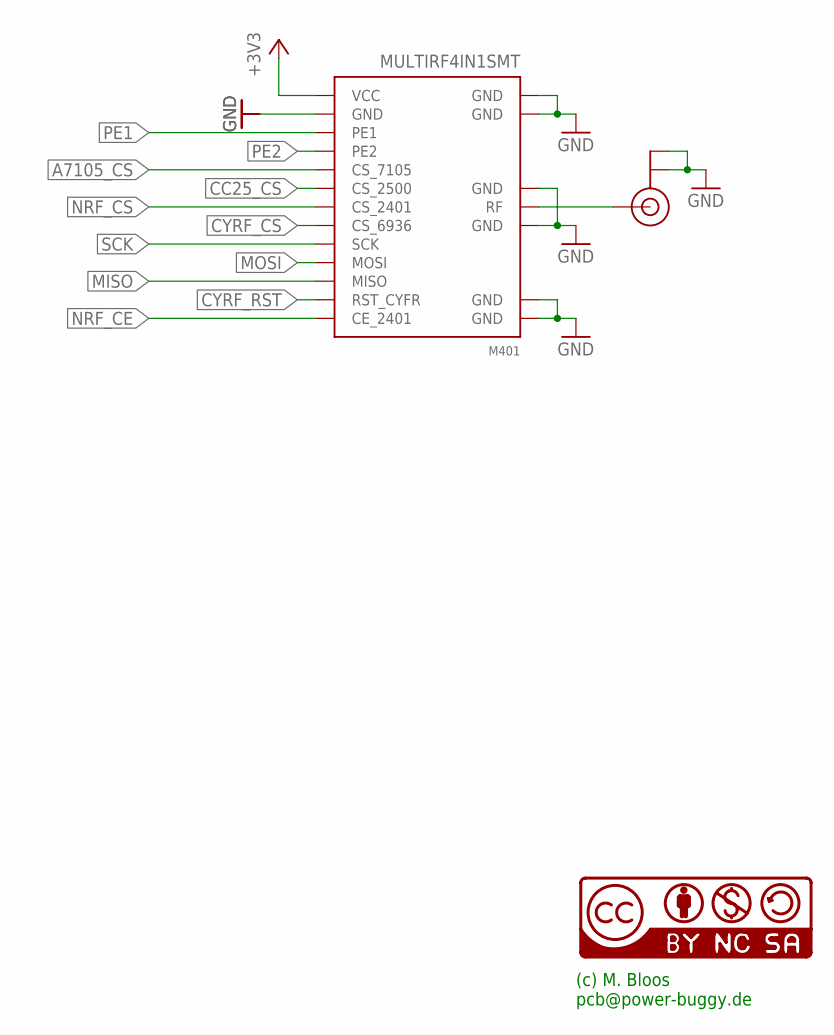
[picture p132: schematic Multiprotocol_STM32_MB_1.1_t.sch, sheet 4]

Parts:
CON401: U.FL
M401: MULTIRF4IN1SMT; MULTIRF4IN1-SMT
NIX401: CC-NC-BCNIX; CC-NC-B_NIX

Connections:
+3V3: M401.VCC; also elsewhere on the board
A7105_CS: M401.CS_7105; also elsewhere on the board
CC25_CS: M401.CS_2500; also elsewhere on the board
CYRF_CS: M401.CS_6936; also elsewhere on the board
CYRF_RST: M401.RST_CYFR; also elsewhere on the board
GND: CON401.P$1 (GND), CON401.P$2 (GND), M401.GND, M401.GND@1 (GND), M401.GND@2 (GND), M401.GND@3 (GND), M401.GND@4 (GND), M401.GND@5 (GND), M401.GND@6 (GND); also elsewhere on the board
MISO: M401.MISO; also elsewhere on the board
MOSI: M401.MOSI; also elsewhere on the board
unnamed: CON401.P$3 (SIGNAL), M401.RF
NRF_CE: M401.CE_2401; also elsewhere on the board
NRF_CS: M401.CS_2401; also elsewhere on the board
PE1: M401.PE1; also elsewhere on the board
PE2: M401.PE2; also elsewhere on the board
SCK: M401.SCK; also elsewhere on the board

Notes on the sheet:
(c) M. Bloos pcb@power-buggy.de

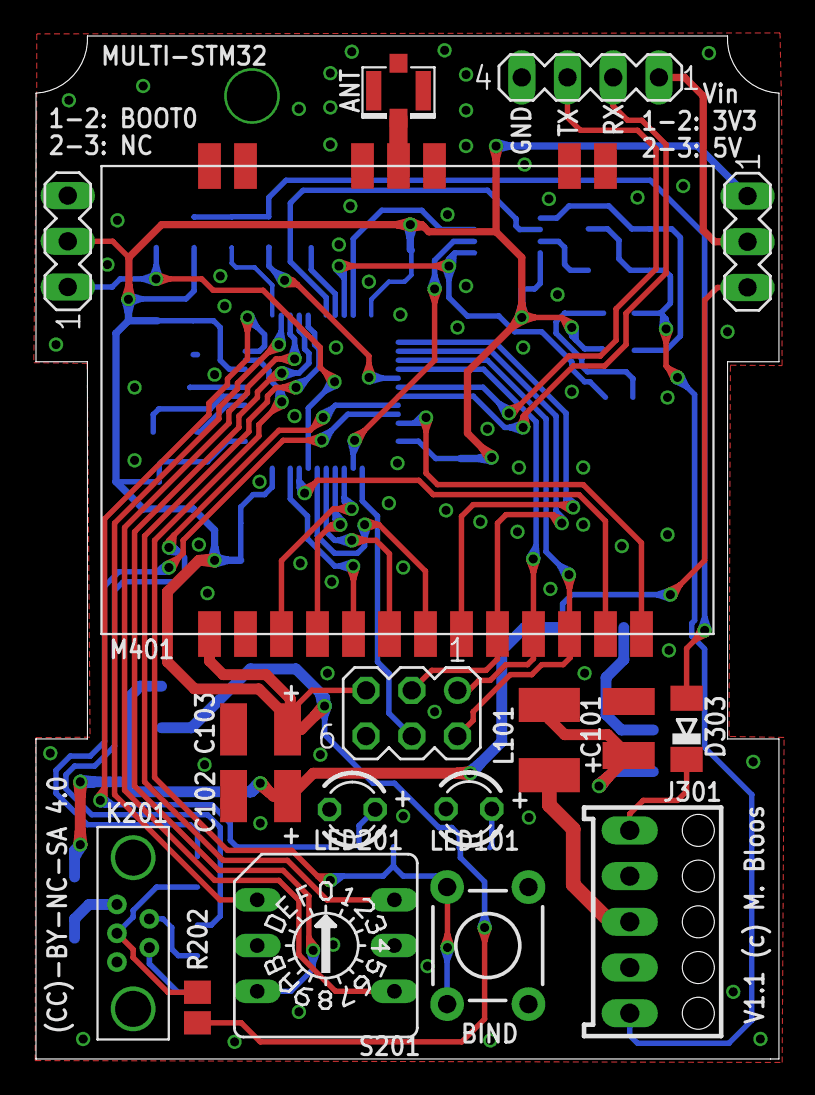
[picture p133: board Multiprotocol_STM32_MB_1.1_t.brd from above]

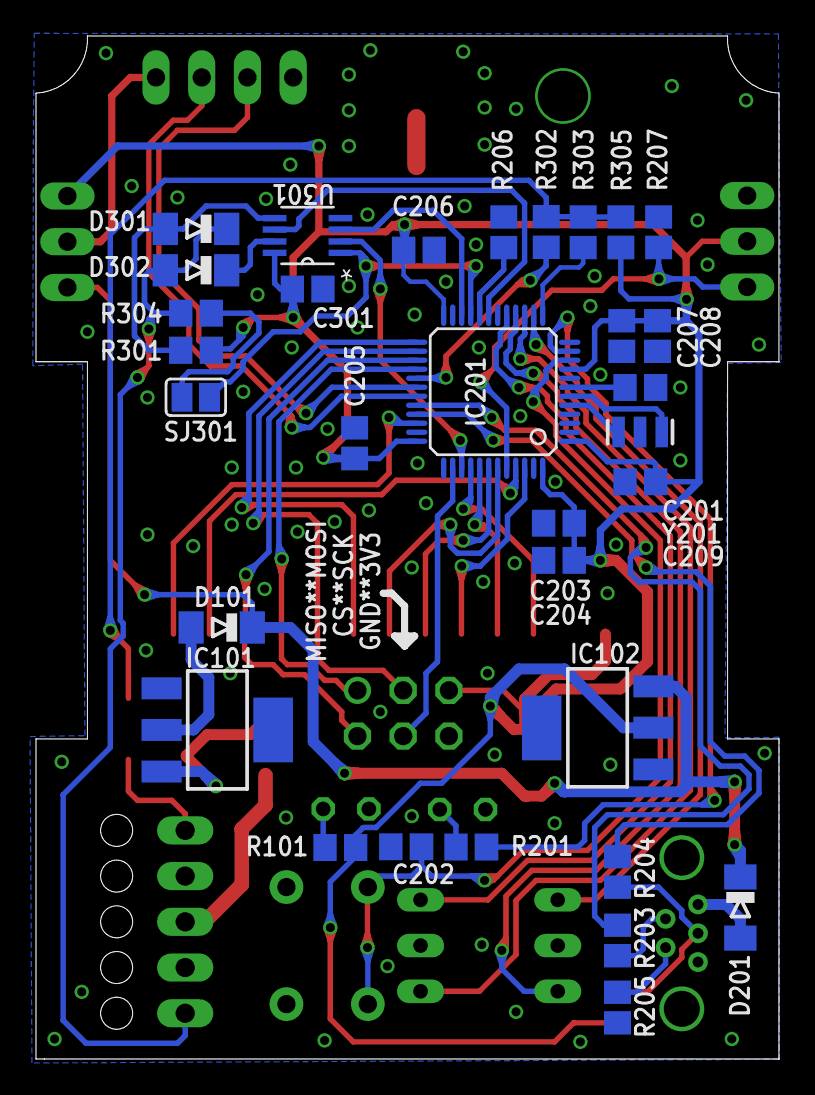
[picture p134: board Multiprotocol_STM32_MB_1.1_t.brd from below]

Board: 2 copper layers, 41.3 x 56.8 mm, 55 parts (32 on the bottom side), 53 nets.
