pascallanger/DIY-Multiprotocol-TX-Module/STM32 PCB/v0.1/Multi_STM32_V0.1.brd

## EAGLE design STM32 PCB/v0.1/Multi_STM32_V0.1.brd (2017-03-04, an earlier design)

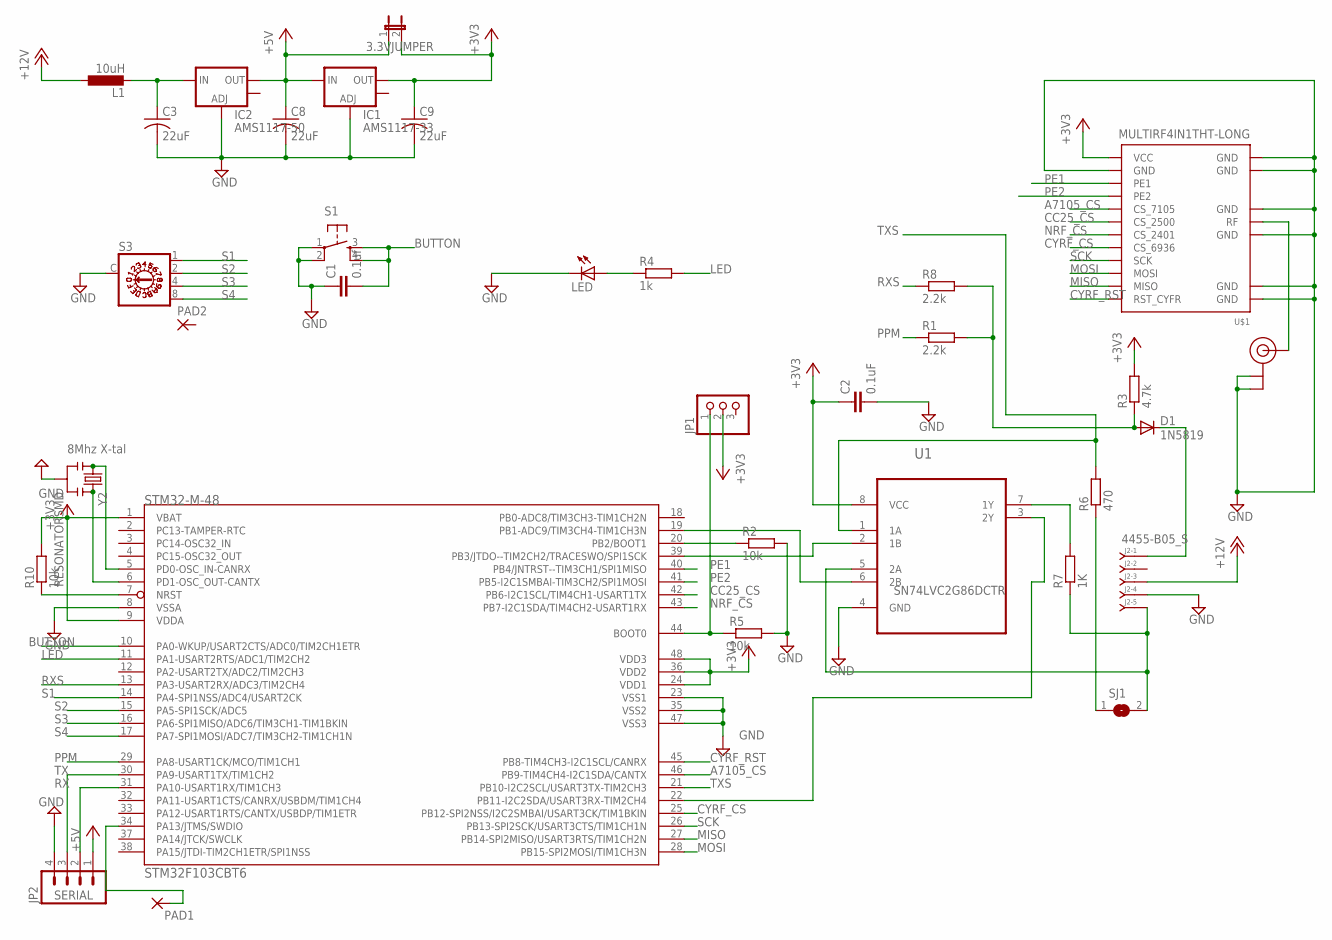
[picture p135: schematic Multi_STM32_V0.1.sch]

Parts:
3.3VJUMPER: JUMPER-2PTH; 1X02
C1: 0.1uf; C0805
C2: 0.1uF; C0805
C3, C8, C9: 22uF; C1206
D1: 1N5819; SMA-DIODE_ALT
IC1: AMS1117-33; SOT223
IC2: AMS1117-50; SOT223
J2: 4455-B05_S; 4455-B05
JP1: PINHD-1X3; 1X03
JP2: SERIAL; 1X04
L1: 10uH; L1812
LED: LED3MM
PAD1: SMD2; SMD1,27-2,54
PAD2: 1,6/0,8
R1, R8: 2.2k; R0805
R2, R5, R10: 10k; R0805
R3: 4.7k; R0805
R4: 1k; R0805
R6: 470; R0805
R7: 1K; R0805
S1: TAC_SWITCHPTH; TACTILE-PTH
S3: A1353HEX
SJ1: SJ
STM32F103CBT6: STM32-M-48; LQFP48
U1: SN74LVC2G00DCTR; SOP65P400X130-8N
U$1: MULTIRF4IN1THT-LONG; MULTIRF4IN1-THT-LONG
U$2: U.FL
Y2: RESONATORSMD; RESONATOR-SMD

Connections:
+3V3: 3.3VJUMPER.2, C2.1, C9.1, IC1.2 (OUT), JP1.2, R3.2, R10.2, STM32F103CBT6.1 (VBAT), STM32F103CBT6.9 (VDDA), STM32F103CBT6.24 (VDD1), STM32F103CBT6.36 (VDD2), STM32F103CBT6.48 (VDD3), U1.8 (VCC), U$1.VCC
+5V: 3.3VJUMPER.1, C8.1, IC1.3 (IN), IC2.2 (OUT), JP2.1
+12V: J2.3, L1.1
A7105_CS: STM32F103CBT6.46 (PB9-TIM4CH4-I2C1SDA/CANTX), U$1.CS_7105
BUTTON: C1.2, S1.3, S1.4, STM32F103CBT6.10 (PA0-WKUP/USART2CTS/ADC0/TIM2CH1ETR)
CC25_CS: STM32F103CBT6.42 (PB6-I2C1SCL/TIM4CH1-USART1TX), U$1.CS_2500
CYRF_CS: STM32F103CBT6.25 (PB12-SPI2NSS/I2C2SMBAI/USART3CK/TIM1BKIN), U$1.CS_6936
CYRF_RST: STM32F103CBT6.45 (PB8-TIM4CH3-I2C1SCL/CANRX), U$1.RST_CYFR
GND: C1.1, C2.2, C3.2, C8.2, C9.2, IC1.1 (ADJ), IC2.1 (ADJ), J2.4, JP2.4, LED.K (C), R2.2, R5.2, S1.1, S1.2, S3.C, STM32F103CBT6.8 (VSSA), STM32F103CBT6.23 (VSS1), STM32F103CBT6.35 (VSS2), STM32F103CBT6.47 (VSS3), U1.4 (GND), U$1.GND, U$1.GND@1 (GND), U$1.GND@2 (GND), U$1.GND@3 (GND), U$1.GND@4 (GND), U$1.GND@5 (GND), U$1.GND@6 (GND), U$2.P$1 (GND), U$2.P$2 (GND), Y2.2
LED: R4.2, STM32F103CBT6.11 (PA1-USART2RTS/ADC1/TIM2CH2)
MISO: STM32F103CBT6.27 (PB14-SPI2MISO/USART3RTS/TIM1CH2N), U$1.MISO
MOSI: STM32F103CBT6.28 (PB15-SPI2MOSI/TIM1CH3N), U$1.MOSI
unnamed: R6.1, SJ1.1
unnamed: STM32F103CBT6.5 (PD0-OSC_IN-CANRX), Y2.1
unnamed: STM32F103CBT6.6 (PD1-OSC_OUT-CANTX), Y2.3
unnamed: C3.1, IC2.3 (IN), L1.2
unnamed: STM32F103CBT6.39 (PB3/JTDO--TIM2CH2/TRACESWO/SPI1SCK), U1.2 (1B)
unnamed: STM32F103CBT6.22 (PB11-I2C2SDA/USART3RX-TIM2CH4), U1.3 (2Y)
unnamed: PAD1.1, STM32F103CBT6.34 (PA13/JTMS/SWDIO)
unnamed: R7.2, U1.7 (1Y)
unnamed: J2.5, R7.1, SJ1.2, U1.5 (2A)
unnamed: LED.A, R4.1
unnamed: R10.1, STM32F103CBT6.7 (NRST)
unnamed: STM32F103CBT6.19 (PB1-ADC9/TIM3CH4-TIM1CH3N), U1.6 (2B)
unnamed: D1.A, R1.2, R3.1, R8.2
unnamed: U$1.RF, U$2.P$3 (SIGNAL)
unnamed: D1.C, J2.1
unnamed: JP1.1, R5.1, STM32F103CBT6.44 (BOOT0)
unnamed: R2.1, STM32F103CBT6.20 (PB2/BOOT1)
NRF_CS: STM32F103CBT6.43 (PB7-I2C1SDA/TIM4CH2-USART1RX), U$1.CS_2401
PE1: STM32F103CBT6.40 (PB4/JNTRST--TIM3CH1/SPI1MISO), U$1.PE1
PE2: STM32F103CBT6.41 (PB5-I2C1SMBAI-TIM3CH2/SPI1MOSI), U$1.PE2
PPM: R1.1, STM32F103CBT6.29 (PA8-USART1CK/MCO/TIM1CH1)
RX: JP2.2, STM32F103CBT6.31 (PA10-USART1RX/TIM1CH3)
RXS: R8.1, STM32F103CBT6.13 (PA3-USART2RX/ADC3/TIM2CH4)
S1: S3.1, STM32F103CBT6.14 (PA4-SPI1NSS/ADC4/USART2CK)
S2: S3.2, STM32F103CBT6.15 (PA5-SPI1SCK/ADC5)
S3: S3.4, STM32F103CBT6.16 (PA6-SPI1MISO/ADC6/TIM3CH1-TIM1BKIN)
S4: S3.8, STM32F103CBT6.17 (PA7-SPI1MOSI/ADC7/TIM3CH2-TIM1CH1N)
SCK: STM32F103CBT6.26 (PB13-SPI2SCK/USART3CTS/TIM1CH1N), U$1.SCK
TX: JP2.3, STM32F103CBT6.30 (PA9-USART1TX/TIM1CH2)
TXS: R6.2, STM32F103CBT6.21 (PB10-I2C2SCL/USART3TX-TIM2CH3), U1.1 (1A)

Notes on the sheet:
SN74LVC2G86DCTR
8Mhz X-tal

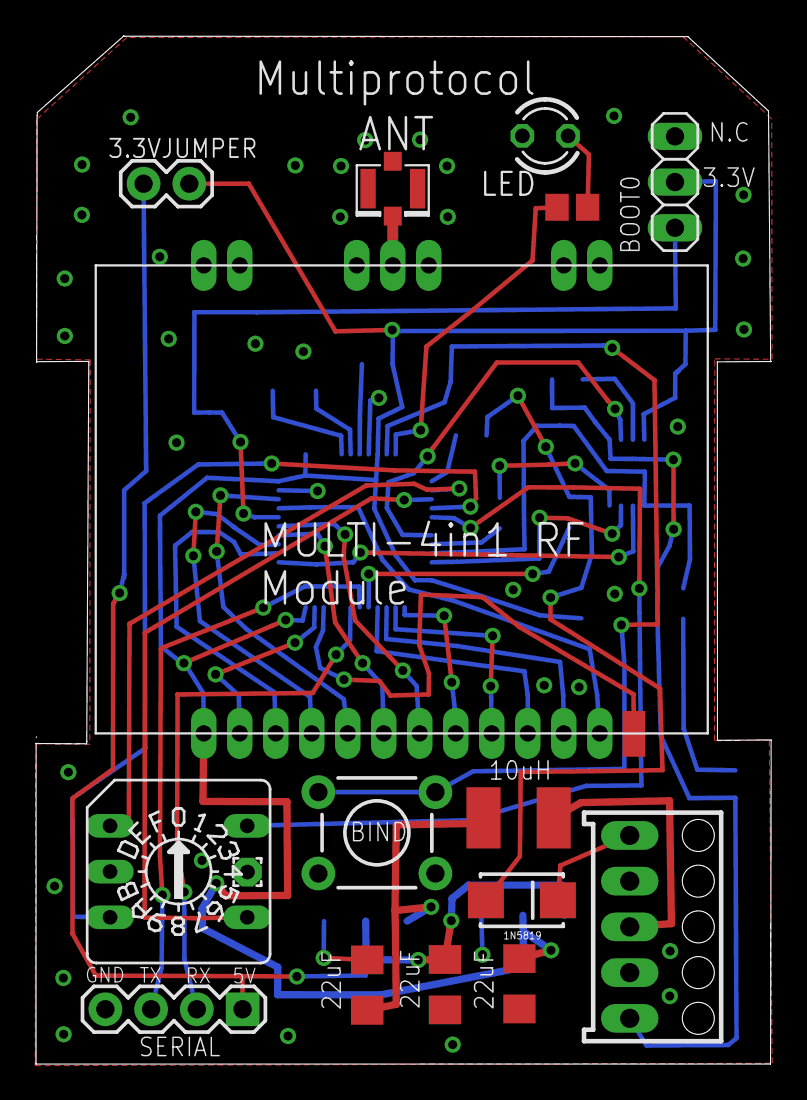
[picture p136: board Multi_STM32_V0.1.brd from above]

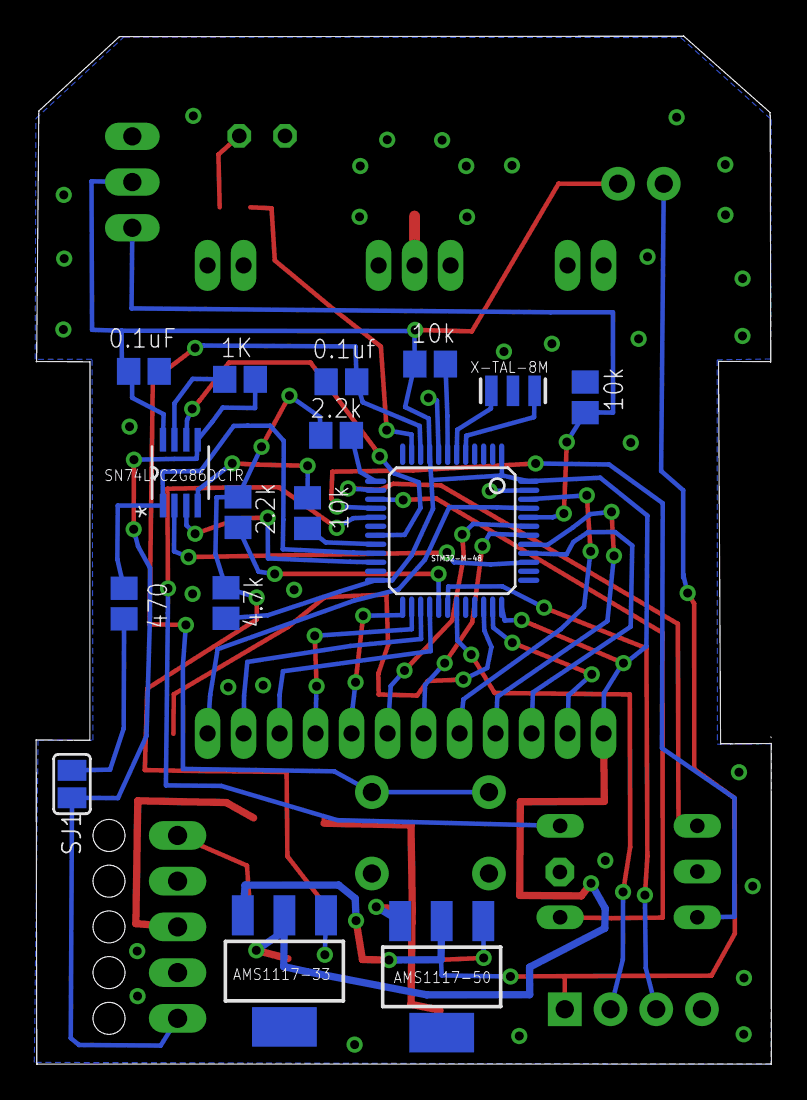
[picture p137: board Multi_STM32_V0.1.brd from below]

Board: 2 copper layers, 40.9 x 57.1 mm, 33 parts (16 on the bottom side), 42 nets.
