pascallanger/DIY-Multiprotocol-TX-Module/(commit log)

2016-01-19 Added one more LED status: flash in case of invalid protocol selected
2016-01-20 Core and all protocols have been updated
    Lot of changes in this new master
    ChangeLog:
    - Core: LED flashing when an invalid protocol has been selected
    - Core: Channels 5 to 12 available as switches for all protocols: code
    and size optimization
    - Documentation (readme.md): fully updated, all protocols/sub
    protocols/channels described, models example, many improvements
    - All protocols have been updated in some way, here are some highlights:
    * Bayang: added picture, video and inverted channels
    * CG023->H8_3D: added light and calibration channels
    * CX10: added sub protocols Q282, JC3015_1, JC3015_2, MK33041
    * ESky: added new protocol - untested
    * Hubsan: added compatibility with the new Hubsan Pl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
    [A7105_SPI.ino, Bayang_nrf24l01.ino, CC2500_SPI.ino, CG023_nrf24l01.ino, CX10_nrf24l01.ino, CYRF6936_SPI.ino, DSM2_cyrf6936.ino, Devo_cyrf6936.ino]
2016-01-23 Fix: removed reset of nrf24l01 if not previously used...
    [Multiprotocol.ino]
2016-01-23 Fix typo in ESky
    [ESky_nrf24l01.ino]
2016-01-25 Couple of edits...
2016-01-25 HK310: 2 packets per 5ms + Core: reset CC2500 at boot
    [Hisky_nrf24l01.ino, Multiprotocol.ino]
2016-01-26 Fix: Update_aux_flags missplaced for PPM input
    [FrSky_cc2500.ino, Multiprotocol.ino]
2016-01-27 Hub telemetry and fix compilation warnings/errors if protocols are commented
    [Bayang_nrf24l01.ino, CG023_nrf24l01.ino, CX10_nrf24l01.ino, DSM2_cyrf6936.ino, Devo_cyrf6936.ino, ESky_nrf24l01.ino, FlySky_a7105.ino, FrSky_cc2500.ino]
2016-01-28 Fix: Arduino 1.6.7 compilation issues
    [Multiprotocol.ino, Telemetry.ino]
2016-01-28 Arduino 1.6.7 support
2016-01-28 Added: Display error messages if wrong board type is selected at compilation time
2016-01-28 Fix: small bug in telemetry for Hubsan
    [Telemetry.ino]
2016-01-28 Fix: Hubsan telemetry packet check function & Change: Telemetry variables to static
    [Hubsan_a7105.ino, Telemetry.ino]
2016-01-28 Revert "Fix: Hubsan telemetry packet check function & Change: Telemetry variables to static"
    This reverts commit ac78ddcc8240970b153ad0fddad54e8800187656.
    [Hubsan_a7105.ino, Telemetry.ino]
2016-01-28 Fix: Hubsan telemetry packet check function
    [Hubsan_a7105.ino]
2016-02-10 PCB v2.3d
    [Multipro-txV2-3d.kicad_pcb, Multipro-txV2-3d.sch]
2016-02-10 PCB v2.3d pictures
2016-02-10 PCB v2.3d details
2016-03-03 Add Arduino Mini has a supported platform.
2016-04-06 Multi core fixes, DSM2/X fixes and telemetry, SFHSS addition, Flysky fixes, FrSkyX full telemetry and sub protocols
    Many things since last commit...
    [CC2500_SPI.ino, CYRF6936_SPI.ino, DSM2_cyrf6936.ino, FlySky_a7105.ino, FrSkyX_cc2500.ino, FrSky_cc2500.ino, Multiprotocol.h, Multiprotocol.ino]
2016-04-06 Added all CC2500 power settings
2016-04-10 DSM2/X pncodes fix and FrSky RSSI&TSSI swap fix
    [DSM2_cyrf6936.ino, Multiprotocol.h, Multiprotocol.ino, Telemetry.ino, _Config.h]
2016-04-18 Fixed xn297 scramble mode affecting cx-10a and probably other xn297 based protocols...
    [CX10_nrf24l01.ino, NRF24l01_SPI.ino]
2016-07-27 New BG board
2016-07-27 BG board might need a resistor change to fix bind.
2016-07-28 Couple of optimizations
2016-08-01 Arduino 1.6.10 and extra optimization
2016-08-02 Revert throttle on MT99xx...
    [MT99xx_nrf24l01.ino]
2016-08-15 Invert serial, optimization and SFHSS
    [A7105_SPI.ino, CC2500_SPI.ino, CYRF6936_SPI.ino, DSM2_cyrf6936.ino, Devo_cyrf6936.ino, FlySky_a7105.ino, FrSkyX_cc2500.ino, Multiprotocol.h]
2016-08-21 ASSAN protocol, FQ777 compilation fix on older Arduino
    [ASSAN_nrf24l01.ino, CYRF6936_SPI.ino, FQ777_nrf24l01.ino, Multiprotocol.h, Multiprotocol.ino, SHENQI_nrf24l01.ino, _Config.h]
2016-08-21 Fixed disable telemetry compilation issue
    [Multiprotocol.ino]
2016-08-24 New _Config.h file, MJXQ fix, 16 bit regs
    [A7105_SPI.ino, ASSAN_nrf24l01.ino, DSM2_cyrf6936.ino, Devo_cyrf6936.ino, FrSkyX_cc2500.ino, Hisky_nrf24l01.ino, MJXQ_nrf24l01.ino, Multiprotocol.h]
2016-08-25 Couples of fixes and improvements
    [Multiprotocol.h, Multiprotocol.ino]
2016-08-27 DEVO PPM fixed id mode
    [Devo_cyrf6936.ino, Multiprotocol.h, Multiprotocol.ino]
2016-08-31 Important changes of the scheduler and interrupts
2016-09-01 Fixed invert serial compilation
    [Multiprotocol.ino]
2016-09-10 Fix hontai code for X5C1
    [Hontai_nrf24l01.ino]
2016-09-12 Fix global ID random
    [ASSAN_nrf24l01.ino, FrSkyX_cc2500.ino, Hubsan_a7105.ino, Multiprotocol.ino]
2016-09-12 Orange TX module compilation fixes
    [CYRF6936_SPI.ino, Multiprotocol.ino]
2016-09-16 PPM Telemetry: added serial speeds
    Only supported for none invert telemetry:
    FrSkyD (Incl Hubsan): 9600bps
    FrSkyX: 57600bps
    DSM: 125000bps
    [Multiprotocol.h, Multiprotocol.ino, Telemetry.ino]
2016-09-16 Fix LED blink in PPM mode
    [Multiprotocol.ino]
2016-09-16 DSM revert changes due to issues
    [DSM_cyrf6936.ino]
2016-09-22 OrangeTX Cyrf reset pin
2016-09-23 DSM: Fix Orange RX
    Removed Col8 completely from the equation since there are too many
    issues with it.
    Code cleaning.
    [DSM_cyrf6936.ino]
2016-09-25 DSM: 11ms max 10ch after switch to 22ms map
2016-10-16 STM32 board & DSM fixes
    Loads of changes:
    STM32 board introduction: NOT TESTED
    XMEGA renamed to ORANGE_TX to be more explicit
    DSM: added reset if cyrf freezed
    Validate: added a validate file to verify the different compilation
    options
    [A7105_SPI.ino, Arduino.ino, CC2500_SPI.ino, CYRF6936_SPI.ino, Convert.ino, DSM_cyrf6936.ino, Devo_cyrf6936.ino, FrSkyX_cc2500.ino]
2016-10-16 Move map redefinition to arduino.ino
2016-10-16 Added Arduino.h for stm32 board
2016-10-17 Fix for STM32 board
    [Multiprotocol.ino, Telemetry.ino]
2016-10-20 AFHDS2A protocol addition: UNTESTED
    Protocol number: 28
    Sub protocols: PWM_IBUS = 0, PPM_IBUS = 1, PWM_SBUS = 2, PPM_SBUS = 3
    Option value =0->50Hz, =1->400Hz, =2->5Hz
    Extended channel range supported
    Telemetry supported for voltage and RSSI (RX RSSI)
2016-10-20 AFHDS2A: option value changed
    Option value should be between 0 and 70 which gives a value between 50
    and 400Hz (value in Hz = 50 + 5*option)
2016-10-20 Fixed compilation issues due to AFHDS2A introduction
    [AFHDS2A_a7105.ino, Validate.h]
2016-10-26 AFHDS2A: working version
    - Wait for transmit completion before switching to RX (no more fixed
    delays...)
    - Verify if data has been received before processing it (better handling
    of telemetry)
    - Added TX_RSSI (along with the existing RX_RSSI)
    Known issue: RX_RSSI value needs to be looked at. I'm seeing only values
    between 157 (bad) and 196 (good). Is this normal for this protocol?
    [A7105_SPI.ino, AFHDS2A_a7105.ino, Hubsan_a7105.ino, Multiprotocol.ino, Telemetry.ino]
2016-10-27 STM32: align STM32 code with other platforms for tx_pause/tx_resume
2016-10-31 Move multi specific compiler flags to multi board definition
    This has the advantage not modifying the other boards and the user needs to only edit one file instead of two.
2016-11-02 Update BOM_DIY_STM32.md
    Added BOM for Midelic's new board
2016-11-02 Added link to OShpark for V0.8 board
2016-11-02 Updated for USB board and latest firmware
2016-11-03 Jumper on new STM V1.0 board
2016-11-03 Updated instructions to set fuses before uploading fw
2016-11-06 Fixed compilation issue if telemetry is not enabled
    [FrSkyX_cc2500.ino]
2016-11-06 STM32: USART init changed
2016-11-25 Q222 some channels direction reverse
    [CX10_nrf24l01.ino]
2016-12-01 Core: option to reverse input channels
    [Multiprotocol.ino, _Config.h]
2016-12-02 Flysky/CX20 reversed elevator channel
    [FlySky_a7105.ino, Multiprotocol.ino]
2016-12-05 4-in-1 Board v2a
2016-12-06 Added: Bayang telemetry
    Changed telemetry configuration and validation for AFHDS2A and HUBSAN
    Added default Bayang telemetry from Silverxxx:
    - Option=1 to activate telemetry (option=0 -> standard Bayang protocol)
    - Value returned to the TX: RX RSSI, TX RSSI, A1=uncompensated battery
    voltage, A2=compensated battery voltage
2016-12-09 Bayang telemetry : sending volt/4
    Change for Taranis
2016-12-09 New MT99xx subprotocol FY805
    Protocol: MT99xx (number 17)
    Subprotocol: FY805 (number 4)
    Supports headless and flip. For flip I'm not sure of the flag since it
    was missing from the dumps.
    Untested protocol...
    [MT99xx_nrf24l01.ino, Multiprotocol.h, _Config.h]
2016-12-09 Revert "Bayang: change A1 and A2 back to maximum resolution"
    This reverts commit d2886432b7becdb5bfe66692b396f9c6c61d7de6.
    [Bayang_nrf24l01.ino, MJXQ_nrf24l01.ino]
2016-12-13 MJXQ: Fixed E010 and added H26WH
    Protocol: 18
    Sub_protocol for H26WH: 5
    [MJXQ_nrf24l01.ino, Multiprotocol.h, _Config.h]
2016-12-18 Implement Multiprotocol Telemetry
    This allows the multi module to tell the TX software (e.g. OpenTX) which telemetry protocol is in use. Also Status of the module and signaling binding/invalid protocol
    [AFHDS2A_a7105.ino, Multiprotocol.h, Multiprotocol.ino, Telemetry.ino, _Config.h]
2016-12-19 MULTI_TELEMETRY: couple of additions
2016-12-21 Multi Telemetry: fix patch level
    [Multiprotocol.h, Telemetry.ino]
2016-12-23 Multi Telemetry: fixed DSM
    [Multiprotocol.h, Telemetry.ino]
2017-01-01 STM32: use manuf ID as global ID
2017-01-02 FrSky D and X hopping table fix
    All RXs using these protocols must be rebinded.
    [Common.ino]
2017-01-02 Bind function on channel 16
    Toggling channel 16 (-100%->+100%->-100%) will execute a bind only if
    the loaded protocol is an autobind protocol or autobind is set AND
    throttle is low (below -95%).
2017-01-03 New protocol WK2x01
    Protocol WK2x01 number 30
    Sub protocols:
    - WK2801 number 0, 8 channels, fixed id not supported
    - WK2601 number 1, 6/7 channels, option is used see doc for details
    - WK2401 number 2, 4 channels
    Extended limits supported
    Autobind protocol
    Most receivers support WK2801 so always start trying this sub protocol
    first.
    [Multiprotocol.h, Multiprotocol.ino, Validate.h, WK2x01_cyrf6936.ino, _Config.h]
2017-01-03 WK2x01: subprotocols addition
    WK2801 number 0, 8 channels, fixed id is not supported
    WK2401 number 1, 4 channels
    W6_5_1 number 2, 6 channels
    W6_6_1 number 3, 7 channels
    W6_HEL number 4, 6 channels, option is used to limit COL
    W6_HEL_I number 5, 6 channels, COL inverted, option is used to limit COL
    [Multiprotocol.h, WK2x01_cyrf6936.ino, _Config.h]
2017-01-04 WK2x01: added fixed id mode for WK2801
    [Multiprotocol.ino, WK2x01_cyrf6936.ino]
2017-01-07 YD717: possible fix for old CX10
    [Common.ino, YD717_nrf24l01.ino]
2017-01-23 STM32 1.0t board + schematic
    [Multiprotocol_STM32_MB_1.0_t.brd, Multiprotocol_STM32_MB_1.0_t.sch]
2017-01-23 Added old STM32 PCB version 0.8t
    [Multi_STM32_V0.8_t.brd, Multi_STM32_V0.8_t.sch, Multiprotocol_STM32_MB_v1.0_t.brd, Multiprotocol_STM32_MB_v1.0_t.sch]
2017-01-23 Added OSH Park link for USB board
2017-01-26 Added Multi_STM32_V0.8_t board
2017-01-30 Q303: reverse A&R channels
    [Q303_nrf24l01.ino]
2017-01-30 FrSkyD: telemetry fix?
    Added CRC check on incoming telemetry packet.
    [FrSkyD_cc2500.ino]
2017-01-30 Added schematic for V1.0 version(USB)
2017-01-30 Rename BOM_DIY_STM32.md to BOM_DIY_STM32 & Schematic.md
2017-01-31 added STM32 module diagrams links
2017-02-01 FrSkyD telemetry
    - rewritten the handling of the incoming over the air telemetry packet
    - rewritten the TX_RSSI calculation (link frame[4])
    - added RX LQI and TX_LQI information in the link frame (frame[5] and
    frame[6])
2017-02-01 Update BOM_DIY_STM32 & Schematic.md
2017-02-02 Changes for 3 STM32 BOM's V1.0t BOM - Separate line and Part number for each LED - Dual Input-XOR Part Number with proper part footprint. V0.8 BOM - Quantity for Diode - Separate line and Part number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
2017-02-02 V1.0t BOM - Separate line and Part number for each LED - Dual Input-XOR Part Number with proper part footprint. V0.8 BOM - Quantity for Diode - Separate line and Part number for each LED - Dual Input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
2017-02-02 STM32 BOM Updates V1.0t BOM - Separate line and Part number for each LED - Dual Input-XOR Part Number with proper part footprint. V0.8 BOM - Quantity for Diode - Separate line and Part number for eac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
2017-02-06 Reset invert serial when switching protocol
    [Multiprotocol.h, Multiprotocol.ino, Telemetry.ino]
2017-02-06 New feature: end bind
    This new feature is available:
    - in serial mode and when binding from the GUI. As soon as the Bind
    window is closed = serial bind bit was set and cleared, the current bind
    operation will be terminated.
    - if the bind was initiated from the Bind on channel feature (bind
    channel goes high) then as soon as the bind channel goes low the current
    bind operation will be terminated.
    Tested on ersky9x which does open a bind window, not sure about
    OpenTX...
    Some protocols (Hubsan, Assan, FY326, Shenqi...) which are waiting for
    model/RX to reply will stay in bind mode.
    [Common.ino, FrSkyD_cc2500.ino, FrSkyX_cc2500.ino, MT99xx_nrf24l01.ino, Multiprotocol.h, Multiprotocol.ino, Symax_nrf24l01.ino, V2X2_nrf24l01.ino]
2017-02-06 Removed board option in _config.h
2017-02-07 info STM32 support in arduino IDE
2017-02-07 Chip select based on pin definition
2017-02-07 BOM_DIY_STM32 & Schematic Correct Reference ID and Part Number Red LED
2017-02-08 Fix Multi_status bind flag when invalid protocol selected
    [Q303_nrf24l01.ino, Telemetry.ino]
2017-02-10 WAIT_FOR_BIND feature
    This feature will not activate the selected protocol unless a bind is
    requested using bind from channel or the GUI "Bind" button. It is only
    enabled if bind from channel and autobind are set since I think they are
    working well together.
    The goal is to prevent binding other people's model when powering up the
    TX, changing model or scanning through protocols.
    There is a new blinking pattern associated to it as well as a new status
    "Waiting for bind".
    This feature is enabled by default in _config.h .
    [Multiprotocol.h, Multiprotocol.ino, Telemetry.ino, Validate.h, _Config.h]
2017-02-11 FrSkyD compilation issue without telemetry
    [FrSkyD_cc2500.ino]
2017-02-20 Fix Multi OrangeTX build
    [Validate.h]
2017-02-23 SFHSS reverse channels direction
    [SFHSS_cc2500.ino]
2017-02-23 AFHDS2A: prevent TX inbound swamping during bind
    [AFHDS2A_a7105.ino]
2017-02-23 Disable low power by default
2017-02-24 v0.1 schematic
2017-02-28 STM32 BOM: capacitor polarity added on silkscreen
2017-03-04 Add eagle CAD files for Multi_STM32_V0.1
    [Multi_STM32_V0.1.brd, Multi_STM32_V0.1.sch]
2017-03-22 DM002 protocol
    protocol number 33
    sub_protocol none=0
    ch5=flip
    ch6=led
    ch7=headless
    [Bayang_nrf24l01.ino, CYRF6936_SPI.ino, DM002_nrf24l01.ino, Multiprotocol.h, Multiprotocol.ino, Validate.h, _Config.h]
2017-04-03 Add updated multi_STM32 board V1.1
    [Multiprotocol_STM32_MB_1.1_t.brd, Multiprotocol_STM32_MB_1.1_t.sch]
2017-04-07 Add V1.1 design to BOM
2017-04-08 Add PCB _STM32_USB_V1.1 board files
2017-04-10 Fix STM32 issue and OrangeTX compilation
    [Multiprotocol.ino]
2017-04-10 Fix AFHDS2A power issue
    [AFHDS2A_a7105.ino]
2017-04-10 Missing comma in STM32 V1.1 BOM
2017-04-19 Fixed "Material you need to upload the firmware" section.
2017-04-19 Update BOM_DIY_ATmega.md
    Fixed **BOM for the DIY STM32** link.
2017-04-19 Update Compiling_STM32.md
    Fixed **Prepare the Arduino IDE:** section.
2017-04-19 Update Compiling.md
    Fixed **Boards.txt** alignment.
    Fixed **On Mac OSX** section.
2017-06-27 Update BOM_DIY_STM32 & Schematic.md
    Added Digi-Key shared carts for latest build BOM.
    Need to confirm if SV202,SV203, and SV204 each need a strip of 40 header pins for a total of 120 pins as currently since each S1011EC-40-ND part has 40 pins?
2017-07-31 Add flashing with TX for STM32_board
2017-08-03 Add STM32 bootloader files
2017-08-03 Revert "Add STM32 bootloader files"
    This reverts commit c92ec031ae8f3407fca520daee50d428c60659e7.
2017-08-03 Revert "Revert "Add STM32 bootloader files""
    This reverts commit ddc287a84ec8e303cf68b56d20769286f6b9dead.
2017-08-03 Add STM32 bootloader files_2
2017-11-04 Fix telemetry FrSkyX protocol
    [FrSkyX_cc2500.ino, Multiprotocol.ino, Telemetry.ino]
2017-11-04 Fix AFHDS2A failsafe problem
    [AFHDS2A_a7105.ino]
2017-11-06 fix compile error for avr module when commented FrSkyX protocol
    [Telemetry.ino]
2017-11-20 AVR Boards
2017-11-20 AVR Boards: auto bootloader setting
2017-11-22 Boards correction
2017-11-24 Updates
    Implemented debug output on uart1 for stm32
    Replaced hardcoded eeprom offsets with documented constats
    Fixed a bug affecting telemetry on Atmega328p using the invert_telemetry flag.
    [Devo_cyrf6936.ino, Multiprotocol.h, Multiprotocol.ino, Pins.h, Symax_nrf24l01.ino, Telemetry.ino, WK2x01_cyrf6936.ino]
2017-11-25 Invert serial atmega bug correction
    [Multiprotocol.h, Telemetry.ino]
2017-11-25 Update Atmega328 board definition
    - Tweak to AVR board menu entry
    - Exported binary will be named 'multifw.hex'
    - Updated zip and JSON files
2017-11-26 Final bit bashing fix?
    [Telemetry.ino]
2017-11-26 Replaced debug serial routines
    [Multiprotocol.h, Multiprotocol.ino, Telemetry.ino]
2017-11-27 Initial check-in for STM32 board
2017-11-28 Warn if CHECK_FOR_BOOTLOADER is enabled but a NO_BOOT board is selected
    Rather than silently disabling CHECK_FOR_BOOTLOADER lets throw an error
    prompting the user to make the correct selection.
    [Validate.h]
2017-11-28 Add error if CHECK_FOR_BOOTLOADER is not enabled but 'Flash from TX' is
    Error rather than silently enabling CHECK_FOR_BOOTLOADER.
    [Validate.h, _Config.h]
2017-11-28 Update STM32 documentation for Boards Definition (#116)
    Updating the compiling for STM32 documentation to take advantage of the boards definition.
2017-12-01 Update Protocol Details for CABELL protocol (#117)
    * Added CABELL Protocol
    * Added additional disclaimer to license.
    * Revert "Added additional disclaimer to license."
    This reverts commit a00bc9956a155a1a73dbbcd21fd19633d6d121ff.
    * Added additional disclaimer
    * Added CABELL_NRF24L01_INO define to config
    * Updated available protocol list
    Added CABELL protocol
    * Removed unused variables
    * Changed changel range to 45 channels that comply with USA FCC part 97 rules.
    This change allows licenced HAMs to operate under part 97 rules instead
    of part 15. These channels are still in the ISM band, but overlap with
    the part 97 amateur portion of the band.
    * Changed pro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
    [CABELL_nrf224l01.ino, Multiprotocol.h, Multiprotocol.ino, Pins.h, Validate.h]
2017-12-07 Failsafe: default for PPM and set on radio for Serial
    [AFHDS2A_a7105.ino, Common.ino, Devo_cyrf6936.ino, FrSkyX_cc2500.ino, Hisky_nrf24l01.ino, Multiprotocol.h, Multiprotocol.ino, SFHSS_cc2500.ino]
2017-12-07 Changed throttle failsafe value format
    [Common.ino, Telemetry.ino, _Config.h]
2017-12-09 Doc Updates for STM32 (#120)
    * Update Compiling_STM32.md
    * Add images
2017-12-10 Fix compilation errors based on config def
    [FrSkyX_cc2500.ino, Multiprotocol.ino, Telemetry.ino]
2017-12-11 Board Definition Updates (#121)
2017-12-15 Fix for STM32
2017-12-16 Fix Sport polling bytes send without multi header and introduce sport polling header for multi (#126)
    [Multiprotocol.h, Telemetry.ino]
2017-12-16 Fix board definitions version script to handle spaces in the paths (#127)
2017-12-17 STM32 timer hack
2017-12-17 Roll back to older STM32 core files (#128)
2017-12-18 Fix multi status (#132)
    [Telemetry.ino]
2017-12-18 STM32 fix timer issues
    [Multiprotocol.h, Multiprotocol.ino]
2017-12-19 STM32 final timer fix
    [Multiprotocol.h, Multiprotocol.ino]
2017-12-19 Removed some dependencies to the SPI library
2017-12-20 Multi Module Board Definition Updates (#133)
2017-12-30 Revert "Merge branch 'Pascal' into master"
    This reverts commit fc5495b6d1d68177634fcd92932ba44b8e47d91e, reversing
    changes made to f3838ae4b0512f0970f6bafa0d5a9e493ffc0c40.
    [AFHDS2A_a7105.ino, FrSkyX_cc2500.ino, Multiprotocol.h, Multiprotocol.ino, Telemetry.ino]
2018-01-03 New Corona protocol and autobind bug fix
    [A7105_SPI.ino, AFHDS2A_a7105.ino, ASSAN_nrf24l01.ino, Bayang_nrf24l01.ino, CABELL_nrf224l01.ino, CC2500_SPI.ino, CG023_nrf24l01.ino, CYRF6936_SPI.ino]
2018-01-08 Switch all protocols to use a resolution of 2048
    - Change how PPM is handled with a resolution of 2048 and scaled to match serial input range. PPM is now fully scaled for all protocols which was not the case before. If you are using PPM, you might have to adjust the end points depending on the protocols.
    - Change all range conversions to use 2048 where possible
    - Updated all protocols with new range functions
    - Protocols which are taking advantage of 2048 are Assan, FrSky V/D/X, DSM, Devo, WK2x01
    - Renamed AUX xto CHx for code readbility
2018-01-09 Move Arduino IDE boards doc to /doc (#139)
    * Create Arduino_IDE_Boards.md
    * Update README.md
    * Update links to Arduino IDE board instructions (#138)
2018-01-09 DSM: match Spektrum standard for servo throw
2018-01-22 FIX OpenTX DSM autodetect
    [Corona_cc2500.ino, Multiprotocol.h, Multiprotocol.ino, Validate.h]
2018-01-24 Arduino IDE Board Updates (#142)
    * Fix macOS serial upload
    * Add verification switch to serial upload scripts
    * Fix do_version.bat
    Allow parentheses and other special characters in the sketch path
    * Fix AVR board linker flags
    * Switch to new STM32 dual bootloader
    Single bootloader for flash via USB and from TX
    * Increment board versions
    * Add new board archive files and add new versions to JSON file
2018-01-24 Force latest board versions
2018-01-25 Addition of LED2 for iRangeX modules
2018-01-30 Introduction of Banks for the switch protocol selection
2018-02-25 Simplify STM32 Linux compilation steps. (#151)
    * Update Linux rules to use Maple rules file already available in this project.
    * Additional clarification.
    * Correct typo.
2018-06-12 Fix module id returned to be 0 when saved to eeprom (#170)
    Also fix that stm32 id is always either 0 or stm32 id
    [Multiprotocol.ino]
2018-06-25 Add the Vantac MPM Lite Board (#173)
2018-07-20 Fix AFHDS2A
    Fix bind issue with AFHDS2A
    Add frskyd hub telemetry voltage 2 from external battery
    Removed cflie warnings...
    [AFHDS2A_a7105.ino, CFlie_nrf24l01.ino, Multiprotocol.ino, _Config.h]
2018-07-21 STM32 dual bootloader update
    New version of the STM32 dual bootloader:
    - Fix startup issues with OpenTX
    - Auto invert TX if needed
2018-07-21 Multi 4-in-1 STM32 v1.0.6
    Bootloader: Toggle TX invert
2018-08-03 Hitec: new protocol
    Hitec protocol using the CC2500 RF component
    Protocol number: 39
    - Optima (0): the TX must be really close to the RX for the bind negociation to complete.
    - Minima (1): untested
    Optima supports basic telemetry using the FrSky Hub format: RX volt, TX RSSI,&LQI
    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
2018-08-04 FrSky X: SPORT polling
    Mike's corrections to make SPORT working on Taranis.
    [FrSkyX_cc2500.ino, Hitec_cc2500.ino, Multiprotocol.h, Multiprotocol.ino, Telemetry.ino, _Config.h]
2018-08-06 Hitec improvement
    Added 3rd byte of TX ID
    Reproduce the F5 frames from original TX
2018-08-09 Recreated STM32 board package v1.0.6 to fix Linux executable files. (#179)
2018-08-10 Add stm32 serial upload method which includes bootloader (#180)
2018-08-16 Adding stm32 auto-upload scripts for Windows, Mac, and Linux (#184)
2018-08-17 Remove boards files and re-org (#185)
2018-08-28 BUGS new protocol
    BUGS new protocol (number 41)
    Models: Bugs 3, 6 and 8
    Telemetry: TX & RX RSSI, Battery voltage good/bad
    ARM CH5
    LED CH6
    FLIP CH7
    PICTURE CH8
    VIDEO CH9
    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
    [A7105_SPI.ino, Bugs_a7105.ino, Multiprotocol.h, Multiprotocol.ino, Telemetry.ino, Validate.h, _Config.h]
2018-08-29 BUGS protocol
    Add channel for ANGLE/ACRO mode. Angle is +100%, acro is -100%.
    Channels mapping:
    ANGLE CH6
    LED CH10
    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
    [Bugs_a7105.ino, Multiprotocol.h]
2018-08-29 Hubsan sub_protocol 501 features
    sub_protocol H501
    Model H122D: add flip on ch13 and OSD on ch14
    Model H123D: add flight modes on ch16 -> -100% Sport mode 1,0% Sport mode 2, +100% Acro
    [Hubsan_a7105.ino, Multiprotocol.h]
2018-09-03 SLT: added sub_protocols
    SLT (11) sub_protocols are now
    - V1 (0): original 6 channels
    - V2 (1): 6 channels, might be able to add channel 7 and 8 but need testing
    - Q200 (2): 5 channels + switches: CH9=FMODE, CH10=FLIP, CH11=VIDON, CH12=VIDOFF
    [Multiprotocol.h, WFLY_cyrf6936.ino, _Config.h]
2018-09-06 SLT/Q200: Fix frequencies calculation
    [Multiprotocol.h]
2018-09-07 SLT/Q200: gyro calibration on CH13
2018-09-07 Add stm32 board v1.0.9 (#192)
2018-09-09 SLT sub protocol MR100 for Vista
    CH9: MODE
    CH10: FLIP
    CH11: VIDEO
    CH12:PICTURE
    [Multiprotocol.h, _Config.h]
2018-09-10 SLT sub protocol Q100
    CH9 FMODE
    CH10 FLIP
    CH13 Gyro calib
    [Multiprotocol.h, _Config.h]
2018-09-11 SLT Q100/Q200/MRT100: reverse throttle
    [Multiprotocol.h]
2018-09-12 SLT Q100/Q200/MR100: reverse elevator
    [Multiprotocol.h]
2018-10-11 Bugs: fixed telemetry disable compilation error
    [Bugs_a7105.ino, CX10_nrf24l01.ino, Multiprotocol.h, Multiprotocol.ino]
2018-10-17 New protocol BUGSMINI
    Models: MJX Bugs 3 Mini and 3H
    Protocol BUGSMINI = 42
    No sub_protocol
    Telemetry = RX RSSI and battery voltage good/warning/bad
    RX_Num is used to give a number to a given model. You must use a different RX_Num per MJX Bugs Mini. A maximum of 16 Bugs Mini are supported.
    Channels:
    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
    [BUGSMINI_nrf24l01.ino, Multiprotocol.h, Multiprotocol.ino, Telemetry.ino, Validate.h, _Config.h]
2018-11-03 Protocol NCC1701
    CH5: Warp
    Telemetry:
    A1 voltage is used for crash detection. In case of a crash A1=0V. You can be assign a sound to the crash.
    [Multiprotocol.h, Multiprotocol.ino, NCC1701_nrf24l01.ino, Telemetry.ino, Validate.h, _Config.h]
2018-11-06 E01X new protocol
    New protocol E01X number 45
    Sub protocol E012 number 0
    Sub protocol E015 number 1
    ARM_SW CH5
    FLIP_SW CH6
    LED_SW CH7
    HEADLESS_SW CH8
    RTH_SW CH9
    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
    [E01X_nrf24l01.ino, Multiprotocol.h, Multiprotocol.ino, NRF24l01_SPI.ino, Validate.h, _Config.h]
2018-11-07 Fix some compilation issues
    [E01X_nrf24l01.ino, Multiprotocol.h, Multiprotocol.ino]
2018-11-08 V911S protocol
    Protocol number 46
    No sub protocol
    CH5: yaw calib
2018-11-15 New protocol GD00X
    Protocol number: 47
    !!!! ONLY 1 ID AT THIS TIME !!!!
    CH1 AILERON
    CH3 THROTTLE
    CH5 TRIM
    CH6 LIGHT
    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
2018-11-20 DSM: Throttle Kill option
2018-11-22 DSM throttle kill: correct channel number
    [DSM_cyrf6936.ino, Multiprotocol.h]
2018-12-01 Add AVR v1.0.4 and STM32 v1.1.0 boards
2019-01-09 Fix E01X hang up when option=0
    [GD00X_nrf24l01.ino, Multiprotocol.h, NRF24l01_SPI.ino]
2019-02-28 E016H subprotocol addition to E01X
    Protocol E01X (45)
    Subprotocol E016H (2)
    CH5=STOP
    CH6=FLIP
    CH8=HEADLESS
    CH9=RTH
    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
    [E01X_nrf24l01.ino, Multiprotocol.h, _Config.h]
2019-03-03 Fix E01X BV statements
    [E01X_nrf24l01.ino, Multiprotocol.h]
2019-03-03 Add Silverware's analog aux channel feature to Bayang protocol (#215)
    * Expanded Bayang protocol to have Option 2, which adds two analog auxiliary channels driven by channels 14 and 15. The expert byte is taken over, as is the extra txid byte, which is not used by Silverware.
    * Change Bayang options - Bit 0 (LSB) enables telemetry and Bit 1 selects analog aux channels
    * Changed Bayang protocol bind to ensure binding only when telemetry and analog aux option selections match on RX and TX
    * Add details for Bayang protocol update
    [Bayang_nrf24l01.ino]
2019-03-11 BUGSMINI flip issue fix
    [BUGSMINI_nrf24l01.ino, Multiprotocol.h]
2019-03-21 Update package_multi_4in1_board_index.json
    STM32 board v1.1.1
2019-04-03 E016H calibration
2019-04-18 BUGSMINI sub protocol BUGS3H
    [BUGSMINI_nrf24l01.ino, Multiprotocol.h, _Config.h]
2019-04-26 AFHDS2A update RF channels and Failsafe
    You need to bind all the RXs again...
    [AFHDS2A_a7105.ino, Multiprotocol.h]
2019-05-08 Add XN297 Dump protocol
    Protocol number: 63
    Sub protocols: 0=250Kb, 1=1Mb, 2=2Mb
    Option: -1=scan RF channels, 0-84=RF channel
    DEBUG_SERIAL must be enabled
    If a valid frame is received the frame will be sent on the serial port.
2019-05-09 Update .travis.yml
    Fix file extension for compiled STM32 files
2019-05-10 AFHDS2A: add debug on full telemetry frames
2019-05-16 Use CC2500 if available instead of NRF24L01 for E010 and PHOENIX (#225)
    * Use CC2500 if available instead of NRF24L01 for E010 and PHOENIX sub protocols
    * Update documentation
    * Why do I always swap below & above ?
    [MJXQ_nrf24l01.ino, NRF24l01_SPI.ino]
2019-05-17 New protocol V761
    Protocol number: 48
    Sub_protocol: none
    Channel 5: +100% expert, 0% mid=gyro on no rate limits, -100% beginer=gyro on and axis rate limited.
    ONLY 1 ID IS AVAILABLE SO BE CAREFUL WHILE FLYING.
2019-05-31 Fix E010/CC2500 Protocol on AVR (#229)
    * Use cc2500 fast frequency hopping
    * Calibrate cc2500 PLL if sub-protocol is E010/Phoenix only
    * Fix e010 crc for AVR
    [MJXQ_nrf24l01.ino]
2019-06-04 New protocol KF606
    Model: KF606
    Protocol: 49
    Channels: throttle, aileron and trim on ch5
    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
2019-06-09 BUGS EEPROM clean: need to rebind BUGS and BUGSMINI
    [Bugs_a7105.ino, Multiprotocol.h]
2019-06-10 BUGS fix a bug...
    [Bugs_a7105.ino, Multiprotocol.h]
2019-06-19 New protocol POTENSIC
    Model: A20
    Protocol number: 51
    Sub protocol: none
    - CH5 TAKE_OFF/LANDING: momentary switch -100% -> +100%
    - CH6 EMERGENCY: Stop +100%
    - CH7 MODE: MODE: Beginner -100%, Medium 0%, Advanced +100%
    - CH8 HEADLESS: Off -100%, On +100%
    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
2019-06-27 Update package_multi_4in1_board_index.json
    Add new boards which resolves issue with spaces in the sketch path on Windows.
2019-07-03 Added a common deadband conversion code
    Modified protocols:
    - GD00X applied on aileron
    - KF606 applied on aileron
    - POTENSIC applied on throttle
2019-07-03 XN297Dump: fix packet timer
    [Multiprotocol.h, XN297Dump_nrf24l01.ino]
2019-07-04 Mandatory use of boards AVR 1.0.7 and STM32 1.1.4 solving path space issues
    [Multiprotocol.h, Validate.h]
2019-08-01 Fix DSM telemetry and global cyrf6936 freq tunning
    - Fixed DSM telemetry with some RXs (R720X)
    - Global frequency tunning for all protocols using the CYRF6936 by adjusting channel 15 when enabled
    - Changed default DSM_THROTTLE_KILL_CH to use channel 14
    [CYRF6936_SPI.ino, Common.ino, DSM_cyrf6936.ino, Multiprotocol.h, Multiprotocol.ino, TX_Def.h, Validate.h, WFLY_cyrf6936.ino]
2019-08-06 New protocol Traxxas
    Protocol number: 43
    Compatible with receivers 6519
    CH1=AUX3
    CH2=AUX4
    CH3=THROTTLE
    CH4=STEERING
    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
2019-08-10 New protocol ZSX
    Model JJRC ZSX-280
    Protocol number 52 ,no sub protocol
    CH3: Throttle
    CH4: Rudder
    CH5: Light
2019-08-24 XN297Dump fix enhanced unscramble mode
    [Multiprotocol.h, XN297Dump_nrf24l01.ino]
2019-09-06 Accomodate new Debug Option setting in Arduino IDE (#255)
    Thanks, that's perfect!
2019-09-06 Update package_multi_4in1_board_index.json
    Add AVR board v1.0.8 and STM32 board v1.1.5.
2019-09-07 Doc updates for new board package (#256)
2019-09-08 Update Travis CI script (#257)
    * Use latest STM32 board options
    * Use latest Arduino IDE
    * Fix build functions to return an error if the build fails
    * Modify the files that get exported to releases
2019-09-11 Fix scanner compilation issue
    [Multiprotocol.h, Multiprotocol.ino, Scanner_cc2500.ino, Validate.h]
2019-09-14 Fix scanner telemetry (#262)
    * Fix scanner telemetry
    * Take several samples per channel, keep maximum value
    [Scanner_cc2500.ino]
2019-09-14 Revert "AFHDS2A telemetry AA and AC"
    This reverts commit 3c76ce9f39c3d4e48a2a7d9482fc152533a189aa.
    [AFHDS2A_a7105.ino, Multiprotocol.h, Multiprotocol.ino, Telemetry.ino]
2019-09-17 Protocol FrSky D16 receiver (#266)
    * Add skeleton for FrSkyX receiver protocol
    * Binds & receives data packets
    * Store bind information
    * Fix compilation
    * Bypass LNA since intended usage implies tx & rx are close together
    * Bind channel has FS_AUTOCAL
    * Add freq fine tune & low power mode (disable lna)
    * Add TX ID check
    * Retry longer until first packet is catched
    * Fix chanskip for first packet
    * Fix defines
    * Fix bind
    * Send channels to TX
    * Fix RSSI reading
    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
    [FrSkyX_cc2500.ino, Multiprotocol.h, Multiprotocol.ino, Telemetry.ino, Validate.h, _Config.h]
2019-09-19 AFHDS2A telemetry fix
    Discard RX config packets
    [AFHDS2A_a7105.ino, Multiprotocol.h]
2019-09-22 Fix FrskyX failsafe hold/no pulse inversion
    [Multiprotocol.h, Multiprotocol.ino]
2019-09-22 Bump multi board version to the latest
2019-09-22 Revert Fix FrskyX failsafe hold/no pulse inversion
    [Multiprotocol.h, Multiprotocol.ino]
2019-09-23 Protocol FrskyX D16 RX frequency auto-tune (#270)
    * Add autotune during bind
    * Fix data phase
    [Multiprotocol.h]
2019-09-26 AVR modules: Fix KF606, GD00X and Potensic
    [Common.ino, Multiprotocol.h]
2019-09-27 Failsafe modification
    The following protocols are supporting failsafe: FrSkyX, Devo, WK2x01, SFHSS, HISKY/HK310 and AFHDS2A
    In Serial mode failsafe is configured on the radio itself.
    In PPM mode and only after the module is up and fully operational, press the bind button for at least 5sec to send the current stick positions as failsafe to the RX.
    [Common.ino, Multiprotocol.h, Multiprotocol.ino, _Config.h]
2019-10-01 Protocol Flysky AFHDS2A receiver (#275)
    * Add skeleton for AFHDS2A receiver protocol
    * Bind & data Ok
    * Send channels to TX via telemetry
    * Add RSSI
    * Fix AVR compilation
    * Fix channel number
    [A7105_SPI.ino, AFHDS2A_Rx_a7105.ino, Multiprotocol.h, Multiprotocol.ino, Telemetry.ino, Validate.h, _Config.h]
2019-10-02 Fix AFHDS2A receiver packet filter (#276)
    * Fix packet type check
    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
    [AFHDS2A_Rx_a7105.ino]
2019-10-04 New boards with bin signatures
2019-10-04 Fix Multi receiver channels
    [AFHDS2A_Rx_a7105.ino]
2019-10-05 Fix channel and rssi scaling (#279)
    [AFHDS2A_Rx_a7105.ino]
2019-10-05 Fix scaling for +125% (#280)
    [AFHDS2A_Rx_a7105.ino]
2019-10-10 Multi_sync updates
    Only for STM32
    Enable bidirectionnal serial
2019-10-12 Fix rc channels init (#284)
    [FrSky_Rx_cc2500.ino]
2019-10-13 Fix ADHDS2A RX LNA switch
    [AFHDS2A_Rx_a7105.ino, FrSky_Rx_cc2500.ino, Multiprotocol.ino]
2019-10-13 FiX AFHDS2A RX LNA switch
    [AFHDS2A_Rx_a7105.ino]
2019-10-13 Auto-detect FrSky RX format (#286)
    * Calibrate rf channels for D8 too
    * Auto-detect D16FCC, D16LBT or D8 format during bind
2019-10-15 Send current protocol and sub protocol name
2019-10-17 Correct option value for FrSky protocols
    [Multiprotocol.h, Multiprotocol.ino]
2019-10-17 Frsky rx fixes (#289)
    * Restore previous cc2500 register init
    * Fix failsafe packets locks
    * Fix D8 checksum check
    [FrSkyDVX_common.ino, FrSky_Rx_cc2500.ino]
2019-10-25 Fix AFHDS2A RX_LQI forward on CH
    Hopefully...
    [AFHDS2A_a7105.ino, Multiprotocol.h]
2019-10-26 AFHDS2A: Fix LQI to channel
    [AFHDS2A_a7105.ino, Multiprotocol.h]
2019-10-31 Fix (?) protocol issues
    [FrSkyDVX_common.ino, FrSkyX_cc2500.ino, Multiprotocol.h, Multiprotocol.ino, Telemetry.ino, _Config.h]
2019-11-01 FrSky X telemetry quick fix
    [FrSkyX_cc2500.ino, Multiprotocol.h, Telemetry.ino]
2019-11-02 Prep for HoTT protocol and fix STM32 seed
    [Multiprotocol.h, Multiprotocol.ino, Validate.h, _Config.h]
2019-11-03 Changed serial timer source
2019-11-07 HoTT: Failsafe
    Failsafe MUST be configured once with the desired channel values (hold or position) while the RX is up (wait 10+sec for the RX to learn the config) and then failsafe MUST be set to RX/Receiver otherwise the servos will jitter!!!
    [HOTT_cc2500.ino, Multiprotocol.h, Telemetry.ino]
2019-11-11 Fix HoTT menu for internal module
    [HOTT_cc2500.ino]
2019-11-11 Fix all compilation issues (?)
    [AFHDS2A_a7105.ino, ASSAN_nrf24l01.ino, BUGSMINI_nrf24l01.ino, Bayang_nrf24l01.ino, Bugs_a7105.ino, CABELL_nrf224l01.ino, CFlie_nrf24l01.ino, CG023_nrf24l01.ino]
2019-11-27 V911S: revert to nrf24l01
    [V911S_xn297l.ino]
2019-11-29 Bayang RX: fix warnings
    [Bayang_Rx_nrf24l01.ino]
2019-11-29 Multi_names mandatory when using multi_telemetry
    Validate that sub_proto is valid for the current protocol
    Validate that disable channel mapping is valid for the current protocol
2019-11-29 BAYANG RX: enables 6 analog channels
    Fix channels range -100%..+100%
    [Bayang_Rx_nrf24l01.ino, Multiprotocol.h]
2019-12-19 New protocol Tiger
    Model: Tiger drone 1400782
    Protocol number: 61
    CH5: Flip
    CH6: Light
    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
    [Multiprotocol.h, Multiprotocol.ino, Validate.h, _Config.h]
2019-12-20 Pelikan and Tiger protocol fixes
    [Multiprotocol.h, NRF24l01_SPI.ino, Pelikan_a7105.ino]
2019-12-20 Pelikan protocol fix ?
    [A7105_SPI.ino, Multiprotocol.h, Multiprotocol.ino, Validate.h, _Config.h]
2020-01-10 Fix module status on erSkyTX
    [Telemetry.ino]
2020-01-12 Fix FrSky RX bind which could fail if another TX was around
    [FrSky_Rx_cc2500.ino]
2020-01-12 Pelikan: fix TX and multi ID
    Still 1 hopping freq table
    [A7105_SPI.ino, Pelikan_a7105.ino]
2020-01-12 XN297Dump: new auto mode
    Automatically:
    - find XN297L packet -> bitrate, scrambling, enhanced...
    - use address to filter incoming packets
    - find all frequencies
    - determine channel order (basic)
    - help to find out the changes by only displaying packets when there is a change in the packet
2020-01-12 Fix DSM invalid protocol when binding
    [Multiprotocol.h, Telemetry.ino]
2020-01-14 New protocol XK
    Still work in progress
    Subprotocols: X450 and X420 -> not sure if they are subprotocols or just different IDs...
    CH5: M-Mode=-100%, 6G-Mode=0%, V-Mode=+100%
    CH6: Take off momentary switch
    CH7: Emergency stop momentary switch
    CH8: 3D/6G momentary switch
    CH9: Photo momentary switch
2020-01-14 Protocol Pelikan: fix rx_tx_addr[1]...
    [Multiprotocol.h, Pelikan_a7105.ino]
2020-01-21 initial working version of R9M, 8 CH and BINDING support only
    [FrSkyDVX_common.ino, FrSkyR9_sx1276.ino, Multiprotocol.h, Multiprotocol.ino, SX1276_SPI.ino, _Config.h]
2020-01-24 missed the last 3 bytes here, loop should continue one more time (#322)
    [FrSkyR9_sx1276.ino]
2020-02-16 V911S: new sub protocol E119
    Model: Eachine E119
    Protocol: V911S -> 46
    Sub protocol: E119 -> 1
    CH5: left button ???
    CH6: right button ???
2020-02-17 SLT: fix going from NRF to CC2500
    [Multiprotocol.h, NRF250K_EMU.ino]
2020-03-21 Hitec: fix a bind issue
    [Hitec_cc2500.ino, Multiprotocol.h]
2020-04-10 Initial Version of CloneMode (#342)
    * Initial Version
    * Bugfix and change of the handling of the RX Num.
    If RX Num is 63, write a finetune value of 127 to the EEPROM.
    A real finetune value of 127 means, the frequency of module is out of range and
    the module should be replaced. This way the clone mode should not get unwanted
    active by a module with a frequency drift arround 63.
    [FrSkyDVX_common.ino, FrSkyX_cc2500.ino, FrSky_Rx_cc2500.ino]
2020-04-14 Fix independant protocols build
    [FrSkyDVX_common.ino, Validate.h]
2020-04-21 Fix a bug introduced with Alpha protocols ordering
    [Multiprotocol.h, Telemetry.ino]
2020-05-17 HoTT: support for auto sensors discovery and sensors text config
2020-05-17 DSM and DSM RX: fix bind
    [DSM.ino, DSM_Rx_cyrf6936.ino, DSM_cyrf6936.ino, Multiprotocol.h]
2020-05-17 DSM RX: Fix compilation
    [Multiprotocol.ino]
2020-05-23 Fix compilation when ESKY150V2 was built without HoTT
    [Multiprotocol.h, Multiprotocol.ino]
2020-06-02 XN297dump: Auto mode small fix
    [XN297Dump_nrf24l01.ino]
2020-06-07 FrSkyX: force tuning fix for FrSkyX2
    [Multiprotocol.h, Multiprotocol.ino]
2020-06-09 Fix compilation when telemetry is disabled
    [Devo_cyrf6936.ino, Multiprotocol.h, Propel_nrf24l01.ino, Validate.h, _Config.h]
2020-06-09 DSM: fix 11ms issue on some RXs?
    [DSM_cyrf6936.ino, Multiprotocol.h]
2020-06-13 DSM RX: remove reverse on aileron and rudder
    [DSM_Rx_cyrf6936.ino]
2020-06-15 Implement datasheet errata recommendation (#372)
    [SX1276_SPI.ino]
2020-06-15 Adds SX1276_DetectChip() function (#373)
    * Adds SX1276_DetectChip() function
    works by testing for 0x12 match in version reg 0x42
    * fix build err
    [SX1276_SPI.ino]
2020-06-26 Switch to Arduino CLI instead of IDE for Travis CI builds
2020-06-27 Revert "V761 additonal channels"
    This reverts commit 7286049d0709d883a30ace3403ae18eda7928576.
    [Multiprotocol.h, V761_nrf24l01.ino, _Config.h]
2020-06-29 Add latest STM32 board
2020-07-03 FrSkyX: fix AVR telemetry and may be improve telemetry overall
    [FrSkyX_cc2500.ino, Multiprotocol.h]
2020-07-04 FrSkyR9: fix independant compilation issue
    [FrSkyDVX_common.ino, FrSkyR9_sx1276.ino, Validate.h]
2020-07-04 FrSkyX: fix telemetry not stopping when RX is off
    [FrSkyX_cc2500.ino, Multiprotocol.h]
2020-07-04 FrSky R9: fix sensors telem?
    [FrSkyR9_sx1276.ino, Multiprotocol.h, Telemetry.ino]
2020-07-04 FrSkyR9: TQLY = percentage of telemetry frames per second
2020-07-05 Update install_drivers.bat
    Change to libusbk driver for DFU device
2020-07-16 Fix FrSkyX and FrSkyR9 bind options
    [Multiprotocol.h, Multiprotocol.ino]
2020-07-22 Fix compilation issues when Telem is disabled
    [AFHDS2A_a7105.ino, FrSkyDVX_common.ino]
2020-07-23 RLINK: Fix voltage values
    [Multiprotocol.h, RadioLink_cc2500.ino]
2020-07-23 RLINK: remove fixed ID
    [RadioLink_cc2500.ino]
2020-08-07 V761 bug fix: the model was not reconnecting unless you did a bind first
    [V761_nrf24l01.ino]
2020-08-20 Bayanf: fix telemetry batt
    [Bayang_nrf24l01.ino, Multiprotocol.h]
2020-08-31 Fixed frame size
2020-09-04 STM32: test flash size
2020-09-21 OMP: prevent telemetry voltage from rolling over
    [Multiprotocol.h, OMP_cc2500.ino]
2020-09-21 AFHDS2A: fix X6B telemetry issue?
    [AFHDS2A_a7105.ino, Multiprotocol.h]
2020-09-30 Kyosho/Hype: another attempt to fix bind...
    [A7105_SPI.ino, Kyosho_a7105.ino, Multiprotocol.h]
2020-09-30 Indicate ratio values to be used for A1 and A2 voltage sensors
    OMP, RadioLink, Hubsan, Bayang, ...
2020-10-03 Flysky: Fix AFHDS and AFHDS2A
    [A7105_SPI.ino, Multiprotocol.h]
2020-10-11 Travis release build changes (#450)
    * Move the release build steps into separate shell scripts
    * Remove builds that we don't need any more
    * Latest builds of er9x and erSkyTx both support MULTI_TELEMETRY so separate OpenTX / erSkyTx builds are no longer needed
    * Radio can switch telemetry inversion on or off automatically so STM32 inv / noinv builds are no longer needed
2020-10-11 STM32 release file name standardization (#451)
    Tweak the names of the STM32 serial and CC2500-only release files.
2020-11-03 Add module sub-type to signature
    Differentiates between the STM32F1 boards.
2020-11-09 Add tests for STM32F103C8 board
2020-11-30 Fix compiler errors when telemetry is disabled (#474)
    [OMP_cc2500.ino, Validate.h]
2020-11-30 Add STM32 EEPROM initialization at startup (#475)
2020-12-10 Fix potential bug with wait loops
    [AFHDS2A_Rx_a7105.ino, AFHDS2A_a7105.ino, Arduino.ino, Bugs_a7105.ino, WK2x01_cyrf6936.ino]
2020-12-10 WFLY: Track changes in A7105 config (radio has A7106)
2020-12-11 WFLYRF: fixed normal mode, added telemetry, bind is not working yet
    [Multiprotocol.ino, Telemetry.ino, Validate.h, WFLYRF_a7105.ino, _Config.h]
2020-12-11 WFLYRF: added ext voltage to A2
2020-12-11 WFLYRF: Fixed partial ID for telemetry
    [WFLYRF_a7105.ino]
2020-12-15 WFLY2: fix bind after code cleanup...
    [A7105_SPI.ino, Multiprotocol.h, WFLY2_a7105.ino, _Config.h]
2020-12-15 Pin arduino-cli version to 0.13.0
2020-12-15 Add latest boards
2020-12-16 WFLY2: add failsafe (hold/no pulse not available yet)
    [A7105_SPI.ino, DSM_cyrf6936.ino, Devo_cyrf6936.ino, Futaba_cc2500.ino, Hitec_cc2500.ino, MLINK_cyrf6936.ino, Multiprotocol.h, Pelikan_a7105.ino]
2020-12-16 WFLY2: add switch from PPM <-> WBUS
2020-12-19 E016H: Calibration on channel 8
2020-12-27 Fix EEPROM address variable types (#494)
    [AFHDS2A_a7105.ino, HOTT_cc2500.ino, Multiprotocol.h]
2021-01-11 Fix FrSky RX protocol not ending bind when requested
    [Multiprotocol.h, Multiprotocol.ino, _Config.h]
2021-01-11 E010r5: added flip, led and calib channels
    [E010R5_cyrf6936.ino, E016HV2_cc2500.ino, FQ777_nrf24l01.ino, Multiprotocol.h, Multiprotocol.ino, NCC1701_nrf24l01.ino, NRF24l01_SPI.ino, NRF250K_EMU.ino]
2021-01-16 Fix CRC in various places
    [CX10_nrf24l01.ino, CYRF6936_SPI.ino, Hontai_nrf24l01.ino, J6Pro_cyrf6936.ino, Multiprotocol.h, NCC1701_nrf24l01.ino, NRF24l01_SPI.ino, NRF250K_EMU.ino]
2021-01-19 E016HV2: fixed a left over from protocol reverse engineering
    [E016HV2_cc2500.ino, NRF250K_EMU.ino]
2021-01-19 AFHDS2A RX: trial to fix bind with original TX
    [AFHDS2A_Rx_a7105.ino, Multiprotocol.h]
2021-01-28 DSM: fix low power
    [DSM_cyrf6936.ino, Multiprotocol.h, Multiprotocol.ino]
2021-01-29 WFLY2: Failsafe working for values, hold and no pulse
    [Multiprotocol.h, WFLY2_a7105.ino]
2021-02-01 Futaba S-FHSS: Fist attempt to fix failsafe
    [Futaba_cc2500.ino, Multiprotocol.h]
2021-02-02 Futaba S-FHSS: failsafe throw test
    [Futaba_cc2500.ino, Multiprotocol.h]
2021-02-02 MT99XX fix bind hopping
    [MT99xx_nrf24l01.ino, Multiprotocol.h]
2021-02-03 Bayang: add PID to telemetry
2021-02-07 MLink: added voltage, current, rpm, temp sensors and lqi
2021-02-09 One file missing in the push...
    [DSM_Rx_cyrf6936.ino]
2021-02-11 MT99XX/Dragon: beginner and intermediate swapped...
    [MT99xx_nrf24l01.ino, Multiprotocol.h]
2021-02-12 RF switch fix...
2021-02-14 AFHDS2A: fix issue with fs-x6b
    [AFHDS2A_a7105.ino, Multiprotocol.h]
2021-02-16 Fix XK protocol with latest change
    [Multiprotocol.h, XK_nrf24l01.ino]
2021-02-21 SX1276: RF power adjustment for DIY & Jumper T-Lite
2021-03-02 Devo: added telemetry voltage 3
2021-03-02 DEVO: fix temp telemetry
    [Devo_cyrf6936.ino]
2021-03-02 DEVO: temp telem fix
    [Devo_cyrf6936.ino]
2021-03-02 DEVO telemetry: reduce the voltage and RSSI refresh frequency
2021-03-04 SBUS/CPPM: restore normal telemetry on student link lost
    Once the setup is done check the "Disable telemetry" box to make sure that there is no interference between the internal module and Multi telemetry.
    [Multiprotocol.ino]
2021-03-04 Disable SBUS serial when switching to CPPM
2021-03-04 SBUS/CPPM: fixed switching from SBUS to CPPM
    There is still an issue from CPPM to SBUS...
    [Multiprotocol.ino]
2021-03-04 SBUS/CPPM: fixed switching from CPPM to SBUS
    [Multiprotocol.ino]
2021-03-13 HoTT: fix Text config in Sync mode
    [DSM_Rx_cyrf6936.ino, DSM_cyrf6936.ino, HOTT_cc2500.ino, Multiprotocol.h]
2021-03-13 Fix for module boot issue?
    [HOTT_cc2500.ino, Multiprotocol.h, Multiprotocol.ino, Telemetry.ino]
2021-03-14 Fix module boot issue?
    [Multiprotocol.h, Multiprotocol.ino, Telemetry.ino]
2021-03-17 Bug fix in XN297 emu layer when address is 3 bytes and CC2500 in use
    [XN297_EMU.ino]
2021-03-27 MT99xx: Added voltage telemetry for the Dragon sub protocol
2021-03-30 FrSkyX: fix the need to rebind RXs
    [FrSkyX_cc2500.ino, Multiprotocol.h]
2021-04-02 Hitec: fix freq tune
    [Hitec_cc2500.ino, Multiprotocol.h]
2021-04-06 Devo: fix GPS year
    [Devo_cyrf6936.ino, Multiprotocol.h]
2021-04-17 MT99XX/Dragon: batt telemetry correction & low batt flag
    [MT99xx_ccnrf.ino, Multiprotocol.h]
2021-04-24 XK: fix twitch on other channels than rudder
    [Multiprotocol.h, XK_ccnrf.ino]
2021-04-24 Add the IKEA Ansluta remote-controllable lighting protocol (#566)
    * Add the IKEA Ansluta remote-controllable lighting protocol
    * Fixes to IKEA Ansluta implementation
    [IKEA_Ansluta_cc2500.ino, Multi_Protos.ino, Multiprotocol.h, _Config.h]
2021-05-04 New protocol: Mould King
2021-05-04 Mould King: fix frequencies
    [MouldKg_nrf24l01.ino, Multiprotocol.h]
2021-05-09 MouldKing: match original
2021-05-25 Fix RadioLink: request telemetry every time to time like original instead of all the time
    [Multiprotocol.h, RadioLink_cc2500.ino]
2021-05-27 Mould King: Analog and digital sub protocols
2021-06-20 Mould King: control up to 4 bricks at the same time
2021-06-24 Set reserved field in CABELL packet to current channel (#593)
2021-06-28 Fix XN297Dump enhanced payload detection
    [XN297Dump_nrf24l01.ino, XN297_EMU.ino, iface_xn297.h]
2021-08-25 BUGSMINI: fix
    No one has reported an issue but from the look of the code it was broken since some time...
    [BUGSMINI_nrf24l01.ino]
2021-09-05 Multi Status: send frame as soon as a new protocol is selected
2021-09-09 Proto list: fix flags
    [Multi_Protos.ino, Multiprotocol.h]
2021-09-15 Devo: support for 2 GPS formats
    Use the Fixed ID field, 0/1 first GPS format, +2 for the other format -> 2/3
    [Devo_cyrf6936.ino, Multiprotocol.h]
2021-11-04 added packet_in[14] to transfer HoTT device warnings to OpenTx (#627)
2022-03-25 fix: MultiConfig lua set and reset subProtocol (#672)
    [MultiConfig.lua]
2022-04-15 KF606/MIG320: Added LED control
2022-06-07 This is the Graupner HoTT adapted version of the Model Locator script. It uses the Graupner HoTT telemetry sensor "Rssi" instead of the OpenTX sensor "RSSI". (#693)
    Reasoning: The OpenTX sensor "RSSI" is populated by the individual OpenTX telemetry protocol implementations and returns a value from 0..100 (percent) originating from the early FrSky implementation. It turns out that FrSky did not really provide a genuine signal strength indicator in units of dbm but a link quality indicator in 0..100%. With Graupner HoTT the link quality indicator is not a good basis for the model locator as it is very non-linear and doesn't change much with distance. Using the Graupner HoTT telemetry sensor "R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
    [Graupner HoTT Model Locator.lua]
2022-06-13 Fixes a problem where setting failsafe values was only possible once after bind and only set values for the first 12 channels. This fix allows setting failsafe values without having to rebind and set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
    Notes for OpenTX/EdgeTX:
    This fix doesn't exhibit servo jitter if failsafe mode was left on Custom, however it is still recommended to set failsafe mode back to Receiver after setting failsafe values.
    It is still necessary to wait at least 8 seconds switching back from failsafe mode Custom to failsafe mode Receiver as OpenTX/EdgeTX will trigger the data transfer in Custom mode only every 7 seconds.
    Bench tested with HoTT receiv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
    [HOTT_cc2500.ino]
2022-07-11 FX/FX620
    I messed up the hopping, I must have looked at the wrong file.
    [FX_nrf24l01.ino, Multiprotocol.h]
2022-07-21 Use devel boards in CI workflow (#709)
2022-10-12 Added documentation for using dfu-util for flashing STM32 targets. (#727)
    This patch adds documentation, explaining how to flash firmware to DFU
    capable multimodules.
    A dfu-util command was taken and adapted from:
    https://github.com/benlye/flash-multi/blob/master/doc/Troubleshooting.md
    Using dfu-util is straight forward, easy and very safe.
2022-11-17 Added MPM for Flysky PL18 PCB and casing design. (#754)
    [MPM-BF.stl, MPM-TF.stl, MPM.blend, PL18_multiprotocol.kicad_pcb, PL18_multiprotocol.kicad_sch]
2022-11-17 Frankie dsm fwrd prg enhancements (#755)
    * #751 DSM Enhancements
    #751 DSM Forward Programming Enhancements (New GUI, etc)
    * Make both work on EdgeTx and OpenTX
    * #751 Turn OFF simulation by default
    Distribution code with RX simulation OFF
    Simulation should be only for Development
    * #751 Update Readme Documentation
    Updated the Readme.txt documentation
    and removed compiled luac file that was check in by mistake
    [DSM FwdPrg_05_Color.lua]
2022-11-18 Frankie dsm fwrd prg enhancements (#757)
    * #751 Fix problems With Reset RX
    1. Fix problem when trying to Factory Reset. Enter Bind Mode. Save backup, Restore Backup
    2. Found a way to advance on the Gyro initial Setup menus.. a bit of a hack, but works.
    3. Handle RX resets properly. It needed af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
    [DSM FwdPrg_05_Color.lua]
2022-11-20 Frankie DSM fwrd Prog (more improvements) (#760)
    3. Handle RX resets properly. It n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
    [DSM FwdPrg_05_Color.lua]
2022-11-20 Frankie dsm fwrd prg enhancements (#762)
    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
    [DSM FwdPrg_05_Color.lua]
2022-11-21 Frankie dsm fwrd prg enhancements (#763)
    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
2022-11-27 #766 change validation of required files (#768)
    3. Handle RX resets properly. It ne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
    [DSM FwdPrg_05_Color.lua]
2022-11-28 #766 Fix for editable Gains + Number formatting (#770)
    3. Handle RX resets properly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
    [DSM FwdPrg_05_Color.lua]
2022-11-29 Frankie dsm fwrd prg enhancements (#771)
    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
    [DSM FwdPrg_05_Color.lua]
2022-11-29 Frankie dsm fwrd prg enhancements (#772)
    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
    [DSM FwdPrg_05_Color.lua]
2022-12-01 Frankie dsm fwrd prg enhancements (#773)
    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
    [DSM FwdPrg_05_Color.lua]
2022-12-02 Frankie dsm fwrd prg enhancements (#776)
    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
    [DSM FwdPrg_05_Color.lua]
2022-12-18 Fwrd Programming New Model/Wingtype Setup Menus (#784)
    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
    [DSM FwdPrg_05_Color.lua]
2022-12-20 Frankie dsm fwrd prg enhancements (#785)
    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
    [DSM FwdPrg_05_Color.lua]
2022-12-20 Updated Ch naming across all display, and updated Docs (#786)
    3. Handle RX resets p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
    [DSM FwdPrg_05_Color.lua]
2022-12-20 Fix message displaying the DataPath after saving (#787)
    3. Handle RX resets properl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
2023-01-15 Frankie dsm fwrd prg enhancements (#806)
    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
    [DSM FwdPrg_05_Color.lua]
2023-01-15 KF606: subprotocol ZC-Z50v2 Cessna (#797)
    Maybe newer iteration of Z50. My plane does not have front propeller.
    But if there is one, its just for design. This model does not have front motor.
    Thanks @pascallanger for support and reviews.
2023-01-16 FX9630 protocol support, resolves #801 (#805)
    New protocol FX9630
    [FX_nrf24l01.ino, Multi_Protos.ino, Multiprotocol.h, _Config.h]
2023-02-07 Telemetry TextGen/Screens for BLADE Helis with AR636 (#813)
    3. Handle RX resets pr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
2023-03-18 Frankie dsm telemetry lua scripts enhancements (#835)
    3. Handle RX resets properly.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
2023-03-19 Remove DSM_AR636_TextGen.lua (#837)
    3. Handle RX resets properly. It needed after i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
2023-04-16 V0.54 Enhacements (#846)
    3. Handle RX resets properly. It needed after initial setu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
    [DSM FwdPrg_05_Color.lua]
2023-06-04 Fix SPORT when using FRSKYX (V1) protocol set to EU LBT
    [FrSkyX_cc2500.ino]
2023-06-14 Switch back to non-devel boards for CI/CD (#863)
2023-06-14 Fix builds by using older Arduino CLI (#864)
    * Used a fixed version of Arduino CLI
    * Bump action versions
2023-08-27 Clone subprotocol for DSM (#877)
    * Init WIP
    * Adding a gitignore
    * removing gitignore
    * RX routines added
    * Finished adding clone and erase
    * Update _Config.h
    * Update Multiprotocol.ino
    * Ready for testing
    * Refactor to call init on cloned/normal change
    * Remove vscode files
    * remove TODO comment
    * remove unnecessary brackets
    ---------
2023-09-26 V761 telemetry
    A1 (4.4V -> 2.2V), RSSI equal to 100 means that all telem packets are received and TQLY indicates the number of lost telem packets.
2023-10-30 E129/C186: New flip flag for C129V2 on CH11
    [E129_cyrf6936.ino, Multiprotocol.h]
2023-12-18 Fix for DSM-Auto Bind on Lemon-RX Gen2 (#918)
    * #916 Fix for Auto-Bind on Lemon-RX Gen2
    Tested with multiple brands (Spektrum, OrangeRX, Lemon-Rx, Admiral). Even some old DSM 2 receivers.
    All work with "Auto" now. Just in case one needs a LONG bind sending period, when not using "Auto" works the same as before.
    * Use 1.8s for Bind Send
    Removed the short and long bind count logic.
    [DSM_cyrf6936.ino]
2023-12-22 Fix Traxxas for any RX
    [TRAXXAS_cyrf6936.ino]
2024-01-29 TRAXXAS TQ WIP
    It still won't work unless you have some luck. I still need to work on the RF frequency.
    [CYRF6936_SPI.ino, TRAXXAS_cyrf6936.ino]
2024-01-30 Kyosho updqte
    fixed crash
    [A7105_SPI.ino, Kyosho_a7105.ino, Multiprotocol.h]
2024-01-30 Update Bluefly_ccnrf.ino
    Exclude this protocol since it's not working
    [Bluefly_ccnrf.ino]
2024-01-31 Kyosho FHSS and Syncro
    Automatically binding a FHSS or a Syncro RX using FHSS
    [Kyosho_a7105.ino, Multi_Protos.ino, Multiprotocol.h, _Config.h]
2024-02-21 Pelikan SCX24 / HPI TF-41 reversed (#917)
    * Pelikan SCX24 / HPI TF-41 reversed
    * Save some flash and memory
    * Save more flash
    [Pelikan_a7105.ino]
2024-02-23 Automated build process updates (#950)
    * 4-in-1 air and surface builds
    * Disable serial and PPM-only builds for STM32 x-in-1
    * More air and surface builds
    * Fix 5-in-1 tests
    * T18 air, surface, and LBT builds
    * Remove CFlie from DIY 5-in-1 AIR
    * v4 artifact merging
    * Improve artifact merge
    * Fix merge
    * DIY 5-in-1 LBT
    * Tweak CI job name
    * Add T-Lite 5-in-1 LBT
    * CI job restructure
    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
2024-03-21 SGF22: Fix none working IDs
    [SGF22_nrf24l01.ino]
2024-03-26 DSM2_SFC try 1
    Servo refresh rate -> frame rate 16.5/11ms
2024-07-18 chore(ci): bump setup-arduino-ci version to remove nodejs warning (#995)
    * chore(ci): bump setup-arduino-ci version to remove nodejs warning
    Gets rid of the numerous "The following actions
    uses Node.js version which is deprecated and will
    be forced to run on node20" warnings
    * chore: bump arduino-cli ver
2024-07-24 Revert main.yml to use the old version of arduino_cli
2025-01-13 YuXiang E190 protocol
    Only 1 ID, bind might not work...
    [Multi_Protos.ino, Multiprotocol.h, Validate.h, Yuxiang_nrf24l01.ino, _Config.h]
2025-01-19 Add RF_SIM sub-protocol to SLT-protocol (#1061)
    * Added sub-protocol RF_SIM to the SLT protocol
    * fixed typo
    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
    [Multi_Protos.ino, Multiprotocol.h, SLT_ccnrf.ino, _Config.h]
2025-01-30 Improve DSM telemetry stability?
    [DSM_cyrf6936.ino]
2025-02-06 New JIABAILE/Gyro subprotocol
2025-02-21 KAMTOM new surface protocol
    Missing low batt telem
    [Kamtom_nrf24l01.ino, Multi_Protos.ino, Multiprotocol.h, Validate.h, XN297_EMU.ino, _Config.h]
2025-03-12 XK2 Gyro off
2025-03-13 MouldKg multi 6 ports brick support
2025-03-13 MouldKg renamed subprotocols
2025-03-14 MouldKg swap CH5 and CH6
    [MouldKg_nrf24l01.ino]
2025-03-20 MouldKg update
2025-05-10 Enable Telemetry on DumbRC receivers (#1111)
    Tested with X6FGv1.1, X6FP, X6DC(G)v1.1
    I also tested with multiple X6F receivers and some gave RSSI Telem and some gave nothing.
    2 of them had the same PCB as the X6FP and neither gave telemetry.
    I had a third with the same PCB with the X6FP which did give RSSI
    and of my two with an older PCB one gives RSSI telem and the other does not.
    Of the receivers I tried only one set packet_in[6] to match the TX packet[1] and it was the
    oldest receiver of the ones I own.
2026-07-14 KF606 LED
    Add LED channel for KF606 boards
2026-07-14 AFHDS2A: Fix for CROSSOVER-RX
    CROSSOVER-RX are sending end of telemetry data despite having sensors after...
    [AFHDS2A_a7105.ino, Telemetry.ino]
2026-07-14 Fix for DSM Clone
    * fix for DSM clone not working
    [DSM_cyrf6936.ino, Multiprotocol.h]
2026-07-14 Hontai/XK170: Optical flag
    CH11 enable/disable flow sensor for K270
2026-07-14 FX/BM26: new subprotocol
    Missing files
    [Multi_Protos.ino, Multiprotocol.h, _Config.h]
2026-07-29 RadioLink / DumboRC command packages for P Series (#1164)
    * [Codex assisted] RadioLink / DumboRC command packages bridge
    Pass "special" packages to and from the module
    Allows to replicate "Set Failsafe", "Set Gyro Settings" and "Set Gyro Endpoints" from DDF-350
    * RadioLink / DumboRC command packages TX / RX
    * RadioLink / DumboRC Helper script channel names
    Has max 10 channels
    Has no failsafe
    Older X series have gyro sense fixed to CH8, also can be used as regular channel
    * [Codex] DumboRC P Series settings script
    Add script that mimics interaction between DumboRC DDF-350 transmitter and P Series receivers
    * [Codex assisted] Split P series into separate subprotocol
    Split command excha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
    [DumboRC P Series.lua, MultiChannelsUpdater.lua, Multi_Protos.ino, Multiprotocol.h, Multiprotocol.ino, RadioLink_cc2500.ino, Telemetry.ino, _Config.h]
2026-08-03 REALACC/WLV8Tx : WLtoys Cars 284019-A and 284191
    Protocol: REALACC
    Sub Proto: WL_V8Tx
    Ch1: Steering
    CH2: Throttle
    CH3: GY TRIM (Rate)
    CH4: TH TRIM (Rate)
    CH5: Steering Trim
2026-08-18 Fix MoFly sub-protocol mode, rate and aux switch encoding (#1185)
    [XK_ccnrf.ino]
2026-08-20 Update XK_ccnrf.ino
    Fix bind
    [XK_ccnrf.ino]
2026-08-20 XK: fix bind and normal
    [Multiprotocol.h, XK_ccnrf.ino]
2026-08-21 MoFly: arm on aerobatic flags
    Aerobatic flags are sent only:
    - in 6G mode
    - must be released (-100%) before being used
2026-09-22 Revert DSM timing change
    [DSM_cyrf6936.ino, Multiprotocol.h]
2026-09-22 Fix to support DSM CH16 (#1179)
    [DSM_cyrf6936.ino]
2026-09-22 AFHS2A: 14/17 channels
    Switch based on RX number
